ErichStyger/mcuoneclipse/Examples/MCUXpresso/FRDM-KL25Z/FRDM-KL25Z_Blinky/part-support/docs/images/FRDM-KL25Z.gif

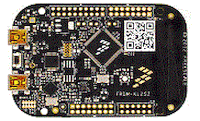
Examples/MCUXpresso/FRDM-KL25Z/FRDM-KL25Z_Blinky/part-support/docs/images/FRDM-KL25Z.gif
