ErichStyger/mcuoneclipse/Examples/MCUXpresso/FRDM-K64F/FRDM-K64F_McuOnEclipseLib/part-support/docs/images/FRDM-K64F-AGM01.gif

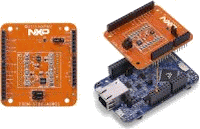
Examples/MCUXpresso/FRDM-K64F/FRDM-K64F_McuOnEclipseLib/part-support/docs/images/FRDM-K64F-AGM01.gif
