ErichStyger/mcuoneclipse/Examples/Readme.txt

This folder contains examples for different IDE's and boards.
The projects are organized by IDE's and boards.

- Eclipse: Stock Eclipse Kepler/Luna/Mars with GNU ARM Eclipse plugins
- CMSIS: CMSIS library project
- IAR: Projects with IAR Embedded Workbench
- KDS: Projects with Kinetis Design Studio V3.0.0
- CodeWarrior: contains CW for MCU 10.x projects
- Keil: Projects with Keil MDK
- RNet: Early version of a RNet (SMAC and nRF24L01+ stack), this has been moved to a Processor Expert component later
- FreeRTOS_Ports: various ports of FreeRTOS
