ErichStyger/mcuoneclipse/tinyK22/readme.txt

This folder contains information about the tinyK22 board.
This board has been developed by the Lucerne University of Applied Sciences and Arts and is use in labs and student projects.
The V1.3 version is now available from PCBWay.com

Links:
https://mcuoneclipse.com/2018/02/10/tinyk22-boards-arrived/
https://github.com/ErichStyger/mcuoneclipse/tree/master/Examples/KDS/tinyK22
https://github.com/ErichStyger/mcuoneclipse/tree/master/Examples/MCUXpresso/tinyK22
https://mcuoneclipse.com/tag/tinyk22/
https://www.pcbway.com/project/shareproject/TinyK22_V1_3.html
