ErichStyger/mcuoneclipse/tinyK20/readme.txt

readme.txt
----------
This folder contains files for the tinyK20 project.

See:
- http://mcuoneclipse.com/2015/05/17/tinyk20-open-source-arm-debuguniversal-board-first-prototypes/
- http://mcuoneclipse.com/2015/04/21/proof-of-concept-open-source-arm-swd-debug-and-general-purpose-board/
- http://mcuoneclipse.com/2015/06/17/tinyk20-new-board-with-micro-sd-card

A Kinetis Design Studio (v3.0.0) project for the tinyK20 is located on this GitHub Repository here:
\Examples\KDS\tinyK20
