ErichStyger/mcuoneclipse/Eagle/readme.txt

readme.txt
----------
This folder contains support/library files for the Eagle layout program.
Place these files inside the lbr subfolder of your Eagle installation.

Libraries:
- Freedom: FRDM-KL25Z footprint
- Bluetooth: HC-05 Bluetooth module (see http://mcuoneclipse.com/2013/02/14/bluetooth-with-the-freedom-board/)
