ErichStyger/mcuoneclipse/MCU-Link/PowerExt_lpc55s69/README.md

# LPC55S69 Power Extension Project

Project for the LPC55S69 (MCU-Link Pro) using CMake and Ninja.
The project is used in combination with a power/energy measurement board.
