ErichStyger/mcuoneclipse/conda/packages/README.md

# Package recipies using conda

This directory contains recipies to build an environement, including one with the tools provided by the NXP VS Code extension.

## Links
- https://github.com/memfault/conda-recipes/tree/master/gcc-arm-none-eabi
