ErichStyger/mcuoneclipse/MCU-Link/Pro/readme.txt

readme.txt
----------
This folder contains the design files for an enclosure for the the MCU-Link Pro.

- NXP_Logo: files for inlay, both .dxf and .svg format
- *.c2d: Carbide Create files for the CNC milling
- PMMA cover lasercut file
