ErichStyger/mcuoneclipse/Examples/VisualStudioCode/Readme.txt

This folder contains examples using Microsoft Visual Studio Code.

See following links for articles about it:
https://mcuoneclipse.com/2021/05/01/visual-studio-code-for-c-c-with-arm-cortex-m-part-1/
