ErichStyger/mcuoneclipse/tinyK22/V1.3/readme.txt

readme.txt
----------
See https://mcuoneclipse.com/2020/11/01/tinyk22-board-rev-1-3-released/

The tinyK22 board is now available from PCBWay:
https://www.pcbway.com/project/shareproject/TinyK22_V1_3.html
