ErichStyger/mcuoneclipse/LaserCutter/Inkscape/readme.txt

This folder contains drawings I use with a laser cutter.
See
- https://mcuoneclipse.com/2017/08/13/getting-control-over-a-50-watt-co2-laser-cutter-from-china/
