ErichStyger/mcuoneclipse/LaserCutter/Cohesion3D/readme.txt

This folder contains files for my laser cutter upgrade with the Cohesion3D board, see
https://mcuoneclipse.com/2018/04/15/upgrading-a-laser-cutter-with-cohesion3d-mini-and-lcd/
