ErichStyger/mcuoneclipse/Eagle/INTRO-Robot K22/readme.txt

This folder contains files for the INTRO K22 Robot, see:
- http://mcuoneclipse.com/2014/10/30/new-sumo-robot-assembled-and-looking-good/
- http://mcuoneclipse.com/2014/06/30/first-new-zumo-board-out-of-the-reflow-oven/
- http://mcuoneclipse.com/2014/07/26/zumo-robot-with-wifi-and-gps/

V2: Robot
- https://mcuoneclipse.com/2016/03/25/zumo-robot-with-magnetic-encoders/
