ErichStyger/mcuoneclipse/tinyK20/Board/readme.txt

tinyK20 project files for Eagle CAD.
Links:
- https://mcuoneclipse.com/category/boards/tinyk20/
- https://mcuoneclipse.com/2015/11/17/production-tinyk20-boards-arrived/
- https://mcuoneclipse.com/2015/06/17/tinyk20-new-board-with-micro-sd-card/
