ErichStyger/mcuoneclipse/Examples/IAR/readme.txt

This folder contains projects for IAR made with Processor Expert Driver Suite for Microcontrollers.
