ErichStyger/mcuoneclipse/Eagle/INTRO Robot QuadEncoder/readme.txt

See the following post:
http://mcuoneclipse.com/2014/03/14/new-encoder-pcbs-arrived/
http://mcuoneclipse.com/2014/03/08/processing-the-pololu-motor-shaft-encoders/
