ErichStyger/mcuoneclipse/Examples/Keil/readme.txt

This folder contains projects with Processor Expert Driver Suite and the Keil MDK tools.
