ErichStyger/mcuoneclipse/Eagle/INTRO-Robot/readme.txt

This folder contains files for the INTRO (Infotronic) Robot.
For more details, see

http://mcuoneclipse.com/2013/09/08/mini-sumo-robot-with-proximity-sensors/
http://mcuoneclipse.com/2013/01/31/the-freedom-zumo-robot/
http://mcuoneclipse.com/2013/02/08/zumo-line-following-with-frdm-kl25z/
http://mcuoneclipse.com/2013/03/28/maze-solving-frdm-kl25z-robot-goes-backward/
http://mcuoneclipse.com/2013/03/20/freedom-robot-solves-the-maze/
http://mcuoneclipse.com/2013/03/03/pololu-freedom-line-following-robot/
http://mcuoneclipse.com/2013/06/15/adding-quadrature-encoder-to-the-zumo-chassis/
