ErichStyger/mcuoneclipse/MCU-Link/Pro/rugged enclosure/readme.txt

Rugged enclosure for the NXP MCU-Link debug probe.

The FreeCAD model is a remix of https://www.printables.com/model/708803-parametric-rugged-box-freecad
