ErichStyger/mcuoneclipse/MCU-Link/McuLink Enclosure/LaserCut/readme.txt

Laser-cut enclosure for the NXP MCU-Link.
See https://mcuoneclipse.com/2023/04/11/different-laser-cut-enclosures-for-the-mcu-link/
