ErichStyger/mcuoneclipse/Examples/RaspberryPiPico/pico_Feather/README.md

# Adafruit RP2040 Feather
Project for the Raspberry Pi RP204, using the Adafruit Feather board:
- https://www.adafruit.com/product/4884
- https://learn.adafruit.com/adafruit-feather-rp2040

The project includes support for the Nordic nRF24L01+ transceiver.

## Build
Project has `Debug`, `Release` and `Test` targets, using CMake Presets. 

Configure:
```
cmake --list-presets
cmake --preset Debug
cmake --preset Release
cmake --preset Test
```

Build:
```
cmake --build --list-presets
cmake --build --preset app-debug
cmake --build --preset app-release
cmake --build --preset app-test
```

Test:
```
ctest --list-presets
ctest --test-dir build/Test -R Led_1
```

Worflow:
```
cmake --workflow --list-presets
```
