ErichStyger/mcuoneclipse/Examples/RaspberryPiPico/pico_HID/README.md

# PICO USB HID
Project for the Raspberry Pi Pico (W) with a composite USB HID device.
