ErichStyger/mcuoneclipse/Examples/MCUXpresso/LPC55S69-McuLink-Pro/readme.txt

Projects for the NXP LPC55S69 on the NXP MCU-Link Pro debug probe.
