ErichStyger/mcuoneclipse/Examples/RaspberryPiPico/pico_STHS34PF80TR/readme.txt

Project for the Raspberry Pi Pico using the STHS34PF80TR presence sensor.
