ErichStyger/mcuoneclipse/Examples/RaspberryPiPico/pico_LedCube/readme.txt

Project for the Raspberry Pi Pico (W or non-W) controlling 8x8x8(2) RGB LED Cube with PIO and DMA.

Article about this project:
https://mcuoneclipse.com/2023/04/02/rp2040-with-pio-and-dma-to-address-ws2812b-leds/

KiCAD files:
https://github.com/ErichStyger/mcuoneclipse/tree/master/KiCAD/Projects/PicoWS2812B
