ErichStyger/mcuoneclipse/Examples/MCUXpresso/FRDM-MCXN236/readme.txt

Projects with the MCUXPresso IDE for the NXP FRDM-MCXN236 board.
