ErichStyger/mcuoneclipse/Examples/MCUXpresso/FRDM-MCXA153/readme.txt

Projects with the MCUXPresso IDE for the NXP FRDM-MCXA153 board.
