ErichStyger/mcuoneclipse/Examples/MCUXpresso/FRDM-MCXN947/readme.txt

Projects with the MCUXPresso IDE for the NXP FRDM-MCXN947 board.
