ErichStyger/mcuoneclipse/Examples/MCUXpresso/i.MX RT685-EVK/readme.txt

projects for the NXP i.MX RT685-EVK board.
https://www.nxp.com/design/design-center/development-boards-and-designs/i-mx-evaluation-and-development-boards/i-mx-rt600-evaluation-kit:MIMXRT685-EVK
