ErichStyger/mcuoneclipse/Examples/RaspberryPiPico/pico_ST7735/readme.txt

Project for the Raspberry Pi Pico (W or non-W) using a display with the Sitronics ST7735 controller (SPI)

Files needed: (besides this readme.txt)

./pico_sdk_import.cmake
./CMakeLists.txt
./src folder
./McuLib folder
./.gitignore

To configure (cd to project root directory where this readme is located):
run 'cmake init.bat'
Import the project as 'existing make file project' into Eclipse: File > Import > C/C++ > Existing Code as Makefile Project (give it a name, use this folder as code location, specify GNU Autotools toolchain, then build it

or: simply run 'make' to build it
