ErichStyger/mcuoneclipse/Examples/RaspberryPiPico/pico_Raspy/readme.txt

Project for the Raspberry Pi Pico as interface to a Raspberry Pi (buttons, LEDs and UART).
It does pull-up the nav switch buttons, as the Pi is not able to enable internal pull-ups.
It offers as well a console interface to the Linux using the UART.

Files needed: (besides this readme.txt)

./pico_sdk_import.cmake
./CMakeLists.txt
./src folder
./McuLib folder
./.gitignore

To configure (cd to project root directory where this readme is located):
run 'cmake init.bat'
Import the project as 'existing make file project' into Eclipse: File > Import > C/C++ > Existing Code as Makefile Project (give it a name, use this folder as code location, specify GNU Autotools toolchain, then build it

or: simply run 'make' to build it
