ErichStyger/mcuoneclipse/KiCAD/Projects/PicoLink/readme.txt

KiCAD and enclosure design files for a RP2040 based debug probe (PicoLink).
See https://github.com/ErichStyger/mcuoneclipse/tree/master/KiCAD/Projects/PicoLink
