ErichStyger/mcuoneclipse/KiCAD/Projects/PicoWS2812B/readme.txt

Board to use the Pico (RP2040) MCU with up to 8 WS2812B LED stripes.

Links:
https://mcuoneclipse.com/2023/04/02/rp2040-with-pio-and-dma-to-address-ws2812b-leds/
https://github.com/ErichStyger/mcuoneclipse/tree/master/Examples/RaspberryPiPico/pico_LedCube
