ErichStyger/mcuoneclipse/Examples/RaspberryPiPico/pico-w-webserver/readme.txt

readme.txt
----------

Web server example for the Raspberry Pi Pico.

See:
- https://github.com/krzmaz/pico-w-webserver-example/tree/main/src
- https://krzmaz.com/2022-08-15-creating-a-web-server-on-raspberry-pi-pico-w-using-pico-sdk-and-lwip/#HTML
