ErichStyger/mcuoneclipse/Examples/MCUXpresso/FRDM-KE02Z/readme.txt

Projects with the MCUXPresso IDE for the NXP FRDM-KE02Z board.
