ErichStyger/mcuoneclipse/Examples/MCUXpresso/LPC55S16-EVK/readme.txt

Projects for the NXP LPC55S16 EVK board.
