ErichStyger/mcuoneclipse/OpenSDA/OpenSDA V2.2/mbed DAPLink v244/readme.txt

See https://mcuoneclipse.com/2017/10/29/adding-a-delay-to-the-arm-daplink-bootloader/
