ErichStyger/mcuoneclipse/Examples/MCUXpresso/Dark Theme/readme.txt

readme.txt
----------
See https://mcuoneclipse.com/2020/10/20/tweaking-mcuxpresso-ide-black-theme/
This directory contains the Eclipse preferences with tweaked black theme.

Import the file with File > Import > General > Preferences
and then restart the IDE.

Do not forget to switch the preferences to the MCUXpresso Dark Theme using
Window > Preferences > General > Appearance >
