ErichStyger/mcuoneclipse/LaserCutter/Inkscape/RaspySteampunkBox/readme.txt

Design files for a Raspberry Pi Steampunk enclosure.
Details:
https://mcuoneclipse.com/2019/06/01/steampunk-lasercut-enclosure-for-raspberry-pi/

Gears by https://www.facebook.com/profile.php?id=526508601, file 'SteampunkBox.lbrn in https://www.facebook.com/groups/635194396883619/files/
