ErichStyger/mcuoneclipse/Examples/MCUXpresso/LPC55S69-EVK/readme.txt

This folder contains projects for the NXP LPC55S69-EVK, see
https://mcuoneclipse.com/2019/04/22/first-steps-with-the-lpc55s69-evk-dual-core-arm-cortex-m33-with-trustzone/
