ErichStyger/mcuoneclipse/Examples/S32DS/S32K144_SSD1306/readme.txt

readme.txt
----------
This project demonstrates using the SSD1306 LCD with I2C.

NOTE:
The subfolder 'SDK' in the project has been removed as the NXP SDK for S32 does not grant redistribution rights.
So you have to add that folder from your SDK locally.
