ErichStyger/mcuoneclipse/Examples/MCUXpresso/tinyK22/readme.txt

Projects with the MCUXPresso IDE for the tinyK22 board which uses the same MCU as on the NXP FRDM-K22F board.
