ErichStyger/mcuoneclipse/Examples/MCUXpresso/i.MX RT1052 Embedded Artists/readme.txt

This folder contains projects with MCUXpresso IDE and for the Embedded Artists i.MX RT1052 OEM board:

http://embeddedartists.com/products/oem/imxrt1052_oem.php
