ErichStyger/mcuoneclipse/Examples/KDS/TWR-K60F120M/readme.txt

This folder contains projects for the TWR-K60F120M board
