ErichStyger/mcuoneclipse/Examples/KDS/tinyK22/readme.txt

This folder contains projects for the tinyK22 board using the NXP Kinetis Design Studio.
See
- https://mcuoneclipse.com/2018/02/10/tinyk22-boards-arrived/
- https://mcuoneclipse.com/tag/tinyk22/
