ErichStyger/mcuoneclipse/Examples/KDS/Teensy_3.5/readme.txt

This folder contains projects for the Teensy 3.5 with KDS,
see 
https://mcuoneclipse.com/2017/04/29/modifying-the-teensy-3-5-and-3-6-for-arm-swd-debugging/
