ErichStyger/mcuoneclipse/Examples/MCUXpresso/FRDM-K22F/readme.txt

Projects with the MCUXPresso IDE for the NXP FRDM-K22F board.
