ErichStyger/mcuoneclipse/Examples/MCUXpresso/FRDM-KW41Z/readme.txt

Projects with the MCUXPresso IDE for the NXP FRDM-KW41Z board.
