ErichStyger/mcuoneclipse/Examples/MCUXpresso/FRDM-KL25Z/readme.txt

Projects with the MCUXPresso IDE for the NXP FRDM-KL25Z board.
