ErichStyger/mcuoneclipse/Examples/KDS/FRDM-KL03Z/readme.txt

readme.txt
----------
This folder contains projects for the FRDM-KL03Z board and the Kinetis Design Studio (KDS).
