ErichStyger/mcuoneclipse/Examples/KDS/FRDM-KE02Z/readme.txt

readme.txt
----------
This folder contains projects for the FRDM-KE02Z board and the Kinetis Design Studio (KDS).
