ErichStyger/mcuoneclipse/Examples/MCUXpresso/FRDM-K64F/readme.txt

Projects with the MCUXPresso IDE for the NXP FRDM-K64F board.
