ErichStyger/mcuoneclipse/Examples/MCUXpresso/LPC800-DIP/readme.txt

Projects with the MCUXPresso IDE for the NXP LPC800-DIP board.
