ErichStyger/mcuoneclipse/Examples/KDS/FRDM-KL28Z/readme.txt

readme.txt
----------
This folder contains projects for the FRDM-KL28Z board and the Kinetis Design Studio (KDS).
