ErichStyger/mcuoneclipse/Examples/KDS/Kwikstik_K40/readme.txt

This folder contains projects using Kinetis Design Studio V3.2.0 for the NXP/Freescale Kwikstik board.
