ErichStyger/mcuoneclipse/Examples/CodeWarrior/MCF51JM128_BadgeBoard/readme.txt

readme.txt
----------
Projects for the MCF51JM128 Flexis Badgeboard
http://www.nxp.com/products/microcontrollers-and-processors/more-processors/coldfire-plus-coldfire-32-bit-mcus/coldfire-microcontrollers-mcus/coldfire-v1-microcontro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
