ErichStyger/mcuoneclipse/Examples/KDS/FRDM-KW40Z/readme.txt

readme.txt
----------
This folder contains projects for the FRDM-KW40Z board and the Kinetis Design Studio (KDS).
