ErichStyger/mcuoneclipse/Examples/KDS/TWR-KL43Z48M/readme.txt

readme.txt
----------
This folder contains projects for the TWR-KL43Z48M board and the Kinetis Design Studio.
