ErichStyger/mcuoneclipse/Examples/KDS/TWR-K40D100M/readme.txt

readme.txt
----------
This folder contains projects for the TWR-K40D100M board and the Kinetis Design Studio (KDS):
http://www.nxp.com/products/software-and-tools/hardware-development-tools/tower-development-boards/mcu-and-processor-modules/kinetis-modules/kinetis-k40-100-mhz-low-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
