ErichStyger/mcuoneclipse/Examples/KDS/TWR-KV58F220M/readme.txt

readme.txt
----------
This folder contains projects for the TWR-KV58F220M board and the Kinetis Design Studio.
