ErichStyger/mcuoneclipse/Examples/KDS/FRDM-KL27Z/readme.txt

readme.txt
----------
This folder contains projects for the FRDM-KL27Z board and the Kinetis Design Studio (KDS).
