ErichStyger/mcuoneclipse/Examples/KDS/FRDM-KL43Z/readme.txt

readme.txt
----------
This folder contains projects for the FRDM-KL43Z board and the Kinetis Design Studio (KDS).
