ErichStyger/mcuoneclipse/Examples/KDS/Teensy_3.1/readme.txt

readme.txt
----------
This folder contains projects for the Teensy 3.1 board and the Kinetis Design Studio (KDS).
