ErichStyger/mcuoneclipse/Examples/KDS/FRDM-KL02Z/readme.txt

readme.txt
----------
This folder contains projects for the FRDM-KL02Z board and the Kinetis Design Studio (KDS).
