ErichStyger/mcuoneclipse/Examples/KDS/TWR-K20D72M/readme.txt

readme.txt
----------
This folder contains projects for the TWR-K20D72M board and the Kinetis Design Studio (KDS).
