ErichStyger/mcuoneclipse/Examples/KDS/FRDM-K22F/readme.txt

readme.txt
----------
This folder contains projects for the FRDM-K22F board and the Kinetis Design Studio.
