ErichStyger/mcuoneclipse/Examples/Eclipse/FRDM-K64F/readme.txt

This folder contains Eclipse (Kepler) projects for the Freescale FRDM-K64F board.
