ErichStyger/mcuoneclipse/Examples/KDS/FRDM-KL46Z/readme.txt

readme.txt
----------
This folder contains projects for the FRDM-KL46Z board and the Kinetis Design Studio (KDS).
