ErichStyger/mcuoneclipse/Examples/KDS/FRDM-K20D50M/readme.txt

readme.txt
----------
This folder contains projects for the FRDM-K20D50M board and the Kinetis Design Studio.
