ErichStyger/mcuoneclipse/Examples/KDS/FRDM-KL26Z/readme.txt

readme.txt
----------
This folder contains projects for the FRDM-KL26Z board and the Kinetis Design Studio (KDS).
