ErichStyger/mcuoneclipse/Examples/CodeWarrior/FRDM-K20D50M/readme.txt

This folder contains projects for the Freescale FRDM-K20D50M board.
