ErichStyger/mcuoneclipse/Examples/CodeWarrior/FRDM-K64F/readme.txt

This folder contains CodeWarrior projects for the Freescale FRDM-K64F board.
