ErichStyger/mcuoneclipse/Examples/KDS/FRDM-KL05Z/readme.txt

readme.txt
----------
This folder contains projects for the FRDM-KL05Z board and the Kinetis Design Studio (KDS).
