ErichStyger/mcuoneclipse/Examples/KDS/FRDM-KL25Z/readme.txt

readme.txt
----------
This folder contains projects for the FRDM-KL25Z board and the Kinetis Design Studio (KDS).
