ErichStyger/mcuoneclipse/Examples/Eclipse/TWR-K64F120M/readme.txt

This folder contains projects for the TWR-K64F120M board:
http://www.freescale.com/webapp/sps/site/prod_summary.jsp?code=TWR-K64F120M&tid=m32TWR
