ErichStyger/mcuoneclipse/Examples/CodeWarrior/TWR-K21F120M/readme.txt

This folder contains projects for the TWR-K21F120M board:
http://www.freescale.com/webapp/sps/site/prod_summary.jsp?code=TWR-K21F120M&tid=m32TWR
