ErichStyger/mcuoneclipse/Examples/FRDM-KL46Z/FRDM-KL46Z_Demo/readme.txt

readme.txt
==========
Project using the devices on the FRDM-KL46Z board.

See:
http://mcuoneclipse.com/2013/08/06/a-new-freedom-board-frdm-kl46z/

Licensing:
----------
The 'LCD' subfolder has a separate license. These files are from the
http://www.freescale.com/webapp/sps/site/prod_summary.jsp?code=FRDM-KL46Z&fpsp=1&tab=Design_Tools_Tab#
KL46_SC (FRDM-KL46Z and TWR-KL46Z48M Sample Code Package) from www.freescale.com/freedom

The folder is taken from
kinetis_kl46_sc\kinetis_kl46_sc_rev2\klxx-sc-baremetal\src\projects\FRDMKL46_Demo\lcd
and slightly modified, and contains the KL46_SC license file.
