ErichStyger/mcuoneclipse/Examples/CodeWarrior/FRDM-KL26Z/Readme.txt

This folder contains projects for the FRDM-KL26Z (Freedom) board.
