ErichStyger/mcuoneclipse/Examples/CodeWarrior/FRDM-KE02Z/readme.txt

This folder contains projects for the FRDM-KE02Z board.
See
http://mcuoneclipse.com/2013/08/19/a-5v-freedom-board-frdm-ke02z/
