ErichStyger/mcuoneclipse/Examples/CodeWarrior/TWR-56F8400/readme.txt

This folder contains projects for the TWR-56F8400 board:
http://www.freescale.com/webapp/sps/site/prod_summary.jsp?code=TWR-56F8400&tid=m32TWR
