ErichStyger/mcuoneclipse/Examples/CodeWarrior/TWR-K60F120M/readme.txt

This folder contains projects for the TWR-K60F120M board:
http://www.freescale.com/webapp/sps/site/prod_summary.jsp?code=TWR-K60F120M&tid=m32TWR
