ErichStyger/mcuoneclipse/Examples/CodeWarrior/DEMO9S08LL16/readme.txt

This directory contains projects for the S08DEMOLL16 board:

https://www.freescale.com/webapp/sps/site/prod_summary.jsp?code=DEMO9S08LL16
