ErichStyger/mcuoneclipse/Examples/CodeWarrior/DEMOJM/Readme.txt

This folder contains example projects for the Freescale DEMOJM board.
The DEMOJM board can use different CPU modules, as the S08JM16, S08JM60 or MCF51JM128.
