ErichStyger/mcuoneclipse/Examples/CodeWarrior/FRDM-KL02Z/Readme.txt

This folder contains projects for the FRDM-KL02Z (Freedom) board.
