ErichStyger/mcuoneclipse/Examples/CodeWarrior/TWR-KL46Z48M/Readme.txt

This folder contains projects for the TWR-KL46Z48M board.
