ErichStyger/mcuoneclipse/Examples/CodeWarrior/TWR-CN128/Readme.txt

This folder contains projects for the TWR-CN128 (MCF51CN128) board.
