ErichStyger/mcuoneclipse/Examples/CodeWarrior/TWR-52259/Readme.txt

This folder contains projects for the TWR-MCF52259 board.
