ErichStyger/mcuoneclipse/Examples/CodeWarrior/TWR-LCD/Readme.txt

This folder contains projects for the TWR-LCD board.
