ErichStyger/mcuoneclipse/Examples/CodeWarrior/TWR-LL64/Readme.txt

This folder contains projects for the TWR-S08LL64 board.
As the TWR-S08LH64 is very similar, the projects can be used for the LH64 board as well.
