ErichStyger/mcuoneclipse/Examples/CodeWarrior/TWR-MCF51MM256/Readme.txt

This folder contains projects for the TWR-MCF51MM256 board.
