ErichStyger/mcuoneclipse/Examples/KDS/TWR-K70F120M/Readme.txt

This folder contains projects for the TWR-K70F120M board.
