ErichStyger/mcuoneclipse/Examples/CodeWarrior/FRDM-KL05Z/Readme.txt

This folder contains projects for the FRDM-KL05Z (Freedom) board.
