ErichStyger/mcuoneclipse/Examples/CodeWarrior/TRW-K60N512/Readme.txt

This folder contains projects for the TWR-K60N512 board:
http://www.freescale.com/webapp/sps/site/prod_summary.jsp?code=TWR-K60N512&tid=m32TWR
