ErichStyger/mcuoneclipse/Examples/CodeWarrior/FRDM-KL25Z/Readme.txt

This folder contains projects for the FRDM-KL25Z (Freedom) board.
