ErichStyger/mcuoneclipse/Examples/Rust/LPC55S69-EVK_Rust_Blinky/NOTES.md

# Notes about Rust for LPC55S69

## Standalone Embassy Project
Starting a new project: https://embassy.dev/book/index.html#_starting_a_new_project

## VS Code
Install extension: https://marketplace.visualstudio.com/items?itemName=rust-lang.rust-analyzer (rust-lang.rust-analyzer)
https://code.visualstudio.com/docs/languages/rust

The official VS Code extension for probe-rs:
https://github.com/probe-rs/vscode

Extension: probe-rs.probe-rs-debugger
