ErichStyger/mcuoneclipse/Examples/MCUXpresso/FRDM-K22F/FRDM-K22F_FreeRTOS/McuLib/unity/link.md

See 
https://github.com/ThrowTheSwitch/Unity/tree/master
about the Unity framework.
