ErichStyger/mcuoneclipse/tinyK22/RevA/tinyK22_Pinout.pdf

# TinyK22

## Rev A

U4: 3.3V Regulator
Mouser: 579-TC1262-3.3VDBTR

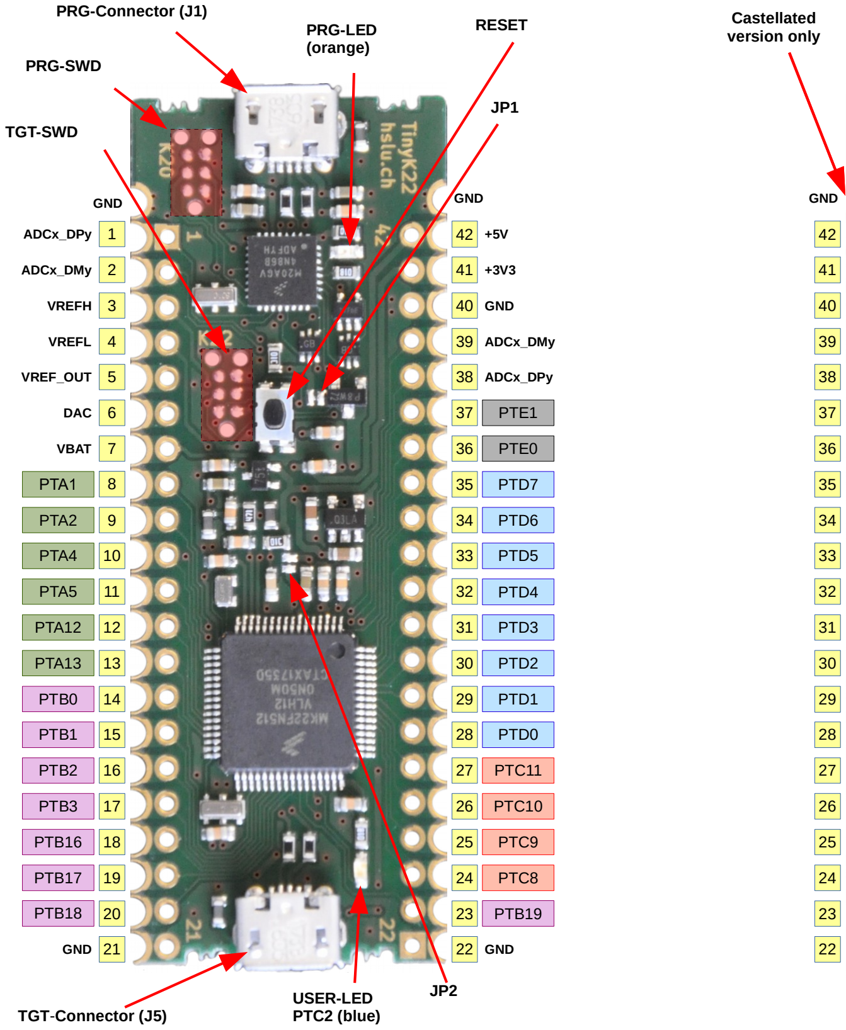
[picture p3: figure]
TGT-Connector (J5); PRG-Connector (J1); USER-LED PTC2 (blue); PRG-LED (orange); RESET; PRG-SWD; PTB16; PTB18; PTA2; PTA4; PTA12; PTA5; PTA13; PTA1; PTB0; PTB2; PTB1; PTB3; PTB17; PTB19; PTC11; PTC10; PTC8; PTC9; PTD7; PTD6; PTD5; PTD3; PTD4; PTD2; PTD1; PTD0; PTE1; PTE0; GND; VBAT; DAC; VREF_OUT; VREFL; VREFH; ADCx_DMy; ADCx_DPy; TGT-SWD; Castellated version only
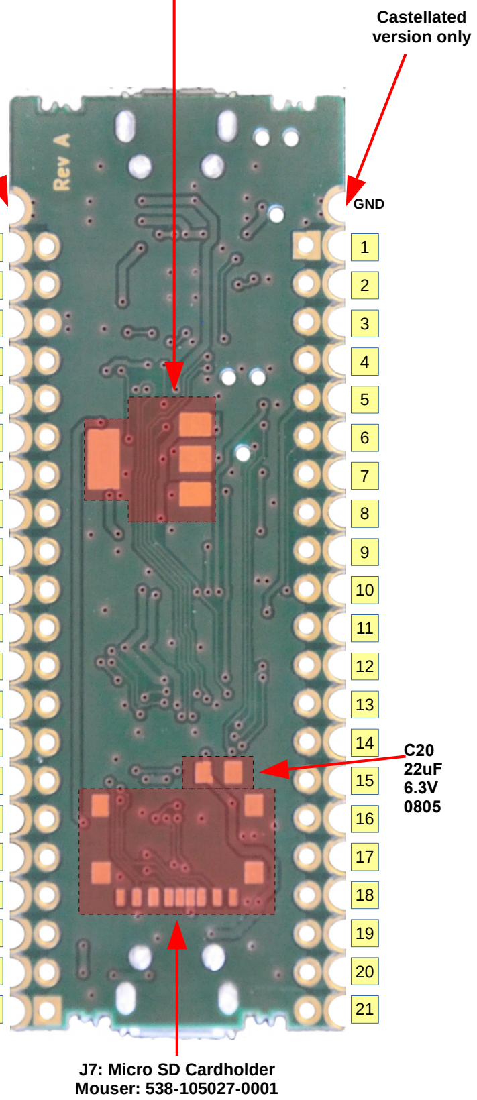
[picture p4: figure]
J7: Micro SD Cardholder Mouser: 538-105027-0001; GND; Castellated version only

UART
FTM
I2C
SPI
ADC
CMP

R:RxD, T:TxD
0..7: Channel
C:SCL, D:SDA
C:Clock, O:SOUT, I:SIN
4..13:Channel
2..3: Input | UART to Programmer:
| UART1 or LPUART0
| (PTC3 & PTC4)
PTA1 | R | 6
PTA2 | T | 7
PTA4 | | 1
PTA5 | | 2
PTA12 | | | 0
PTA13 | | | 1
PTB0 | | | 0 | C | 8 | 8

PTE0

PTE1

PTD4 | | 4
PTD5 | | 5 | C | 6b
PTD6 | R | 6 | O | 7b
PTD7 | T | 7 | I
PTC9 | 5 | | 5b | 3
PTC10 | 6 | C | 6b
PTC11 | 7 | D | 7b
PTD0 | 0

PTB19

PTB2 | | 3 | C | | 12 | 12
PTB3 | | 0 | D | | 13 | 13
PTB16 | R | | | O
PTB17 | T | | | I

PTB1

PTB18

PTD3

PTD1

PTC8

PTD2

LPUART0
UART0

UART1

UART2
FTM0

FTM1

FTM2

FTM3
I2C0

FTM0
I2C1

SPI0

SPI1

ADC0

ADC1

CMP0

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
20190107

FTM0

C

C

D

I/O
