ErichStyger/mcuoneclipse/tinyK22/V1.3/Flyer_V1_3.pdf

# TinyK22

V 1.3

Optional:

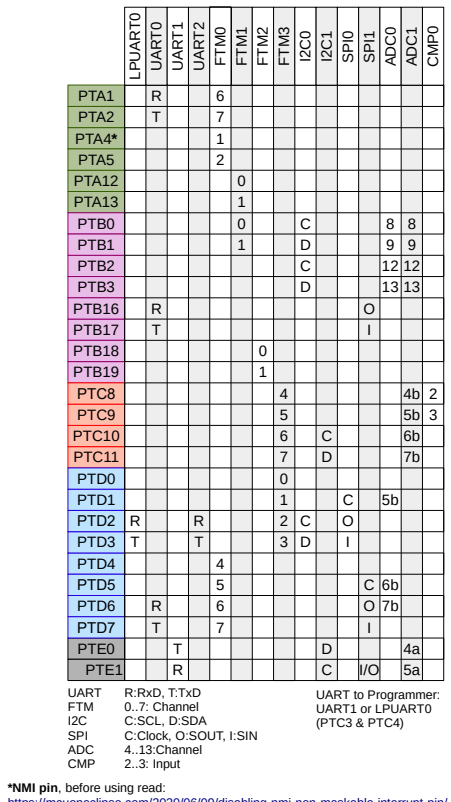
[picture p5: figure]
UART FTM I2C SPI ADC CMP; R:RxD, T:TxD 0..7: Channel C:SCL, D:SDA C:Clock, O:SOUT, I:SIN 4..13:Channel 2..3: Input; UART to Programmer: UART1 or LPUART0 (PTC3 & PTC4); PTA1; PTA2; PTA4*; PTA12; PTA5; PTA13; PTE0 PTE1; PTD4; PTC11; PTC10; PTC9; PTB19; PTB0; PTB2; PTB1; PTB3; PTB17; PTB16; PTB18; PTD6; PTD3; PTD1; PTD0; PTC8; PTD7; PTD5; PTD2; LPUART0; UART0; UART1; UART2; FTM0; FTM1; FTM2; FTM3; SPI0; SPI1; ADC0; ADC1; CMP0; *NMI pin, before using read:
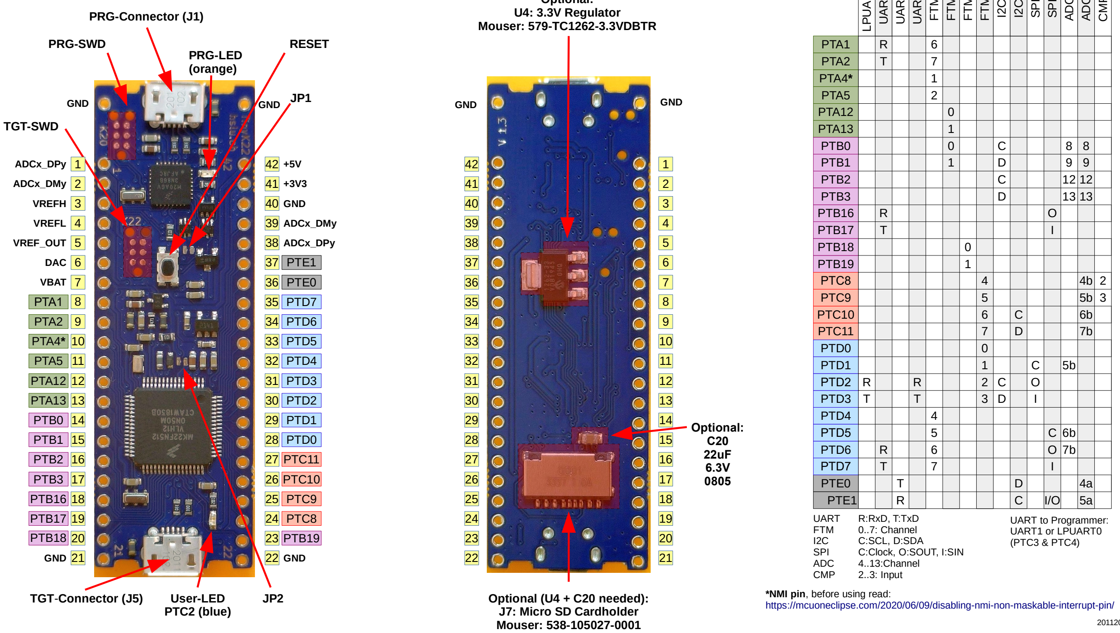
[picture p6: figure]
TGT-Connector (J5); PRG-Connector (J1); User-LED PTC2 (blue); PRG-LED (orange); RESET; PRG-SWD; PTB16; PTB18; PTA2; PTA4*; PTA12; PTA5; PTA13; PTA1; PTB0; PTB2; PTB1; PTB3; PTB17; PTB19; PTC11; PTC10; PTC8; PTC9; PTD7; PTD6; PTD5; PTD3; PTD4; PTD2; PTD1; PTD0; PTE1; PTE0; GND; VBAT; DAC; VREF_OUT; VREFL; VREFH; ADCx_DMy; ADCx_DPy; TGT-SWD; Optional: C20 22uF 6.3V 0805; Optional (U4 + C20 needed): J7: Micro SD Cardholder Mouser: 538-105027-0001; U4: 3.3V Regulator Mouser: 579-TC1262-3.3VDBTR; https://mcuoneclipse.com/2020/06/09/disabling-nmi-non-maskable-interrupt-pin/

20112020

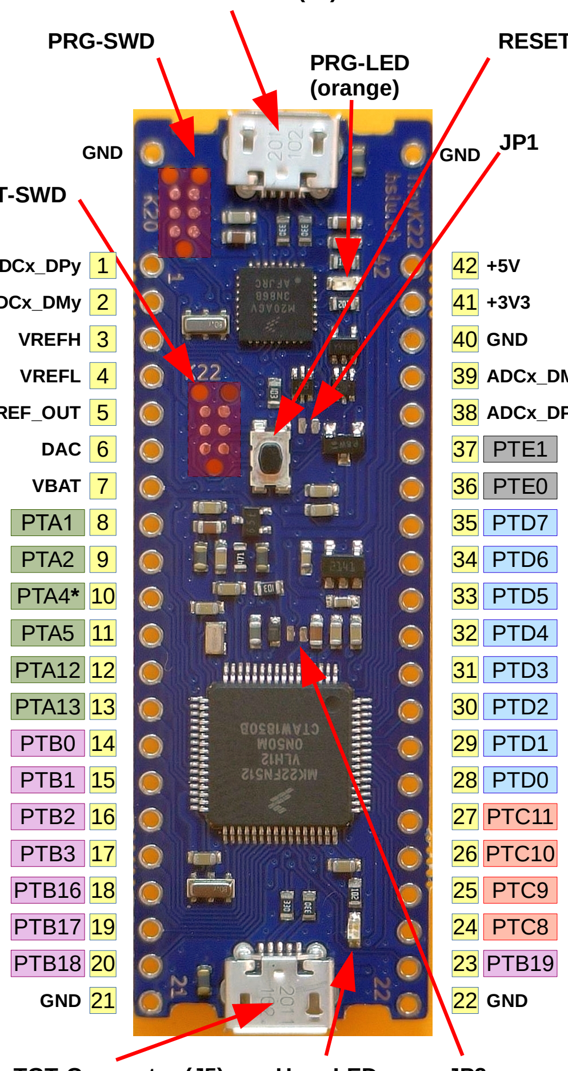
[picture p7: figure]

# TinyK22

V 1.3

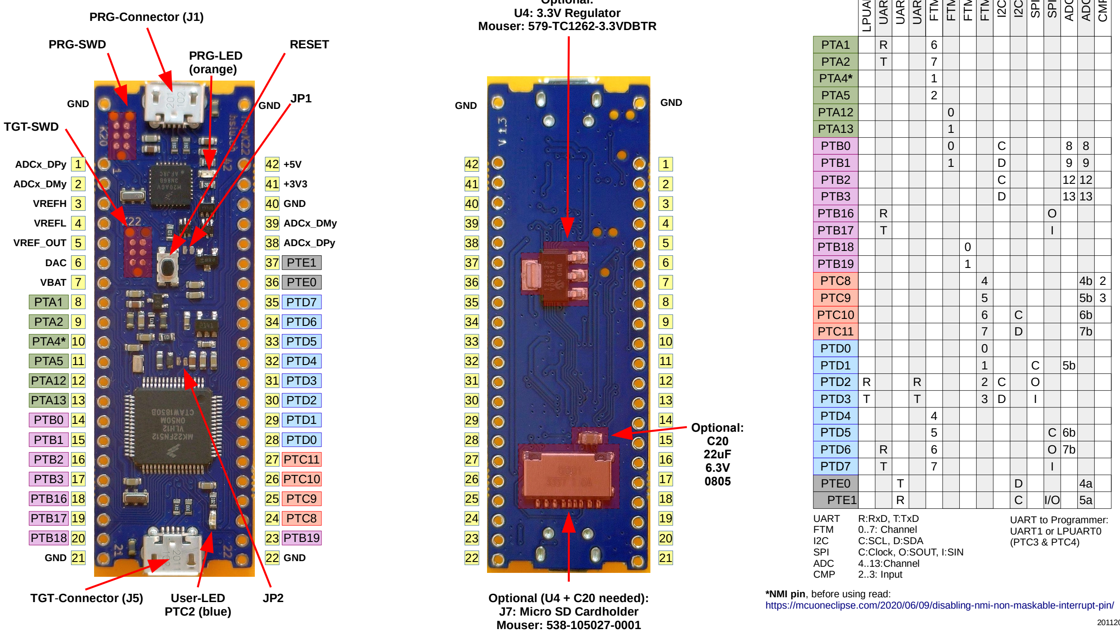
[picture p8: figure]
TGT-Connector (J5); PRG-Connector (J1); User-LED PTC2 (blue); PRG-LED (orange); RESET; PRG-SWD; PTB16; PTB18; PTA2; PTA4*; PTA12; PTA5; PTA13; PTA1; PTB0; PTB2; PTB1; PTB3; PTB17; PTB19; PTC11; PTC10; PTC8; PTC9; PTD7; PTD6; PTD5; PTD3; PTD4; PTD2; PTD1; PTD0; PTE1; PTE0; GND; VBAT; DAC; VREF_OUT; VREFL; VREFH; ADCx_DMy; ADCx_DPy; TGT-SWD; Optional: C20 22uF 6.3V 0805; Optional (U4 + C20 needed): J7: Micro SD Cardholder Mouser: 538-105027-0001; U4: 3.3V Regulator Mouser: 579-TC1262-3.3VDBTR; *NMI pin, before using read: https://mcuoneclipse.com/2020/06/09/disabling-nmi-non-maskable-interrupt-pin/
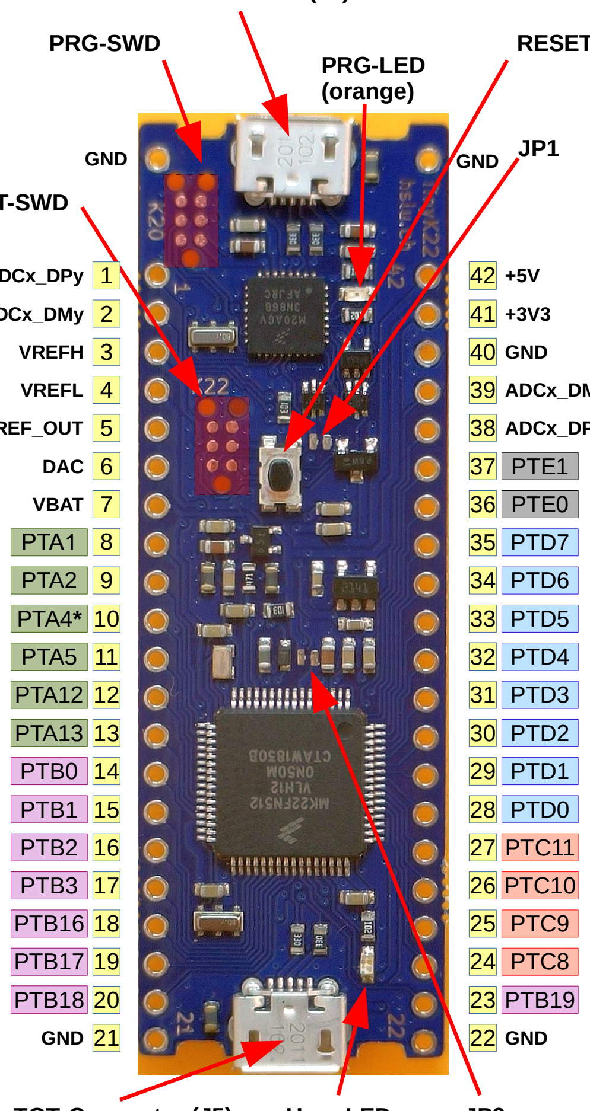
[picture p9: figure]

Optional:

UART
FTM
I2C
SPI
ADC
CMP

R:RxD, T:TxD
0..7: Channel
C:SCL, D:SDA
C:Clock, O:SOUT, I:SIN
4..13:Channel
2..3: Input

UART to Programmer:
UART1 or LPUART0
(PTC3 & PTC4)
PTA1 | R | 6
PTA2 | T | 7
PTA4* | | 1
PTA5 | | 2
PTA12 | | | 0
PTA13 | | | 1
PTB0 | | | 0 | C | 8 | 8

PTE0
PTE1

PTD4

PTC9 | 5 | | 5b | 3
PTC10 | 6 | C | 6b
PTC11 | 7 | D | 7b
PTD0 | 0

PTB19

PTB2

PTB1

PTB3 | | D | | 13 | 13
PTB16 | R | | O
PTB17 | T | | I
PTB18

PTD3

PTD1

PTC8

PTD5 | | 5 | C | 6b
PTD6 | R | 6 | O | 7b
PTD7 | T | 7 | I

PTD2

LPUART0
UART0

UART1

UART2
FTM0
FTM1

FTM2

FTM3
I2C0

FTM0
I2C1

SPI0

SPI1

ADC0

ADC1

CMP0

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
20112020

FTM0

C
D

I/O

12

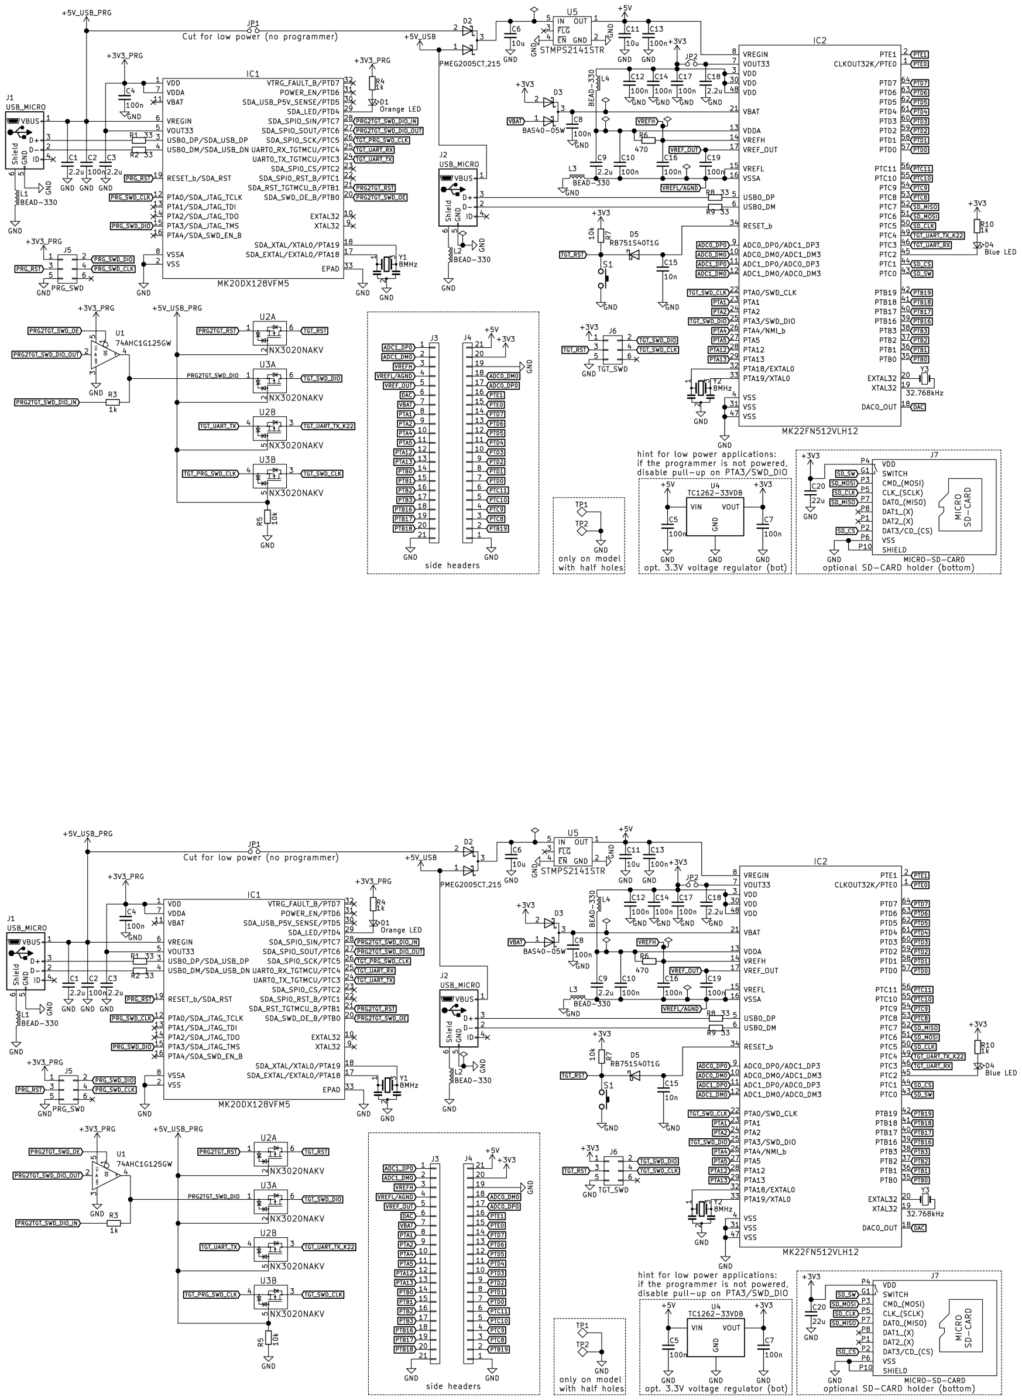
[picture p10: page 2]
