ErichStyger/mcuoneclipse/tinyK20/Board/tinyK20Flyer.pdf

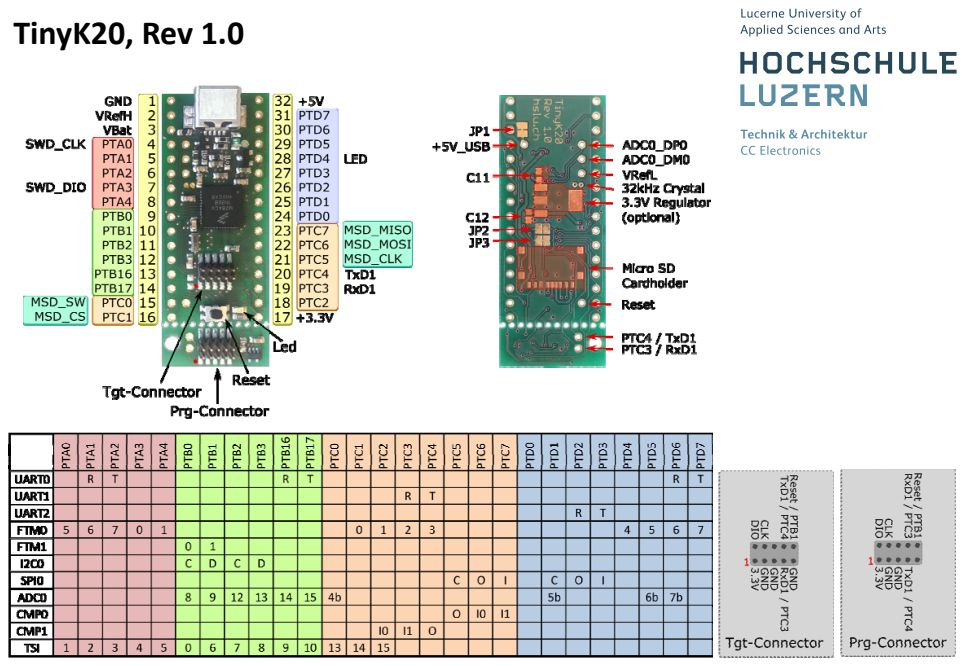
[picture p11: page 1]
TinyK20, Rev 1.0

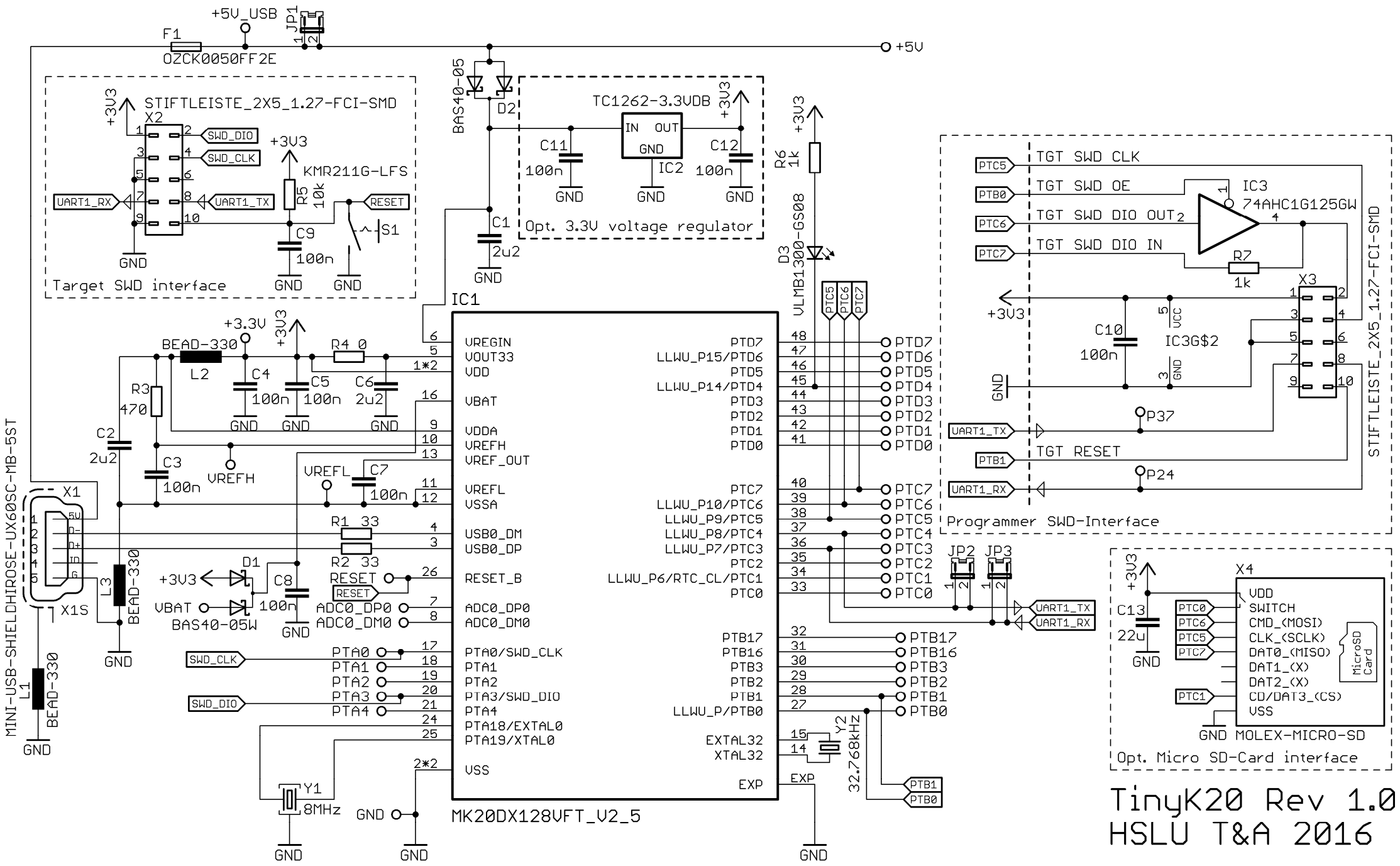
[picture p12: page 2]
