ErichStyger/mcuoneclipse/tinyK22/V1.3/Fab/TinyK22_FAB_BOT.pdf

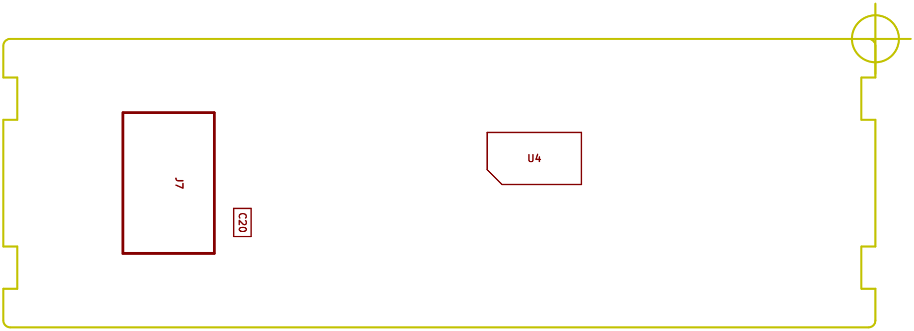
[picture p13: figure]
