ErichStyger/mcuoneclipse/Examples/MCUXpresso/i.MX RT1064_EVK/MIMXRT1064_SSD1963/SSD1963.pdf

## Teilnehmendenliste mit Foto und Adresse

Leitung | Erich Styger
Datum | 18.02.2019 - 01.06.2019

## Intern/Vertraulich - Keine Abgabe an Drittpersonen erlaubt

Dauer | Donnerstag, 08:30 - 12:00 + Freitag, 08:30 - 12:00
Anzahl Anmeldungen 10
Anlass | Advanced Programming FS 1901 (TA.BA_APROG.F1901)
Name / ID | Foto | Adresse / Ort | E-Mail / Telefon | Weitere Informationen

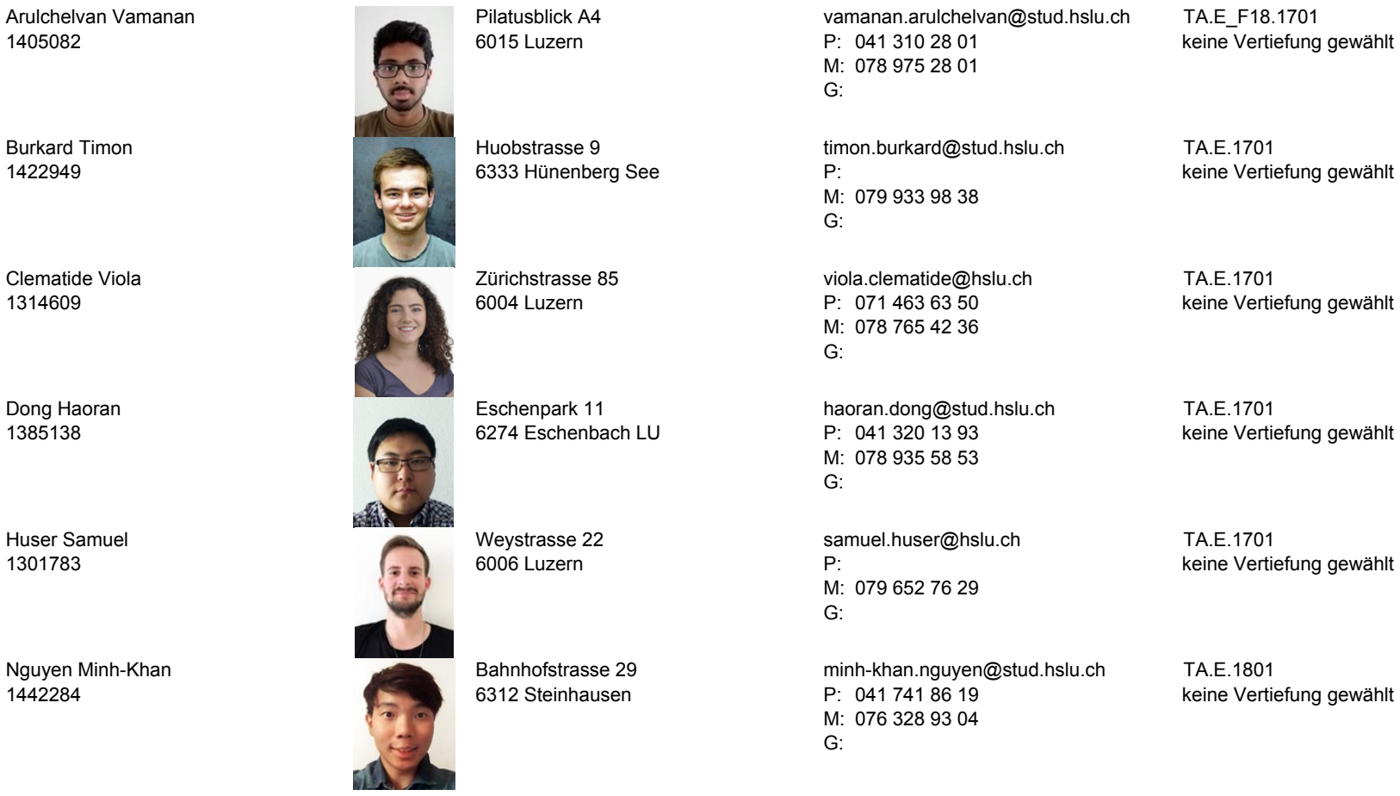
[picture p14: figure]
Pilatusblick A4 6015 Luzern; Arulchelvan Vamanan; vamanan.arulchelvan@stud.hslu.ch; keine Vertiefung gewählt; Huobstrasse 9 6333 Hünenberg See; Burkard Timon; timon.burkard@stud.hslu.ch; Zürichstrasse 85 6004 Luzern; Clematide Viola; viola.clematide@hslu.ch; Eschenpark 11 6274 Eschenbach LU; Dong Haoran; haoran.dong@stud.hslu.ch; Weystrasse 22 6006 Luzern; Huser Samuel; samuel.huser@hslu.ch; Bahnhofstrasse 29 6312 Steinhausen; Nguyen Minh-Khan; minh-khan.nguyen@stud.hslu.ch

28.01.2019 13:35:51 | 1/2

Stiegenackerstrasse 9
5634 Merenschwand
Schär Matthias | matthias.schaer@stud.hslu.ch | TA.E.1701
| P: M: G: 056 664 73 63 079 890 94 37
1412842 | keine Vertiefung gewählt

Hertiring 14
6440 Brunnen
Tschümperlin Mike | mike.tschuemperlin@stud.hslu.ch | TA.E_F18.1701
| P: M: G: 041 822 04 85 076 816 75 65
1410594 | keine Vertiefung gewählt

Apfelbaumstrasse 39
8050 Zürich
Urhan Özcan | oezcan.urhan@stud.hslu.ch | TA.E_F18.1701
| P: M: G: 076 322 10 71
1419855 | keine Vertiefung gewählt

Krauerhusstrasse 10 b
6206 Neuenkirch
Wey Ramon | ramon.wey@stud.hslu.ch | TA.E.1701
| P: M: G: 041 467 31 14 079 452 86 27
1371753 | keine Vertiefung gewählt

## Teilnehmendenliste mit Foto und Adresse

Leitung | Erich Styger
Datum | 18.02.2019 - 01.06.2019

## Intern/Vertraulich - Keine Abgabe an Drittpersonen erlaubt

Dauer | Donnerstag, 08:30 - 12:00 + Freitag, 08:30 - 12:00
Anzahl Anmeldungen 10
Anlass | Advanced Programming FS 1901 (TA.BA_APROG.F1901)
Name / ID | Foto | Adresse / Ort | E-Mail / Telefon | Weitere Informationen
28.01.2019 13:35:51 | 2/2
