ErichStyger/mcuoneclipse/Altium/FRDM-KL25_Footprint.png

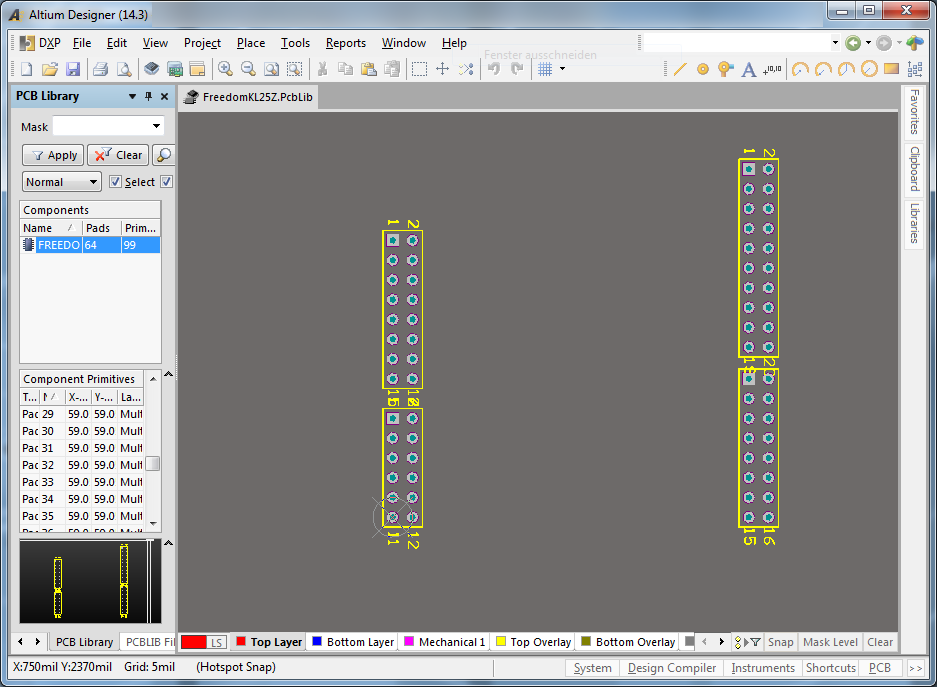
Altium/FRDM-KL25_Footprint.png
