ErichStyger/mcuoneclipse/Altium/FRDM-KL25_Schema.png

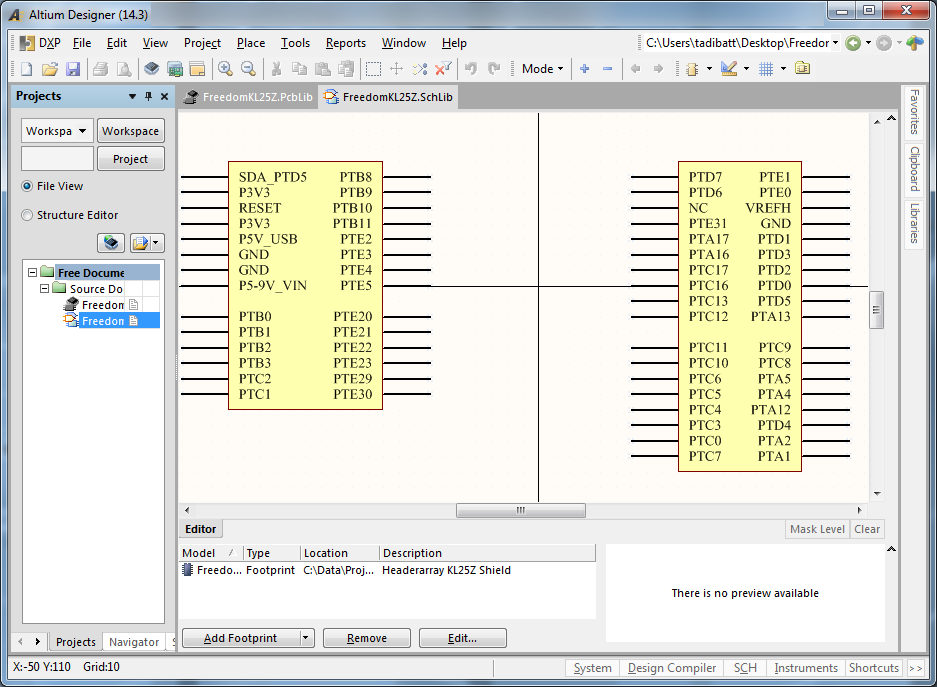
Altium/FRDM-KL25_Schema.png
