ErichStyger/mcuoneclipse/Examples/MCUXpresso/FRDM-K22F/FRDM-K22F_FatFS_SD_Card/part-support/docs/images/FRDM-K22F-AGMP03.gif

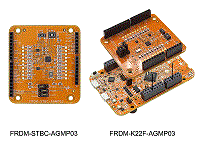
Examples/MCUXpresso/FRDM-K22F/FRDM-K22F_FatFS_SD_Card/part-support/docs/images/FRDM-K22F-AGMP03.gif
