ErichStyger/mcuoneclipse/Examples/MCUXpresso/i.MX RT1052 Seeed Arch Mix/MIMXRT1052_Seeed_ArchMix_BlinkyFLASH/part-support/docs/images/EVKB-IMXRT1050-OM13790HOST.gif

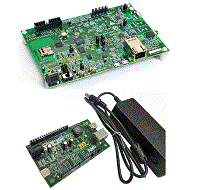
Examples/MCUXpresso/i.MX RT1052 Seeed Arch Mix/MIMXRT1052_Seeed_ArchMix_BlinkyFLASH/part-support/docs/images/EVKB-IMXRT1050-OM13790HOST.gif
