ErichStyger/mcuoneclipse/Examples/MCUXpresso/i.MX RT1064_EVK/MIMXRT1064_Blinky_FLASH/part-support/docs/images/EVK-MIMXRT1064-OM13588.gif

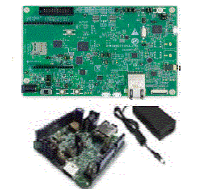
Examples/MCUXpresso/i.MX RT1064_EVK/MIMXRT1064_Blinky_FLASH/part-support/docs/images/EVK-MIMXRT1064-OM13588.gif
