ErichStyger/mcuoneclipse/Examples/MCUXpresso/i.MX RT1064_EVK/MIMXRT1064_ThreadX_Demo/part-support/MIR/marketing_data/1.0/boards/images/5-EVK-MIMXRT1064.gif

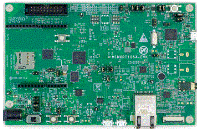
Examples/MCUXpresso/i.MX RT1064_EVK/MIMXRT1064_ThreadX_Demo/part-support/MIR/marketing_data/1.0/boards/images/5-EVK-MIMXRT1064.gif
