ErichStyger/mcuoneclipse/Examples/MCUXpresso/i.MX RT1064_EVK/MIMXRT1064_ThreadX_Demo/part-support/MIR/marketing_data/1.0/kits/images/169-EVK-MIMXRT1064-AGM01.gif

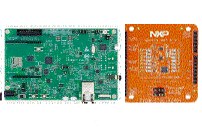
Examples/MCUXpresso/i.MX RT1064_EVK/MIMXRT1064_ThreadX_Demo/part-support/MIR/marketing_data/1.0/kits/images/169-EVK-MIMXRT1064-AGM01.gif
