ErichStyger/mcuoneclipse/Examples/MCUXpresso/K22FX512/K22FX512xxx12_McuLib/part-support/docs/images/TWR-K21F120M.gif

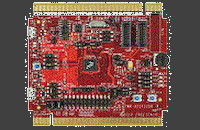
Examples/MCUXpresso/K22FX512/K22FX512xxx12_McuLib/part-support/docs/images/TWR-K21F120M.gif
