ErichStyger/mcuoneclipse/Examples/MCUXpresso/LPC55S16-EVK/LPC55S16_Semihosting/part-support/boards/lpcxpresso55s16_agm01/lpcxpresso55s16_agm01.png

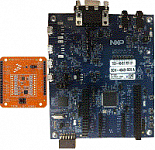
Examples/MCUXpresso/LPC55S16-EVK/LPC55S16_Semihosting/part-support/boards/lpcxpresso55s16_agm01/lpcxpresso55s16_agm01.png
