ErichStyger/mcuoneclipse/Examples/MCUXpresso/LPC55S69-EVK/LPC55S69_AdafruitLCD/Datasheets/adafruit_products_tftshieldv2.png

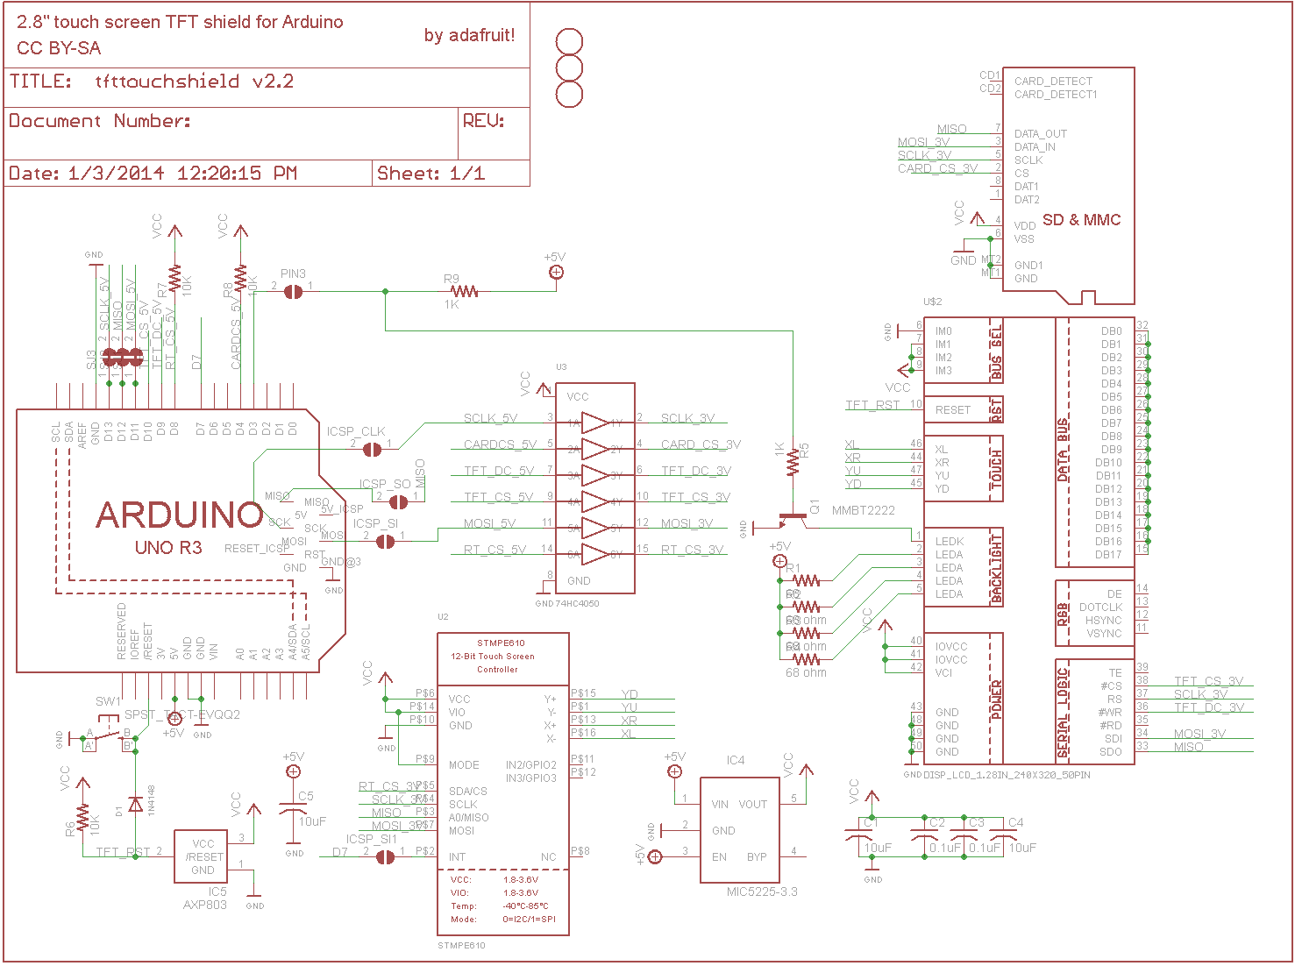
Examples/MCUXpresso/LPC55S69-EVK/LPC55S69_AdafruitLCD/Datasheets/adafruit_products_tftshieldv2.png
