ErichStyger/mcuoneclipse/Examples/MCUXpresso/LPC55S69-EVK/LPC55S69_AdafruitLCD/part-support/docs/images/LPCXpresso55S69.gif

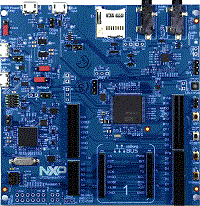
Examples/MCUXpresso/LPC55S69-EVK/LPC55S69_AdafruitLCD/part-support/docs/images/LPCXpresso55S69.gif
