ErichStyger/mcuoneclipse/Examples/MCUXpresso/LPC55S69-EVK/LPC55S69_McuLib_Blinky/part-support/boards/lpcxpresso55s69/lpcxpresso55s69.png

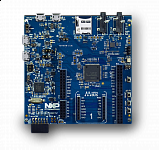
Examples/MCUXpresso/LPC55S69-EVK/LPC55S69_McuLib_Blinky/part-support/boards/lpcxpresso55s69/lpcxpresso55s69.png
