ErichStyger/mcuoneclipse/Examples/MCUXpresso/LPC55S69-EVK/LPC55S69_McuLib_Blinky/part-support/boards/lpcxpresso55s69_agm01/lpcxpresso55s69_agm01.png

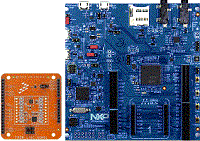
Examples/MCUXpresso/LPC55S69-EVK/LPC55S69_McuLib_Blinky/part-support/boards/lpcxpresso55s69_agm01/lpcxpresso55s69_agm01.png
