ErichStyger/mcuoneclipse/Examples/MCUXpresso/LPC845-BRK/LPC845-WorldClock/KiCad/WorldClock_V1.0/StepperClock_Bottom.png

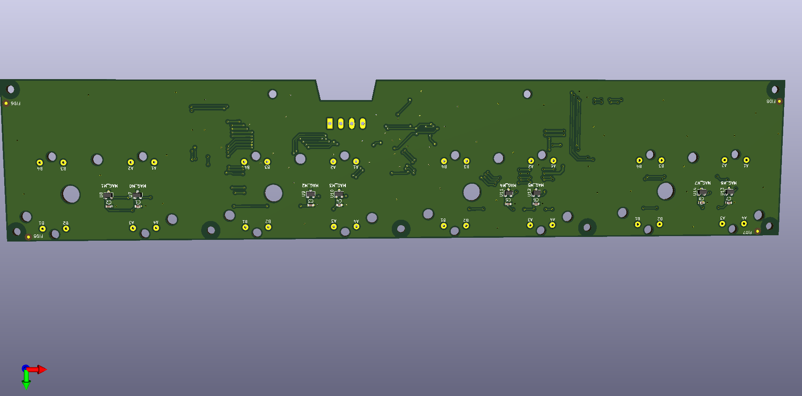
Examples/MCUXpresso/LPC845-BRK/LPC845-WorldClock/KiCad/WorldClock_V1.0/StepperClock_Bottom.png
