ErichStyger/mcuoneclipse/Examples/MCUXpresso/tinyK22/tinyK22_HanoverFlipDot/part-support/docs/images/TWR-K22F120M.gif

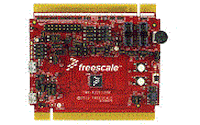
Examples/MCUXpresso/tinyK22/tinyK22_HanoverFlipDot/part-support/docs/images/TWR-K22F120M.gif
