ErichStyger/mcuoneclipse/tinyK22/V1.3/PCBWay Board.PNG

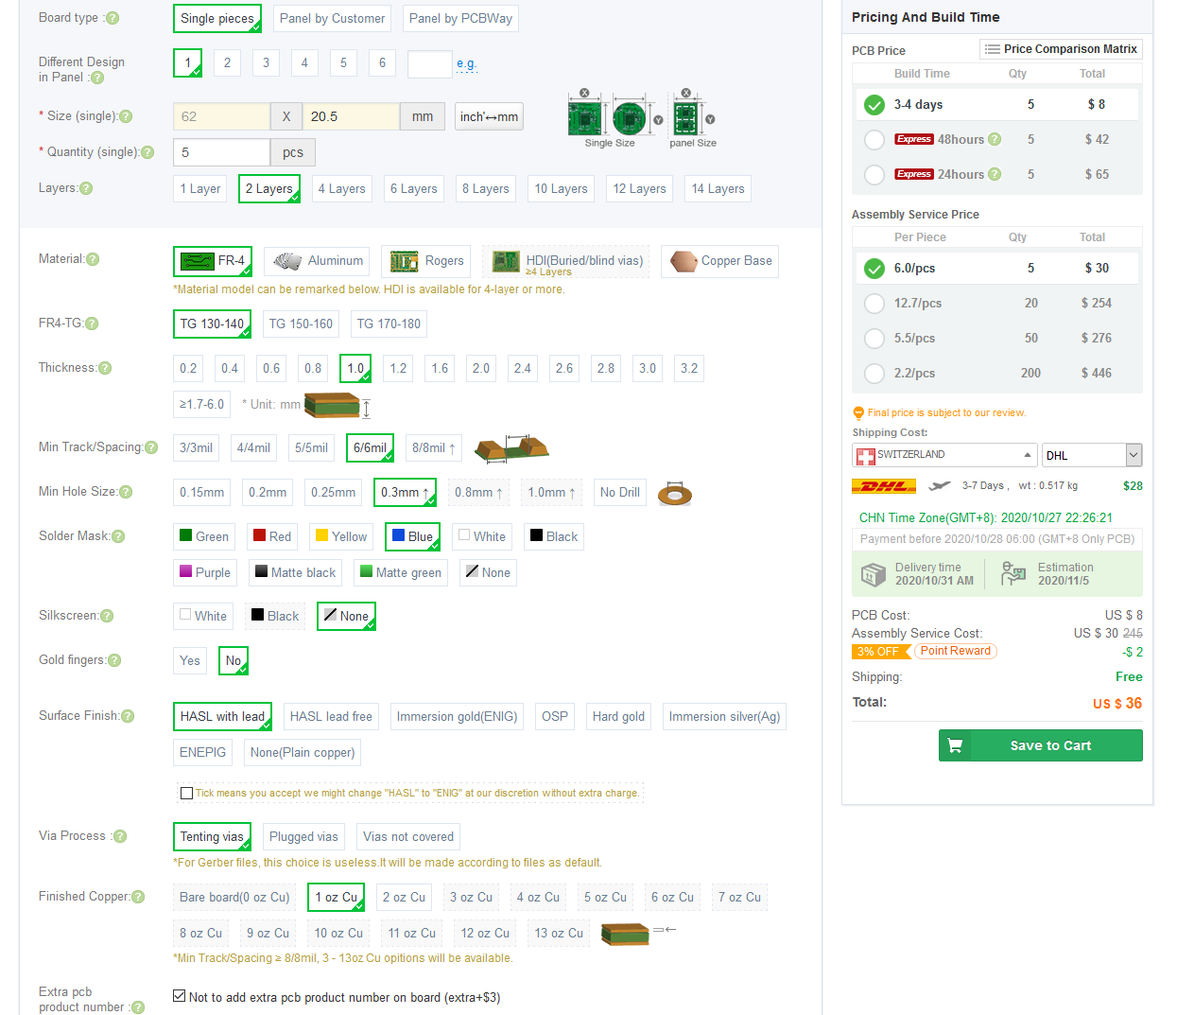
tinyK22/V1.3/PCBWay Board.PNG
