ErichStyger/mcuoneclipse/Examples/CodeWarrior/FRDM-KL25Z/FRDM-KL25Z_RNet_Component/readme.txt

readme.txt
----------
This is a demo program on the FRDM-KL25Z with the RNet stack using the nRF24L01+ transceiver.
It implements a shell with stdio redirection over the air.

See:
http://mcuoneclipse.com/2014/03/23/rnet-stack-as-component-nrf24l01-with-software-spi/
