ErichStyger/mcuoneclipse/tinyK20/Board/Material.txt

For BOM (Bill-Of-Material), see tinyK20_BOM.txt.
The SD card socket is the same as on the FRDM-K22F board (see http://mcuoneclipse.com/2015/10/07/added-micro-sd-card-socket-to-frdm-k22f/).
