ErichStyger/mcuoneclipse/KiCAD/Projects/PicoLink/V0.1/bom/BOM.xlsx

Item | Qty | Reference(s) | Value | LibPart | Footprint | Datasheet | MFR | MFR# | digikey# | mouser# | Price 1 (CHF) | Price Total
1 | 2 | C2, C9 | 2u2 | Device:C_Small | Capacitor_SMD:C_0603_1608Metric | ~ | Yageo | CC0402MRX5R6BB225 |  | 603-CC402MRX5R6BB225 | 0.02 | 0.04
2 | 10 | C3, C4, C5, C6, C7, C8, C10, C11, C12, C13 | 0.1u | Device:C_Small | Capacitor_SMD:C_0603_1608Metric | ~ | Yageo | CC0603KRX7R8BB104 |  | 603-CC603KRX7R8BB104 | 0.013 | 0.13
3 | 2 | C14, C15 | 22u | Device:C_Small | McuOnEclipse:C_0805 | ~ | Samsung | CC0603KRX7R8BB104 |  | 603-CC603KRX7R8BB104 | 0.013 | 0.026
4 | 1 | D1 | red | Device:LED_Small | McuOnEclipse:LED_0603 | ~ | Vishay Semiconductors | VLMS1300-GS08 |  | 78-VLMS1300-GS08 | 0.096 | 0.096
5 | 1 | D5 | green | Device:LED_Small | McuOnEclipse:LED_0603 | ~ | Vishay Semiconductors | VLMTG1300-GS08 |  | 78-VLMTG1300-GS08 | 0.191 | 0.191
6 | 3 | H4, H5, H6 | MountingHole | Mechanical:MountingHole | MountingHole:MountingHole_2.7mm_M2.5 | ~ |  |  |  |  |  | 0
7 | 1 | J1 | USB_C_Receptacle_GCT_USB4110-GF-A | McuOnEclipse:USB_C_Receptacle_GCT_USB4110-GF-A | McuOnEclipse:USB_C_Receptacle_GCT_USB4110-GF-A | ${KICAD_USER_DATASHEET_DIR}\connector\USB-C-Buchse - GCT USB4110.pdf | GCT | USB4110-GF-A |  | 640-USB4110-GF-A | 0.86 | 0.86
8 | 2 | J5, J6 | Conn_01x03 | Connector_Generic:Conn_01x03 | Connector_PinHeader_2.54mm:PinHeader_1x03_P2.54mm_Vertical | ~ |  |  |  | 571-3-826629-6 | 0.235 | 0.47
9 | 2 | R2, R5 | 5k1 | Device:R_Small | Resistor_SMD:R_0603_1608Metric | ~ | Yageo | RC0603JR-075K1L |  | 603-RC0603JR-075K1L | 0.008 | 0.016
10 | 2 | R3, R4 | 27 | Device:R_Small | Resistor_SMD:R_0603_1608Metric | ~ | Yageo | RC0603JR-0727RL |  | 603-RC0603JR-0727RL | 0.006 | 0.012
11 | 3 | R7, R8, R18 | 2k2 | Device:R_Small | Resistor_SMD:R_0603_1608Metric | ~ | Yageo | RC0603JR-072K2L |  | 603-RC0603JR-072K2L | 0.006 | 0.018
12 | 5 | R9, R10, R11, R15, R16 | 100 | Device:R_Small | Resistor_SMD:R_0603_1608Metric | ~ | Yageo | RC0075JR-07100RL |  | 603-RC0075JR-07100RL | 0.006 | 0.03
13 | 1 | RP2040 | RP2040 | McuOnEclipse:RP2040 | McuOnEclipse:QFN-56-1EP_7x7mm_P0.4mm_EP3.2x3.2mm | ${KICAD_USER_DATASHEET_DIR}\ic\RP2040.pdf | Raspberry Pi | RPI Chip RP2040-7-500 |  | 358-RP2040CHIP-7-500 | 0.931 | 0.931
14 | 1 | SW1 | 434123025826_BTN | Switch:SW_MEC_5E | McuOnEclipse:434123025826_BTN | http://www.apem.com/int/index.php?controller=attachment&id_attachment=1371 | Würth Elektronik | 434123025826 | 732-13662-1-ND |  | 0.45 | 0.45
15 | 1 | U1 | W25Q16JV | McuOnEclipse:W25Q16JV | McuOnEclipse:USON_2x3x0.6mm | ${KICAD_USER_DATASHEET_DIR}/ic/Flash SPI - W25Q16JV.pdf | Winbond | 434123025826 |  | 454-W25Q16JVUXIQTR | 0.439 | 0.439
16 | 1 | U3 | SWD_JTAG_10pin | McuOnEclipse:SWD_JTAG_10pin | McuOnEclipse:SWD_Pin_Header_Straight_2x05_Pitch1.27mm_SMD |  | Amphenol FCI | 20021121-00010C4LF |  | 649-202112100010C4LF | 0.694 | 0.694
17 | 1 | U5 | AP2112K-3.3 | Regulator_Linear:AP2112K-3.3 | McuOnEclipse:IC-SOT25 | https://www.diodes.com/assets/Datasheets/AP2112.pdf | Diodes Incorporated | AP2112K-3.3TRG1 |  | 621-AP2112K-3.3TRG1 | 0.173 | 0.173
18 | 1 | Y1 | CSTNE12M0GH5L000R0 | McuOnEclipse:CSTNE12M0GH5L000R0 | McuOnEclipse:Resonator_SMD_Murata_CSTxExxV-3Pin_3.0x1.1mm | ${KICAD_USER_DATASHEET_DIR}\discrete\Resonator - CSTNE12M0GH5L000R0.pdf | muRata | CSTNE12M0GH5L000R0 |  | 81-CSTNE12M0GH5L000R | 0.201 | 0.201
