ErichStyger/mcuoneclipse/Examples/MCUXpresso/LPC845-BRK/LPC845-BRK_StepperClock/3D/StepperClock BOM.xlsx

BOM (Bill of Material) for Stepper Clock with LPC845
Item | Amount | Costs ($) | Notes | Link
LPC845-BRK | 1 | 5.00 |  | https://www.mouser.ch/ProductDetail/NXP-Semiconductors/LPC845-BRK
RTC DS3231 breakout | 1 | 1.10 |  | https://www.aliexpress.com/item/2037934408.html
ULN2003 + 28BYJ-48 5V | 2 | 3.75 | 5 for $9.40 | https://www.aliexpress.com/item/32869969097.html
Bearings 10x15x4 | 2 | 0.60 | 10 for $2.85 | https://www.aliexpress.com/item/32852057465.html
Neodynium Magnets 5x2 mm | 2 | 0.05 | 100 for $4.27 | https://www.aliexpress.com/item/32867770710.html
Diodes Incorporated AH3572 | 2 | 0.70 | 10 for $3.50 | https://www.mouser.ch/ProductDetail/Diodes-Incorporated/AH3572-P-B
Duont Wires (female-female), 20 cm | 1 | 0.90 | 120pc 20 cm or any bulk offer | https://www.aliexpress.com/item/32990585262.html
Lasercutter with Plywood 4mm or PMMA | 1 | 0.50 | Plywood sheet A3
3D Printer with PLA (white or any other color) | 1 | 0.20 | 1 kg PLA: around $20
Wood screws 2x10mm | 8 | 0.05 | Used for distance holders
M3 Nuts and Bolts (3 mmx10mm) | 12 | 1.00 | different style or size possible
Duont Wires (female-female), 20 cm | 16 | 1.00 | 20pin x 20 cm | https://www.aliexpress.com/item/32987024879.html
Total amount |  | 14.85
