ErichStyger/mcuoneclipse/Examples/MCUXpresso/LPC845-BRK/LPC845-WorldClock/KiCad/WorldClock_V1.0/BOM_PCBWay.xlsx

Sheet: Sheet1
 |  |  | StepperClock V1.0 BOM (Bill of Materials) for https://www.pcbway.com/project/shareproject/_Meta_Clock__Board_V1_0.html
Item # | *Ref Des | *Qty | Manufacturer | *Mfg Part # | Description / Value | *Package | Type | Your Instructions / Notes | Source
1 | C12, C15 | 2 | Panasonic | EEE-1CA220SR | 22uF/16V Electrolyt | 5x5.5x5.4mm | SMD |  | Mouser: 667-EEE-1CA220SR
2 | C1, C2, C3, C4, C5, C6, C7, C8, C10, C11, C13, C14, C16, C20 | 14 | ATC | 0603X7R104JT1AT | 100nF Ceramic, 25V | 0603 | SMD | Can be any ceramic 25V | Mouser: 581-0603X7R104JT1AT
3 | C17, C19 | 2 | Kemet | C0603C105K4PAC7411 | 1uF Ceramic, 16V | 0603 | SMD | Can be any ceramic 25V | Mouser: 80-C0603C105K4PLR
4 | C21 | 1 | Kemet | C0603X103J4HACTU | 10nF Ceramic, 16V | 0603 | SMD | Can be any ceramic 25V | Mouser: 80-C0603X103J4HACTU
5 | C18 | 1 | AVX | F9H1C106KAA | 10uF/16V Tantalum | 1206 | SMD | Can be any Tantalum >12V | Mouser: 581-F9H1C106KAA
6 | R1, R3, R4, R5 | 4 | Yageo | RT0603WRE0710KL | 10k Ohm 0.5% | 0603 | SMD | Can be any generic resistor 0.5% | Mouser: 603-RT0603WRE0710KL
7 | R2 | 1 | Yageo | RT0603DRE07120RL | 120 Ohm 0.5% | 0603 | SMD | Can be any generic resistor 0.5% | Mouser: 603-RT0603DRE07120RL
8 | R6 | 1 | Yageo | RT0603FRE072K2L | 2.2k Ohm 0.5% | 0603 | SMD | Can be any generic resistor 0.5% | Mouser: 603-RT0603FRE072K2L
9 | D1 | 1 | Vishay Semiconductors | VLMB1300-GS08 | Blue LED | 0603 | SMD |  | Mouser: 78-VLMB1300-GS08
10 | U18 | 1 | NXP Semiconductors | LPC845M301JBD48E | LPC845M301JBD48E | LPQF-48 | SMD |  | Mouser: 771-LPC845M301JBD48E
11 | U15 | 1 | PhoenixContact | 1803293 | 4pole Pin Header 3.81 mm 90 degree | THT | thru-hole | Do not populate (DNP) | Distrelec: 148-41-252
12 | U19 | 1 | Amphenol FCI | 20021121-00010C4LF | 2x5 1.27mm pin header (SWD Debug) | 1.27mmx1.27mm | SMD |  | Mouser: 649-202112100010C4LF
13 | U16 | 1 | Texas Instruments | SN65HVD72DR | SN65HVD72 |  | SMD |  | Mouser: 595-SN65HVD72DR
14 | U5, U6 | 2 | Switec | X12.017 | M-S Quad Driver X12.017 | DIP-28 | SMD |  | Chip-IC Store: https://www.aliexpress.com/item/32596665175.html?spm=a2g0s.9042311.0.0.22e44c4d84lpPX
15 | U17 | 1 | Torex Semiconductor | XC6206P332MR-G | XC6206-3.3V |  | SMD |  | Mouser: 865-XC6206P332MR-G
16 | U7, U8, U9, U10, U11, U12, U13, U14 | 8 | Diodes Incorporated | AH3572-SA-7 | AH3572 | SOT-23-3 | SMD |  | Mouser: 621-AH3572-SA-7
17 | U1, U2, U3, U4 | 4 | Peng Chun Electronics | BKA30D-R5 360 degrees | VID28 Dual-Shaft Stepper Motor 360 degree | THT | thru-hole | Do not populate (DNP) | Pen Chung Electronics: https://www.aliexpress.com/item/32832881189.html?spm=a2g0s.9042311.0.0.22e44c4d84lpPX
18 | SW1 | 1 | C&K | KMR221GLFS | KMKR221G-LFS SPST Switch | 4.6x2.8x1.9mm | SMD |  | Mouser: 611-KMR221G-LFS
Need a quick and accurante quote? Need an efficient production? Please read SMT Ordering Necessary Files & Info in 1 minute. Thank you very much! (https://www.pcbway.com/smt_ordering_guide.html)
Click for Instructions on How to Create a BOM (https://www.pcbway.com/blog/PCB_Assembly/How_to_Build_a_BOM__Bill_Of_Materials_.html)

Sheet: Sheet2
 | Sourced | Placed | References | Value | Footprint | Quantity
1 |  |  | C12, C15 | 22uF/16V | CP_Elec_5x5.3 | 2
2 |  |  | C1, C2, C3, C4, C5, C6, C7, C8, C10, C11, C13, C14, C16, C20 | 100nF | C_0603 | 14
3 |  |  | C17, C19 | 1uF | C_0603 | 2
4 |  |  | C21 | 10nF | C_0603 | 1
5 |  |  | C18 | 10uF/16V | C_1206 | 1
6 |  |  | R1, R3, R4, R5 | 10k | R_0603 | 4
7 |  |  | R2 | 120 | R_0603 | 1
8 |  |  | R6 | 2.2k | R_0603 | 1
10 |  |  | D1 | Blue | LED_0603 | 1
11 |  |  | U18 | LPC845M301JBD48E | LQFP-48_7x7mm_Pitch0.5mm | 1
12 |  |  | U15 | RS485_PWR_4pin | PhoenixContact_MC-G_04x3.81mm_Angled | 1
13 |  |  | U19 | SWD_JTAG_10pin | Pin_Header_Straight_2x05_Pitch1.27mm_SMD | 1
14 |  |  | U16 | SN65HVD72 | SOIC-8_3.9x4.9mm_Pitch1.27mm | 1
15 |  |  | U5, U6 | MS_X12.017 | SOP-28_X12.017 | 2
16 |  |  | U17 | XC6206-3.3V | SOT-23 | 1
17 |  |  | U7, U8, U9, U10, U11, U12, U13, U14 | AH3572 | SOT-23_2T | 8
18 |  |  | U1, U2, U3, U4 | VID28-XX | VID28 Dual-Shaft Stepper Motor | 4
19 |  |  | SW1 | KMKR221G-LFS | SW_SPST_KMR2_Small | 1
