ErichStyger/mcuoneclipse/tinyK22/V1.3/Quote-TinyK22_BOM.xlsx

 |  | TOP LAYER
Note | Provided Part NO. | Item | Qty | Reference(s) | Value | Package | Distributor | Distributor Part Number | Type | Place_YES/NO | Weblink | Alternative | Alternative 2
 | CL10B225KP8NNNC | 1 | 4 | C1, C3, C9, C18 | 2.2u | C_0603 | Digikey | 1276-1134-1-ND‎ | SMD | YES | https://www.digikey.ch/product-detail/de/samsung-electro-mechanics/CL10B225KP8NNNC/1276-1134-1-ND/3889220
 | CL10B104KO8NNWC | 2 | 12 | C2, C4, C5, C7, C8, C10, C12, C13, C14, C16, C17, C19 | 100n | C_0603 | Digikey | 1276-1939-1-ND | SMD | YES | https://www.digikey.ch/product-detail/de/samsung-electro-mechanics/CL10B104KO8NNWC/1276-1939-1-ND/3890025
 | JMK107BJ106MA-T | 3 | 2 | C6, C11 | 10u | C_0603 | Digikey | 587-1256-1-ND | SMD | YES | https://www.digikey.ch/product-detail/de/taiyo-yuden/JMK107BJ106MA-T/587-1256-1-ND/931033
 | CL10B103KA8NNNC | 4 | 1 | C15 | 10n | C_0603 | Digikey | 1276-1132-1-ND | SMD | YES | https://www.digikey.ch/product-detail/de/samsung-electro-mechanics/CL10B103KA8NNNC/1276-1132-1-ND/3889218
 | VLMO1300-GS08 | 5 | 1 | D1 | LED Orange | LED_0603 | Digikey | VLMO1300-GS08CT-ND | SMD | YES | https://www.digikey.ch/product-detail/de/vishay-semiconductor-opto-division/VLMO1300-GS08/VLMO1300-GS08CT-ND/2813369 | https://www.mouser.ch/ProductDetail/Vishay/VLMO1300-GS08/
 | PMEG2005CT215 | 6 | 1 | D2 | PMEG2005CT,215 | SOT-23 | Digikey | 1727-5188-1-ND | SMD | YES | https://www.digikey.ch/product-detail/de/nexperia-usa-inc/PMEG2005CT215/1727-5188-1-ND/2531787 | https://www.mouser.ch/ProductDetail/Nexperia/PMEG2005CT215/
 | BAS40-05W115 | 7 | 1 | D3 | BAS40-05W | SOT-323_SC-70 | Digikey | 1727-6175-1-ND | SMD | YES | https://www.digikey.ch/product-detail/de/nexperia-usa-inc/BAS40-05W115/1727-6175-1-ND/2762672 | https://www.mouser.ch/ProductDetail/Nexperia/BAS40-05W115
 | VLMB1310-GS08 | 8 | 1 | D4 | LED BLUE | LED_0603 | Digikey | VLMB1310-GS08CT-ND | SMD | YES | https://www.digikey.ch/product-detail/de/vishay-semiconductor-opto-division/VLMB1310-GS08/VLMB1310-GS08CT-ND/2813372 | https://www.mouser.ch/ProductDetail/Vishay/VLMB1300-GS08/
 | RB751S40T1G | 9 | 1 | D5 | RB751S40T1G | D_SOD-523 | Digikey | RB751S40T1GOSCT-ND | SMD | YES | https://www.digikey.ch/product-detail/de/on-semiconductor/RB751S40T1G/RB751S40T1GOSCT-ND/964628 | https://www.mouser.ch/ProductDetail/ON-Semiconductor/RB751S40T1G
 | MK20DX128VFM5 | 10 | 1 | IC1 | MK20DX128VFM5 | QFN-32-1EP_5x5mm_Pitch0.5mm | Digikey | MK20DX128VFM5-ND | SMD | YES | https://www.digikey.ch/product-detail/de/nxp-usa-inc/MK20DX128VFM5/MK20DX128VFM5-ND/3507507 | https://www.mouser.ch/ProductDetail/NXP/MK20DX128VFM5/
 | MK22FN512VLH12 | 11 | 1 | IC2 | MK22FN512VLH12 | LQFP-64_10x10mm_Pitch0.5mm | Digikey | MK22FN512VLH12-ND | SMD | YES | https://www.digikey.ch/product-detail/de/nxp-usa-inc/MK22FN512VLH12/MK22FN512VLH12-ND/4915407 | https://www.mouser.ch/ProductDetail/NXP-Freescale/MK22FN512VLH12/
 | 1050170001 | 12 | 2 | J1, J2 | USB_MICRO | USB_Micro-B_MOLEX-SD-105017-001 | Digikey | WM1399CT-ND | SMD | YES | https://www.digikey.ch/product-detail/de/molex/1050170001/WM1399CT-ND/2350885 | https://www.mouser.ch/ProductDetail/Molex/105017-0001/ | https://ch.farnell.com/molex/105017-0001/usb-2-0-buchse-micro-usb-typ-b/dp/2293836?ost=1050170001
 | MPZ1608S331ATD25 | 13 | 4 | L1, L2, L3, L4 | BEAD-330 | L_0603 | Digikey | 445-172895-1-ND | SMD | YES | https://www.digikey.ch/product-detail/de/tdk-corporation/MPZ1608S331ATD25/445-172895-1-ND/5040526 | https://www.mouser.ch/ProductDetail/TDK/MPZ1608S331ATD25/
 | RC0603JR-0733RL | 14 | 4 | R1, R2, R8, R9 | 33 | R_0603 | Digikey | 311-33GRCT-ND | SMD | YES | https://www.digikey.ch/product-detail/de/yageo/RC0603JR-0733RL/311-33GRCT-ND/729718
 | RC0603JR-071KL | 15 | 3 | R3, R4, R10 | 1k | R_0603 | Digikey | 311-1.0KGRCT-ND | SMD | YES | https://www.digikey.ch/product-detail/de/yageo/RC0603JR-071KL/311-1.0KGRCT-ND/729624
 | RC0603JR-0710KL | 16 | 2 | R5, R7 | 10k | R_0603 | Digikey | 311-10KGRCT-ND | SMD | YES | https://www.digikey.ch/product-detail/de/yageo/RC0603JR-0710KL/311-10KGRCT-ND/729647
 | RC0603JR-07470RL | 17 | 1 | R6 | 470 | R_0603 | Digikey | 311-470GRCT-ND | SMD | YES | https://www.digikey.ch/product-detail/de/yageo/RC0603JR-07470RL/311-470GRCT-ND/729738
 | KMR421G LFS | 18 | 1 | S1 | Button | switch-kmr-series | Digikey | CKN10249CT-ND | SMD | YES | https://www.digikey.ch/products/de?keywords=CKN10249CT-ND | https://www.mouser.ch/ProductDetail/CK/KMR421GLFS
 | 74AHC1G125SE-7 | 19 | 1 | U1 | 74AHC1G125GW | SOT-353_SC-70-5 | Digikey | 74AHC1G125SE-7DICT-ND | SMD | YES | https://www.digikey.ch/product-detail/de/diodes-incorporated/74AHC1G125SE-7/74AHC1G125SE-7DICT-ND/2639305 | https://www.mouser.ch/Search/ProductDetail.aspx
 | NX3020NAKV,115 | 20 | 2 | U2, U3 | NX3020NAKV | SOT-666 | Digikey | 1727-1287-1-ND | SMD | YES | https://www.digikey.ch/product-detail/de/nexperia-usa-inc/NX3020NAKV115/1727-1287-1-ND/4386092 | https://www.mouser.ch/ProductDetail/Nexperia/NX3020NAKV115/
 | STMPS2141STR | 21 | 1 | U5 | STMPS2141STR | SOT-23-5 | Digikey | 497-6933-1-ND | SMD | YES | https://www.digikey.ch/product-detail/de/stmicroelectronics/STMPS2141STR/497-6933-1-ND/1880311 |  | https://ch.farnell.com/stmicroelectronics/stmps2141str/leistungsschalt-high-side-0-5a/dp/2762725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
 | CSTNE8M00GH5C000R0 | 22 | 2 | Y1, Y2 | 8MHz | Resonator_SMD-3pin_3.2x1.3mm | Digikey | 490-17961-1-ND | SMD | YES | https://www.digikey.ch/product-detail/de/murata-electronics/CSTNE8M00GH5C000R0/490-17961-1-ND/8747769 | https://www.mouser.ch/ProductDetail/Murata-Electronics/CSTNE8M00GH5C000R0
 | ABS06-32.768KHZ-T | 23 | 1 | Y3 | 32.768kHz | ABS06-32.768kHz | Digikey | 535-10104-1-ND | SMD | YES | https://www.digikey.ch/product-detail/de/abracon-llc/ABS06-32.768KHZ-T/535-10104-1-ND/2089921 | https://www.mouser.ch/ProductDetail/ABRACON/ABS06-32768KHz-T/
 |  | BOTTOM LAYER
 |  | Item | Qty | Reference(s) | Value | Package | Distributor | Distributor Part Number | Type | Place_YES/NO | Weblink | Alternative
 | GRM21BR61A226ME51L | 24 | 1 | C20 | 22u | C_0805 | Digikey | 490-10511-1-ND | SMD | YES | https://www.digikey.ch/product-detail/de/murata-electronics/GRM21BR61A226ME51L/490-10511-1-ND/5026441
 | 1050270001 | 25 | 1 | J7 | MICRO-SD-CARD-HOLDER | SD-105027-001 | Digikey | WM6825CT-ND | SMD | YES | https://www.digikey.ch/product-detail/de/molex/1050270001/WM6825CT-ND/3045221 | https://www.mouser.ch/ProductDetail/Molex/105027-0001?qs=sGAEpiMZZMuJakaoiLiBpl1bdztRXdZtTTiLlv5lBjQ%3D
 | TC1262-3.3VDB | 26 | 1 | U4 | TC1262-33VDB | SOT-223 | Digikey | TC1262-3.3VDB-ND | SMD | YES | https://www.digikey.ch/product-detail/de/microchip-technology/TC1262-3-3VDB/TC1262-3-3VDB-ND/1980071 | https://www.mouser.ch/ProductDetail/Microchip-Technology/TC1262-33VDB
