ErichStyger/mcuoneclipse/Examples/MCUXpresso/FRDM-K64F/FRDM-K64F_FreeRTOS/Documentation/doxygen/RoutingReport_component.txt

/*!
\page page_pinalloc Pin Allocation

		<h2 style='font-family: Arial;'>Pin Allocation Report</h2>
		<table cellpadding='2' border='1' style='border: 2px solid #000000;' bgcolor='WHITE' align='center'>
			<tr bgcolor='#E8E8E8'><th>Peripheral</th><th>Custom peripheral name</th><th>Peripheral description</th></tr>
			<tr bgcolor='#F8FF9A'><td>ADC0</td><td>ADC0</td><td><small>Analog-to-Digital Converter</small></td></tr>
			<tr bgcolor='#F8FF9A'><td>ADC1</td><td>ADC1</td><td><small>Analog-to-Digital Converter</small></td></tr>
			<tr bgcolor='#AFFF8E'><td>CAN0</td><td>CAN0</td><td><small>Flex Controller Area Network module</small></td></tr>
			<tr bgcolor='#EFF174'><td>CMP0</td><td>CMP0</td><td><small>High-Speed Comparator (CMP), Voltage Reference (VREF) Digital-to-Analog Converter (DAC), and Analog Mux (ANMUX)</small></td></tr>
			<tr bgcolor='#EFF174'><td>CMP1</td><td>CMP1</td><td><small>High-Speed Comparator (CMP), Voltage Reference (VREF) Digital-to-Analog Converter (DAC), and Analog Mux (ANMUX)</small></td></tr>
			<tr bgcolor='#EFF174'><td>CMP2</td><td>CMP2</td><td><small>High-Speed Comparator (CMP), Voltage Reference (VREF) Digital-to-Analog Converter (DAC), and Analog Mux (ANMUX)</small></td></tr>
			<tr bgcolor='#CEFFFF'><td>CMT</td><td>CMT</td><td><small>Carrier Modulator Timer (CMT)</small></td></tr>
			<tr bgcolor='#E5E44D'><td>DAC0</td><td>DAC0</td><td><small>12-Bit Digital-to-Analog Converter</small></td></tr>
			<tr bgcolor='#90EE67'><td>ENET</td><td>ENET</td><td><small>Ethernet MAC-NET Core</small></td></tr>
			<tr bgcolor='#B3EAFF'><td>EWM</td><td>EWM</td><td><small>External Watchdog Monitor (EWM)</small></td></tr>
			<tr bgcolor='#EBD4BD'><td>FB</td><td>FB</td><td><small>External bus Interface (FlexBus)</small></td></tr>
			<tr bgcolor='#86DAFF'><td>FTM0</td><td>FTM0</td><td><small>FlexTimer Module</small></td></tr>
			<tr bgcolor='#86DAFF'><td>FTM1</td><td>FTM1</td><td><small>FlexTimer Module</small></td></tr>
			<tr bgcolor='#86DAFF'><td>FTM2</td><td>FTM2</td><td><small>FlexTimer Module</small></td></tr>
			<tr bgcolor='#86DAFF'><td>FTM3</td><td>FTM3</td><td><small>FlexTimer Module</small></td></tr>
			<tr bgcolor='#5FE356'><td>I2C0</td><td>I2C0</td><td><small>Inter-integrated circuit bus</small></td></tr>
			<tr bgcolor='#5FE356'><td>I2C1</td><td>I2C1</td><td><small>Inter-integrated circuit bus</small></td></tr>
			<tr bgcolor='#5FE356'><td>I2C2</td><td>I2C2</td><td><small>Inter-integrated circuit bus</small></td></tr>
			<tr bgcolor='#20E04E'><td>I2S0</td><td>I2S0</td><td><small>Integrated Interchip Sound - I2S / Synchronous Audio Interface - SAI</small></td></tr>
			<tr bgcolor='#DDC7B5'><td>JTAG</td><td>JTAG</td><td><small>JTAG interface</small></td></tr>
			<tr bgcolor='#CCB6A0'><td>LLWU</td><td>LLWU</td><td><small>Low Leakage Wake-up Unit</small></td></tr>
			<tr bgcolor='#58C7FF'><td>LPTMR0</td><td>LPTMR0</td><td><small>Low Power Timer Module</small></td></tr>
			<tr bgcolor='#C7A886'><td>OSC</td><td>OSC</td><td><small>Oscillator</small></td></tr>
			<tr bgcolor='#14AFFF'><td>PDB0</td><td>PDB0</td><td><small>Programmable Delay Block</small></td></tr>
			<tr bgcolor='#F7DCFF'><td>PTA</td><td>PTA</td><td><small>General Purpose Input/Output</small></td></tr>
			<tr bgcolor='#F7DCFF'><td>PTB</td><td>PTB</td><td><small>General Purpose Input/Output</small></td></tr>
			<tr bgcolor='#F7DCFF'><td>PTC</td><td>PTC</td><td><small>General Purpose Input/Output</small></td></tr>
			<tr bgcolor='#F7DCFF'><td>PTD</td><td>PTD</td><td><small>General Purpose Input/Output</small></td></tr>
			<tr bgcolor='#F7DCFF'><td>PTE</td><td>PTE</td><td><small>General Purpose Input/Output</small></td></tr>
			<tr bgcolor='#FFE1C7'><td>RCM</td><td>RCM</td><td><small>Reset Control Module</small></td></tr>
			<tr bgcolor='#CEFFFF'><td>RTC</td><td>RTC</td><td><small>Real Time Clock - RTC</small></td></tr>
			<tr bgcolor='#00CA3A'><td>SDHC</td><td>SDHC</td><td><small>Secured Digital Host Controller</small></td></tr>
			<tr bgcolor='#DDC7B5'><td>SIM</td><td>SIM</td><td><small>System Integration Module</small></td></tr>
			<tr bgcolor='#AFFF8E'><td>SPI0</td><td>SPI0</td><td><small>Deserial Serial Peripheral Interface 0</small></td></tr>
			<tr bgcolor='#AFFF8E'><td>SPI1</td><td>SPI1</td><td><small>Deserial Serial Peripheral Interface 1</small></td></tr>
			<tr bgcolor='#AFFF8E'><td>SPI2</td><td>SPI2</td><td><small>Deserial Serial Peripheral Interface 2</small></td></tr>
			<tr bgcolor='#F7DCFF'><td>SUPPLY</td><td>SUPPLY</td><td><small>Chip power supply</small></td></tr>
			<tr bgcolor='#EBD4BD'><td>SystemControl</td><td>SystemControl</td><td><small>System control</small></td></tr>
			<tr bgcolor='#CCB6A0'><td>TPIU</td><td>TPIU</td><td><small>Trace Port Interface Unit</small></td></tr>
			<tr bgcolor='#90EE67'><td>UART0</td><td>UART0</td><td><small>Serial Communications Interface Module UART0</small></td></tr>
			<tr bgcolor='#90EE67'><td>UART1</td><td>UART1</td><td><small>Serial Communications Interface Module UART1</small></td></tr>
			<tr bgcolor='#90EE67'><td>UART2</td><td>UART2</td><td><small>Serial Communications Interface Module UART2</small></td></tr>
			<tr bgcolor='#90EE67'><td>UART3</td><td>UART3</td><td><small>Serial Communications Interface Module UART3</small></td></tr>
			<tr bgcolor='#90EE67'><td>UART4</td><td>UART4</td><td><small>Serial Communications Interface Module UART4</small></td></tr>
			<tr bgcolor='#5FE356'><td>USB0</td><td>USB0</td><td><small>Universal Serial Bus On The Go - USB0</small></td></tr>
			<tr bgcolor='#20E04E'><td>USBDCD</td><td>USBDCD</td><td><small>USB Charging port detect</small></td></tr>
			<tr bgcolor='#DCD627'><td>VREF</td><td>VREF</td><td><small>Voltage Reference</small></td></tr>
		</table>
		<br/>
		<br/>

		<h2 style='font-family: Arial;'>Routed Pins</h2>
		<table cellpadding='2' border='1' style='border: 2px solid #000000;' bgcolor='WHITE' width='100%' align='center'>
			<tr><td colspan='3'></td><th colspan='4' align='center' bgcolor='#D0D0D0'>Assigned Pin Function(s)</th></tr>
			<tr>
				<th bgcolor='#E8E8E8'>Package Pin #</th><th bgcolor='#E8E8E8'>Pin Name</th><th bgcolor='#E8E8E8'>User Assigned Signal Name</th><th bgcolor='#E8E8E8'>Assigned Peripheral</th><th bgcolor='#E8E8E8'>Assigned Function</th><th bgcolor='#E8E8E8'>Package Function</th><th bgcolor='#E8E8E8'>Dir</th>
			</tr>
			<tr>
				<td>1</td><td>ADC1_SE4a/PTE0/SPI1_PCS1/UART1_TX/SDHC0_D1/TRACE_CLKOUT/I2C1_SDA/RTC_CLKOUT</td><td><small><i>same</i></small></td>
				<td bgcolor='#F8FF9A'>ADC1</td><td bgcolor='#F8FF9A'>adc_sea4</td><td bgcolor='#F8FF9A'>alt0</td><td bgcolor='#F8FF9A'>Input</td>
			</tr>
			<tr>
				<td>2</td><td>ADC1_SE5a/PTE1/LLWU_P0/SPI1_SOUT/UART1_RX/SDHC0_D0/TRACE_D3/I2C1_SCL/SPI1_SIN</td><td><small><i>same</i></small></td>
				<td bgcolor='#F8FF9A'>ADC1</td><td bgcolor='#F8FF9A'>adc_sea5</td><td bgcolor='#F8FF9A'>alt0</td><td bgcolor='#F8FF9A'>Input</td>
			</tr>
			<tr>
				<td rowspan='3'>3</td><td rowspan='3'>ADC0_DP2/ADC1_SE6a/PTE2/LLWU_P1/SPI1_SCK/UART1_CTS_b/SDHC0_DCLK/TRACE_D2</td><td rowspan='3'><small><i>same</i></small></td>
				<td bgcolor='#F8FF9A'>ADC0</td><td bgcolor='#F8FF9A'>adc_dp2</td><td bgcolor='#F8FF9A'>alt0</td><td bgcolor='#F8FF9A'>Input</td>
			</tr>
			<tr bgcolor='#F8FF9A'><td>ADC0</td><td>adc_se2</td><td>alt0</td><td>Input</td></tr>
			<tr bgcolor='#F8FF9A'><td>ADC1</td><td>adc_sea6</td><td>alt0</td><td>Input</td></tr>
			<tr>
				<td rowspan='2'>4</td><td rowspan='2'>ADC0_DM2/ADC1_SE7a/PTE3/SPI1_SIN/UART1_RTS_b/SDHC0_CMD/TRACE_D1/SPI1_SOUT</td><td rowspan='2'><small><i>same</i></small></td>
				<td bgcolor='#F8FF9A'>ADC0</td><td bgcolor='#F8FF9A'>adc_dm2</td><td bgcolor='#F8FF9A'>alt0</td><td bgcolor='#F8FF9A'>Input</td>
			</tr>
			<tr bgcolor='#F8FF9A'><td>ADC1</td><td>adc_sea7</td><td>alt0</td><td>Input</td></tr>
			<tr>
				<td>5</td><td>PTE4/LLWU_P2/SPI1_PCS0/UART3_TX/SDHC0_D3/TRACE_D0</td><td><small><i>same</i></small></td>
				<td></td><td></td><td></td><td></td>
			</tr>
			<tr>
				<td>6</td><td>PTE5/SPI1_PCS2/UART3_RX/SDHC0_D2/FTM3_CH0</td><td><small><i>same</i></small></td>
				<td></td><td></td><td></td><td></td>
			</tr>
			<tr>
				<td>7</td><td>PTE6/SPI1_PCS3/UART3_CTS_b/I2S0_MCLK/FTM3_CH1/USB_SOF_OUT</td><td><small><i>same</i></small></td>
				<td></td><td></td><td></td><td></td>
			</tr>
			<tr>
				<td>8</td><td>VDD16</td><td><small><i>same</i></small></td>
				<td></td><td></td><td></td><td></td>
			</tr>
			<tr>
				<td>9</td><td>VSS17</td><td><small><i>same</i></small></td>
				<td></td><td></td><td></td><td></td>
			</tr>
			<tr>
				<td>10</td><td>USB0_DP</td><td><small><i>same</i></small></td>
				<td bgcolor='#5FE356'>USB0</td><td bgcolor='#5FE356'>usb_dp</td><td bgcolor='#5FE356'>alt0</td><td bgcolor='#5FE356'>Input/Output</td>
			</tr>
			<tr>
				<td>11</td><td>USB0_DM</td><td><small><i>same</i></small></td>
				<td bgcolor='#5FE356'>USB0</td><td bgcolor='#5FE356'>usb_dm</td><td bgcolor='#5FE356'>alt0</td><td bgcolor='#5FE356'>Input/Output</td>
			</tr>
			<tr>
				<td>12</td><td>VOUT33</td><td><small><i>same</i></small></td>
				<td bgcolor='#5FE356'>USB0</td><td bgcolor='#5FE356'>usb_vout</td><td bgcolor='#5FE356'>alt0</td><td bgcolor='#5FE356'>Output</td>
			</tr>
			<tr>
				<td>13</td><td>VREGIN</td><td><small><i>same</i></small></td>
				<td bgcolor='#5FE356'>USB0</td><td bgcolor='#5FE356'>usb_vrin</td><td bgcolor='#5FE356'>alt0</td><td bgcolor='#5FE356'>Input</td>
			</tr>
			<tr>
				<td rowspan='2'>14</td><td rowspan='2'>ADC0_DP1</td><td rowspan='2'><small><i>same</i></small></td>
				<td bgcolor='#F8FF9A'>ADC0</td><td bgcolor='#F8FF9A'>adc_dp1</td><td bgcolor='#F8FF9A'>alt0</td><td bgcolor='#F8FF9A'>Input</td>
			</tr>
			<tr bgcolor='#F8FF9A'><td>ADC0</td><td>adc_se1</td><td>alt0</td><td>Input</td></tr>
			<tr>
				<td rowspan='2'>15</td><td rowspan='2'>ADC0_DM1</td><td rowspan='2'><small><i>same</i></small></td>
				<td bgcolor='#F8FF9A'>ADC0</td><td bgcolor='#F8FF9A'>adc_dm1</td><td bgcolor='#F8FF9A'>alt0</td><td bgcolor='#F8FF9A'>Input</td>
			</tr>
			<tr bgcolor='#F8FF9A'><td>ADC0</td><td>adc_se20</td><td>alt0</td><td>Input</td></tr>
			<tr>
				<td rowspan='2'>16</td><td rowspan='2'>ADC1_DP1</td><td rowspan='2'><small><i>same</i></small></td>
				<td bgcolor='#F8FF9A'>ADC1</td><td bgcolor='#F8FF9A'>adc_dp1</td><td bgcolor='#F8FF9A'>alt0</td><td bgcolor='#F8FF9A'>Input</td>
			</tr>
			<tr bgcolor='#F8FF9A'><td>ADC1</td><td>adc_se1</td><td>alt0</td><td>Input</td></tr>
			<tr>
				<td rowspan='2'>17</td><td rowspan='2'>ADC1_DM1</td><td rowspan='2'><small><i>same</i></small></td>
				<td bgcolor='#F8FF9A'>ADC1</td><td bgcolor='#F8FF9A'>adc_dm1</td><td bgcolor='#F8FF9A'>alt0</td><td bgcolor='#F8FF9A'>Input</td>
			</tr>
			<tr bgcolor='#F8FF9A'><td>ADC1</td><td>adc_se20</td><td>alt0</td><td>Input</td></tr>
			<tr>
				<td rowspan='4'>18</td><td rowspan='4'>ADC0_DP0/ADC1_DP3</td><td rowspan='4'><small><i>same</i></small></td>
				<td bgcolor='#F8FF9A'>ADC0</td><td bgcolor='#F8FF9A'>adc_dp0</td><td bgcolor='#F8FF9A'>alt0</td><td bgcolor='#F8FF9A'>Input</td>
			</tr>
			<tr bgcolor='#F8FF9A'><td>ADC0</td><td>adc_se0</td><td>alt0</td><td>Input</td></tr>
			<tr bgcolor='#F8FF9A'><td>ADC1</td><td>adc_dp3</td><td>alt0</td><td>Input</td></tr>
			<tr bgcolor='#F8FF9A'><td>ADC1</td><td>adc_se3</td><td>alt0</td><td>Input</td></tr>
			<tr>
				<td rowspan='3'>19</td><td rowspan='3'>ADC0_DM0/ADC1_DM3</td><td rowspan='3'><small><i>same</i></small></td>
				<td bgcolor='#F8FF9A'>ADC0</td><td bgcolor='#F8FF9A'>adc_dm0</td><td bgcolor='#F8FF9A'>alt0</td><td bgcolor='#F8FF9A'>Input</td>
			</tr>
			<tr bgcolor='#F8FF9A'><td>ADC0</td><td>adc_se19</td><td>alt0</td><td>Input</td></tr>
			<tr bgcolor='#F8FF9A'><td>ADC1</td><td>adc_dm3</td><td>alt0</td><td>Input</td></tr>
			<tr>
				<td rowspan='4'>20</td><td rowspan='4'>ADC1_DP0/ADC0_DP3</td><td rowspan='4'><small><i>same</i></small></td>
				<td bgcolor='#F8FF9A'>ADC1</td><td bgcolor='#F8FF9A'>adc_dp0</td><td bgcolor='#F8FF9A'>alt0</td><td bgcolor='#F8FF9A'>Input</td>
			</tr>
			<tr bgcolor='#F8FF9A'><td>ADC1</td><td>adc_se0</td><td>alt0</td><td>Input</td></tr>
			<tr bgcolor='#F8FF9A'><td>ADC0</td><td>adc_dp3</td><td>alt0</td><td>Input</td></tr>
			<tr bgcolor='#F8FF9A'><td>ADC0</td><td>adc_se3</td><td>alt0</td><td>Input</td></tr>
			<tr>
				<td rowspan='3'>21</td><td rowspan='3'>ADC1_DM0/ADC0_DM3</td><td rowspan='3'><small><i>same</i></small></td>
				<td bgcolor='#F8FF9A'>ADC1</td><td bgcolor='#F8FF9A'>adc_dm0</td><td bgcolor='#F8FF9A'>alt0</td><td bgcolor='#F8FF9A'>Input</td>
			</tr>
			<tr bgcolor='#F8FF9A'><td>ADC1</td><td>adc_se19</td><td>alt0</td><td>Input</td></tr>
			<tr bgcolor='#F8FF9A'><td>ADC0</td><td>adc_dm3</td><td>alt0</td><td>Input</td></tr>
			<tr>
				<td>22</td><td>VDDA</td><td><small><i>same</i></small></td>
				<td></td><td></td><td></td><td></td>
			</tr>
			<tr>
				<td rowspan='6'>23</td><td rowspan='6'>VREFH</td><td rowspan='6'><small><i>same</i></small></td>
				<td bgcolor='#F8FF9A'>ADC0</td><td bgcolor='#F8FF9A'>adc_vrefh</td><td bgcolor='#F8FF9A'>alt0</td><td bgcolor='#F8FF9A'>Input</td>
			</tr>
			<tr bgcolor='#F8FF9A'><td>ADC0</td><td>adc_se29</td><td>alt0</td><td>Input</td></tr>
			<tr bgcolor='#F8FF9A'><td>ADC0</td><td>adc_dp29</td><td>alt0</td><td>Input</td></tr>
			<tr bgcolor='#F8FF9A'><td>ADC1</td><td>adc_vrefh</td><td>alt0</td><td>Input</td></tr>
			<tr bgcolor='#F8FF9A'><td>ADC1</td><td>adc_se29</td><td>alt0</td><td>Input</td></tr>
			<tr bgcolor='#F8FF9A'><td>ADC1</td><td>adc_dp29</td><td>alt0</td><td>Input</td></tr>
			<tr>
				<td rowspan='6'>24</td><td rowspan='6'>VREFL</td><td rowspan='6'><small><i>same</i></small></td>
				<td bgcolor='#F8FF9A'>ADC0</td><td bgcolor='#F8FF9A'>adc_vrefl</td><td bgcolor='#F8FF9A'>alt0</td><td bgcolor='#F8FF9A'>Input</td>
			</tr>
			<tr bgcolor='#F8FF9A'><td>ADC0</td><td>adc_se30</td><td>alt0</td><td>Input</td></tr>
			<tr bgcolor='#F8FF9A'><td>ADC0</td><td>adc_dm29</td><td>alt0</td><td>Input</td></tr>
			<tr bgcolor='#F8FF9A'><td>ADC1</td><td>adc_vrefl</td><td>alt0</td><td>Input</td></tr>
			<tr bgcolor='#F8FF9A'><td>ADC1</td><td>adc_se30</td><td>alt0</td><td>Input</td></tr>
			<tr bgcolor='#F8FF9A'><td>ADC1</td><td>adc_dm29</td><td>alt0</td><td>Input</td></tr>
			<tr>
				<td>25</td><td>VSSA</td><td><small><i>same</i></small></td>
				<td></td><td></td><td></td><td></td>
			</tr>
			<tr>
				<td rowspan='6'>26</td><td rowspan='6'>VREF_OUT/CMP1_IN5/CMP0_IN5/ADC1_SE18</td><td rowspan='6'><small><i>same</i></small></td>
				<td bgcolor='#DCD627'>VREF</td><td bgcolor='#DCD627'>vref_out</td><td bgcolor='#DCD627'>alt0</td><td bgcolor='#DCD627'>Output</td>
			</tr>
			<tr bgcolor='#EFF174'><td>CMP1</td><td>cmp_pos5</td><td>alt0</td><td>Input</td></tr>
			<tr bgcolor='#EFF174'><td>CMP1</td><td>cmp_neg5</td><td>alt0</td><td>Input</td></tr>
			<tr bgcolor='#EFF174'><td>CMP0</td><td>cmp_pos5</td><td>alt0</td><td>Input</td></tr>
			<tr bgcolor='#EFF174'><td>CMP0</td><td>cmp_neg5</td><td>alt0</td><td>Input</td></tr>
			<tr bgcolor='#F8FF9A'><td>ADC1</td><td>adc_se18</td><td>alt0</td><td>Input</td></tr>
			<tr>
				<td rowspan='4'>27</td><td rowspan='4'>DAC0_OUT/CMP1_IN3/ADC0_SE23</td><td rowspan='4'><small><i>same</i></small></td>
				<td bgcolor='#E5E44D'>DAC0</td><td bgcolor='#E5E44D'>dac_out</td><td bgcolor='#E5E44D'>alt0</td><td bgcolor='#E5E44D'>Output</td>
			</tr>
			<tr bgcolor='#EFF174'><td>CMP1</td><td>cmp_pos3</td><td>alt0</td><td>Input</td></tr>
			<tr bgcolor='#EFF174'><td>CMP1</td><td>cmp_neg3</td><td>alt0</td><td>Input</td></tr>
			<tr bgcolor='#F8FF9A'><td>ADC0</td><td>adc_se23</td><td>alt0</td><td>Input</td></tr>
			<tr>
				<td>28</td><td>XTAL32</td><td><small><i>same</i></small></td>
				<td bgcolor='#CEFFFF'>RTC</td><td bgcolor='#CEFFFF'>rtc_xtal</td><td bgcolor='#CEFFFF'>alt0</td><td bgcolor='#CEFFFF'>Output</td>
			</tr>
			<tr>
				<td>29</td><td>EXTAL32</td><td><small><i>same</i></small></td>
				<td bgcolor='#CEFFFF'>RTC</td><td bgcolor='#CEFFFF'>rtc_extal</td><td bgcolor='#CEFFFF'>alt0</td><td bgcolor='#CEFFFF'>Input</td>
			</tr>
			<tr>
				<td>30</td><td>VBAT</td><td><small><i>same</i></small></td>
				<td bgcolor='#CEFFFF'>RTC</td><td bgcolor='#CEFFFF'>rtc_vbat</td><td bgcolor='#CEFFFF'>alt0</td><td bgcolor='#CEFFFF'>Input</td>
			</tr>
			<tr>
				<td>31</td><td>ADC0_SE17/PTE24/UART4_TX/I2C0_SCL/EWM_OUT_b</td><td><small><i>same</i></small></td>
				<td bgcolor='#F8FF9A'>ADC0</td><td bgcolor='#F8FF9A'>adc_se17</td><td bgcolor='#F8FF9A'>alt0</td><td bgcolor='#F8FF9A'>Input</td>
			</tr>
			<tr>
				<td>32</td><td>ADC0_SE18/PTE25/UART4_RX/I2C0_SDA/EWM_IN</td><td><small><i>same</i></small></td>
				<td bgcolor='#F8FF9A'>ADC0</td><td bgcolor='#F8FF9A'>adc_se18</td><td bgcolor='#F8FF9A'>alt0</td><td bgcolor='#F8FF9A'>Input</td>
			</tr>
			<tr>
				<td>33</td><td>PTE26/ENET_1588_CLKIN/UART4_CTS_b/RTC_CLKOUT/USB_CLKIN</td><td><small><i>same</i></small></td>
				<td bgcolor='#F7DCFF'>PTE</td><td bgcolor='#F7DCFF'>port26</td><td bgcolor='#F7DCFF'>alt1</td><td bgcolor='#F7DCFF'>Output</td>
			</tr>
			<tr>
				<td>34</td><td>PTA0/UART0_CTS_b/UART0_COL_b/FTM0_CH5/JTAG_TCLK/SWD_CLK/EZP_CLK</td><td><small><i>same</i></small></td>
				<td bgcolor='#DDC7B5'>JTAG</td><td bgcolor='#DDC7B5'>jtag_clk</td><td bgcolor='#DDC7B5'>alt7</td><td bgcolor='#DDC7B5'>Input</td>
			</tr>
			<tr>
				<td>35</td><td>PTA1/UART0_RX/FTM0_CH6/JTAG_TDI/EZP_DI</td><td><small><i>same</i></small></td>
				<td bgcolor='#DDC7B5'>JTAG</td><td bgcolor='#DDC7B5'>jtag_di</td><td bgcolor='#DDC7B5'>alt7</td><td bgcolor='#DDC7B5'>Input</td>
			</tr>
			<tr>
				<td rowspan='3'>36</td><td rowspan='3'>PTA2/UART0_TX/FTM0_CH7/JTAG_TDO/TRACE_SWO/EZP_DO</td><td rowspan='3'><small><i>same</i></small></td>
				<td bgcolor='#DDC7B5'>JTAG</td><td bgcolor='#DDC7B5'>jtag_do</td><td bgcolor='#DDC7B5'>alt7</td><td bgcolor='#DDC7B5'>Output</td>
			</tr>
			<tr bgcolor='#CCB6A0'><td>TPIU</td><td>tpiu_swo</td><td>alt7</td><td>Output</td></tr>
			<tr bgcolor='#969696'><td>non-peripheral</td><td>TRACE_SWO</td><td>alt7</td><td>Not Specified</td></tr>
			<tr>
				<td>37</td><td>PTA3/UART0_RTS_b/FTM0_CH0/JTAG_TMS/SWD_DIO</td><td><small><i>same</i></small></td>
				<td bgcolor='#DDC7B5'>JTAG</td><td bgcolor='#DDC7B5'>jtag_ms</td><td bgcolor='#DDC7B5'>alt7</td><td bgcolor='#DDC7B5'>Input/Output</td>
			</tr>
			<tr>
				<td rowspan='2'>38</td><td rowspan='2'>PTA4/LLWU_P3/FTM0_CH1/NMI_b/EZP_CS_b</td><td rowspan='2'><small><i>same</i></small></td>
				<td bgcolor='#EBD4BD'>SystemControl</td><td bgcolor='#EBD4BD'>scb_nmi</td><td bgcolor='#EBD4BD'>alt7</td><td bgcolor='#EBD4BD'>Input</td>
			</tr>
			<tr bgcolor='#969696'><td>non-peripheral</td><td>NMI</td><td>alt7</td><td>Not Specified</td></tr>
			<tr>
				<td>39</td><td>PTA5/USB_CLKIN/FTM0_CH2/RMII0_RXER/MII0_RXER/CMP2_OUT/I2S0_TX_BCLK/JTAG_TRST_b</td><td><small><i>same</i></small></td>
				<td></td><td></td><td></td><td></td>
			</tr>
			<tr>
				<td>40</td><td>VDD63</td><td><small><i>same</i></small></td>
				<td></td><td></td><td></td><td></td>
			</tr>
			<tr>
				<td>41</td><td>VSS64</td><td><small><i>same</i></small></td>
				<td></td><td></td><td></td><td></td>
			</tr>
			<tr>
				<td rowspan='3'>42</td><td rowspan='3'>CMP2_IN0/PTA12/CAN0_TX/FTM1_CH0/RMII0_RXD1/MII0_RXD1/I2C2_SCL/I2S0_TXD0/FTM1_QD_PHA</td><td rowspan='3'><small><i>same</i></small></td>
				<td bgcolor='#EFF174'>CMP2</td><td bgcolor='#EFF174'>cmp_pos0</td><td bgcolor='#EFF174'>alt0</td><td bgcolor='#EFF174'>Input</td>
			</tr>
			<tr bgcolor='#EFF174'><td>CMP2</td><td>cmp_neg0</td><td>alt0</td><td>Input</td></tr>
			<tr bgcolor='#EFF174'><td>CMP2</td><td>cmp_in0</td><td>alt0</td><td>Input</td></tr>
			<tr>
				<td rowspan='3'>43</td><td rowspan='3'>CMP2_IN1/PTA13/LLWU_P4/CAN0_RX/FTM1_CH1/RMII0_RXD0/MII0_RXD0/I2C2_SDA/I2S0_TX_FS/FTM1_QD_PHB</td><td rowspan='3'><small><i>same</i></small></td>
				<td bgcolor='#EFF174'>CMP2</td><td bgcolor='#EFF174'>cmp_pos1</td><td bgcolor='#EFF174'>alt0</td><td bgcolor='#EFF174'>Input</td>
			</tr>
			<tr bgcolor='#EFF174'><td>CMP2</td><td>cmp_neg1</td><td>alt0</td><td>Input</td></tr>
			<tr bgcolor='#EFF174'><td>CMP2</td><td>cmp_in1</td><td>alt0</td><td>Input</td></tr>
			<tr>
				<td>44</td><td>PTA14/SPI0_PCS0/UART0_TX/RMII0_CRS_DV/MII0_RXDV/I2C2_SCL/I2S0_RX_BCLK/I2S0_TXD1</td><td><small><i>same</i></small></td>
				<td></td><td></td><td></td><td></td>
			</tr>
			<tr>
				<td>45</td><td>PTA15/SPI0_SCK/UART0_RX/RMII0_TXEN/MII0_TXEN/I2S0_RXD0</td><td><small><i>same</i></small></td>
				<td></td><td></td><td></td><td></td>
			</tr>
			<tr>
				<td>46</td><td>PTA16/SPI0_SOUT/UART0_CTS_b/UART0_COL_b/RMII0_TXD0/MII0_TXD0/I2S0_RX_FS/I2S0_RXD1</td><td><small><i>same</i></small></td>
				<td></td><td></td><td></td><td></td>
			</tr>
			<tr>
				<td>47</td><td>ADC1_SE17/PTA17/SPI0_SIN/UART0_RTS_b/RMII0_TXD1/MII0_TXD1/I2S0_MCLK</td><td><small><i>same</i></small></td>
				<td bgcolor='#F8FF9A'>ADC1</td><td bgcolor='#F8FF9A'>adc_se17</td><td bgcolor='#F8FF9A'>alt0</td><td bgcolor='#F8FF9A'>Input</td>
			</tr>
			<tr>
				<td>48</td><td>VDD78</td><td><small><i>same</i></small></td>
				<td></td><td></td><td></td><td></td>
			</tr>
			<tr>
				<td>49</td><td>VSS79</td><td><small><i>same</i></small></td>
				<td></td><td></td><td></td><td></td>
			</tr>
			<tr>
				<td rowspan='2'>50</td><td rowspan='2'>EXTAL0/PTA18/FTM0_FLT2/FTM_CLKIN0</td><td rowspan='2'><small><i>same</i></small></td>
				<td bgcolor='#90EE67'>ENET</td><td bgcolor='#90EE67'>rmii_clkin</td><td bgcolor='#90EE67'>alt0</td><td bgcolor='#90EE67'>Input</td>
			</tr>
			<tr bgcolor='#C7A886'><td>OSC</td><td>extal</td><td>alt0</td><td>Input</td></tr>
			<tr>
				<td>51</td><td>XTAL0/PTA19/FTM1_FLT0/FTM_CLKIN1/LPTMR0_ALT1</td><td><small><i>same</i></small></td>
				<td bgcolor='#C7A886'>OSC</td><td bgcolor='#C7A886'>xtal</td><td bgcolor='#C7A886'>alt0</td><td bgcolor='#C7A886'>Output</td>
			</tr>
			<tr>
				<td>52</td><td>RESET_b</td><td><small><i>same</i></small></td>
				<td bgcolor='#FFE1C7'>RCM</td><td bgcolor='#FFE1C7'>reset</td><td bgcolor='#FFE1C7'>alt0</td><td bgcolor='#FFE1C7'>Input</td>
			</tr>
			<tr>
				<td rowspan='2'>53</td><td rowspan='2'>ADC0_SE8/ADC1_SE8/PTB0/LLWU_P5/I2C0_SCL/FTM1_CH0/RMII0_MDIO/MII0_MDIO/FTM1_QD_PHA</td><td rowspan='2'><small><i>same</i></small></td>
				<td bgcolor='#F8FF9A'>ADC0</td><td bgcolor='#F8FF9A'>adc_se8</td><td bgcolor='#F8FF9A'>alt0</td><td bgcolor='#F8FF9A'>Input</td>
			</tr>
			<tr bgcolor='#F8FF9A'><td>ADC1</td><td>adc_se8</td><td>alt0</td><td>Input</td></tr>
			<tr>
				<td rowspan='2'>54</td><td rowspan='2'>ADC0_SE9/ADC1_SE9/PTB1/I2C0_SDA/FTM1_CH1/RMII0_MDC/MII0_MDC/FTM1_QD_PHB</td><td rowspan='2'><small><i>same</i></small></td>
				<td bgcolor='#F8FF9A'>ADC0</td><td bgcolor='#F8FF9A'>adc_se9</td><td bgcolor='#F8FF9A'>alt0</td><td bgcolor='#F8FF9A'>Input</td>
			</tr>
			<tr bgcolor='#F8FF9A'><td>ADC1</td><td>adc_se9</td><td>alt0</td><td>Input</td></tr>
			<tr>
				<td>55</td><td>ADC0_SE12/PTB2/I2C0_SCL/UART0_RTS_b/ENET0_1588_TMR0/FTM0_FLT3</td><td><small><i>same</i></small></td>
				<td bgcolor='#F8FF9A'>ADC0</td><td bgcolor='#F8FF9A'>adc_se12</td><td bgcolor='#F8FF9A'>alt0</td><td bgcolor='#F8FF9A'>Input</td>
			</tr>
			<tr>
				<td>56</td><td>ADC0_SE13/PTB3/I2C0_SDA/UART0_CTS_b/UART0_COL_b/ENET0_1588_TMR1/FTM0_FLT0</td><td><small><i>same</i></small></td>
				<td bgcolor='#F8FF9A'>ADC0</td><td bgcolor='#F8FF9A'>adc_se13</td><td bgcolor='#F8FF9A'>alt0</td><td bgcolor='#F8FF9A'>Input</td>
			</tr>
			<tr>
				<td>57</td><td>PTB9/SPI1_PCS1/UART3_CTS_b/FB_AD20</td><td><small><i>same</i></small></td>
				<td></td><td></td><td></td><td></td>
			</tr>
			<tr>
				<td>58</td><td>ADC1_SE14/PTB10/SPI1_PCS0/UART3_RX/FB_AD19/FTM0_FLT1</td><td><small><i>same</i></small></td>
				<td bgcolor='#F8FF9A'>ADC1</td><td bgcolor='#F8FF9A'>adc_se14</td><td bgcolor='#F8FF9A'>alt0</td><td bgcolor='#F8FF9A'>Input</td>
			</tr>
			<tr>
				<td>59</td><td>ADC1_SE15/PTB11/SPI1_SCK/UART3_TX/FB_AD18/FTM0_FLT2</td><td><small><i>same</i></small></td>
				<td bgcolor='#F8FF9A'>ADC1</td><td bgcolor='#F8FF9A'>adc_se15</td><td bgcolor='#F8FF9A'>alt0</td><td bgcolor='#F8FF9A'>Input</td>
			</tr>
			<tr>
				<td>60</td><td>VSS103</td><td><small><i>same</i></small></td>
				<td></td><td></td><td></td><td></td>
			</tr>
			<tr>
				<td>61</td><td>VDD104</td><td><small><i>same</i></small></td>
				<td></td><td></td><td></td><td></td>
			</tr>
			<tr>
				<td>62</td><td>PTB16/SPI1_SOUT/UART0_RX/FTM_CLKIN0/FB_AD17/EWM_IN</td><td><small><i>same</i></small></td>
				<td></td><td></td><td></td><td></td>
			</tr>
			<tr>
				<td>63</td><td>PTB17/SPI1_SIN/UART0_TX/FTM_CLKIN1/FB_AD16/EWM_OUT_b</td><td><small><i>same</i></small></td>
				<td></td><td></td><td></td><td></td>
			</tr>
			<tr>
				<td>64</td><td>PTB18/CAN0_TX/FTM2_CH0/I2S0_TX_BCLK/FB_AD15/FTM2_QD_PHA</td><td><small><i>same</i></small></td>
				<td></td><td></td><td></td><td></td>
			</tr>
			<tr>
				<td>65</td><td>PTB19/CAN0_RX/FTM2_CH1/I2S0_TX_FS/FB_OE_b/FTM2_QD_PHB</td><td><small><i>same</i></small></td>
				<td></td><td></td><td></td><td></td>
			</tr>
			<tr>
				<td>66</td><td>PTB20/SPI2_PCS0/FB_AD31/CMP0_OUT</td><td><small><i>same</i></small></td>
				<td></td><td></td><td></td><td></td>
			</tr>
			<tr>
				<td>67</td><td>PTB21/SPI2_SCK/FB_AD30/CMP1_OUT</td><td><small><i>same</i></small></td>
				<td bgcolor='#F7DCFF'>PTB</td><td bgcolor='#F7DCFF'>port21</td><td bgcolor='#F7DCFF'>alt1</td><td bgcolor='#F7DCFF'>Output</td>
			</tr>
			<tr>
				<td>68</td><td>PTB22/SPI2_SOUT/FB_AD29/CMP2_OUT</td><td><small><i>same</i></small></td>
				<td bgcolor='#F7DCFF'>PTB</td><td bgcolor='#F7DCFF'>port22</td><td bgcolor='#F7DCFF'>alt1</td><td bgcolor='#F7DCFF'>Output</td>
			</tr>
			<tr>
				<td>69</td><td>PTB23/SPI2_SIN/SPI0_PCS5/FB_AD28</td><td><small><i>same</i></small></td>
				<td></td><td></td><td></td><td></td>
			</tr>
			<tr>
				<td>70</td><td>ADC0_SE14/PTC0/SPI0_PCS4/PDB0_EXTRG/USB_SOF_OUT/FB_AD14/I2S0_TXD1</td><td><small><i>same</i></small></td>
				<td bgcolor='#F8FF9A'>ADC0</td><td bgcolor='#F8FF9A'>adc_se14</td><td bgcolor='#F8FF9A'>alt0</td><td bgcolor='#F8FF9A'>Input</td>
			</tr>
			<tr>
				<td>71</td><td>ADC0_SE15/PTC1/LLWU_P6/SPI0_PCS3/UART1_RTS_b/FTM0_CH0/FB_AD13/I2S0_TXD0</td><td><small><i>same</i></small></td>
				<td bgcolor='#F8FF9A'>ADC0</td><td bgcolor='#F8FF9A'>adc_se15</td><td bgcolor='#F8FF9A'>alt0</td><td bgcolor='#F8FF9A'>Input</td>
			</tr>
			<tr>
				<td rowspan='4'>72</td><td rowspan='4'>ADC0_SE4b/CMP1_IN0/PTC2/SPI0_PCS2/UART1_CTS_b/FTM0_CH1/FB_AD12/I2S0_TX_FS</td><td rowspan='4'><small><i>same</i></small></td>
				<td bgcolor='#F8FF9A'>ADC0</td><td bgcolor='#F8FF9A'>adc_seb4</td><td bgcolor='#F8FF9A'>alt0</td><td bgcolor='#F8FF9A'>Input</td>
			</tr>
			<tr bgcolor='#EFF174'><td>CMP1</td><td>cmp_pos0</td><td>alt0</td><td>Input</td></tr>
			<tr bgcolor='#EFF174'><td>CMP1</td><td>cmp_neg0</td><td>alt0</td><td>Input</td></tr>
			<tr bgcolor='#EFF174'><td>CMP1</td><td>cmp_in0</td><td>alt0</td><td>Input</td></tr>
			<tr>
				<td rowspan='3'>73</td><td rowspan='3'>CMP1_IN1/PTC3/LLWU_P7/SPI0_PCS1/UART1_RX/FTM0_CH2/CLKOUT/I2S0_TX_BCLK</td><td rowspan='3'><small><i>same</i></small></td>
				<td bgcolor='#EFF174'>CMP1</td><td bgcolor='#EFF174'>cmp_pos1</td><td bgcolor='#EFF174'>alt0</td><td bgcolor='#EFF174'>Input</td>
			</tr>
			<tr bgcolor='#EFF174'><td>CMP1</td><td>cmp_neg1</td><td>alt0</td><td>Input</td></tr>
			<tr bgcolor='#EFF174'><td>CMP1</td><td>cmp_in1</td><td>alt0</td><td>Input</td></tr>
			<tr>
				<td>74</td><td>VSS117</td><td><small><i>same</i></small></td>
				<td></td><td></td><td></td><td></td>
			</tr>
			<tr>
				<td>75</td><td>VDD118</td><td><small><i>same</i></small></td>
				<td></td><td></td><td></td><td></td>
			</tr>
			<tr>
				<td>76</td><td>PTC4/LLWU_P8/SPI0_PCS0/UART1_TX/FTM0_CH3/FB_AD11/CMP1_OUT</td><td><small><i>same</i></small></td>
				<td></td><td></td><td></td><td></td>
			</tr>
			<tr>
				<td>77</td><td>PTC5/LLWU_P9/SPI0_SCK/LPTMR0_ALT2/I2S0_RXD0/FB_AD10/CMP0_OUT/FTM0_CH2</td><td><small><i>same</i></small></td>
				<td></td><td></td><td></td><td></td>
			</tr>
			<tr>
				<td rowspan='3'>78</td><td rowspan='3'>CMP0_IN0/PTC6/LLWU_P10/SPI0_SOUT/PDB0_EXTRG/I2S0_RX_BCLK/FB_AD9/I2S0_MCLK</td><td rowspan='3'><small><i>same</i></small></td>
				<td bgcolor='#EFF174'>CMP0</td><td bgcolor='#EFF174'>cmp_pos0</td><td bgcolor='#EFF174'>alt0</td><td bgcolor='#EFF174'>Input</td>
			</tr>
			<tr bgcolor='#EFF174'><td>CMP0</td><td>cmp_neg0</td><td>alt0</td><td>Input</td></tr>
			<tr bgcolor='#EFF174'><td>CMP0</td><td>cmp_in0</td><td>alt0</td><td>Input</td></tr>
			<tr>
				<td rowspan='3'>79</td><td rowspan='3'>CMP0_IN1/PTC7/SPI0_SIN/USB_SOF_OUT/I2S0_RX_FS/FB_AD8</td><td rowspan='3'><small><i>same</i></small></td>
				<td bgcolor='#EFF174'>CMP0</td><td bgcolor='#EFF174'>cmp_pos1</td><td bgcolor='#EFF174'>alt0</td><td bgcolor='#EFF174'>Input</td>
			</tr>
			<tr bgcolor='#EFF174'><td>CMP0</td><td>cmp_neg1</td><td>alt0</td><td>Input</td></tr>
			<tr bgcolor='#EFF174'><td>CMP0</td><td>cmp_in1</td><td>alt0</td><td>Input</td></tr>
			<tr>
				<td rowspan='4'>80</td><td rowspan='4'>ADC1_SE4b/CMP0_IN2/PTC8/FTM3_CH4/I2S0_MCLK/FB_AD7</td><td rowspan='4'><small><i>same</i></small></td>
				<td bgcolor='#F8FF9A'>ADC1</td><td bgcolor='#F8FF9A'>adc_seb4</td><td bgcolor='#F8FF9A'>alt0</td><td bgcolor='#F8FF9A'>Input</td>
			</tr>
			<tr bgcolor='#EFF174'><td>CMP0</td><td>cmp_pos2</td><td>alt0</td><td>Input</td></tr>
			<tr bgcolor='#EFF174'><td>CMP0</td><td>cmp_neg2</td><td>alt0</td><td>Input</td></tr>
			<tr bgcolor='#EFF174'><td>CMP0</td><td>cmp_in2</td><td>alt0</td><td>Input</td></tr>
			<tr>
				<td rowspan='4'>81</td><td rowspan='4'>ADC1_SE5b/CMP0_IN3/PTC9/FTM3_CH5/I2S0_RX_BCLK/FB_AD6/FTM2_FLT0</td><td rowspan='4'><small><i>same</i></small></td>
				<td bgcolor='#F8FF9A'>ADC1</td><td bgcolor='#F8FF9A'>adc_seb5</td><td bgcolor='#F8FF9A'>alt0</td><td bgcolor='#F8FF9A'>Input</td>
			</tr>
			<tr bgcolor='#EFF174'><td>CMP0</td><td>cmp_pos3</td><td>alt0</td><td>Input</td></tr>
			<tr bgcolor='#EFF174'><td>CMP0</td><td>cmp_neg3</td><td>alt0</td><td>Input</td></tr>
			<tr bgcolor='#EFF174'><td>CMP0</td><td>cmp_in3</td><td>alt0</td><td>Input</td></tr>
			<tr>
				<td>82</td><td>ADC1_SE6b/PTC10/I2C1_SCL/FTM3_CH6/I2S0_RX_FS/FB_AD5</td><td><small><i>same</i></small></td>
				<td bgcolor='#F8FF9A'>ADC1</td><td bgcolor='#F8FF9A'>adc_seb6</td><td bgcolor='#F8FF9A'>alt0</td><td bgcolor='#F8FF9A'>Input</td>
			</tr>
			<tr>
				<td>83</td><td>ADC1_SE7b/PTC11/LLWU_P11/I2C1_SDA/FTM3_CH7/I2S0_RXD1/FB_RW_b</td><td><small><i>same</i></small></td>
				<td bgcolor='#F8FF9A'>ADC1</td><td bgcolor='#F8FF9A'>adc_seb7</td><td bgcolor='#F8FF9A'>alt0</td><td bgcolor='#F8FF9A'>Input</td>
			</tr>
			<tr>
				<td>84</td><td>PTC12/UART4_RTS_b/FB_AD27/FTM3_FLT0</td><td><small><i>same</i></small></td>
				<td></td><td></td><td></td><td></td>
			</tr>
			<tr>
				<td>85</td><td>PTC13/UART4_CTS_b/FB_AD26</td><td><small><i>same</i></small></td>
				<td></td><td></td><td></td><td></td>
			</tr>
			<tr>
				<td>86</td><td>PTC14/UART4_RX/FB_AD25</td><td><small><i>same</i></small></td>
				<td></td><td></td><td></td><td></td>
			</tr>
			<tr>
				<td>87</td><td>PTC15/UART4_TX/FB_AD24</td><td><small><i>same</i></small></td>
				<td></td><td></td><td></td><td></td>
			</tr>
			<tr>
				<td>88</td><td>VSS131</td><td><small><i>same</i></small></td>
				<td></td><td></td><td></td><td></td>
			</tr>
			<tr>
				<td>89</td><td>VDD132</td><td><small><i>same</i></small></td>
				<td></td><td></td><td></td><td></td>
			</tr>
			<tr>
				<td>90</td><td>PTC16/UART3_RX/ENET0_1588_TMR0/FB_CS5_b/FB_TSIZ1/FB_BE23_16_BLS15_8_b</td><td><small><i>same</i></small></td>
				<td></td><td></td><td></td><td></td>
			</tr>
			<tr>
				<td>91</td><td>PTC17/UART3_TX/ENET0_1588_TMR1/FB_CS4_b/FB_TSIZ0/FB_BE31_24_BLS7_0_b</td><td><small><i>same</i></small></td>
				<td></td><td></td><td></td><td></td>
			</tr>
			<tr>
				<td>92</td><td>PTC18/UART3_RTS_b/ENET0_1588_TMR2/FB_TBST_b/FB_CS2_b/FB_BE15_8_BLS23_16_b</td><td><small><i>same</i></small></td>
				<td></td><td></td><td></td><td></td>
			</tr>
			<tr>
				<td>93</td><td>PTD0/LLWU_P12/SPI0_PCS0/UART2_RTS_b/FTM3_CH0/FB_ALE/FB_CS1_b/FB_TS_b</td><td><small><i>same</i></small></td>
				<td></td><td></td><td></td><td></td>
			</tr>
			<tr>
				<td>94</td><td>ADC0_SE5b/PTD1/SPI0_SCK/UART2_CTS_b/FTM3_CH1/FB_CS0_b</td><td><small><i>same</i></small></td>
				<td bgcolor='#F8FF9A'>ADC0</td><td bgcolor='#F8FF9A'>adc_seb5</td><td bgcolor='#F8FF9A'>alt0</td><td bgcolor='#F8FF9A'>Input</td>
			</tr>
			<tr>
				<td>95</td><td>PTD2/LLWU_P13/SPI0_SOUT/UART2_RX/FTM3_CH2/FB_AD4/I2C0_SCL</td><td><small><i>same</i></small></td>
				<td></td><td></td><td></td><td></td>
			</tr>
			<tr>
				<td>96</td><td>PTD3/SPI0_SIN/UART2_TX/FTM3_CH3/FB_AD3/I2C0_SDA</td><td><small><i>same</i></small></td>
				<td></td><td></td><td></td><td></td>
			</tr>
			<tr>
				<td>97</td><td>PTD4/LLWU_P14/SPI0_PCS1/UART0_RTS_b/FTM0_CH4/FB_AD2/EWM_IN/SPI1_PCS0</td><td><small><i>same</i></small></td>
				<td></td><td></td><td></td><td></td>
			</tr>
			<tr>
				<td>98</td><td>ADC0_SE6b/PTD5/SPI0_PCS2/UART0_CTS_b/UART0_COL_b/FTM0_CH5/FB_AD1/EWM_OUT_b/SPI1_SCK</td><td><small><i>same</i></small></td>
				<td bgcolor='#F8FF9A'>ADC0</td><td bgcolor='#F8FF9A'>adc_seb6</td><td bgcolor='#F8FF9A'>alt0</td><td bgcolor='#F8FF9A'>Input</td>
			</tr>
			<tr>
				<td>99</td><td>ADC0_SE7b/PTD6/LLWU_P15/SPI0_PCS3/UART0_RX/FTM0_CH6/FB_AD0/FTM0_FLT0/SPI1_SOUT</td><td><small><i>same</i></small></td>
				<td bgcolor='#F8FF9A'>ADC0</td><td bgcolor='#F8FF9A'>adc_seb7</td><td bgcolor='#F8FF9A'>alt0</td><td bgcolor='#F8FF9A'>Input</td>
			</tr>
			<tr>
				<td>100</td><td>PTD7/CMT_IRO/UART0_TX/FTM0_CH7/FTM0_FLT1/SPI1_SIN</td><td><small><i>same</i></small></td>
				<td></td><td></td><td></td><td></td>
			</tr>
		</table>

		<h2 style='font-family: Arial;'>Routable Pins</h2>
		<table cellpadding='2' border='1' style='border: 2px solid #000000;' bgcolor='WHITE' width='100%' align='center'>
			<tr><td colspan='3'></td><th colspan='3' align='center' bgcolor='#D0D0D0'>alt0</th><th colspan='3' align='center' bgcolor='#D0D0D0'>alt1</th><th colspan='3' align='center' bgcolor='#D0D0D0'>alt2</th><th colspan='3' align='center' bgcolor='#D0D0D0'>alt3</th><th colspan='3' align='center' bgcolor='#D0D0D0'>alt4</th><th colspan='3' align='center' bgcolor='#D0D0D0'>alt5</th><th colspan='3' align='center' bgcolor='#D0D0D0'>alt6</th><th colspan='3' align='center' bgcolor='#D0D0D0'>alt7</th><th colspan='3' align='center' bgcolor='#D0D0D0'>ezport</th></tr>
			<tr>
				<th bgcolor='#E8E8E8'>Package Pin #</th><th bgcolor='#E8E8E8'>Pin Name</th><th bgcolor='#E8E8E8'>User Assigned Signal Name</th>
				<th bgcolor='#E8E8E8'>Peripheral</th><th bgcolor='#E8E8E8'>Function</th><th bgcolor='#E8E8E8'>Dir</th>
				<th bgcolor='#E8E8E8'>Peripheral</th><th bgcolor='#E8E8E8'>Function</th><th bgcolor='#E8E8E8'>Dir</th>
				<th bgcolor='#E8E8E8'>Peripheral</th><th bgcolor='#E8E8E8'>Function</th><th bgcolor='#E8E8E8'>Dir</th>
				<th bgcolor='#E8E8E8'>Peripheral</th><th bgcolor='#E8E8E8'>Function</th><th bgcolor='#E8E8E8'>Dir</th>
				<th bgcolor='#E8E8E8'>Peripheral</th><th bgcolor='#E8E8E8'>Function</th><th bgcolor='#E8E8E8'>Dir</th>
				<th bgcolor='#E8E8E8'>Peripheral</th><th bgcolor='#E8E8E8'>Function</th><th bgcolor='#E8E8E8'>Dir</th>
				<th bgcolor='#E8E8E8'>Peripheral</th><th bgcolor='#E8E8E8'>Function</th><th bgcolor='#E8E8E8'>Dir</th>
				<th bgcolor='#E8E8E8'>Peripheral</th><th bgcolor='#E8E8E8'>Function</th><th bgcolor='#E8E8E8'>Dir</th>
				<th bgcolor='#E8E8E8'>Peripheral</th><th bgcolor='#E8E8E8'>Function</th><th bgcolor='#E8E8E8'>Dir</th>
			</tr>
			<tr>
				<td>1</td><td>ADC1_SE4a/PTE0/SPI1_PCS1/UART1_TX/SDHC0_D1/TRACE_CLKOUT/I2C1_SDA/RTC_CLKOUT</td><td><small><i>same</i></small></td>
				<td bgcolor='#F8FF9A'>ADC1</td><td bgcolor='#F8FF9A'>adc_sea4</td><td bgcolor='#F8FF9A'>Input</td>
				<td bgcolor='#F7DCFF'>PTE</td><td bgcolor='#F7DCFF'>port0</td><td bgcolor='#F7DCFF'>Input, Output</td>
				<td bgcolor='#AFFF8E'>SPI1</td><td bgcolor='#AFFF8E'>spi_cs1</td><td bgcolor='#AFFF8E'>Output</td>
				<td bgcolor='#90EE67'>UART1</td><td bgcolor='#90EE67'>uart_tx</td><td bgcolor='#90EE67'>Output</td>
				<td bgcolor='#00CA3A'>SDHC</td><td bgcolor='#00CA3A'>sdhc_dat1</td><td bgcolor='#00CA3A'>Input/Output</td>
				<td bgcolor='#FFFFFF'>TPIU<br/>non-peripheral</td><td bgcolor='#FFFFFF'>tpiu_clk<br/>TRACE_CLKOUT</td><td bgcolor='#FFFFFF'>Output</td>
				<td bgcolor='#5FE356'>I2C1</td><td bgcolor='#5FE356'>i2c_sda</td><td bgcolor='#5FE356'>Input/Output</td>
				<td bgcolor='#CEFFFF'>RTC</td><td bgcolor='#CEFFFF'>rtc_clkout</td><td bgcolor='#CEFFFF'>Output</td>
				<td></td><td></td><td></td>
			</tr>
			<tr>
				<td>2</td><td>ADC1_SE5a/PTE1/LLWU_P0/SPI1_SOUT/UART1_RX/SDHC0_D0/TRACE_D3/I2C1_SCL/SPI1_SIN</td><td><small><i>same</i></small></td>
				<td bgcolor='#F8FF9A'>ADC1</td><td bgcolor='#F8FF9A'>adc_sea5</td><td bgcolor='#F8FF9A'>Input</td>
				<td bgcolor='#FFFFFF'>PTE<br/>LLWU</td><td bgcolor='#FFFFFF'>port1<br/>llwu_wakeup0</td><td bgcolor='#FFFFFF'>Input, Output</td>
				<td bgcolor='#AFFF8E'>SPI1</td><td bgcolor='#AFFF8E'>spi_txd</td><td bgcolor='#AFFF8E'>Output</td>
				<td bgcolor='#90EE67'>UART1</td><td bgcolor='#90EE67'>uart_rx</td><td bgcolor='#90EE67'>Input</td>
				<td bgcolor='#00CA3A'>SDHC</td><td bgcolor='#00CA3A'>sdhc_dat0</td><td bgcolor='#00CA3A'>Input/Output</td>
				<td bgcolor='#FFFFFF'>TPIU<br/>non-peripheral</td><td bgcolor='#FFFFFF'>tpiu_d3<br/>TRACE_D3</td><td bgcolor='#FFFFFF'>Output</td>
				<td bgcolor='#5FE356'>I2C1</td><td bgcolor='#5FE356'>i2c_sclk</td><td bgcolor='#5FE356'>Input/Output</td>
				<td bgcolor='#AFFF8E'>SPI1</td><td bgcolor='#AFFF8E'>spi_rxd</td><td bgcolor='#AFFF8E'>Input</td>
				<td></td><td></td><td></td>
			</tr>
			<tr>
				<td>3</td><td>ADC0_DP2/ADC1_SE6a/PTE2/LLWU_P1/SPI1_SCK/UART1_CTS_b/SDHC0_DCLK/TRACE_D2</td><td><small><i>same</i></small></td>
				<td bgcolor='#F8FF9A'>ADC0<br/>ADC0<br/>ADC1</td><td bgcolor='#F8FF9A'>adc_dp2<br/>adc_se2<br/>adc_sea6</td><td bgcolor='#F8FF9A'>Input</td>
				<td bgcolor='#FFFFFF'>PTE<br/>LLWU</td><td bgcolor='#FFFFFF'>port2<br/>llwu_wakeup1</td><td bgcolor='#FFFFFF'>Input, Output</td>
				<td bgcolor='#AFFF8E'>SPI1</td><td bgcolor='#AFFF8E'>spi_sck</td><td bgcolor='#AFFF8E'>Input, Output</td>
				<td bgcolor='#90EE67'>UART1</td><td bgcolor='#90EE67'>uart_cts</td><td bgcolor='#90EE67'>Input</td>
				<td bgcolor='#00CA3A'>SDHC</td><td bgcolor='#00CA3A'>sdhc_dclk</td><td bgcolor='#00CA3A'>Output</td>
				<td bgcolor='#FFFFFF'>TPIU<br/>non-peripheral</td><td bgcolor='#FFFFFF'>tpiu_d2<br/>TRACE_D2</td><td bgcolor='#FFFFFF'>Output</td>
				<td></td><td></td><td></td>
				<td></td><td></td><td></td>
				<td></td><td></td><td></td>
			</tr>
			<tr>
				<td>4</td><td>ADC0_DM2/ADC1_SE7a/PTE3/SPI1_SIN/UART1_RTS_b/SDHC0_CMD/TRACE_D1/SPI1_SOUT</td><td><small><i>same</i></small></td>
				<td bgcolor='#F8FF9A'>ADC0<br/>ADC1</td><td bgcolor='#F8FF9A'>adc_dm2<br/>adc_sea7</td><td bgcolor='#F8FF9A'>Input</td>
				<td bgcolor='#F7DCFF'>PTE</td><td bgcolor='#F7DCFF'>port3</td><td bgcolor='#F7DCFF'>Input, Output</td>
				<td bgcolor='#AFFF8E'>SPI1</td><td bgcolor='#AFFF8E'>spi_rxd</td><td bgcolor='#AFFF8E'>Input</td>
				<td bgcolor='#90EE67'>UART1</td><td bgcolor='#90EE67'>uart_rts</td><td bgcolor='#90EE67'>Output</td>
				<td bgcolor='#00CA3A'>SDHC</td><td bgcolor='#00CA3A'>sdhc_cmd</td><td bgcolor='#00CA3A'>Input/Output</td>
				<td bgcolor='#FFFFFF'>TPIU<br/>non-peripheral</td><td bgcolor='#FFFFFF'>tpiu_d1<br/>TRACE_D1</td><td bgcolor='#FFFFFF'>Output</td>
				<td></td><td></td><td></td>
				<td bgcolor='#AFFF8E'>SPI1</td><td bgcolor='#AFFF8E'>spi_txd</td><td bgcolor='#AFFF8E'>Output</td>
				<td></td><td></td><td></td>
			</tr>
			<tr>
				<td>5</td><td>PTE4/LLWU_P2/SPI1_PCS0/UART3_TX/SDHC0_D3/TRACE_D0</td><td><small><i>same</i></small></td>
				<td></td><td></td><td></td>
				<td bgcolor='#FFFFFF'>PTE<br/>LLWU</td><td bgcolor='#FFFFFF'>port4<br/>llwu_wakeup2</td><td bgcolor='#FFFFFF'>Input, Output</td>
				<td bgcolor='#AFFF8E'>SPI1</td><td bgcolor='#AFFF8E'>spi_cs0</td><td bgcolor='#AFFF8E'>Input, Output</td>
				<td bgcolor='#90EE67'>UART3</td><td bgcolor='#90EE67'>uart_tx</td><td bgcolor='#90EE67'>Output</td>
				<td bgcolor='#00CA3A'>SDHC</td><td bgcolor='#00CA3A'>sdhc_dat3</td><td bgcolor='#00CA3A'>Input/Output</td>
				<td bgcolor='#FFFFFF'>TPIU<br/>non-peripheral</td><td bgcolor='#FFFFFF'>tpiu_d0<br/>TRACE_D0</td><td bgcolor='#FFFFFF'>Output</td>
				<td></td><td></td><td></td>
				<td></td><td></td><td></td>
				<td></td><td></td><td></td>
			</tr>
			<tr>
				<td>6</td><td>PTE5/SPI1_PCS2/UART3_RX/SDHC0_D2/FTM3_CH0</td><td><small><i>same</i></small></td>
				<td></td><td></td><td></td>
				<td bgcolor='#F7DCFF'>PTE</td><td bgcolor='#F7DCFF'>port5</td><td bgcolor='#F7DCFF'>Input, Output</td>
				<td bgcolor='#AFFF8E'>SPI1</td><td bgcolor='#AFFF8E'>spi_cs2</td><td bgcolor='#AFFF8E'>Output</td>
				<td bgcolor='#90EE67'>UART3</td><td bgcolor='#90EE67'>uart_rx</td><td bgcolor='#90EE67'>Input</td>
				<td bgcolor='#00CA3A'>SDHC</td><td bgcolor='#00CA3A'>sdhc_dat2</td><td bgcolor='#00CA3A'>Input/Output</td>
				<td></td><td></td><td></td>
				<td bgcolor='#86DAFF'>FTM3</td><td bgcolor='#86DAFF'>tmr_ch0</td><td bgcolor='#86DAFF'>Input, Output</td>
				<td></td><td></td><td></td>
				<td></td><td></td><td></td>
			</tr>
			<tr>
				<td>7</td><td>PTE6/SPI1_PCS3/UART3_CTS_b/I2S0_MCLK/FTM3_CH1/USB_SOF_OUT</td><td><small><i>same</i></small></td>
				<td></td><td></td><td></td>
				<td bgcolor='#F7DCFF'>PTE</td><td bgcolor='#F7DCFF'>port6</td><td bgcolor='#F7DCFF'>Input, Output</td>
				<td bgcolor='#AFFF8E'>SPI1</td><td bgcolor='#AFFF8E'>spi_cs3</td><td bgcolor='#AFFF8E'>Output</td>
				<td bgcolor='#90EE67'>UART3</td><td bgcolor='#90EE67'>uart_cts</td><td bgcolor='#90EE67'>Input</td>
				<td bgcolor='#20E04E'>I2S0</td><td bgcolor='#20E04E'>i2s_mclk</td><td bgcolor='#20E04E'>Input, Output</td>
				<td></td><td></td><td></td>
				<td bgcolor='#86DAFF'>FTM3</td><td bgcolor='#86DAFF'>tmr_ch1</td><td bgcolor='#86DAFF'>Input, Output</td>
				<td bgcolor='#5FE356'>USB0</td><td bgcolor='#5FE356'>usb_sof</td><td bgcolor='#5FE356'>Output</td>
				<td></td><td></td><td></td>
			</tr>
			<tr>
				<td>8</td><td>VDD16</td><td><small><i>same</i></small></td>
				<td bgcolor='#F7DCFF'>SUPPLY</td><td bgcolor='#F7DCFF'>pwr_vdd1</td><td bgcolor='#F7DCFF'>Input</td>
				<td></td><td></td><td></td>
				<td></td><td></td><td></td>
				<td></td><td></td><td></td>
				<td></td><td></td><td></td>
				<td></td><td></td><td></td>
				<td></td><td></td><td></td>
				<td></td><td></td><td></td>
				<td></td><td></td><td></td>
			</tr>
			<tr>
				<td>9</td><td>VSS17</td><td><small><i>same</i></small></td>
				<td bgcolor='#F7DCFF'>SUPPLY</td><td bgcolor='#F7DCFF'>pwr_vss1</td><td bgcolor='#F7DCFF'>Input</td>
				<td></td><td></td><td></td>
				<td></td><td></td><td></td>
				<td></td><td></td><td></td>
				<td></td><td></td><td></td>
				<td></td><td></td><td></td>
				<td></td><td></td><td></td>
				<td></td><td></td><td></td>
				<td></td><td></td><td></td>
			</tr>
			<tr>
				<td>10</td><td>USB0_DP</td><td><small><i>same</i></small></td>
				<td bgcolor='#FFFFFF'>USB0<br/>USBDCD</td><td bgcolor='#FFFFFF'>usb_dp</td><td bgcolor='#FFFFFF'>Input/Output</td>
				<td></td><td></td><td></td>
				<td></td><td></td><td></td>
				<td></td><td></td><td></td>
				<td></td><td></td><td></td>
				<td></td><td></td><td></td>
				<td></td><td></td><td></td>
				<td></td><td></td><td></td>
				<td></td><td></td><td></td>
			</tr>
			<tr>
				<td>11</td><td>USB0_DM</td><td><small><i>same</i></small></td>
				<td bgcolor='#FFFFFF'>USB0<br/>USBDCD</td><td bgcolor='#FFFFFF'>usb_dm</td><td bgcolor='#FFFFFF'>Input/Output</td>
				<td></td><td></td><td></td>
				<td></td><td></td><td></td>
				<td></td><td></td><td></td>
				<td></td><td></td><td></td>
				<td></td><td></td><td></td>
				<td></td><td></td><td></td>
				<td></td><td></td><td></td>
				<td></td><td></td><td></td>
			</tr>
			<tr>
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
				<td bgcolor='#F7DCFF'>PTE</td><td bgcolor='#F7DCFF'>port24</td><td bgcolor='#F7DCFF'>Input, Output</td>
				<td></td><td></td><td></td>
				<td bgcolor='#90EE67'>UART4</td><td bgcolor='#90EE67'>uart_tx</td><td bgcolor='#90EE67'>Output</td>
				<td></td><td></td><td></td>
				<td bgcolor='#5FE356'>I2C0</td><td bgcolor='#5FE356'>i2c_sclk</td><td bgcolor='#5FE356'>Input/Output</td>
				<td bgcolor='#B3EAFF'>EWM</td><td bgcolor='#B3EAFF'>ewm_out</td><td bgcolor='#B3EAFF'>Output</td>
				<td></td><td></td><td></td>
				<td></td><td></td><td></td>
			</tr>
			<tr>
				<td>32</td><td>ADC0_SE18/PTE25/UART4_RX/I2C0_SDA/EWM_IN</td><td><small><i>same</i></small></td>
				<td bgcolor='#F8FF9A'>ADC0</td><td bgcolor='#F8FF9A'>adc_se18</td><td bgcolor='#F8FF9A'>Input</td>
				<td bgcolor='#F7DCFF'>PTE</td><td bgcolor='#F7DCFF'>port25</td><td bgcolor='#F7DCFF'>Input, Output</td>
				<td></td><td></td><td></td>
				<td bgcolor='#90EE67'>UART4</td><td bgcolor='#90EE67'>uart_rx</td><td bgcolor='#90EE67'>Input</td>
				<td></td><td></td><td></td>
				<td bgcolor='#5FE356'>I2C0</td><td bgcolor='#5FE356'>i2c_sda</td><td bgcolor='#5FE356'>Input/Output</td>
				<td bgcolor='#B3EAFF'>EWM</td><td bgcolor='#B3EAFF'>ewm_in</td><td bgcolor='#B3EAFF'>Input</td>
				<td></td><td></td><td></td>
				<td></td><td></td><td></td>
			</tr>
			<tr>
				<td>33</td><td>PTE26/ENET_1588_CLKIN/UART4_CTS_b/RTC_CLKOUT/USB_CLKIN</td><td><small><i>same</i></small></td>
				<td></td><td></td><td></td>
				<td bgcolor='#F7DCFF'>PTE</td><td bgcolor='#F7DCFF'>port26</td><td bgcolor='#F7DCFF'>Input, Output</td>
				<td></td><td></td><td></td>
				<td bgcolor='#90EE67'>UART4</td><td bgcolor='#90EE67'>uart_cts</td><td bgcolor='#90EE67'>Input</td>
				<td></td><td></td><td></td>
				<td></td><td></td><td></td>
				<td bgcolor='#CEFFFF'>RTC</td><td bgcolor='#CEFFFF'>rtc_clkout</td><td bgcolor='#CEFFFF'>Output</td>
				<td bgcolor='#5FE356'>USB0</td><td bgcolor='#5FE356'>usb_clkin</td><td bgcolor='#5FE356'>Input</td>
				<td></td><td></td><td></td>
			</tr>
			<tr>
				<td>34</td><td>PTA0/UART0_CTS_b/UART0_COL_b/FTM0_CH5/JTAG_TCLK/SWD_CLK/EZP_CLK</td><td><small><i>same</i></small></td>
				<td></td><td></td><td></td>
				<td bgcolor='#F7DCFF'>PTA</td><td bgcolor='#F7DCFF'>port0</td><td bgcolor='#F7DCFF'>Input, Output</td>
				<td bgcolor='#90EE67'>UART0</td><td bgcolor='#90EE67'>uart_cts<br/>uart_col</td><td bgcolor='#90EE67'>Input</td>
				<td bgcolor='#86DAFF'>FTM0</td><td bgcolor='#86DAFF'>tmr_ch5</td><td bgcolor='#86DAFF'>Input, Output</td>
				<td></td><td></td><td></td>
				<td></td><td></td><td></td>
				<td></td><td></td><td></td>
				<td bgcolor='#DDC7B5'>JTAG</td><td bgcolor='#DDC7B5'>jtag_clk</td><td bgcolor='#DDC7B5'>Input</td>
				<td></td><td></td><td></td>
			</tr>
			<tr>
				<td>35</td><td>PTA1/UART0_RX/FTM0_CH6/JTAG_TDI/EZP_DI</td><td><small><i>same</i></small></td>
				<td></td><td></td><td></td>
				<td bgcolor='#F7DCFF'>PTA</td><td bgcolor='#F7DCFF'>port1</td><td bgcolor='#F7DCFF'>Input, Output</td>
				<td bgcolor='#90EE67'>UART0</td><td bgcolor='#90EE67'>uart_rx</td><td bgcolor='#90EE67'>Input</td>
				<td bgcolor='#86DAFF'>FTM0</td><td bgcolor='#86DAFF'>tmr_ch6</td><td bgcolor='#86DAFF'>Input, Output</td>
				<td></td><td></td><td></td>
				<td></td><td></td><td></td>
				<td></td><td></td><td></td>
				<td bgcolor='#DDC7B5'>JTAG</td><td bgcolor='#DDC7B5'>jtag_di</td><td bgcolor='#DDC7B5'>Input</td>
				<td></td><td></td><td></td>
			</tr>
			<tr>
				<td>36</td><td>PTA2/UART0_TX/FTM0_CH7/JTAG_TDO/TRACE_SWO/EZP_DO</td><td><small><i>same</i></small></td>
				<td></td><td></td><td></td>
				<td bgcolor='#F7DCFF'>PTA</td><td bgcolor='#F7DCFF'>port2</td><td bgcolor='#F7DCFF'>Input, Output</td>
				<td bgcolor='#90EE67'>UART0</td><td bgcolor='#90EE67'>uart_tx</td><td bgcolor='#90EE67'>Output</td>
				<td bgcolor='#86DAFF'>FTM0</td><td bgcolor='#86DAFF'>tmr_ch7</td><td bgcolor='#86DAFF'>Input, Output</td>
				<td></td><td></td><td></td>
				<td></td><td></td><td></td>
				<td></td><td></td><td></td>
				<td bgcolor='#FFFFFF'>JTAG<br/>TPIU<br/>non-peripheral</td><td bgcolor='#FFFFFF'>jtag_do<br/>tpiu_swo<br/>TRACE_SWO</td><td bgcolor='#FFFFFF'>Output</td>
				<td></td><td></td><td></td>
			</tr>
			<tr>
				<td>37</td><td>PTA3/UART0_RTS_b/FTM0_CH0/JTAG_TMS/SWD_DIO</td><td><small><i>same</i></small></td>
				<td></td><td></td><td></td>
				<td bgcolor='#F7DCFF'>PTA</td><td bgcolor='#F7DCFF'>port3</td><td bgcolor='#F7DCFF'>Input, Output</td>
				<td bgcolor='#90EE67'>UART0</td><td bgcolor='#90EE67'>uart_rts</td><td bgcolor='#90EE67'>Output</td>
				<td bgcolor='#86DAFF'>FTM0</td><td bgcolor='#86DAFF'>tmr_ch0</td><td bgcolor='#86DAFF'>Input, Output</td>
				<td></td><td></td><td></td>
				<td></td><td></td><td></td>
				<td></td><td></td><td></td>
				<td bgcolor='#DDC7B5'>JTAG</td><td bgcolor='#DDC7B5'>jtag_ms</td><td bgcolor='#DDC7B5'>Input/Output</td>
				<td></td><td></td><td></td>
			</tr>
			<tr>
				<td>38</td><td>PTA4/LLWU_P3/FTM0_CH1/NMI_b/EZP_CS_b</td><td><small><i>same</i></small></td>
				<td></td><td></td><td></td>
				<td bgcolor='#FFFFFF'>PTA<br/>LLWU</td><td bgcolor='#FFFFFF'>port4<br/>llwu_wakeup3</td><td bgcolor='#FFFFFF'>Input, Output</td>
				<td></td><td></td><td></td>
				<td bgcolor='#86DAFF'>FTM0</td><td bgcolor='#86DAFF'>tmr_ch1</td><td bgcolor='#86DAFF'>Input, Output</td>
				<td></td><td></td><td></td>
				<td></td><td></td><td></td>
				<td></td><td></td><td></td>
				<td bgcolor='#FFFFFF'>SystemControl<br/>non-peripheral</td><td bgcolor='#FFFFFF'>scb_nmi<br/>NMI</td><td bgcolor='#FFFFFF'>Input</td>
				<td></td><td></td><td></td>
			</tr>
			<tr>
				<td>39</td><td>PTA5/USB_CLKIN/FTM0_CH2/RMII0_RXER/MII0_RXER/CMP2_OUT/I2S0_TX_BCLK/JTAG_TRST_b</td><td><small><i>same</i></small></td>
				<td></td><td></td><td></td>
				<td bgcolor='#F7DCFF'>PTA</td><td bgcolor='#F7DCFF'>port5</td><td bgcolor='#F7DCFF'>Input, Output</td>
				<td bgcolor='#5FE356'>USB0</td><td bgcolor='#5FE356'>usb_clkin</td><td bgcolor='#5FE356'>Input</td>
				<td bgcolor='#86DAFF'>FTM0</td><td bgcolor='#86DAFF'>tmr_ch2</td><td bgcolor='#86DAFF'>Input, Output</td>
				<td bgcolor='#90EE67'>ENET</td><td bgcolor='#90EE67'>rmii_rxer<br/>mii_rxer</td><td bgcolor='#90EE67'>Input</td>
				<td bgcolor='#EFF174'>CMP2</td><td bgcolor='#EFF174'>cmp_out</td><td bgcolor='#EFF174'>Output</td>
				<td bgcolor='#20E04E'>I2S0</td><td bgcolor='#20E04E'>i2s_tclk</td><td bgcolor='#20E04E'>Input, Output</td>
				<td bgcolor='#DDC7B5'>JTAG</td><td bgcolor='#DDC7B5'>jtag_rst</td><td bgcolor='#DDC7B5'>Input</td>
				<td></td><td></td><td></td>
			</tr>
			<tr>
				<td>40</td><td>VDD63</td><td><small><i>same</i></small></td>
				<td bgcolor='#F7DCFF'>SUPPLY</td><td bgcolor='#F7DCFF'>pwr_vdd3</td><td bgcolor='#F7DCFF'>Input</td>
				<td></td><td></td><td></td>
				<td></td><td></td><td></td>
				<td></td><td></td><td></td>
				<td></td><td></td><td></td>
				<td></td><td></td><td></td>
				<td></td><td></td><td></td>
				<td></td><td></td><td></td>
				<td></td><td></td><td></td>
			</tr>
			<tr>
				<td>41</td><td>VSS64</td><td><small><i>same</i></small></td>
				<td bgcolor='#F7DCFF'>SUPPLY</td><td bgcolor='#F7DCFF'>pwr_vss4</td><td bgcolor='#F7DCFF'>Input</td>
				<td></td><td></td><td></td>
				<td></td><td></td><td></td>
				<td></td><td></td><td></td>
				<td></td><td></td><td></td>
				<td></td><td></td><td></td>
				<td></td><td></td><td></td>
				<td></td><td></td><td></td>
				<td></td><td></td><td></td>
			</tr>
			<tr>
				<td>42</td><td>CMP2_IN0/PTA12/CAN0_TX/FTM1_CH0/RMII0_RXD1/MII0_RXD1/I2C2_SCL/I2S0_TXD0/FTM1_QD_PHA</td><td><small><i>same</i></small></td>
				<td bgcolor='#EFF174'>CMP2</td><td bgcolor='#EFF174'>cmp_pos0<br/>cmp_neg0<br/>cmp_in0</td><td bgcolor='#EFF174'>Input</td>
				<td bgcolor='#F7DCFF'>PTA</td><td bgcolor='#F7DCFF'>port12</td><td bgcolor='#F7DCFF'>Input, Output</td>
				<td bgcolor='#AFFF8E'>CAN0</td><td bgcolor='#AFFF8E'>can_txd</td><td bgcolor='#AFFF8E'>Output</td>
				<td bgcolor='#86DAFF'>FTM1</td><td bgcolor='#86DAFF'>tmr_ch0</td><td bgcolor='#86DAFF'>Input, Output</td>
				<td bgcolor='#90EE67'>ENET</td><td bgcolor='#90EE67'>rmii_rxd1<br/>mii_rxd1</td><td bgcolor='#90EE67'>Input</td>
				<td bgcolor='#5FE356'>I2C2</td><td bgcolor='#5FE356'>i2c_sclk</td><td bgcolor='#5FE356'>Input/Output</td>
				<td bgcolor='#20E04E'>I2S0</td><td bgcolor='#20E04E'>i2s_txd0</td><td bgcolor='#20E04E'>Output</td>
				<td bgcolor='#86DAFF'>FTM1</td><td bgcolor='#86DAFF'>tmr_qd_phA</td><td bgcolor='#86DAFF'>Input</td>
				<td></td><td></td><td></td>
			</tr>
			<tr>
				<td>43</td><td>CMP2_IN1/PTA13/LLWU_P4/CAN0_RX/FTM1_CH1/RMII0_RXD0/MII0_RXD0/I2C2_SDA/I2S0_TX_FS/FTM1_QD_PHB</td><td><small><i>same</i></small></td>
				<td bgcolor='#EFF174'>CMP2</td><td bgcolor='#EFF174'>cmp_pos1<br/>cmp_neg1<br/>cmp_in1</td><td bgcolor='#EFF174'>Input</td>
				<td bgcolor='#FFFFFF'>PTA<br/>LLWU</td><td bgcolor='#FFFFFF'>port13<br/>llwu_wakeup4</td><td bgcolor='#FFFFFF'>Input, Output</td>
				<td bgcolor='#AFFF8E'>CAN0</td><td bgcolor='#AFFF8E'>can_rxd</td><td bgcolor='#AFFF8E'>Input</td>
				<td bgcolor='#86DAFF'>FTM1</td><td bgcolor='#86DAFF'>tmr_ch1</td><td bgcolor='#86DAFF'>Input, Output</td>
				<td bgcolor='#90EE67'>ENET</td><td bgcolor='#90EE67'>rmii_rxd0<br/>mii_rxd0</td><td bgcolor='#90EE67'>Input</td>
				<td bgcolor='#5FE356'>I2C2</td><td bgcolor='#5FE356'>i2c_sda</td><td bgcolor='#5FE356'>Input/Output</td>
				<td bgcolor='#20E04E'>I2S0</td><td bgcolor='#20E04E'>i2s_tfs</td><td bgcolor='#20E04E'>Input, Output</td>
				<td bgcolor='#86DAFF'>FTM1</td><td bgcolor='#86DAFF'>tmr_qd_phB</td><td bgcolor='#86DAFF'>Input</td>
				<td></td><td></td><td></td>
			</tr>
			<tr>
				<td>44</td><td>PTA14/SPI0_PCS0/UART0_TX/RMII0_CRS_DV/MII0_RXDV/I2C2_SCL/I2S0_RX_BCLK/I2S0_TXD1</td><td><small><i>same</i></small></td>
				<td></td><td></td><td></td>
				<td bgcolor='#F7DCFF'>PTA</td><td bgcolor='#F7DCFF'>port14</td><td bgcolor='#F7DCFF'>Input, Output</td>
				<td bgcolor='#AFFF8E'>SPI0</td><td bgcolor='#AFFF8E'>spi_cs0</td><td bgcolor='#AFFF8E'>Input, Output</td>
				<td bgcolor='#90EE67'>UART0</td><td bgcolor='#90EE67'>uart_tx</td><td bgcolor='#90EE67'>Output</td>
				<td bgcolor='#90EE67'>ENET</td><td bgcolor='#90EE67'>rmii_crs_dv<br/>mii_rxdv</td><td bgcolor='#90EE67'>Input</td>
				<td bgcolor='#5FE356'>I2C2</td><td bgcolor='#5FE356'>i2c_sclk</td><td bgcolor='#5FE356'>Input/Output</td>
				<td bgcolor='#20E04E'>I2S0</td><td bgcolor='#20E04E'>i2s_rclk</td><td bgcolor='#20E04E'>Input, Output</td>
				<td bgcolor='#20E04E'>I2S0</td><td bgcolor='#20E04E'>i2s_txd1</td><td bgcolor='#20E04E'>Output</td>
				<td></td><td></td><td></td>
			</tr>
			<tr>
				<td>45</td><td>PTA15/SPI0_SCK/UART0_RX/RMII0_TXEN/MII0_TXEN/I2S0_RXD0</td><td><small><i>same</i></small></td>
				<td></td><td></td><td></td>
				<td bgcolor='#F7DCFF'>PTA</td><td bgcolor='#F7DCFF'>port15</td><td bgcolor='#F7DCFF'>Input, Output</td>
				<td bgcolor='#AFFF8E'>SPI0</td><td bgcolor='#AFFF8E'>spi_sck</td><td bgcolor='#AFFF8E'>Input, Output</td>
				<td bgcolor='#90EE67'>UART0</td><td bgcolor='#90EE67'>uart_rx</td><td bgcolor='#90EE67'>Input</td>
				<td bgcolor='#90EE67'>ENET</td><td bgcolor='#90EE67'>rmii_txen<br/>mii_txen</td><td bgcolor='#90EE67'>Output</td>
				<td></td><td></td><td></td>
				<td bgcolor='#20E04E'>I2S0</td><td bgcolor='#20E04E'>i2s_rxd0</td><td bgcolor='#20E04E'>Input</td>
				<td></td><td></td><td></td>
				<td></td><td></td><td></td>
			</tr>
			<tr>
				<td>46</td><td>PTA16/SPI0_SOUT/UART0_CTS_b/UART0_COL_b/RMII0_TXD0/MII0_TXD0/I2S0_RX_FS/I2S0_RXD1</td><td><small><i>same</i></small></td>
				<td></td><td></td><td></td>
				<td bgcolor='#F7DCFF'>PTA</td><td bgcolor='#F7DCFF'>port16</td><td bgcolor='#F7DCFF'>Input, Output</td>
				<td bgcolor='#AFFF8E'>SPI0</td><td bgcolor='#AFFF8E'>spi_txd</td><td bgcolor='#AFFF8E'>Output</td>
				<td bgcolor='#90EE67'>UART0</td><td bgcolor='#90EE67'>uart_cts<br/>uart_col</td><td bgcolor='#90EE67'>Input</td>
				<td bgcolor='#90EE67'>ENET</td><td bgcolor='#90EE67'>rmii_txd0<br/>mii_txd0</td><td bgcolor='#90EE67'>Output</td>
				<td></td><td></td><td></td>
				<td bgcolor='#20E04E'>I2S0</td><td bgcolor='#20E04E'>i2s_rfs</td><td bgcolor='#20E04E'>Input, Output</td>
				<td bgcolor='#20E04E'>I2S0</td><td bgcolor='#20E04E'>i2s_rxd1</td><td bgcolor='#20E04E'>Input</td>
				<td></td><td></td><td></td>
			</tr>
			<tr>
				<td>47</td><td>ADC1_SE17/PTA17/SPI0_SIN/UART0_RTS_b/RMII0_TXD1/MII0_TXD1/I2S0_MCLK</td><td><small><i>same</i></small></td>
				<td bgcolor='#F8FF9A'>ADC1</td><td bgcolor='#F8FF9A'>adc_se17</td><td bgcolor='#F8FF9A'>Input</td>
				<td bgcolor='#F7DCFF'>PTA</td><td bgcolor='#F7DCFF'>port17</td><td bgcolor='#F7DCFF'>Input, Output</td>
				<td bgcolor='#AFFF8E'>SPI0</td><td bgcolor='#AFFF8E'>spi_rxd</td><td bgcolor='#AFFF8E'>Input</td>
				<td bgcolor='#90EE67'>UART0</td><td bgcolor='#90EE67'>uart_rts</td><td bgcolor='#90EE67'>Output</td>
				<td bgcolor='#90EE67'>ENET</td><td bgcolor='#90EE67'>rmii_txd1<br/>mii_txd1</td><td bgcolor='#90EE67'>Output</td>
				<td></td><td></td><td></td>
				<td bgcolor='#20E04E'>I2S0</td><td bgcolor='#20E04E'>i2s_mclk</td><td bgcolor='#20E04E'>Input, Output</td>
				<td></td><td></td><td></td>
				<td></td><td></td><td></td>
			</tr>
			<tr>
				<td>48</td><td>VDD78</td><td><small><i>same</i></small></td>
				<td bgcolor='#F7DCFF'>SUPPLY</td><td bgcolor='#F7DCFF'>pwr_vdd4</td><td bgcolor='#F7DCFF'>Input</td>
				<td></td><td></td><td></td>
				<td></td><td></td><td></td>
				<td></td><td></td><td></td>
				<td></td><td></td><td></td>
				<td></td><td></td><td></td>
				<td></td><td></td><td></td>
				<td></td><td></td><td></td>
				<td></td><td></td><td></td>
			</tr>
			<tr>
				<td>49</td><td>VSS79</td><td><small><i>same</i></small></td>
				<td bgcolor='#F7DCFF'>SUPPLY</td><td bgcolor='#F7DCFF'>pwr_vss5</td><td bgcolor='#F7DCFF'>Input</td>
				<td></td><td></td><td></td>
				<td></td><td></td><td></td>
				<td></td><td></td><td></td>
				<td></td><td></td><td></td>
				<td></td><td></td><td></td>
				<td></td><td></td><td></td>
				<td></td><td></td><td></td>
				<td></td><td></td><td></td>
			</tr>
			<tr>
				<td>50</td><td>EXTAL0/PTA18/FTM0_FLT2/FTM_CLKIN0</td><td><small><i>same</i></small></td>
				<td bgcolor='#FFFFFF'>ENET<br/>OSC</td><td bgcolor='#FFFFFF'>rmii_clkin<br/>extal</td><td bgcolor='#FFFFFF'>Input</td>
				<td bgcolor='#F7DCFF'>PTA</td><td bgcolor='#F7DCFF'>port18</td><td bgcolor='#F7DCFF'>Input, Output</td>
				<td></td><td></td><td></td>
				<td bgcolor='#86DAFF'>FTM0</td><td bgcolor='#86DAFF'>tmr_fault2</td><td bgcolor='#86DAFF'>Input</td>
				<td bgcolor='#86DAFF'>FTM0<br/>FTM1<br/>FTM2<br/>FTM3</td><td bgcolor='#86DAFF'>tmr_clk</td><td bgcolor='#86DAFF'>Input</td>
				<td></td><td></td><td></td>
				<td></td><td></td><td></td>
				<td></td><td></td><td></td>
				<td></td><td></td><td></td>
			</tr>
			<tr>
				<td>51</td><td>XTAL0/PTA19/FTM1_FLT0/FTM_CLKIN1/LPTMR0_ALT1</td><td><small><i>same</i></small></td>
				<td bgcolor='#C7A886'>OSC</td><td bgcolor='#C7A886'>xtal</td><td bgcolor='#C7A886'>Output</td>
				<td bgcolor='#F7DCFF'>PTA</td><td bgcolor='#F7DCFF'>port19</td><td bgcolor='#F7DCFF'>Input, Output</td>
				<td></td><td></td><td></td>
				<td bgcolor='#86DAFF'>FTM1</td><td bgcolor='#86DAFF'>tmr_fault0<br/>tmr_trigger2</td><td bgcolor='#86DAFF'>Input</td>
				<td bgcolor='#86DAFF'>FTM0<br/>FTM1<br/>FTM2<br/>FTM3</td><td bgcolor='#86DAFF'>tmr_clk</td><td bgcolor='#86DAFF'>Input</td>
				<td></td><td></td><td></td>
				<td bgcolor='#58C7FF'>LPTMR0</td><td bgcolor='#58C7FF'>tmr_clk1</td><td bgcolor='#58C7FF'>Input</td>
				<td></td><td></td><td></td>
				<td></td><td></td><td></td>
			</tr>
			<tr>
				<td>52</td><td>RESET_b</td><td><small><i>same</i></small></td>
				<td bgcolor='#FFE1C7'>RCM</td><td bgcolor='#FFE1C7'>reset</td><td bgcolor='#FFE1C7'>Input</td>
				<td></td><td></td><td></td>
				<td></td><td></td><td></td>
				<td></td><td></td><td></td>
				<td></td><td></td><td></td>
				<td></td><td></td><td></td>
				<td></td><td></td><td></td>
				<td></td><td></td><td></td>
				<td></td><td></td><td></td>
			</tr>
			<tr>
				<td>53</td><td>ADC0_SE8/ADC1_SE8/PTB0/LLWU_P5/I2C0_SCL/FTM1_CH0/RMII0_MDIO/MII0_MDIO/FTM1_QD_PHA</td><td><small><i>same</i></small></td>
				<td bgcolor='#F8FF9A'>ADC0<br/>ADC1</td><td bgcolor='#F8FF9A'>adc_se8</td><td bgcolor='#F8FF9A'>Input</td>
				<td bgcolor='#FFFFFF'>PTB<br/>LLWU</td><td bgcolor='#FFFFFF'>port0<br/>llwu_wakeup5</td><td bgcolor='#FFFFFF'>Input, Output</td>
				<td bgcolor='#5FE356'>I2C0</td><td bgcolor='#5FE356'>i2c_sclk</td><td bgcolor='#5FE356'>Input/Output</td>
				<td bgcolor='#86DAFF'>FTM1</td><td bgcolor='#86DAFF'>tmr_ch0</td><td bgcolor='#86DAFF'>Input, Output</td>
				<td bgcolor='#90EE67'>ENET</td><td bgcolor='#90EE67'>rmii_mdio<br/>mii_mdio</td><td bgcolor='#90EE67'>Input/Output</td>
				<td></td><td></td><td></td>
				<td bgcolor='#86DAFF'>FTM1</td><td bgcolor='#86DAFF'>tmr_qd_phA</td><td bgcolor='#86DAFF'>Input</td>
				<td></td><td></td><td></td>
				<td></td><td></td><td></td>
			</tr>
			<tr>
				<td>54</td><td>ADC0_SE9/ADC1_SE9/PTB1/I2C0_SDA/FTM1_CH1/RMII0_MDC/MII0_MDC/FTM1_QD_PHB</td><td><small><i>same</i></small></td>
				<td bgcolor='#F8FF9A'>ADC0<br/>ADC1</td><td bgcolor='#F8FF9A'>adc_se9</td><td bgcolor='#F8FF9A'>Input</td>
				<td bgcolor='#F7DCFF'>PTB</td><td bgcolor='#F7DCFF'>port1</td><td bgcolor='#F7DCFF'>Input, Output</td>
				<td bgcolor='#5FE356'>I2C0</td><td bgcolor='#5FE356'>i2c_sda</td><td bgcolor='#5FE356'>Input/Output</td>
				<td bgcolor='#86DAFF'>FTM1</td><td bgcolor='#86DAFF'>tmr_ch1</td><td bgcolor='#86DAFF'>Input, Output</td>
				<td bgcolor='#90EE67'>ENET</td><td bgcolor='#90EE67'>rmii_mdc<br/>mii_mdc</td><td bgcolor='#90EE67'>Output</td>
				<td></td><td></td><td></td>
				<td bgcolor='#86DAFF'>FTM1</td><td bgcolor='#86DAFF'>tmr_qd_phB</td><td bgcolor='#86DAFF'>Input</td>
				<td></td><td></td><td></td>
				<td></td><td></td><td></td>
			</tr>
			<tr>
				<td>55</td><td>ADC0_SE12/PTB2/I2C0_SCL/UART0_RTS_b/ENET0_1588_TMR0/FTM0_FLT3</td><td><small><i>same</i></small></td>
				<td bgcolor='#F8FF9A'>ADC0</td><td bgcolor='#F8FF9A'>adc_se12</td><td bgcolor='#F8FF9A'>Input</td>
				<td bgcolor='#F7DCFF'>PTB</td><td bgcolor='#F7DCFF'>port2</td><td bgcolor='#F7DCFF'>Input, Output</td>
				<td bgcolor='#5FE356'>I2C0</td><td bgcolor='#5FE356'>i2c_sclk</td><td bgcolor='#5FE356'>Input/Output</td>
				<td bgcolor='#90EE67'>UART0</td><td bgcolor='#90EE67'>uart_rts</td><td bgcolor='#90EE67'>Output</td>
				<td bgcolor='#90EE67'>ENET</td><td bgcolor='#90EE67'>enet_1588_tmr0</td><td bgcolor='#90EE67'>Input, Output</td>
				<td></td><td></td><td></td>
				<td bgcolor='#86DAFF'>FTM0</td><td bgcolor='#86DAFF'>tmr_fault3</td><td bgcolor='#86DAFF'>Input</td>
				<td></td><td></td><td></td>
				<td></td><td></td><td></td>
			</tr>
			<tr>
				<td>56</td><td>ADC0_SE13/PTB3/I2C0_SDA/UART0_CTS_b/UART0_COL_b/ENET0_1588_TMR1/FTM0_FLT0</td><td><small><i>same</i></small></td>
				<td bgcolor='#F8FF9A'>ADC0</td><td bgcolor='#F8FF9A'>adc_se13</td><td bgcolor='#F8FF9A'>Input</td>
				<td bgcolor='#F7DCFF'>PTB</td><td bgcolor='#F7DCFF'>port3</td><td bgcolor='#F7DCFF'>Input, Output</td>
				<td bgcolor='#5FE356'>I2C0</td><td bgcolor='#5FE356'>i2c_sda</td><td bgcolor='#5FE356'>Input/Output</td>
				<td bgcolor='#90EE67'>UART0</td><td bgcolor='#90EE67'>uart_cts<br/>uart_col</td><td bgcolor='#90EE67'>Input</td>
				<td bgcolor='#90EE67'>ENET</td><td bgcolor='#90EE67'>enet_1588_tmr1</td><td bgcolor='#90EE67'>Input, Output</td>
				<td></td><td></td><td></td>
				<td bgcolor='#86DAFF'>FTM0</td><td bgcolor='#86DAFF'>tmr_fault0<br/>tmr_trigger2</td><td bgcolor='#86DAFF'>Input</td>
				<td></td><td></td><td></td>
				<td></td><td></td><td></td>
			</tr>
			<tr>
				<td>57</td><td>PTB9/SPI1_PCS1/UART3_CTS_b/FB_AD20</td><td><small><i>same</i></small></td>
				<td></td><td></td><td></td>
				<td bgcolor='#F7DCFF'>PTB</td><td bgcolor='#F7DCFF'>port9</td><td bgcolor='#F7DCFF'>Input, Output</td>
				<td bgcolor='#AFFF8E'>SPI1</td><td bgcolor='#AFFF8E'>spi_cs1</td><td bgcolor='#AFFF8E'>Output</td>
				<td bgcolor='#90EE67'>UART3</td><td bgcolor='#90EE67'>uart_cts</td><td bgcolor='#90EE67'>Input</td>
				<td></td><td></td><td></td>
				<td bgcolor='#EBD4BD'>FB</td><td bgcolor='#EBD4BD'>fb_ad20</td><td bgcolor='#EBD4BD'>Input/Output</td>
				<td></td><td></td><td></td>
				<td></td><td></td><td></td>
				<td></td><td></td><td></td>
			</tr>
			<tr>
				<td>58</td><td>ADC1_SE14/PTB10/SPI1_PCS0/UART3_RX/FB_AD19/FTM0_FLT1</td><td><small><i>same</i></small></td>
				<td bgcolor='#F8FF9A'>ADC1</td><td bgcolor='#F8FF9A'>adc_se14</td><td bgcolor='#F8FF9A'>Input</td>
				<td bgcolor='#F7DCFF'>PTB</td><td bgcolor='#F7DCFF'>port10</td><td bgcolor='#F7DCFF'>Input, Output</td>
				<td bgcolor='#AFFF8E'>SPI1</td><td bgcolor='#AFFF8E'>spi_cs0</td><td bgcolor='#AFFF8E'>Input, Output</td>
				<td bgcolor='#90EE67'>UART3</td><td bgcolor='#90EE67'>uart_rx</td><td bgcolor='#90EE67'>Input</td>
				<td></td><td></td><td></td>
				<td bgcolor='#EBD4BD'>FB</td><td bgcolor='#EBD4BD'>fb_ad19</td><td bgcolor='#EBD4BD'>Input/Output</td>
				<td bgcolor='#86DAFF'>FTM0</td><td bgcolor='#86DAFF'>tmr_fault1</td><td bgcolor='#86DAFF'>Input</td>
				<td></td><td></td><td></td>
				<td></td><td></td><td></td>
			</tr>
			<tr>
				<td>59</td><td>ADC1_SE15/PTB11/SPI1_SCK/UART3_TX/FB_AD18/FTM0_FLT2</td><td><small><i>same</i></small></td>
				<td bgcolor='#F8FF9A'>ADC1</td><td bgcolor='#F8FF9A'>adc_se15</td><td bgcolor='#F8FF9A'>Input</td>
				<td bgcolor='#F7DCFF'>PTB</td><td bgcolor='#F7DCFF'>port11</td><td bgcolor='#F7DCFF'>Input, Output</td>
				<td bgcolor='#AFFF8E'>SPI1</td><td bgcolor='#AFFF8E'>spi_sck</td><td bgcolor='#AFFF8E'>Input, Output</td>
				<td bgcolor='#90EE67'>UART3</td><td bgcolor='#90EE67'>uart_tx</td><td bgcolor='#90EE67'>Output</td>
				<td></td><td></td><td></td>
				<td bgcolor='#EBD4BD'>FB</td><td bgcolor='#EBD4BD'>fb_ad18</td><td bgcolor='#EBD4BD'>Input/Output</td>
				<td bgcolor='#86DAFF'>FTM0</td><td bgcolor='#86DAFF'>tmr_fault2</td><td bgcolor='#86DAFF'>Input</td>
				<td></td><td></td><td></td>
				<td></td><td></td><td></td>
			</tr>
			<tr>
				<td>60</td><td>VSS103</td><td><small><i>same</i></small></td>
				<td bgcolor='#F7DCFF'>SUPPLY</td><td bgcolor='#F7DCFF'>pwr_vss6</td><td bgcolor='#F7DCFF'>Input</td>
				<td></td><td></td><td></td>
				<td></td><td></td><td></td>
				<td></td><td></td><td></td>
				<td></td><td></td><td></td>
				<td></td><td></td><td></td>
				<td></td><td></td><td></td>
				<td></td><td></td><td></td>
				<td></td><td></td><td></td>
			</tr>
			<tr>
				<td>61</td><td>VDD104</td><td><small><i>same</i></small></td>
				<td bgcolor='#F7DCFF'>SUPPLY</td><td bgcolor='#F7DCFF'>pwr_vdd5</td><td bgcolor='#F7DCFF'>Input</td>
				<td></td><td></td><td></td>
				<td></td><td></td><td></td>
				<td></td><td></td><td></td>
				<td></td><td></td><td></td>
				<td></td><td></td><td></td>
				<td></td><td></td><td></td>
				<td></td><td></td><td></td>
				<td></td><td></td><td></td>
			</tr>
			<tr>
				<td>62</td><td>PTB16/SPI1_SOUT/UART0_RX/FTM_CLKIN0/FB_AD17/EWM_IN</td><td><small><i>same</i></small></td>
				<td></td><td></td><td></td>
				<td bgcolor='#F7DCFF'>PTB</td><td bgcolor='#F7DCFF'>port16</td><td bgcolor='#F7DCFF'>Input, Output</td>
				<td bgcolor='#AFFF8E'>SPI1</td><td bgcolor='#AFFF8E'>spi_txd</td><td bgcolor='#AFFF8E'>Output</td>
				<td bgcolor='#90EE67'>UART0</td><td bgcolor='#90EE67'>uart_rx</td><td bgcolor='#90EE67'>Input</td>
				<td bgcolor='#86DAFF'>FTM0<br/>FTM1<br/>FTM2<br/>FTM3</td><td bgcolor='#86DAFF'>tmr_clk</td><td bgcolor='#86DAFF'>Input</td>
				<td bgcolor='#EBD4BD'>FB</td><td bgcolor='#EBD4BD'>fb_ad17</td><td bgcolor='#EBD4BD'>Input/Output</td>
				<td bgcolor='#B3EAFF'>EWM</td><td bgcolor='#B3EAFF'>ewm_in</td><td bgcolor='#B3EAFF'>Input</td>
				<td></td><td></td><td></td>
				<td></td><td></td><td></td>
			</tr>
			<tr>
				<td>63</td><td>PTB17/SPI1_SIN/UART0_TX/FTM_CLKIN1/FB_AD16/EWM_OUT_b</td><td><small><i>same</i></small></td>
				<td></td><td></td><td></td>
				<td bgcolor='#F7DCFF'>PTB</td><td bgcolor='#F7DCFF'>port17</td><td bgcolor='#F7DCFF'>Input, Output</td>
				<td bgcolor='#AFFF8E'>SPI1</td><td bgcolor='#AFFF8E'>spi_rxd</td><td bgcolor='#AFFF8E'>Input</td>
				<td bgcolor='#90EE67'>UART0</td><td bgcolor='#90EE67'>uart_tx</td><td bgcolor='#90EE67'>Output</td>
				<td bgcolor='#86DAFF'>FTM0<br/>FTM1<br/>FTM2<br/>FTM3</td><td bgcolor='#86DAFF'>tmr_clk</td><td bgcolor='#86DAFF'>Input</td>
				<td bgcolor='#EBD4BD'>FB</td><td bgcolor='#EBD4BD'>fb_ad16</td><td bgcolor='#EBD4BD'>Input/Output</td>
				<td bgcolor='#B3EAFF'>EWM</td><td bgcolor='#B3EAFF'>ewm_out</td><td bgcolor='#B3EAFF'>Output</td>
				<td></td><td></td><td></td>
				<td></td><td></td><td></td>
			</tr>
			<tr>
				<td>64</td><td>PTB18/CAN0_TX/FTM2_CH0/I2S0_TX_BCLK/FB_AD15/FTM2_QD_PHA</td><td><small><i>same</i></small></td>
				<td></td><td></td><td></td>
				<td bgcolor='#F7DCFF'>PTB</td><td bgcolor='#F7DCFF'>port18</td><td bgcolor='#F7DCFF'>Input, Output</td>
				<td bgcolor='#AFFF8E'>CAN0</td><td bgcolor='#AFFF8E'>can_txd</td><td bgcolor='#AFFF8E'>Output</td>
				<td bgcolor='#86DAFF'>FTM2</td><td bgcolor='#86DAFF'>tmr_ch0</td><td bgcolor='#86DAFF'>Input, Output</td>
				<td bgcolor='#20E04E'>I2S0</td><td bgcolor='#20E04E'>i2s_tclk</td><td bgcolor='#20E04E'>Input, Output</td>
				<td bgcolor='#EBD4BD'>FB</td><td bgcolor='#EBD4BD'>fb_ad15</td><td bgcolor='#EBD4BD'>Input/Output</td>
				<td bgcolor='#86DAFF'>FTM2</td><td bgcolor='#86DAFF'>tmr_qd_phA</td><td bgcolor='#86DAFF'>Input</td>
				<td></td><td></td><td></td>
				<td></td><td></td><td></td>
			</tr>
			<tr>
				<td>65</td><td>PTB19/CAN0_RX/FTM2_CH1/I2S0_TX_FS/FB_OE_b/FTM2_QD_PHB</td><td><small><i>same</i></small></td>
				<td></td><td></td><td></td>
				<td bgcolor='#F7DCFF'>PTB</td><td bgcolor='#F7DCFF'>port19</td><td bgcolor='#F7DCFF'>Input, Output</td>
				<td bgcolor='#AFFF8E'>CAN0</td><td bgcolor='#AFFF8E'>can_rxd</td><td bgcolor='#AFFF8E'>Input</td>
				<td bgcolor='#86DAFF'>FTM2</td><td bgcolor='#86DAFF'>tmr_ch1</td><td bgcolor='#86DAFF'>Input, Output</td>
				<td bgcolor='#20E04E'>I2S0</td><td bgcolor='#20E04E'>i2s_tfs</td><td bgcolor='#20E04E'>Input, Output</td>
				<td bgcolor='#EBD4BD'>FB</td><td bgcolor='#EBD4BD'>fb_oe</td><td bgcolor='#EBD4BD'>Output</td>
				<td bgcolor='#86DAFF'>FTM2</td><td bgcolor='#86DAFF'>tmr_qd_phB</td><td bgcolor='#86DAFF'>Input</td>
				<td></td><td></td><td></td>
				<td></td><td></td><td></td>
			</tr>
			<tr>
				<td>66</td><td>PTB20/SPI2_PCS0/FB_AD31/CMP0_OUT</td><td><small><i>same</i></small></td>
				<td></td><td></td><td></td>
				<td bgcolor='#F7DCFF'>PTB</td><td bgcolor='#F7DCFF'>port20</td><td bgcolor='#F7DCFF'>Input, Output</td>
				<td bgcolor='#AFFF8E'>SPI2</td><td bgcolor='#AFFF8E'>spi_cs0</td><td bgcolor='#AFFF8E'>Input, Output</td>
				<td></td><td></td><td></td>
				<td></td><td></td><td></td>
				<td bgcolor='#EBD4BD'>FB</td><td bgcolor='#EBD4BD'>fb_ad31</td><td bgcolor='#EBD4BD'>Input/Output</td>
				<td bgcolor='#EFF174'>CMP0</td><td bgcolor='#EFF174'>cmp_out</td><td bgcolor='#EFF174'>Output</td>
				<td></td><td></td><td></td>
				<td></td><td></td><td></td>
			</tr>
			<tr>
				<td>67</td><td>PTB21/SPI2_SCK/FB_AD30/CMP1_OUT</td><td><small><i>same</i></small></td>
				<td></td><td></td><td></td>
				<td bgcolor='#F7DCFF'>PTB</td><td bgcolor='#F7DCFF'>port21</td><td bgcolor='#F7DCFF'>Input, Output</td>
				<td bgcolor='#AFFF8E'>SPI2</td><td bgcolor='#AFFF8E'>spi_sck</td><td bgcolor='#AFFF8E'>Input, Output</td>
				<td></td><td></td><td></td>
				<td></td><td></td><td></td>
				<td bgcolor='#EBD4BD'>FB</td><td bgcolor='#EBD4BD'>fb_ad30</td><td bgcolor='#EBD4BD'>Input/Output</td>
				<td bgcolor='#EFF174'>CMP1</td><td bgcolor='#EFF174'>cmp_out</td><td bgcolor='#EFF174'>Output</td>
				<td></td><td></td><td></td>
				<td></td><td></td><td></td>
			</tr>
			<tr>
				<td>68</td><td>PTB22/SPI2_SOUT/FB_AD29/CMP2_OUT</td><td><small><i>same</i></small></td>
				<td></td><td></td><td></td>
				<td bgcolor='#F7DCFF'>PTB</td><td bgcolor='#F7DCFF'>port22</td><td bgcolor='#F7DCFF'>Input, Output</td>
				<td bgcolor='#AFFF8E'>SPI2</td><td bgcolor='#AFFF8E'>spi_txd</td><td bgcolor='#AFFF8E'>Output</td>
				<td></td><td></td><td></td>
				<td></td><td></td><td></td>
				<td bgcolor='#EBD4BD'>FB</td><td bgcolor='#EBD4BD'>fb_ad29</td><td bgcolor='#EBD4BD'>Input/Output</td>
				<td bgcolor='#EFF174'>CMP2</td><td bgcolor='#EFF174'>cmp_out</td><td bgcolor='#EFF174'>Output</td>
				<td></td><td></td><td></td>
				<td></td><td></td><td></td>
			</tr>
			<tr>
				<td>69</td><td>PTB23/SPI2_SIN/SPI0_PCS5/FB_AD28</td><td><small><i>same</i></small></td>
				<td></td><td></td><td></td>
				<td bgcolor='#F7DCFF'>PTB</td><td bgcolor='#F7DCFF'>port23</td><td bgcolor='#F7DCFF'>Input, Output</td>
				<td bgcolor='#AFFF8E'>SPI2</td><td bgcolor='#AFFF8E'>spi_rxd</td><td bgcolor='#AFFF8E'>Input</td>
				<td bgcolor='#AFFF8E'>SPI0</td><td bgcolor='#AFFF8E'>spi_cs5<br/>spi_css</td><td bgcolor='#AFFF8E'>Output</td>
				<td></td><td></td><td></td>
				<td bgcolor='#EBD4BD'>FB</td><td bgcolor='#EBD4BD'>fb_ad28</td><td bgcolor='#EBD4BD'>Input/Output</td>
				<td></td><td></td><td></td>
				<td></td><td></td><td></td>
				<td></td><td></td><td></td>
			</tr>
			<tr>
				<td>70</td><td>ADC0_SE14/PTC0/SPI0_PCS4/PDB0_EXTRG/USB_SOF_OUT/FB_AD14/I2S0_TXD1</td><td><small><i>same</i></small></td>
				<td bgcolor='#F8FF9A'>ADC0</td><td bgcolor='#F8FF9A'>adc_se14</td><td bgcolor='#F8FF9A'>Input</td>
				<td bgcolor='#F7DCFF'>PTC</td><td bgcolor='#F7DCFF'>port0</td><td bgcolor='#F7DCFF'>Input, Output</td>
				<td bgcolor='#AFFF8E'>SPI0</td><td bgcolor='#AFFF8E'>spi_cs4</td><td bgcolor='#AFFF8E'>Output</td>
				<td bgcolor='#14AFFF'>PDB0</td><td bgcolor='#14AFFF'>pdb_trigger<br/>pdb_ext_trig</td><td bgcolor='#14AFFF'>Input</td>
				<td bgcolor='#5FE356'>USB0</td><td bgcolor='#5FE356'>usb_sof</td><td bgcolor='#5FE356'>Output</td>
				<td bgcolor='#EBD4BD'>FB</td><td bgcolor='#EBD4BD'>fb_ad14</td><td bgcolor='#EBD4BD'>Input/Output</td>
				<td bgcolor='#20E04E'>I2S0</td><td bgcolor='#20E04E'>i2s_txd1</td><td bgcolor='#20E04E'>Output</td>
				<td></td><td></td><td></td>
				<td></td><td></td><td></td>
			</tr>
			<tr>
				<td>71</td><td>ADC0_SE15/PTC1/LLWU_P6/SPI0_PCS3/UART1_RTS_b/FTM0_CH0/FB_AD13/I2S0_TXD0</td><td><small><i>same</i></small></td>
				<td bgcolor='#F8FF9A'>ADC0</td><td bgcolor='#F8FF9A'>adc_se15</td><td bgcolor='#F8FF9A'>Input</td>
				<td bgcolor='#FFFFFF'>PTC<br/>LLWU</td><td bgcolor='#FFFFFF'>port1<br/>llwu_wakeup6</td><td bgcolor='#FFFFFF'>Input, Output</td>
				<td bgcolor='#AFFF8E'>SPI0</td><td bgcolor='#AFFF8E'>spi_cs3</td><td bgcolor='#AFFF8E'>Output</td>
				<td bgcolor='#90EE67'>UART1</td><td bgcolor='#90EE67'>uart_rts</td><td bgcolor='#90EE67'>Output</td>
				<td bgcolor='#86DAFF'>FTM0</td><td bgcolor='#86DAFF'>tmr_ch0</td><td bgcolor='#86DAFF'>Input, Output</td>
				<td bgcolor='#EBD4BD'>FB</td><td bgcolor='#EBD4BD'>fb_ad13</td><td bgcolor='#EBD4BD'>Input/Output</td>
				<td bgcolor='#20E04E'>I2S0</td><td bgcolor='#20E04E'>i2s_txd0</td><td bgcolor='#20E04E'>Output</td>
				<td></td><td></td><td></td>
				<td></td><td></td><td></td>
			</tr>
			<tr>
				<td>72</td><td>ADC0_SE4b/CMP1_IN0/PTC2/SPI0_PCS2/UART1_CTS_b/FTM0_CH1/FB_AD12/I2S0_TX_FS</td><td><small><i>same</i></small></td>
				<td bgcolor='#FFFFFF'>ADC0<br/>CMP1<br/>CMP1<br/>CMP1</td><td bgcolor='#FFFFFF'>adc_seb4<br/>cmp_pos0<br/>cmp_neg0<br/>cmp_in0</td><td bgcolor='#FFFFFF'>Input</td>
				<td bgcolor='#F7DCFF'>PTC</td><td bgcolor='#F7DCFF'>port2</td><td bgcolor='#F7DCFF'>Input, Output</td>
				<td bgcolor='#AFFF8E'>SPI0</td><td bgcolor='#AFFF8E'>spi_cs2</td><td bgcolor='#AFFF8E'>Output</td>
				<td bgcolor='#90EE67'>UART1</td><td bgcolor='#90EE67'>uart_cts</td><td bgcolor='#90EE67'>Input</td>
				<td bgcolor='#86DAFF'>FTM0</td><td bgcolor='#86DAFF'>tmr_ch1</td><td bgcolor='#86DAFF'>Input, Output</td>
				<td bgcolor='#EBD4BD'>FB</td><td bgcolor='#EBD4BD'>fb_ad12</td><td bgcolor='#EBD4BD'>Input/Output</td>
				<td bgcolor='#20E04E'>I2S0</td><td bgcolor='#20E04E'>i2s_tfs</td><td bgcolor='#20E04E'>Input, Output</td>
				<td></td><td></td><td></td>
				<td></td><td></td><td></td>
			</tr>
			<tr>
				<td>73</td><td>CMP1_IN1/PTC3/LLWU_P7/SPI0_PCS1/UART1_RX/FTM0_CH2/CLKOUT/I2S0_TX_BCLK</td><td><small><i>same</i></small></td>
				<td bgcolor='#EFF174'>CMP1</td><td bgcolor='#EFF174'>cmp_pos1<br/>cmp_neg1<br/>cmp_in1</td><td bgcolor='#EFF174'>Input</td>
				<td bgcolor='#FFFFFF'>PTC<br/>LLWU</td><td bgcolor='#FFFFFF'>port3<br/>llwu_wakeup7</td><td bgcolor='#FFFFFF'>Input, Output</td>
				<td bgcolor='#AFFF8E'>SPI0</td><td bgcolor='#AFFF8E'>spi_cs1</td><td bgcolor='#AFFF8E'>Output</td>
				<td bgcolor='#90EE67'>UART1</td><td bgcolor='#90EE67'>uart_rx</td><td bgcolor='#90EE67'>Input</td>
				<td bgcolor='#86DAFF'>FTM0</td><td bgcolor='#86DAFF'>tmr_ch2</td><td bgcolor='#86DAFF'>Input, Output</td>
				<td bgcolor='#FFFFFF'>FB<br/>SIM</td><td bgcolor='#FFFFFF'>fb_clk<br/>ClockOutput0</td><td bgcolor='#FFFFFF'>Output</td>
				<td bgcolor='#20E04E'>I2S0</td><td bgcolor='#20E04E'>i2s_tclk</td><td bgcolor='#20E04E'>Input, Output</td>
				<td></td><td></td><td></td>
				<td></td><td></td><td></td>
			</tr>
			<tr>
				<td>74</td><td>VSS117</td><td><small><i>same</i></small></td>
				<td bgcolor='#F7DCFF'>SUPPLY</td><td bgcolor='#F7DCFF'>pwr_vss7</td><td bgcolor='#F7DCFF'>Input</td>
				<td></td><td></td><td></td>
				<td></td><td></td><td></td>
				<td></td><td></td><td></td>
				<td></td><td></td><td></td>
				<td></td><td></td><td></td>
				<td></td><td></td><td></td>
				<td></td><td></td><td></td>
				<td></td><td></td><td></td>
			</tr>
			<tr>
				<td>75</td><td>VDD118</td><td><small><i>same</i></small></td>
				<td bgcolor='#F7DCFF'>SUPPLY</td><td bgcolor='#F7DCFF'>pwr_vdd6</td><td bgcolor='#F7DCFF'>Input</td>
				<td></td><td></td><td></td>
				<td></td><td></td><td></td>
				<td></td><td></td><td></td>
				<td></td><td></td><td></td>
				<td></td><td></td><td></td>
				<td></td><td></td><td></td>
				<td></td><td></td><td></td>
				<td></td><td></td><td></td>
			</tr>
			<tr>
				<td>76</td><td>PTC4/LLWU_P8/SPI0_PCS0/UART1_TX/FTM0_CH3/FB_AD11/CMP1_OUT</td><td><small><i>same</i></small></td>
				<td></td><td></td><td></td>
				<td bgcolor='#FFFFFF'>PTC<br/>LLWU</td><td bgcolor='#FFFFFF'>port4<br/>llwu_wakeup8</td><td bgcolor='#FFFFFF'>Input, Output</td>
				<td bgcolor='#AFFF8E'>SPI0</td><td bgcolor='#AFFF8E'>spi_cs0</td><td bgcolor='#AFFF8E'>Input, Output</td>
				<td bgcolor='#90EE67'>UART1</td><td bgcolor='#90EE67'>uart_tx</td><td bgcolor='#90EE67'>Output</td>
				<td bgcolor='#86DAFF'>FTM0</td><td bgcolor='#86DAFF'>tmr_ch3</td><td bgcolor='#86DAFF'>Input, Output</td>
				<td bgcolor='#EBD4BD'>FB</td><td bgcolor='#EBD4BD'>fb_ad11</td><td bgcolor='#EBD4BD'>Input/Output</td>
				<td bgcolor='#EFF174'>CMP1</td><td bgcolor='#EFF174'>cmp_out</td><td bgcolor='#EFF174'>Output</td>
				<td></td><td></td><td></td>
				<td></td><td></td><td></td>
			</tr>
			<tr>
				<td>77</td><td>PTC5/LLWU_P9/SPI0_SCK/LPTMR0_ALT2/I2S0_RXD0/FB_AD10/CMP0_OUT/FTM0_CH2</td><td><small><i>same</i></small></td>
				<td></td><td></td><td></td>
				<td bgcolor='#FFFFFF'>PTC<br/>LLWU</td><td bgcolor='#FFFFFF'>port5<br/>llwu_wakeup9</td><td bgcolor='#FFFFFF'>Input, Output</td>
				<td bgcolor='#AFFF8E'>SPI0</td><td bgcolor='#AFFF8E'>spi_sck</td><td bgcolor='#AFFF8E'>Input, Output</td>
				<td bgcolor='#58C7FF'>LPTMR0</td><td bgcolor='#58C7FF'>tmr_clk2</td><td bgcolor='#58C7FF'>Input</td>
				<td bgcolor='#20E04E'>I2S0</td><td bgcolor='#20E04E'>i2s_rxd0</td><td bgcolor='#20E04E'>Input</td>
				<td bgcolor='#EBD4BD'>FB</td><td bgcolor='#EBD4BD'>fb_ad10</td><td bgcolor='#EBD4BD'>Input/Output</td>
				<td bgcolor='#EFF174'>CMP0</td><td bgcolor='#EFF174'>cmp_out</td><td bgcolor='#EFF174'>Output</td>
				<td bgcolor='#86DAFF'>FTM0</td><td bgcolor='#86DAFF'>tmr_ch2</td><td bgcolor='#86DAFF'>Input, Output</td>
				<td></td><td></td><td></td>
			</tr>
			<tr>
				<td>78</td><td>CMP0_IN0/PTC6/LLWU_P10/SPI0_SOUT/PDB0_EXTRG/I2S0_RX_BCLK/FB_AD9/I2S0_MCLK</td><td><small><i>same</i></small></td>
				<td bgcolor='#EFF174'>CMP0</td><td bgcolor='#EFF174'>cmp_pos0<br/>cmp_neg0<br/>cmp_in0</td><td bgcolor='#EFF174'>Input</td>
				<td bgcolor='#FFFFFF'>PTC<br/>LLWU</td><td bgcolor='#FFFFFF'>port6<br/>llwu_wakeup10</td><td bgcolor='#FFFFFF'>Input, Output</td>
				<td bgcolor='#AFFF8E'>SPI0</td><td bgcolor='#AFFF8E'>spi_txd</td><td bgcolor='#AFFF8E'>Output</td>
				<td bgcolor='#14AFFF'>PDB0</td><td bgcolor='#14AFFF'>pdb_trigger<br/>pdb_ext_trig</td><td bgcolor='#14AFFF'>Input</td>
				<td bgcolor='#20E04E'>I2S0</td><td bgcolor='#20E04E'>i2s_rclk</td><td bgcolor='#20E04E'>Input, Output</td>
				<td bgcolor='#EBD4BD'>FB</td><td bgcolor='#EBD4BD'>fb_ad9</td><td bgcolor='#EBD4BD'>Input/Output</td>
				<td bgcolor='#20E04E'>I2S0</td><td bgcolor='#20E04E'>i2s_mclk</td><td bgcolor='#20E04E'>Input, Output</td>
				<td></td><td></td><td></td>
				<td></td><td></td><td></td>
			</tr>
			<tr>
				<td>79</td><td>CMP0_IN1/PTC7/SPI0_SIN/USB_SOF_OUT/I2S0_RX_FS/FB_AD8</td><td><small><i>same</i></small></td>
				<td bgcolor='#EFF174'>CMP0</td><td bgcolor='#EFF174'>cmp_pos1<br/>cmp_neg1<br/>cmp_in1</td><td bgcolor='#EFF174'>Input</td>
				<td bgcolor='#F7DCFF'>PTC</td><td bgcolor='#F7DCFF'>port7</td><td bgcolor='#F7DCFF'>Input, Output</td>
				<td bgcolor='#AFFF8E'>SPI0</td><td bgcolor='#AFFF8E'>spi_rxd</td><td bgcolor='#AFFF8E'>Input</td>
				<td bgcolor='#5FE356'>USB0</td><td bgcolor='#5FE356'>usb_sof</td><td bgcolor='#5FE356'>Output</td>
				<td bgcolor='#20E04E'>I2S0</td><td bgcolor='#20E04E'>i2s_rfs</td><td bgcolor='#20E04E'>Input, Output</td>
				<td bgcolor='#EBD4BD'>FB</td><td bgcolor='#EBD4BD'>fb_ad8</td><td bgcolor='#EBD4BD'>Input/Output</td>
				<td></td><td></td><td></td>
				<td></td><td></td><td></td>
				<td></td><td></td><td></td>
			</tr>
			<tr>
				<td>80</td><td>ADC1_SE4b/CMP0_IN2/PTC8/FTM3_CH4/I2S0_MCLK/FB_AD7</td><td><small><i>same</i></small></td>
				<td bgcolor='#FFFFFF'>ADC1<br/>CMP0<br/>CMP0<br/>CMP0</td><td bgcolor='#FFFFFF'>adc_seb4<br/>cmp_pos2<br/>cmp_neg2<br/>cmp_in2</td><td bgcolor='#FFFFFF'>Input</td>
				<td bgcolor='#F7DCFF'>PTC</td><td bgcolor='#F7DCFF'>port8</td><td bgcolor='#F7DCFF'>Input, Output</td>
				<td></td><td></td><td></td>
				<td bgcolor='#86DAFF'>FTM3</td><td bgcolor='#86DAFF'>tmr_ch4</td><td bgcolor='#86DAFF'>Input, Output</td>
				<td bgcolor='#20E04E'>I2S0</td><td bgcolor='#20E04E'>i2s_mclk</td><td bgcolor='#20E04E'>Input, Output</td>
				<td bgcolor='#EBD4BD'>FB</td><td bgcolor='#EBD4BD'>fb_ad7</td><td bgcolor='#EBD4BD'>Input/Output</td>
				<td></td><td></td><td></td>
				<td></td><td></td><td></td>
				<td></td><td></td><td></td>
			</tr>
			<tr>
				<td>81</td><td>ADC1_SE5b/CMP0_IN3/PTC9/FTM3_CH5/I2S0_RX_BCLK/FB_AD6/FTM2_FLT0</td><td><small><i>same</i></small></td>
				<td bgcolor='#FFFFFF'>ADC1<br/>CMP0<br/>CMP0<br/>CMP0</td><td bgcolor='#FFFFFF'>adc_seb5<br/>cmp_pos3<br/>cmp_neg3<br/>cmp_in3</td><td bgcolor='#FFFFFF'>Input</td>
				<td bgcolor='#F7DCFF'>PTC</td><td bgcolor='#F7DCFF'>port9</td><td bgcolor='#F7DCFF'>Input, Output</td>
				<td></td><td></td><td></td>
				<td bgcolor='#86DAFF'>FTM3</td><td bgcolor='#86DAFF'>tmr_ch5</td><td bgcolor='#86DAFF'>Input, Output</td>
				<td bgcolor='#20E04E'>I2S0</td><td bgcolor='#20E04E'>i2s_rclk</td><td bgcolor='#20E04E'>Input, Output</td>
				<td bgcolor='#EBD4BD'>FB</td><td bgcolor='#EBD4BD'>fb_ad6</td><td bgcolor='#EBD4BD'>Input/Output</td>
				<td bgcolor='#86DAFF'>FTM2</td><td bgcolor='#86DAFF'>tmr_fault0</td><td bgcolor='#86DAFF'>Input</td>
				<td></td><td></td><td></td>
				<td></td><td></td><td></td>
			</tr>
			<tr>
				<td>82</td><td>ADC1_SE6b/PTC10/I2C1_SCL/FTM3_CH6/I2S0_RX_FS/FB_AD5</td><td><small><i>same</i></small></td>
				<td bgcolor='#F8FF9A'>ADC1</td><td bgcolor='#F8FF9A'>adc_seb6</td><td bgcolor='#F8FF9A'>Input</td>
				<td bgcolor='#F7DCFF'>PTC</td><td bgcolor='#F7DCFF'>port10</td><td bgcolor='#F7DCFF'>Input, Output</td>
				<td bgcolor='#5FE356'>I2C1</td><td bgcolor='#5FE356'>i2c_sclk</td><td bgcolor='#5FE356'>Input/Output</td>
				<td bgcolor='#86DAFF'>FTM3</td><td bgcolor='#86DAFF'>tmr_ch6</td><td bgcolor='#86DAFF'>Input, Output</td>
				<td bgcolor='#20E04E'>I2S0</td><td bgcolor='#20E04E'>i2s_rfs</td><td bgcolor='#20E04E'>Input, Output</td>
				<td bgcolor='#EBD4BD'>FB</td><td bgcolor='#EBD4BD'>fb_ad5</td><td bgcolor='#EBD4BD'>Input/Output</td>
				<td></td><td></td><td></td>
				<td></td><td></td><td></td>
				<td></td><td></td><td></td>
			</tr>
			<tr>
				<td>83</td><td>ADC1_SE7b/PTC11/LLWU_P11/I2C1_SDA/FTM3_CH7/I2S0_RXD1/FB_RW_b</td><td><small><i>same</i></small></td>
				<td bgcolor='#F8FF9A'>ADC1</td><td bgcolor='#F8FF9A'>adc_seb7</td><td bgcolor='#F8FF9A'>Input</td>
				<td bgcolor='#FFFFFF'>PTC<br/>LLWU</td><td bgcolor='#FFFFFF'>port11<br/>llwu_wakeup11</td><td bgcolor='#FFFFFF'>Input, Output</td>
				<td bgcolor='#5FE356'>I2C1</td><td bgcolor='#5FE356'>i2c_sda</td><td bgcolor='#5FE356'>Input/Output</td>
				<td bgcolor='#86DAFF'>FTM3</td><td bgcolor='#86DAFF'>tmr_ch7</td><td bgcolor='#86DAFF'>Input, Output</td>
				<td bgcolor='#20E04E'>I2S0</td><td bgcolor='#20E04E'>i2s_rxd1</td><td bgcolor='#20E04E'>Input</td>
				<td bgcolor='#EBD4BD'>FB</td><td bgcolor='#EBD4BD'>fb_rw</td><td bgcolor='#EBD4BD'>Output</td>
				<td></td><td></td><td></td>
				<td></td><td></td><td></td>
				<td></td><td></td><td></td>
			</tr>
			<tr>
				<td>84</td><td>PTC12/UART4_RTS_b/FB_AD27/FTM3_FLT0</td><td><small><i>same</i></small></td>
				<td></td><td></td><td></td>
				<td bgcolor='#F7DCFF'>PTC</td><td bgcolor='#F7DCFF'>port12</td><td bgcolor='#F7DCFF'>Input, Output</td>
				<td></td><td></td><td></td>
				<td bgcolor='#90EE67'>UART4</td><td bgcolor='#90EE67'>uart_rts</td><td bgcolor='#90EE67'>Output</td>
				<td></td><td></td><td></td>
				<td bgcolor='#EBD4BD'>FB</td><td bgcolor='#EBD4BD'>fb_ad27</td><td bgcolor='#EBD4BD'>Input/Output</td>
				<td bgcolor='#86DAFF'>FTM3</td><td bgcolor='#86DAFF'>tmr_fault0</td><td bgcolor='#86DAFF'>Input</td>
				<td></td><td></td><td></td>
				<td></td><td></td><td></td>
			</tr>
			<tr>
				<td>85</td><td>PTC13/UART4_CTS_b/FB_AD26</td><td><small><i>same</i></small></td>
				<td></td><td></td><td></td>
				<td bgcolor='#F7DCFF'>PTC</td><td bgcolor='#F7DCFF'>port13</td><td bgcolor='#F7DCFF'>Input, Output</td>
				<td></td><td></td><td></td>
				<td bgcolor='#90EE67'>UART4</td><td bgcolor='#90EE67'>uart_cts</td><td bgcolor='#90EE67'>Input</td>
				<td></td><td></td><td></td>
				<td bgcolor='#EBD4BD'>FB</td><td bgcolor='#EBD4BD'>fb_ad26</td><td bgcolor='#EBD4BD'>Input/Output</td>
				<td></td><td></td><td></td>
				<td></td><td></td><td></td>
				<td></td><td></td><td></td>
			</tr>
			<tr>
				<td>86</td><td>PTC14/UART4_RX/FB_AD25</td><td><small><i>same</i></small></td>
				<td></td><td></td><td></td>
				<td bgcolor='#F7DCFF'>PTC</td><td bgcolor='#F7DCFF'>port14</td><td bgcolor='#F7DCFF'>Input, Output</td>
				<td></td><td></td><td></td>
				<td bgcolor='#90EE67'>UART4</td><td bgcolor='#90EE67'>uart_rx</td><td bgcolor='#90EE67'>Input</td>
				<td></td><td></td><td></td>
				<td bgcolor='#EBD4BD'>FB</td><td bgcolor='#EBD4BD'>fb_ad25</td><td bgcolor='#EBD4BD'>Input/Output</td>
				<td></td><td></td><td></td>
				<td></td><td></td><td></td>
				<td></td><td></td><td></td>
			</tr>
			<tr>
				<td>87</td><td>PTC15/UART4_TX/FB_AD24</td><td><small><i>same</i></small></td>
				<td></td><td></td><td></td>
				<td bgcolor='#F7DCFF'>PTC</td><td bgcolor='#F7DCFF'>port15</td><td bgcolor='#F7DCFF'>Input, Output</td>
				<td></td><td></td><td></td>
				<td bgcolor='#90EE67'>UART4</td><td bgcolor='#90EE67'>uart_tx</td><td bgcolor='#90EE67'>Output</td>
				<td></td><td></td><td></td>
				<td bgcolor='#EBD4BD'>FB</td><td bgcolor='#EBD4BD'>fb_ad24</td><td bgcolor='#EBD4BD'>Input/Output</td>
				<td></td><td></td><td></td>
				<td></td><td></td><td></td>
				<td></td><td></td><td></td>
			</tr>
			<tr>
				<td>88</td><td>VSS131</td><td><small><i>same</i></small></td>
				<td bgcolor='#F7DCFF'>SUPPLY</td><td bgcolor='#F7DCFF'>pwr_vss8</td><td bgcolor='#F7DCFF'>Input</td>
				<td></td><td></td><td></td>
				<td></td><td></td><td></td>
				<td></td><td></td><td></td>
				<td></td><td></td><td></td>
				<td></td><td></td><td></td>
				<td></td><td></td><td></td>
				<td></td><td></td><td></td>
				<td></td><td></td><td></td>
			</tr>
			<tr>
				<td>89</td><td>VDD132</td><td><small><i>same</i></small></td>
				<td bgcolor='#F7DCFF'>SUPPLY</td><td bgcolor='#F7DCFF'>pwr_vdd7</td><td bgcolor='#F7DCFF'>Input</td>
				<td></td><td></td><td></td>
				<td></td><td></td><td></td>
				<td></td><td></td><td></td>
				<td></td><td></td><td></td>
				<td></td><td></td><td></td>
				<td></td><td></td><td></td>
				<td></td><td></td><td></td>
				<td></td><td></td><td></td>
			</tr>
			<tr>
				<td>90</td><td>PTC16/UART3_RX/ENET0_1588_TMR0/FB_CS5_b/FB_TSIZ1/FB_BE23_16_BLS15_8_b</td><td><small><i>same</i></small></td>
				<td></td><td></td><td></td>
				<td bgcolor='#F7DCFF'>PTC</td><td bgcolor='#F7DCFF'>port16</td><td bgcolor='#F7DCFF'>Input, Output</td>
				<td></td><td></td><td></td>
				<td bgcolor='#90EE67'>UART3</td><td bgcolor='#90EE67'>uart_rx</td><td bgcolor='#90EE67'>Input</td>
				<td bgcolor='#90EE67'>ENET</td><td bgcolor='#90EE67'>enet_1588_tmr0</td><td bgcolor='#90EE67'>Input, Output</td>
				<td bgcolor='#EBD4BD'>FB</td><td bgcolor='#EBD4BD'>fb_cs5<br/>fb_cs5_tsiz1_be23_16<br/>fb_tsizSIZ1<br/>fb_be23_16</td><td bgcolor='#EBD4BD'>Output</td>
				<td></td><td></td><td></td>
				<td></td><td></td><td></td>
				<td></td><td></td><td></td>
			</tr>
			<tr>
				<td>91</td><td>PTC17/UART3_TX/ENET0_1588_TMR1/FB_CS4_b/FB_TSIZ0/FB_BE31_24_BLS7_0_b</td><td><small><i>same</i></small></td>
				<td></td><td></td><td></td>
				<td bgcolor='#F7DCFF'>PTC</td><td bgcolor='#F7DCFF'>port17</td><td bgcolor='#F7DCFF'>Input, Output</td>
				<td></td><td></td><td></td>
				<td bgcolor='#90EE67'>UART3</td><td bgcolor='#90EE67'>uart_tx</td><td bgcolor='#90EE67'>Output</td>
				<td bgcolor='#90EE67'>ENET</td><td bgcolor='#90EE67'>enet_1588_tmr1</td><td bgcolor='#90EE67'>Input, Output</td>
				<td bgcolor='#EBD4BD'>FB</td><td bgcolor='#EBD4BD'>fb_cs4<br/>fb_cs4_tsiz0_be31_24<br/>fb_tsizSIZ0<br/>fb_be31_24</td><td bgcolor='#EBD4BD'>Output</td>
				<td></td><td></td><td></td>
				<td></td><td></td><td></td>
				<td></td><td></td><td></td>
			</tr>
			<tr>
				<td>92</td><td>PTC18/UART3_RTS_b/ENET0_1588_TMR2/FB_TBST_b/FB_CS2_b/FB_BE15_8_BLS23_16_b</td><td><small><i>same</i></small></td>
				<td></td><td></td><td></td>
				<td bgcolor='#F7DCFF'>PTC</td><td bgcolor='#F7DCFF'>port18</td><td bgcolor='#F7DCFF'>Input, Output</td>
				<td></td><td></td><td></td>
				<td bgcolor='#90EE67'>UART3</td><td bgcolor='#90EE67'>uart_rts</td><td bgcolor='#90EE67'>Output</td>
				<td bgcolor='#90EE67'>ENET</td><td bgcolor='#90EE67'>enet_1588_tmr2</td><td bgcolor='#90EE67'>Input, Output</td>
				<td bgcolor='#EBD4BD'>FB</td><td bgcolor='#EBD4BD'>fb_tbst<br/>fb_cs2<br/>fb_cs2_tbst_be15_8<br/>fb_be15_8</td><td bgcolor='#EBD4BD'>Output</td>
				<td></td><td></td><td></td>
				<td></td><td></td><td></td>
				<td></td><td></td><td></td>
			</tr>
			<tr>
				<td>93</td><td>PTD0/LLWU_P12/SPI0_PCS0/UART2_RTS_b/FTM3_CH0/FB_ALE/FB_CS1_b/FB_TS_b</td><td><small><i>same</i></small></td>
				<td></td><td></td><td></td>
				<td bgcolor='#FFFFFF'>PTD<br/>LLWU</td><td bgcolor='#FFFFFF'>port0<br/>llwu_wakeup12</td><td bgcolor='#FFFFFF'>Input, Output</td>
				<td bgcolor='#AFFF8E'>SPI0</td><td bgcolor='#AFFF8E'>spi_cs0</td><td bgcolor='#AFFF8E'>Input, Output</td>
				<td bgcolor='#90EE67'>UART2</td><td bgcolor='#90EE67'>uart_rts</td><td bgcolor='#90EE67'>Output</td>
				<td bgcolor='#86DAFF'>FTM3</td><td bgcolor='#86DAFF'>tmr_ch0</td><td bgcolor='#86DAFF'>Input, Output</td>
				<td bgcolor='#EBD4BD'>FB</td><td bgcolor='#EBD4BD'>fb_ale<br/>fb_cs1<br/>fb_cs1_ale_ts<br/>fb_ts</td><td bgcolor='#EBD4BD'>Output</td>
				<td></td><td></td><td></td>
				<td></td><td></td><td></td>
				<td></td><td></td><td></td>
			</tr>
			<tr>
				<td>94</td><td>ADC0_SE5b/PTD1/SPI0_SCK/UART2_CTS_b/FTM3_CH1/FB_CS0_b</td><td><small><i>same</i></small></td>
				<td bgcolor='#F8FF9A'>ADC0</td><td bgcolor='#F8FF9A'>adc_seb5</td><td bgcolor='#F8FF9A'>Input</td>
				<td bgcolor='#F7DCFF'>PTD</td><td bgcolor='#F7DCFF'>port1</td><td bgcolor='#F7DCFF'>Input, Output</td>
				<td bgcolor='#AFFF8E'>SPI0</td><td bgcolor='#AFFF8E'>spi_sck</td><td bgcolor='#AFFF8E'>Input, Output</td>
				<td bgcolor='#90EE67'>UART2</td><td bgcolor='#90EE67'>uart_cts</td><td bgcolor='#90EE67'>Input</td>
				<td bgcolor='#86DAFF'>FTM3</td><td bgcolor='#86DAFF'>tmr_ch1</td><td bgcolor='#86DAFF'>Input, Output</td>
				<td bgcolor='#EBD4BD'>FB</td><td bgcolor='#EBD4BD'>fb_cs0</td><td bgcolor='#EBD4BD'>Output</td>
				<td></td><td></td><td></td>
				<td></td><td></td><td></td>
				<td></td><td></td><td></td>
			</tr>
			<tr>
				<td>95</td><td>PTD2/LLWU_P13/SPI0_SOUT/UART2_RX/FTM3_CH2/FB_AD4/I2C0_SCL</td><td><small><i>same</i></small></td>
				<td></td><td></td><td></td>
				<td bgcolor='#FFFFFF'>PTD<br/>LLWU</td><td bgcolor='#FFFFFF'>port2<br/>llwu_wakeup13</td><td bgcolor='#FFFFFF'>Input, Output</td>
				<td bgcolor='#AFFF8E'>SPI0</td><td bgcolor='#AFFF8E'>spi_txd</td><td bgcolor='#AFFF8E'>Output</td>
				<td bgcolor='#90EE67'>UART2</td><td bgcolor='#90EE67'>uart_rx</td><td bgcolor='#90EE67'>Input</td>
				<td bgcolor='#86DAFF'>FTM3</td><td bgcolor='#86DAFF'>tmr_ch2</td><td bgcolor='#86DAFF'>Input, Output</td>
				<td bgcolor='#EBD4BD'>FB</td><td bgcolor='#EBD4BD'>fb_ad4</td><td bgcolor='#EBD4BD'>Input/Output</td>
				<td></td><td></td><td></td>
				<td bgcolor='#5FE356'>I2C0</td><td bgcolor='#5FE356'>i2c_sclk</td><td bgcolor='#5FE356'>Input/Output</td>
				<td></td><td></td><td></td>
			</tr>
			<tr>
				<td>96</td><td>PTD3/SPI0_SIN/UART2_TX/FTM3_CH3/FB_AD3/I2C0_SDA</td><td><small><i>same</i></small></td>
				<td></td><td></td><td></td>
				<td bgcolor='#F7DCFF'>PTD</td><td bgcolor='#F7DCFF'>port3</td><td bgcolor='#F7DCFF'>Input, Output</td>
				<td bgcolor='#AFFF8E'>SPI0</td><td bgcolor='#AFFF8E'>spi_rxd</td><td bgcolor='#AFFF8E'>Input</td>
				<td bgcolor='#90EE67'>UART2</td><td bgcolor='#90EE67'>uart_tx</td><td bgcolor='#90EE67'>Output</td>
				<td bgcolor='#86DAFF'>FTM3</td><td bgcolor='#86DAFF'>tmr_ch3</td><td bgcolor='#86DAFF'>Input, Output</td>
				<td bgcolor='#EBD4BD'>FB</td><td bgcolor='#EBD4BD'>fb_ad3</td><td bgcolor='#EBD4BD'>Input/Output</td>
				<td></td><td></td><td></td>
				<td bgcolor='#5FE356'>I2C0</td><td bgcolor='#5FE356'>i2c_sda</td><td bgcolor='#5FE356'>Input/Output</td>
				<td></td><td></td><td></td>
			</tr>
			<tr>
				<td>97</td><td>PTD4/LLWU_P14/SPI0_PCS1/UART0_RTS_b/FTM0_CH4/FB_AD2/EWM_IN/SPI1_PCS0</td><td><small><i>same</i></small></td>
				<td></td><td></td><td></td>
				<td bgcolor='#FFFFFF'>PTD<br/>LLWU</td><td bgcolor='#FFFFFF'>port4<br/>llwu_wakeup14</td><td bgcolor='#FFFFFF'>Input, Output</td>
				<td bgcolor='#AFFF8E'>SPI0</td><td bgcolor='#AFFF8E'>spi_cs1</td><td bgcolor='#AFFF8E'>Output</td>
				<td bgcolor='#90EE67'>UART0</td><td bgcolor='#90EE67'>uart_rts</td><td bgcolor='#90EE67'>Output</td>
				<td bgcolor='#86DAFF'>FTM0</td><td bgcolor='#86DAFF'>tmr_ch4</td><td bgcolor='#86DAFF'>Input, Output</td>
				<td bgcolor='#EBD4BD'>FB</td><td bgcolor='#EBD4BD'>fb_ad2</td><td bgcolor='#EBD4BD'>Input/Output</td>
				<td bgcolor='#B3EAFF'>EWM</td><td bgcolor='#B3EAFF'>ewm_in</td><td bgcolor='#B3EAFF'>Input</td>
				<td bgcolor='#AFFF8E'>SPI1</td><td bgcolor='#AFFF8E'>spi_cs0</td><td bgcolor='#AFFF8E'>Input, Output</td>
				<td></td><td></td><td></td>
			</tr>
			<tr>
				<td>98</td><td>ADC0_SE6b/PTD5/SPI0_PCS2/UART0_CTS_b/UART0_COL_b/FTM0_CH5/FB_AD1/EWM_OUT_b/SPI1_SCK</td><td><small><i>same</i></small></td>
				<td bgcolor='#F8FF9A'>ADC0</td><td bgcolor='#F8FF9A'>adc_seb6</td><td bgcolor='#F8FF9A'>Input</td>
				<td bgcolor='#F7DCFF'>PTD</td><td bgcolor='#F7DCFF'>port5</td><td bgcolor='#F7DCFF'>Input, Output</td>
				<td bgcolor='#AFFF8E'>SPI0</td><td bgcolor='#AFFF8E'>spi_cs2</td><td bgcolor='#AFFF8E'>Output</td>
				<td bgcolor='#90EE67'>UART0</td><td bgcolor='#90EE67'>uart_cts<br/>uart_col</td><td bgcolor='#90EE67'>Input</td>
				<td bgcolor='#86DAFF'>FTM0</td><td bgcolor='#86DAFF'>tmr_ch5</td><td bgcolor='#86DAFF'>Input, Output</td>
				<td bgcolor='#EBD4BD'>FB</td><td bgcolor='#EBD4BD'>fb_ad1</td><td bgcolor='#EBD4BD'>Input/Output</td>
				<td bgcolor='#B3EAFF'>EWM</td><td bgcolor='#B3EAFF'>ewm_out</td><td bgcolor='#B3EAFF'>Output</td>
				<td bgcolor='#AFFF8E'>SPI1</td><td bgcolor='#AFFF8E'>spi_sck</td><td bgcolor='#AFFF8E'>Input, Output</td>
				<td></td><td></td><td></td>
			</tr>
			<tr>
				<td>99</td><td>ADC0_SE7b/PTD6/LLWU_P15/SPI0_PCS3/UART0_RX/FTM0_CH6/FB_AD0/FTM0_FLT0/SPI1_SOUT</td><td><small><i>same</i></small></td>
				<td bgcolor='#F8FF9A'>ADC0</td><td bgcolor='#F8FF9A'>adc_seb7</td><td bgcolor='#F8FF9A'>Input</td>
				<td bgcolor='#FFFFFF'>PTD<br/>LLWU</td><td bgcolor='#FFFFFF'>port6<br/>llwu_wakeup15</td><td bgcolor='#FFFFFF'>Input, Output</td>
				<td bgcolor='#AFFF8E'>SPI0</td><td bgcolor='#AFFF8E'>spi_cs3</td><td bgcolor='#AFFF8E'>Output</td>
				<td bgcolor='#90EE67'>UART0</td><td bgcolor='#90EE67'>uart_rx</td><td bgcolor='#90EE67'>Input</td>
				<td bgcolor='#86DAFF'>FTM0</td><td bgcolor='#86DAFF'>tmr_ch6</td><td bgcolor='#86DAFF'>Input, Output</td>
				<td bgcolor='#EBD4BD'>FB</td><td bgcolor='#EBD4BD'>fb_ad0</td><td bgcolor='#EBD4BD'>Input/Output</td>
				<td bgcolor='#86DAFF'>FTM0</td><td bgcolor='#86DAFF'>tmr_fault0<br/>tmr_trigger2</td><td bgcolor='#86DAFF'>Input</td>
				<td bgcolor='#AFFF8E'>SPI1</td><td bgcolor='#AFFF8E'>spi_txd</td><td bgcolor='#AFFF8E'>Output</td>
				<td></td><td></td><td></td>
			</tr>
			<tr>
				<td>100</td><td>PTD7/CMT_IRO/UART0_TX/FTM0_CH7/FTM0_FLT1/SPI1_SIN</td><td><small><i>same</i></small></td>
				<td></td><td></td><td></td>
				<td bgcolor='#F7DCFF'>PTD</td><td bgcolor='#F7DCFF'>port7</td><td bgcolor='#F7DCFF'>Input, Output</td>
				<td bgcolor='#CEFFFF'>CMT</td><td bgcolor='#CEFFFF'>cmt_iro</td><td bgcolor='#CEFFFF'>Output</td>
				<td bgcolor='#90EE67'>UART0</td><td bgcolor='#90EE67'>uart_tx</td><td bgcolor='#90EE67'>Output</td>
				<td bgcolor='#86DAFF'>FTM0</td><td bgcolor='#86DAFF'>tmr_ch7</td><td bgcolor='#86DAFF'>Input, Output</td>
				<td></td><td></td><td></td>
				<td bgcolor='#86DAFF'>FTM0</td><td bgcolor='#86DAFF'>tmr_fault1</td><td bgcolor='#86DAFF'>Input</td>
				<td bgcolor='#AFFF8E'>SPI1</td><td bgcolor='#AFFF8E'>spi_rxd</td><td bgcolor='#AFFF8E'>Input</td>
				<td></td><td></td><td></td>
			</tr>
		</table>

*/
/*!
\page page_pinalloc Pin Allocation

		<h2 style='font-family: Arial;'>Pin Allocation Report</h2>
		<table cellpadding='2' border='1' style='border: 2px solid #000000;' bgcolor='WHITE' align='center'>
			<tr bgcolor='#E8E8E8'><th>Peripheral</th><th>Custom peripheral name</th><th>Peripheral description</th></tr>
			<tr bgcolor='#F8FF9A'><td>ADC0</td><td>ADC0</td><td><small>Analog-to-Digital Converter</small></td></tr>
			<tr bgcolor='#F8FF9A'><td>ADC1</td><td>ADC1</td><td><small>Analog-to-Digital Converter</small></td></tr>
			<tr bgcolor='#AFFF8E'><td>CAN0</td><td>CAN0</td><td><small>Flex Controller Area Network module</small></td></tr>
			<tr bgcolor='#EFF174'><td>CMP0</td><td>CMP0</td><td><small>High-Speed Comparator (CMP), Voltage Reference (VREF) Digital-to-Analog Converter (DAC), and Analog Mux (ANMUX)</small></td></tr>
			<tr bgcolor='#EFF174'><td>CMP1</td><td>CMP1</td><td><small>High-Speed Comparator (CMP), Voltage Reference (VREF) Digital-to-Analog Converter (DAC), and Analog Mux (ANMUX)</small></td></tr>
			<tr bgcolor='#EFF174'><td>CMP2</td><td>CMP2</td><td><small>High-Speed Comparator (CMP), Voltage Reference (VREF) Digital-to-Analog Converter (DAC), and Analog Mux (ANMUX)</small></td></tr>
			<tr bgcolor='#CEFFFF'><td>CMT</td><td>CMT</td><td><small>Carrier Modulator Timer (CMT)</small></td></tr>
			<tr bgcolor='#E5E44D'><td>DAC0</td><td>DAC0</td><td><small>12-Bit Digital-to-Analog Converter</small></td></tr>
			<tr bgcolor='#90EE67'><td>ENET</td><td>ENET</td><td><small>Ethernet MAC-NET Core</small></td></tr>
			<tr bgcolor='#B3EAFF'><td>EWM</td><td>EWM</td><td><small>External Watchdog Monitor (EWM)</small></td></tr>
			<tr bgcolor='#EBD4BD'><td>FB</td><td>FB</td><td><small>External bus Interface (FlexBus)</small></td></tr>
			<tr bgcolor='#86DAFF'><td>FTM0</td><td>FTM0</td><td><small>FlexTimer Module</small></td></tr>
			<tr bgcolor='#86DAFF'><td>FTM1</td><td>FTM1</td><td><small>FlexTimer Module</small></td></tr>
			<tr bgcolor='#86DAFF'><td>FTM2</td><td>FTM2</td><td><small>FlexTimer Module</small></td></tr>
			<tr bgcolor='#86DAFF'><td>FTM3</td><td>FTM3</td><td><small>FlexTimer Module</small></td></tr>
			<tr bgcolor='#5FE356'><td>I2C0</td><td>I2C0</td><td><small>Inter-integrated circuit bus</small></td></tr>
			<tr bgcolor='#5FE356'><td>I2C1</td><td>I2C1</td><td><small>Inter-integrated circuit bus</small></td></tr>
			<tr bgcolor='#5FE356'><td>I2C2</td><td>I2C2</td><td><small>Inter-integrated circuit bus</small></td></tr>
			<tr bgcolor='#20E04E'><td>I2S0</td><td>I2S0</td><td><small>Integrated Interchip Sound - I2S / Synchronous Audio Interface - SAI</small></td></tr>
			<tr bgcolor='#DDC7B5'><td>JTAG</td><td>JTAG</td><td><small>JTAG interface</small></td></tr>
			<tr bgcolor='#CCB6A0'><td>LLWU</td><td>LLWU</td><td><small>Low Leakage Wake-up Unit</small></td></tr>
			<tr bgcolor='#58C7FF'><td>LPTMR0</td><td>LPTMR0</td><td><small>Low Power Timer Module</small></td></tr>
			<tr bgcolor='#C7A886'><td>OSC</td><td>OSC</td><td><small>Oscillator</small></td></tr>
			<tr bgcolor='#14AFFF'><td>PDB0</td><td>PDB0</td><td><small>Programmable Delay Block</small></td></tr>
			<tr bgcolor='#F7DCFF'><td>PTA</td><td>PTA</td><td><small>General Purpose Input/Output</small></td></tr>
			<tr bgcolor='#F7DCFF'><td>PTB</td><td>PTB</td><td><small>General Purpose Input/Output</small></td></tr>
			<tr bgcolor='#F7DCFF'><td>PTC</td><td>PTC</td><td><small>General Purpose Input/Output</small></td></tr>
			<tr bgcolor='#F7DCFF'><td>PTD</td><td>PTD</td><td><small>General Purpose Input/Output</small></td></tr>
			<tr bgcolor='#F7DCFF'><td>PTE</td><td>PTE</td><td><small>General Purpose Input/Output</small></td></tr>
			<tr bgcolor='#FFE1C7'><td>RCM</td><td>RCM</td><td><small>Reset Control Module</small></td></tr>
			<tr bgcolor='#CEFFFF'><td>RTC</td><td>RTC</td><td><small>Real Time Clock - RTC</small></td></tr>
			<tr bgcolor='#00CA3A'><td>SDHC</td><td>SDHC</td><td><small>Secured Digital Host Controller</small></td></tr>
			<tr bgcolor='#DDC7B5'><td>SIM</td><td>SIM</td><td><small>System Integration Module</small></td></tr>
			<tr bgcolor='#AFFF8E'><td>SPI0</td><td>SPI0</td><td><small>Deserial Serial Peripheral Interface 0</small></td></tr>
			<tr bgcolor='#AFFF8E'><td>SPI1</td><td>SPI1</td><td><small>Deserial Serial Peripheral Interface 1</small></td></tr>
			<tr bgcolor='#AFFF8E'><td>SPI2</td><td>SPI2</td><td><small>Deserial Serial Peripheral Interface 2</small></td></tr>
			<tr bgcolor='#F7DCFF'><td>SUPPLY</td><td>SUPPLY</td><td><small>Chip power supply</small></td></tr>
			<tr bgcolor='#EBD4BD'><td>SystemControl</td><td>SystemControl</td><td><small>System control</small></td></tr>
			<tr bgcolor='#CCB6A0'><td>TPIU</td><td>TPIU</td><td><small>Trace Port Interface Unit</small></td></tr>
			<tr bgcolor='#90EE67'><td>UART0</td><td>UART0</td><td><small>Serial Communications Interface Module UART0</small></td></tr>
			<tr bgcolor='#90EE67'><td>UART1</td><td>UART1</td><td><small>Serial Communications Interface Module UART1</small></td></tr>
			<tr bgcolor='#90EE67'><td>UART2</td><td>UART2</td><td><small>Serial Communications Interface Module UART2</small></td></tr>
			<tr bgcolor='#90EE67'><td>UART3</td><td>UART3</td><td><small>Serial Communications Interface Module UART3</small></td></tr>
			<tr bgcolor='#90EE67'><td>UART4</td><td>UART4</td><td><small>Serial Communications Interface Module UART4</small></td></tr>
			<tr bgcolor='#5FE356'><td>USB0</td><td>USB0</td><td><small>Universal Serial Bus On The Go - USB0</small></td></tr>
			<tr bgcolor='#20E04E'><td>USBDCD</td><td>USBDCD</td><td><small>USB Charging port detect</small></td></tr>
			<tr bgcolor='#DCD627'><td>VREF</td><td>VREF</td><td><small>Voltage Reference</small></td></tr>
		</table>
		<br/>
		<br/>
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
