ErichStyger/mcuoneclipse/Examples/KDS/tinyK20/tinyK20_HSLU_ConferenceStation/3D and Laser/Mobile Teacher Tool Rev 2/Mobile Teacher Multitool - V3 - MDF 6mm .dxf

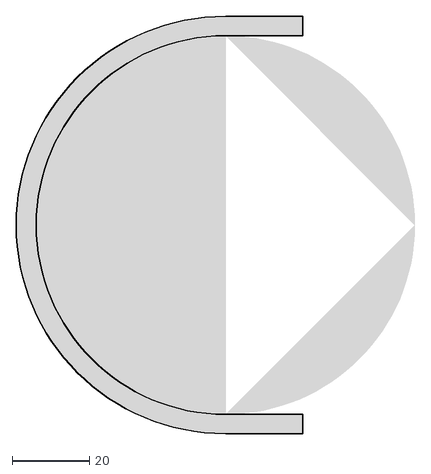
[picture p38: CAD file, 2020-10-18]
Examples/KDS/tinyK20/tinyK20_HSLU_ConferenceStation/3D and Laser/Mobile Teacher Tool Rev 2/Mobile Teacher Multitool - V3 - MDF 6mm .dxf
103.2 x 108.0
