ErichStyger/mcuoneclipse/Examples/KDS/tinyK20/tinyK20_HSLU_ConferenceStation/3D and Laser/Original Rev 1/EnclosureStand.stl

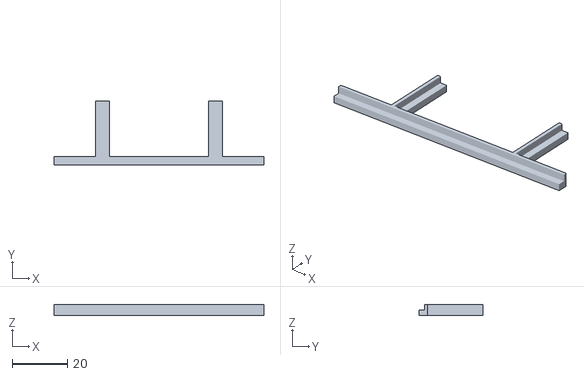
[picture p39: CAD file, 2020-09-15]
Examples/KDS/tinyK20/tinyK20_HSLU_ConferenceStation/3D and Laser/Original Rev 1/EnclosureStand.stl
76.0 x 23.0 x 4.00
