ErichStyger/mcuoneclipse/Examples/KDS/tinyK20/tinyK20_SandClock/3D/sandclock.stl

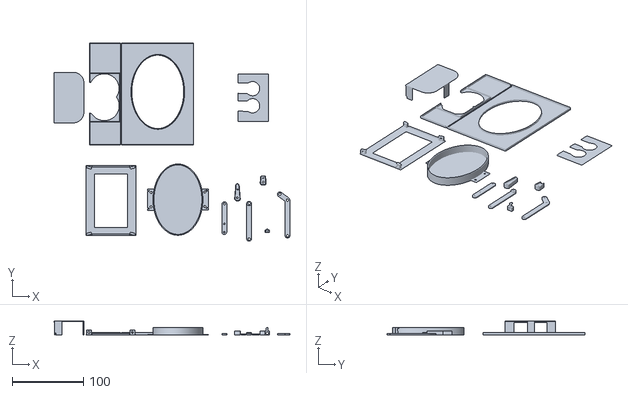
[picture p40: CAD file, 2016-11-24]
Examples/KDS/tinyK20/tinyK20_SandClock/3D/sandclock.stl
331.1 x 278.3 x 20.0
