ErichStyger/mcuoneclipse/Examples/MCUXpresso/LPC845-BRK/LPC845-BRK_StepperClock/3D/OuterShaft.stl

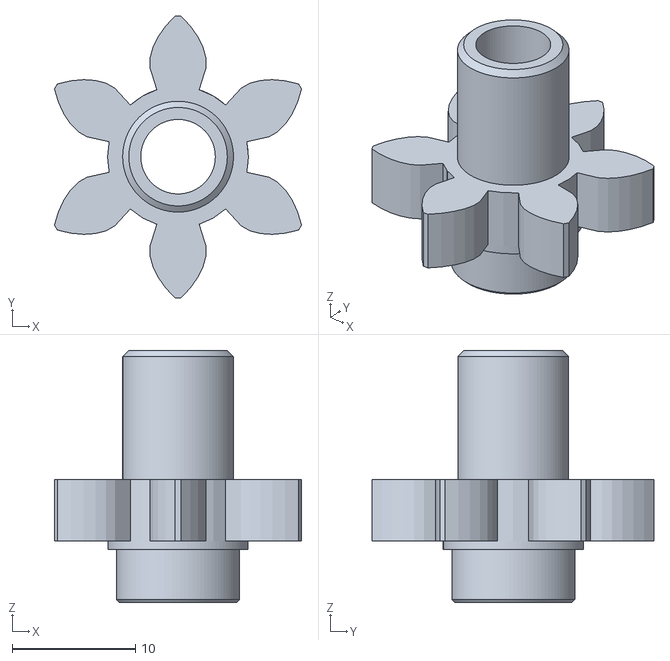
[picture p41: CAD file, 2019-08-25]
Examples/MCUXpresso/LPC845-BRK/LPC845-BRK_StepperClock/3D/OuterShaft.stl
20.1 x 22.9 x 20.5
