ErichStyger/mcuoneclipse/Examples/MCUXpresso/LPC845-BRK/LPC845-WorldClock/3D/BoardHolder.stl

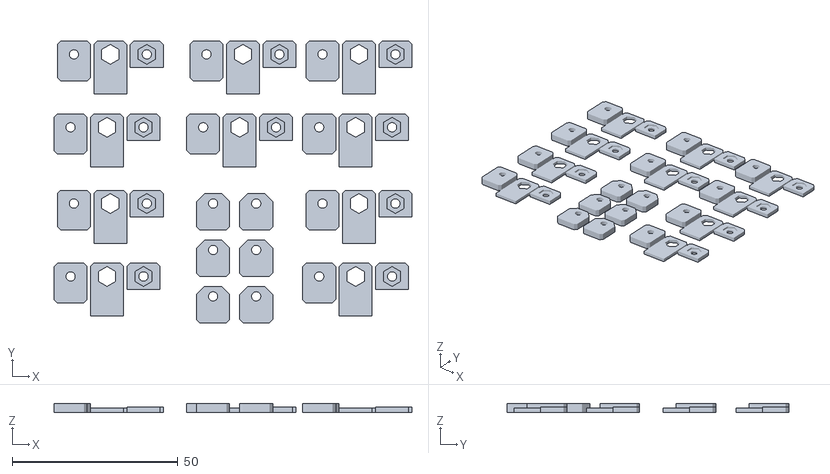
[picture p42: CAD file, 2019-12-29]
Examples/MCUXpresso/LPC845-BRK/LPC845-WorldClock/3D/BoardHolder.stl
108.0 x 85.0 x 2.60
