ErichStyger/mcuoneclipse/LaserCutter/Inkscape/RaspySteampunkBox/RaspyJoystick.stl

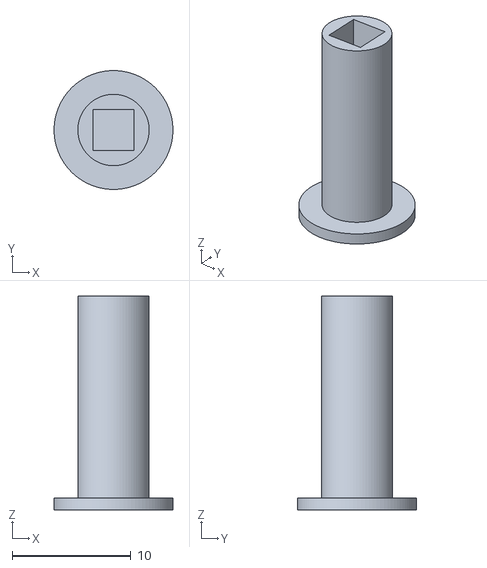
[picture p43: CAD file, 2019-06-02]
LaserCutter/Inkscape/RaspySteampunkBox/RaspyJoystick.stl
10.0 x 9.99 x 18.0
