ErichStyger/mcuoneclipse/MCU-Link/McuLink Enclosure/3D-Print-in-Place/McuLinkCover.stl

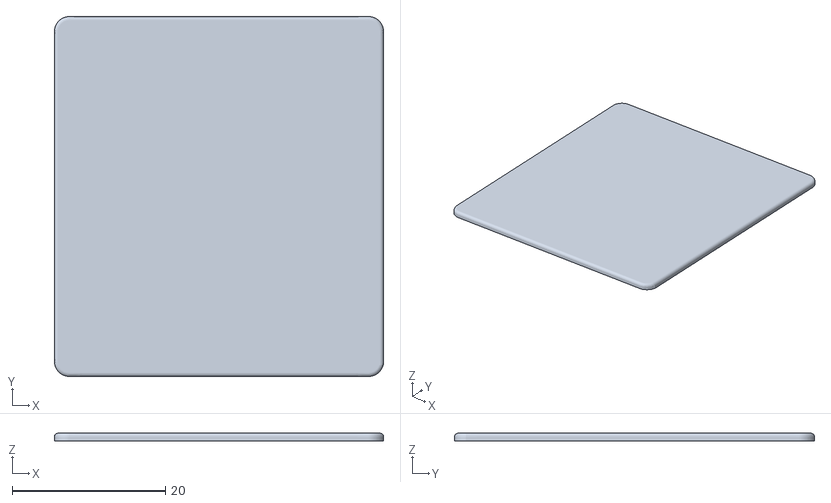
[picture p44: CAD file, 2020-11-30]
MCU-Link/McuLink Enclosure/3D-Print-in-Place/McuLinkCover.stl
43.0 x 47.0 x 1.00
