ErichStyger/mcuoneclipse/MCU-Link/McuLink Enclosure/Rugged-Box/MCU-Link-RuggedBox.3mf

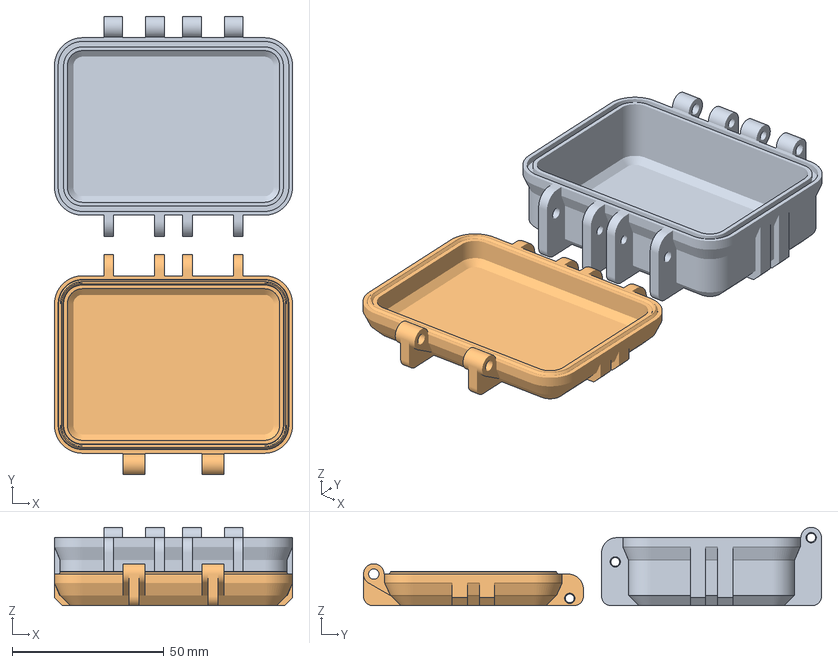
[picture p45: CAD file, 2026-05-05]
MCU-Link/McuLink Enclosure/Rugged-Box/MCU-Link-RuggedBox.3mf
78.5 x 151.0 x 25.8 mm
MCU-Link-RuggedBox.stl
MCU-Link-RuggedLid.stl
