ErichStyger/mcuoneclipse/MCU-Link/Pro/rugged enclosure/MCU-Link-Pro-RuggedLid.stl

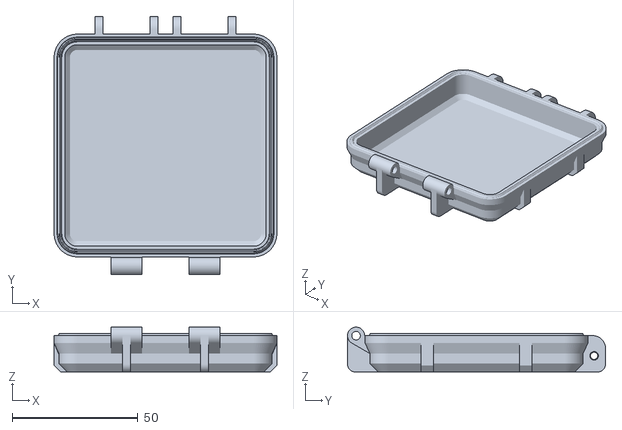
[picture p46: CAD file, 2026-02-08]
MCU-Link/Pro/rugged enclosure/MCU-Link-Pro-RuggedLid.stl
88.5 x 102.5 x 17.8
