ErichStyger/mcuoneclipse/MCU-Link/Pro/spacer_more.stl

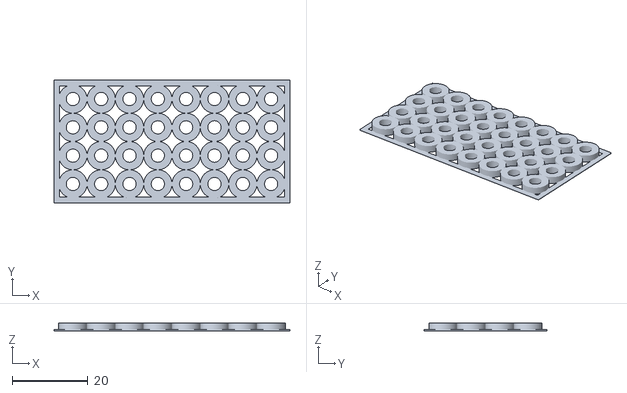
[picture p47: CAD file, 2024-03-07]
MCU-Link/Pro/spacer_more.stl
62.5 x 32.5 x 2.00
