ErichStyger/mcuoneclipse/Examples/KDS/tinyK20/tinyK20_HSLU_ConferenceStation/3D and Laser/Mobile Teacher Tool Rev 2/Mobile Teacher Tool 3D Print Parts.stp

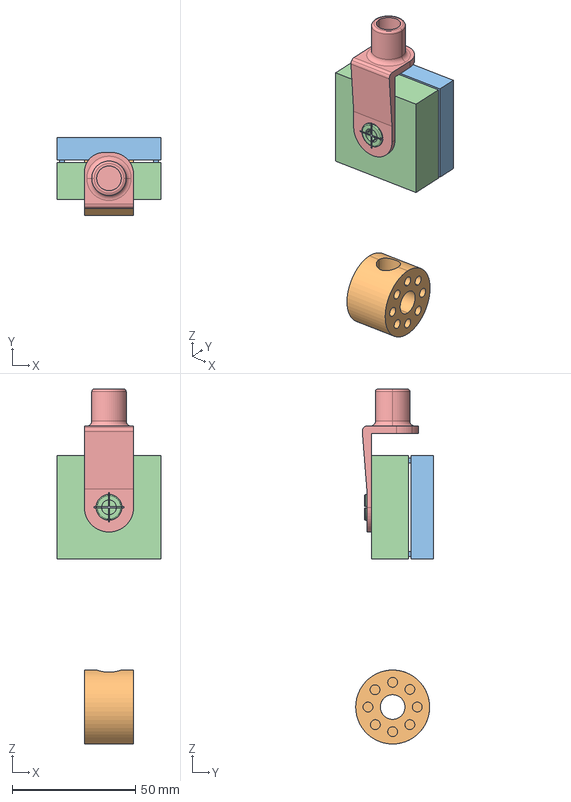
[picture p48: CAD file, 2020-10-18]
Examples/KDS/tinyK20/tinyK20_HSLU_ConferenceStation/3D and Laser/Mobile Teacher Tool Rev 2/Mobile Teacher Tool 3D Print Parts.stp
42.0 x 31.5 x 144.0 mm
SYS
Kamerahaus vorne
Kamerahaus hinten
Kameraanschluss
