ErichStyger/mcuoneclipse/Examples/KDS/tinyK20/tinyK20_HSLU_ConferenceStation/3D and Laser/Original Rev 1/AluRodEnclosureCover.stl

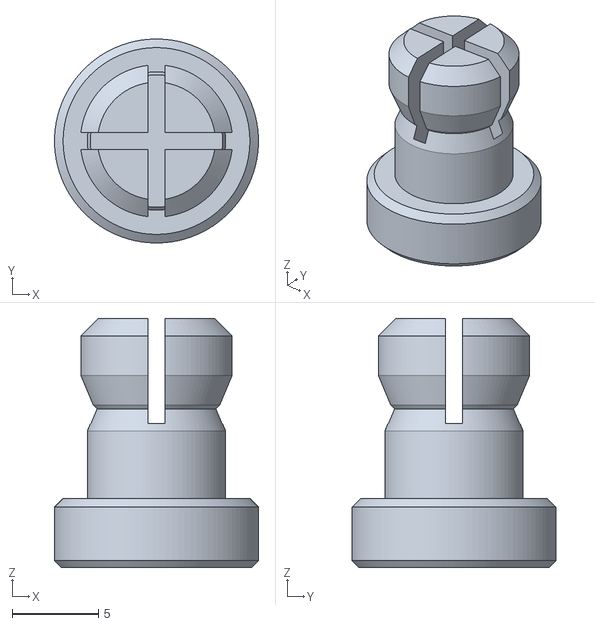
[picture p49: CAD file, 2020-09-15]
Examples/KDS/tinyK20/tinyK20_HSLU_ConferenceStation/3D and Laser/Original Rev 1/AluRodEnclosureCover.stl
11.8 x 11.8 x 14.4
