ErichStyger/mcuoneclipse/Examples/MCUXpresso/LPC845-BRK/LPC845-BRK_StepperClock/3D/InnerShaft.stl

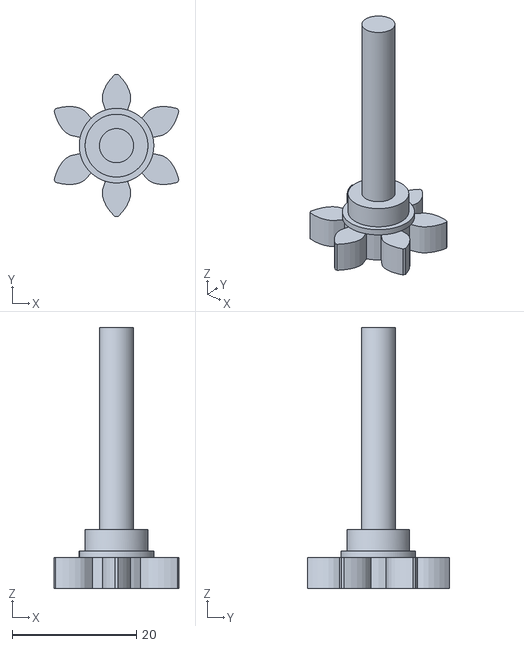
[picture p50: CAD file, 2019-08-25]
Examples/MCUXpresso/LPC845-BRK/LPC845-BRK_StepperClock/3D/InnerShaft.stl
20.1 x 22.9 x 42.0
