ErichStyger/mcuoneclipse/Examples/MCUXpresso/LPC845-BRK/LPC845-WorldClock/3D/Hands.stl

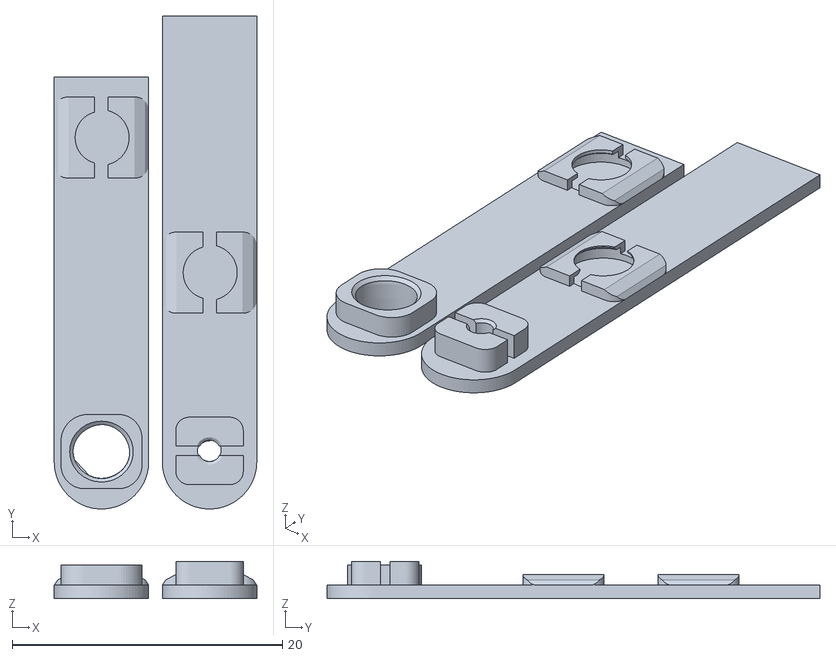
[picture p51: CAD file, 2019-12-29]
Examples/MCUXpresso/LPC845-BRK/LPC845-WorldClock/3D/Hands.stl
15.0 x 36.5 x 2.75
