ErichStyger/mcuoneclipse/MCU-Link/McuLink Enclosure/3D-Print-in-Place/McuLink.stl

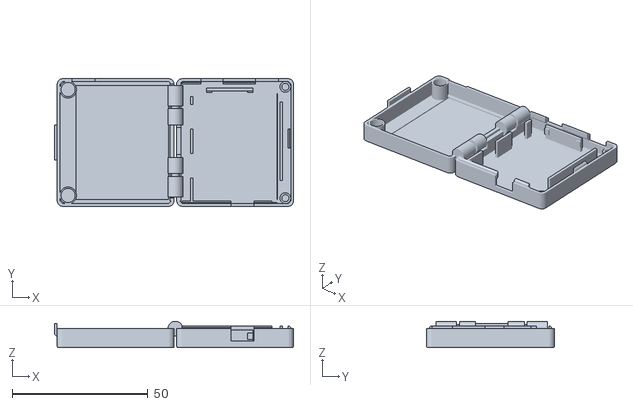
[picture p52: CAD file, 2020-11-29]
MCU-Link/McuLink Enclosure/3D-Print-in-Place/McuLink.stl
88.0 x 47.0 x 9.75
