ErichStyger/mcuoneclipse/MCU-Link/McuLink Enclosure/Rugged-Box/MCU-Link_Bottom.stl

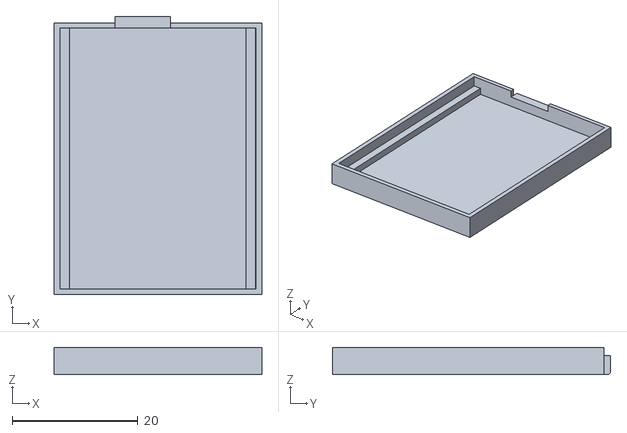
[picture p53: CAD file, 2025-12-31]
MCU-Link/McuLink Enclosure/Rugged-Box/MCU-Link_Bottom.stl
33.0 x 44.2 x 4.30
