ErichStyger/mcuoneclipse/MCU-Link/Pro/rugged enclosure/cableInsert.stl

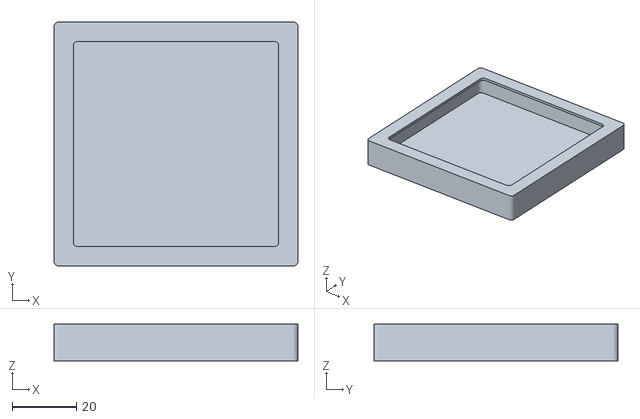
[picture p54: CAD file, 2026-02-08]
MCU-Link/Pro/rugged enclosure/cableInsert.stl
76.0 x 76.0 x 11.5
