ErichStyger/mcuoneclipse/MCU-Link/Pro/spacer.stl

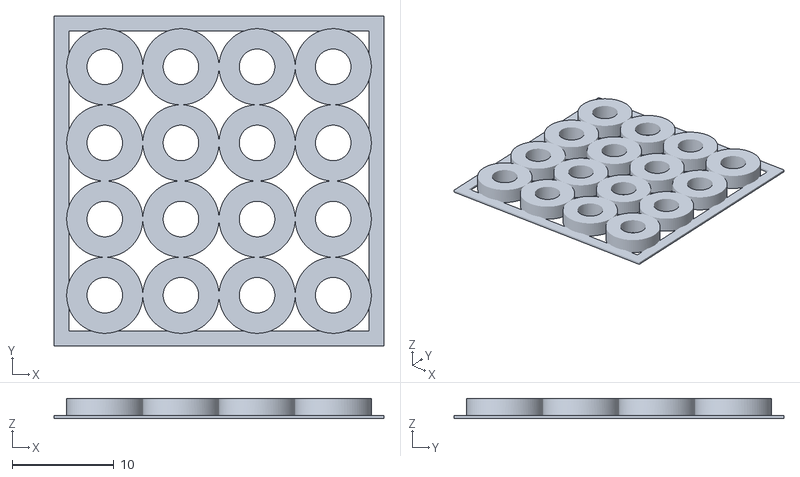
[picture p55: CAD file, 2023-08-11]
MCU-Link/Pro/spacer.stl
32.5 x 32.5 x 2.00
