ErichStyger/mcuoneclipse/Examples/KDS/tinyK20/tinyK20_HSLU_ConferenceStation/3D and Laser/Original Rev 1/clip.stl

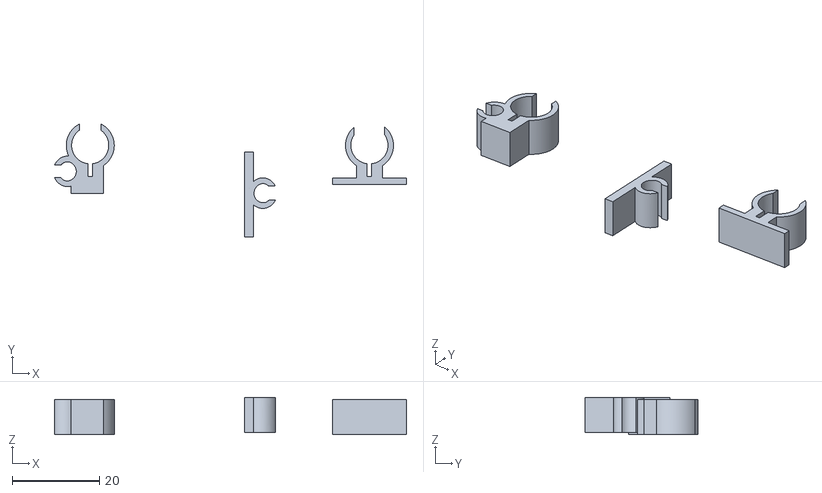
[picture p57: CAD file, 2020-08-07]
Examples/KDS/tinyK20/tinyK20_HSLU_ConferenceStation/3D and Laser/Original Rev 1/clip.stl
80.7 x 25.9 x 8.54
