ErichStyger/mcuoneclipse/Examples/MCUXpresso/LPC845-BRK/LPC845-BRK_StepperClock/3D/Spacer.stl

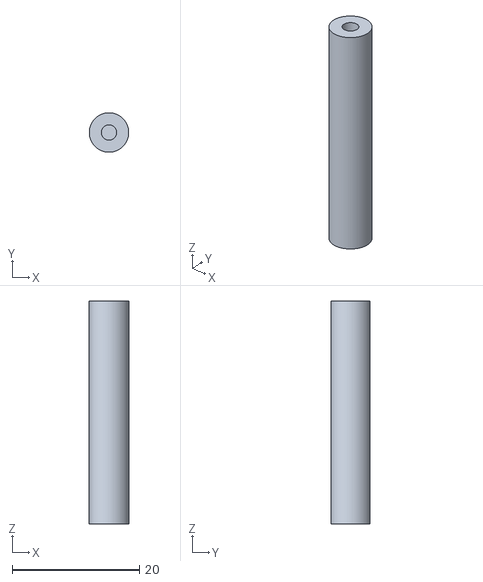
[picture p58: CAD file, 2019-08-25]
Examples/MCUXpresso/LPC845-BRK/LPC845-BRK_StepperClock/3D/Spacer.stl
6.20 x 6.19 x 35.0
