ErichStyger/mcuoneclipse/MCU-Link/McuLink Enclosure/Rugged-Box/MCU-Link-RuggedPlate.stl

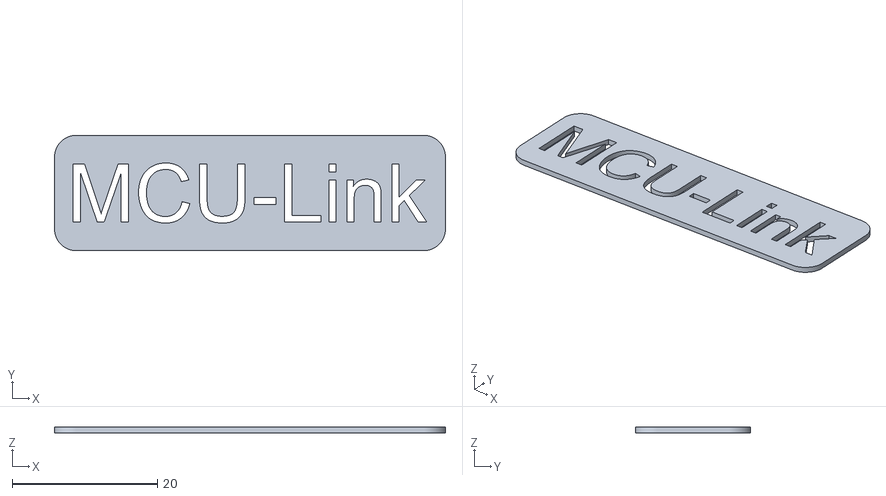
[picture p59: CAD file, 2025-12-31]
MCU-Link/McuLink Enclosure/Rugged-Box/MCU-Link-RuggedPlate.stl
53.9 x 15.9 x 0.8
