ErichStyger/mcuoneclipse/MCU-Link/Pro/NXP_Logo.dxf

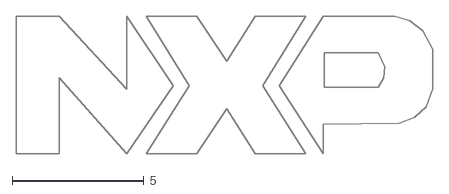
[picture p60: CAD file, 2021-11-03]
MCU-Link/Pro/NXP_Logo.dxf
15.8 x 5.22
