ErichStyger/mcuoneclipse/MCU-Link/Pro/rugged enclosure/MCU-Link-Pro-RuggedBox.fcstd

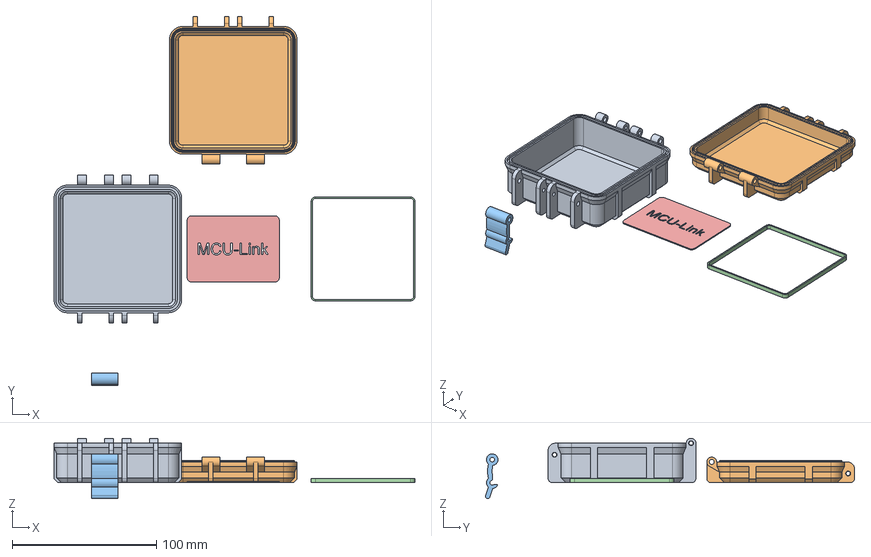
[picture p61: CAD file, 2026-02-08]
MCU-Link/Pro/rugged enclosure/MCU-Link-Pro-RuggedBox.fcstd
250.3 x 256.0 x 41.9 mm
BoxBody
LidBody
Latch2
StackingInsert
NamePlate
