ErichStyger/mcuoneclipse/Examples/KDS/tinyK20/tinyK20_HSLU_ConferenceStation/3D and Laser/Original Rev 1/Raendelschrauben.stl

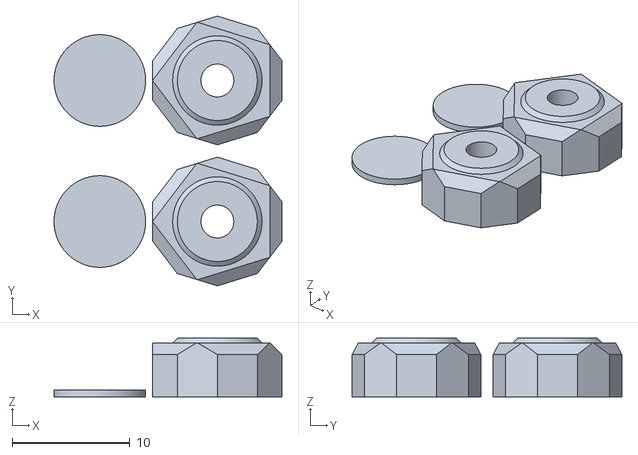
[picture p62: CAD file, 2020-08-05]
Examples/KDS/tinyK20/tinyK20_HSLU_ConferenceStation/3D and Laser/Original Rev 1/Raendelschrauben.stl
19.4 x 23.0 x 5.00
