ErichStyger/mcuoneclipse/Examples/MCUXpresso/LPC845-BRK/LPC845-BRK_StepperClock/3D/hands.stl

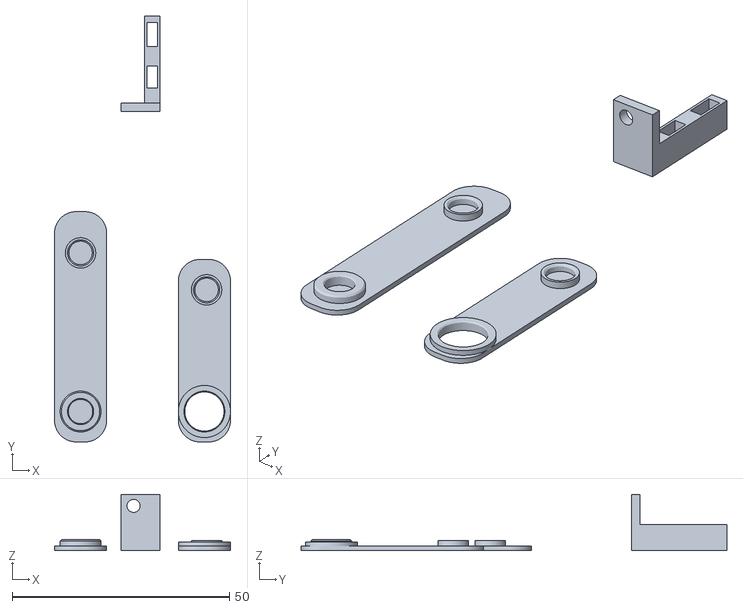
[picture p63: CAD file, 2019-08-25]
Examples/MCUXpresso/LPC845-BRK/LPC845-BRK_StepperClock/3D/hands.stl
40.5 x 98.0 x 13.0
