ErichStyger/mcuoneclipse/MCU-Link/McuLink Enclosure/Rugged-Box/MCU-Link_Top.stl

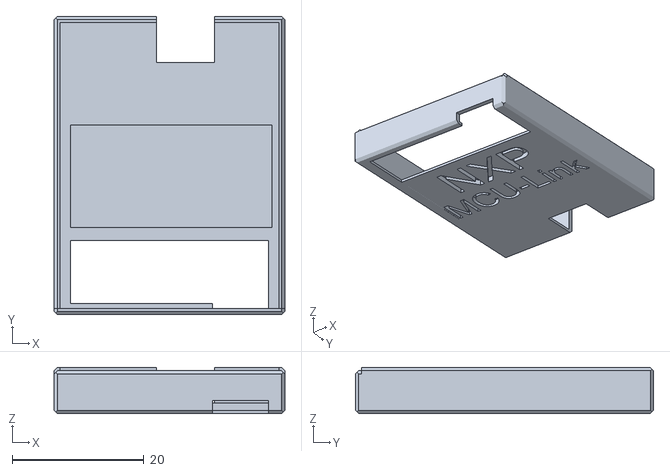
[picture p64: CAD file, 2025-12-31]
MCU-Link/McuLink Enclosure/Rugged-Box/MCU-Link_Top.stl
35.0 x 45.2 x 7.00
