ErichStyger/mcuoneclipse/MCU-Link/Pro/rugged enclosure/MCU-Link-Pro-RuggedNamePlate.stl

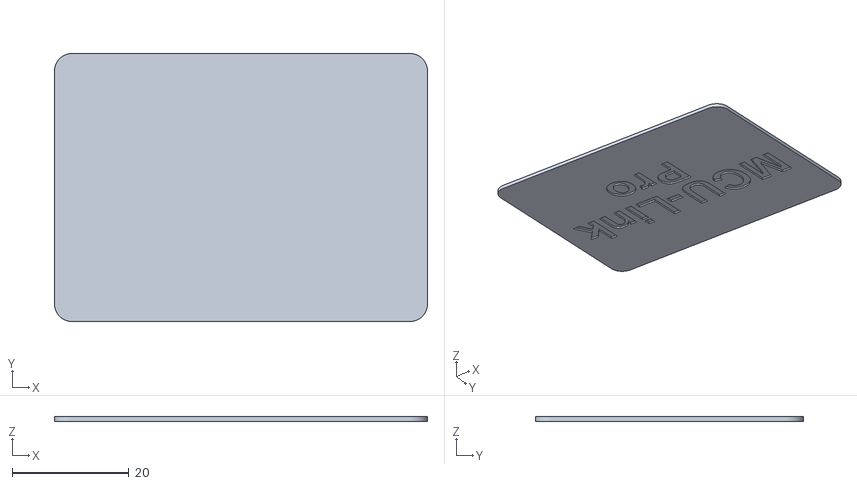
[picture p65: CAD file, 2026-02-08]
MCU-Link/Pro/rugged enclosure/MCU-Link-Pro-RuggedNamePlate.stl
64.0 x 46.0 x 0.8
