ErichStyger/mcuoneclipse/Examples/KDS/tinyK20/tinyK20_HSLU_ConferenceStation/3D and Laser/Original Rev 1/CameraDome.stl

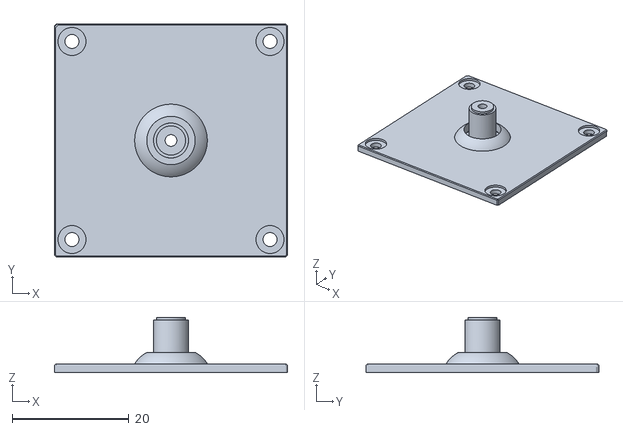
[picture p66: CAD file, 2020-08-05]
Examples/KDS/tinyK20/tinyK20_HSLU_ConferenceStation/3D and Laser/Original Rev 1/CameraDome.stl
40.0 x 40.0 x 9.50
