ErichStyger/mcuoneclipse/Examples/MCUXpresso/LPC845-BRK/LPC845-BRK_StepperClock/3D/BottomGearCounter.stl

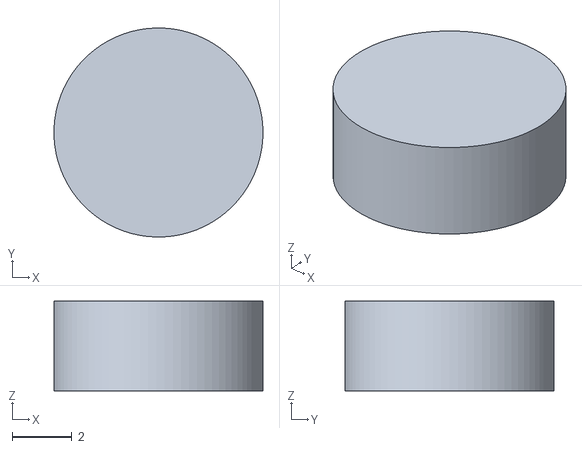
[picture p67: CAD file, 2019-08-23]
Examples/MCUXpresso/LPC845-BRK/LPC845-BRK_StepperClock/3D/BottomGearCounter.stl
7.00 x 7.00 x 3.00
