ErichStyger/mcuoneclipse/MCU-Link/McuLink Enclosure/Rugged-Box/MCU-Link-RuggedLid.stl

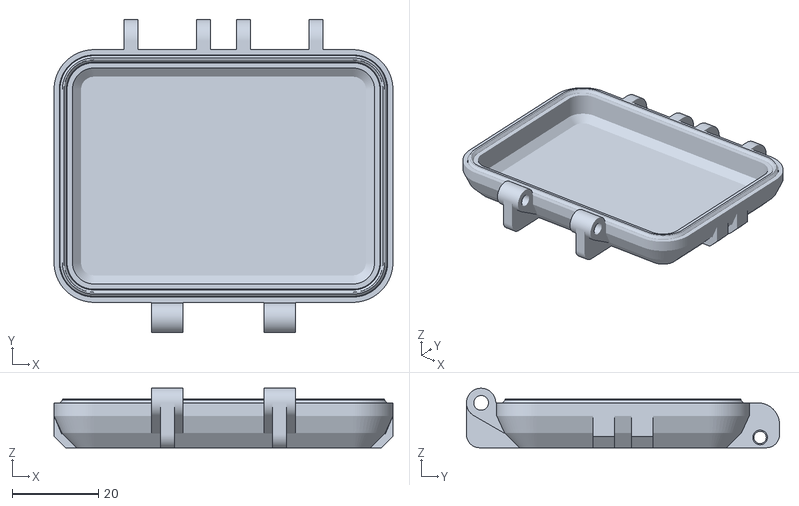
[picture p68: CAD file, 2025-12-25]
MCU-Link/McuLink Enclosure/Rugged-Box/MCU-Link-RuggedLid.stl
78.5 x 72.5 x 13.8
