ErichStyger/mcuoneclipse/MCU-Link/Pro/rugged enclosure/MCU-Link-Pro-RuggedStackingInsert.stl

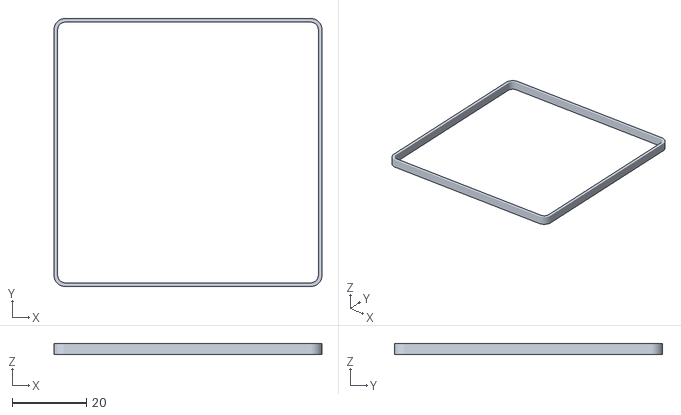
[picture p69: CAD file, 2026-01-20]
MCU-Link/Pro/rugged enclosure/MCU-Link-Pro-RuggedStackingInsert.stl
72.0 x 72.0 x 3.00
