ErichStyger/mcuoneclipse/Examples/KDS/tinyK20/tinyK20_HSLU_ConferenceStation/3D and Laser/Original Rev 1/AluRodConnector.stl

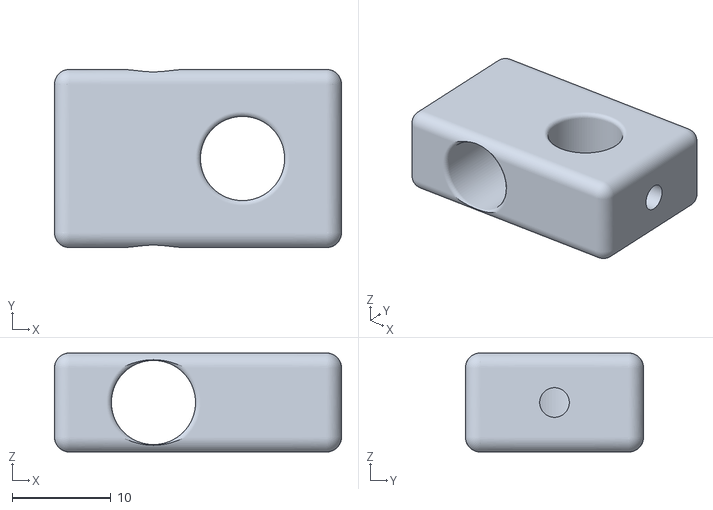
[picture p70: CAD file, 2020-08-05]
Examples/KDS/tinyK20/tinyK20_HSLU_ConferenceStation/3D and Laser/Original Rev 1/AluRodConnector.stl
29.0 x 18.0 x 10.0
