ErichStyger/mcuoneclipse/Examples/MCUXpresso/LPC845-BRK/LPC845-BRK_StepperClock/3D/MotorGear8Teeth.stl

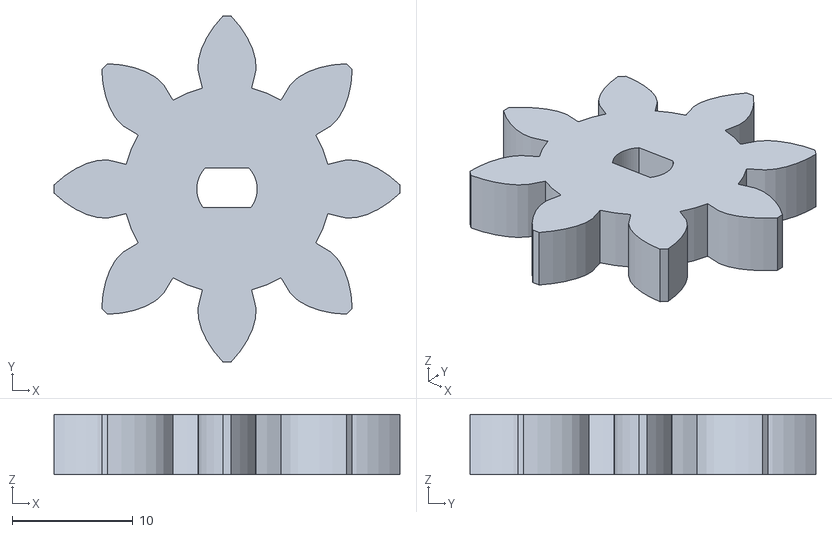
[picture p71: CAD file, 2019-08-23]
Examples/MCUXpresso/LPC845-BRK/LPC845-BRK_StepperClock/3D/MotorGear8Teeth.stl
28.6 x 28.6 x 5.00
