ErichStyger/mcuoneclipse/MCU-Link/McuLink Enclosure/Rugged-Box/MCU-Link-RuggedLatch.stl

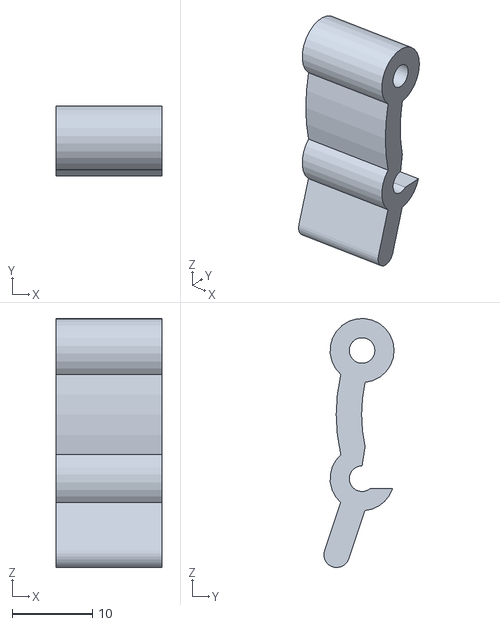
[picture p72: CAD file, 2025-12-25]
MCU-Link/McuLink Enclosure/Rugged-Box/MCU-Link-RuggedLatch.stl
13.2 x 8.77 x 31.1
