ErichStyger/mcuoneclipse/MCU-Link/Pro/rugged enclosure/MCU-Link-Pro-RuggedLatch.stl

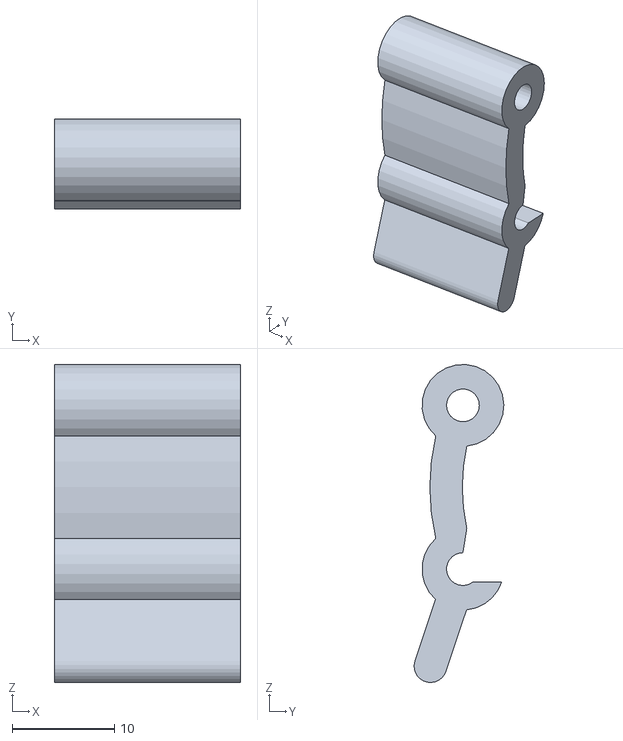
[picture p73: CAD file, 2026-01-20]
MCU-Link/Pro/rugged enclosure/MCU-Link-Pro-RuggedLatch.stl
18.2 x 8.77 x 31.1
