ErichStyger/mcuoneclipse/Examples/KDS/tinyK20/tinyK20_HSLU_ConferenceStation/3D and Laser/Original Rev 1/AluRodEndPiece.stl

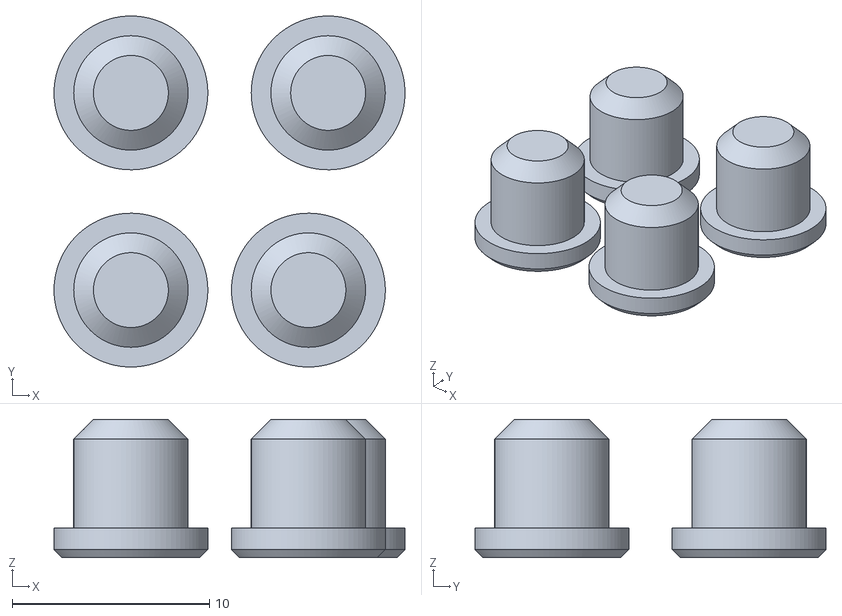
[picture p74: CAD file, 2020-08-05]
Examples/KDS/tinyK20/tinyK20_HSLU_ConferenceStation/3D and Laser/Original Rev 1/AluRodEndPiece.stl
17.8 x 17.8 x 7.00
