ErichStyger/mcuoneclipse/Examples/MCUXpresso/LPC845-BRK/LPC845-BRK_StepperClock/3D/LPC845-Enclosure.stl

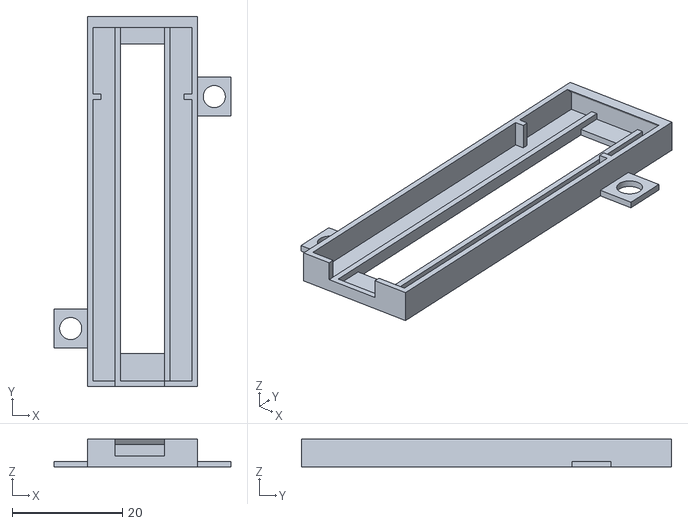
[picture p75: CAD file, 2019-08-23]
Examples/MCUXpresso/LPC845-BRK/LPC845-BRK_StepperClock/3D/LPC845-Enclosure.stl
32.0 x 67.0 x 5.00
