ErichStyger/mcuoneclipse/MCU-Link/McuLink Enclosure/Rugged-Box/MCU-Link-RuggedStackingInsert.stl

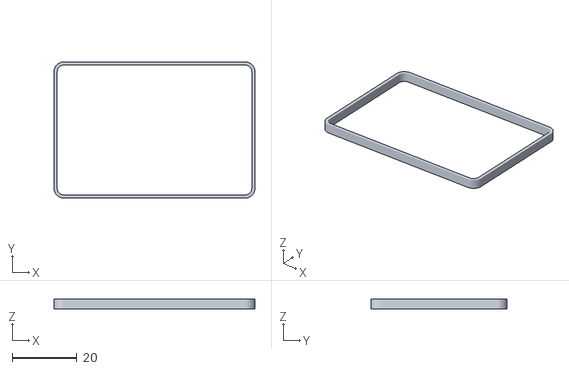
[picture p76: CAD file, 2025-12-25]
MCU-Link/McuLink Enclosure/Rugged-Box/MCU-Link-RuggedStackingInsert.stl
62.0 x 42.0 x 3.00
