ErichStyger/mcuoneclipse/Examples/KDS/tinyK20/tinyK20_HSLU_ConferenceStation/3D and Laser/Original Rev 1/CameraFrontEnclosure.stl

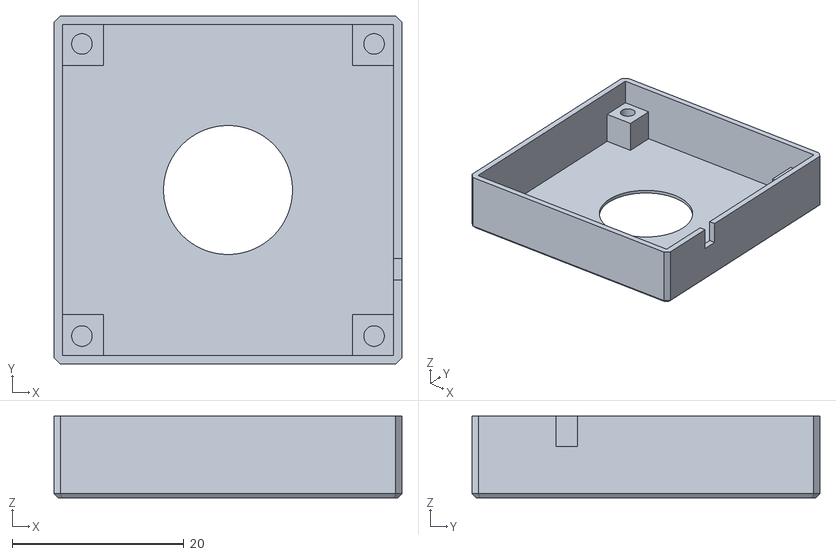
[picture p77: CAD file, 2020-08-05]
Examples/KDS/tinyK20/tinyK20_HSLU_ConferenceStation/3D and Laser/Original Rev 1/CameraFrontEnclosure.stl
40.5 x 40.5 x 9.50
