ErichStyger/mcuoneclipse/Examples/MCUXpresso/LPC845-BRK/LPC845-BRK_StepperClock/3D/RTCHolder.stl

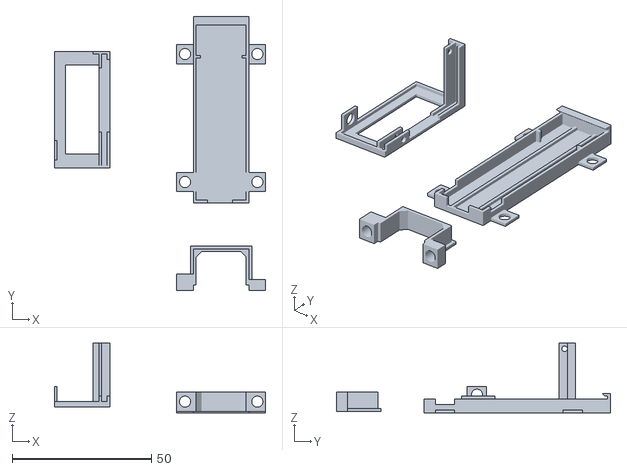
[picture p78: CAD file, 2019-08-20]
Examples/MCUXpresso/LPC845-BRK/LPC845-BRK_StepperClock/3D/RTCHolder.stl
76.0 x 98.5 x 25.0
