ErichStyger/mcuoneclipse/Examples/MCUXpresso/LPC845-BRK/LPC845-BRK_StepperClock/3D/Model_Bearing.stl

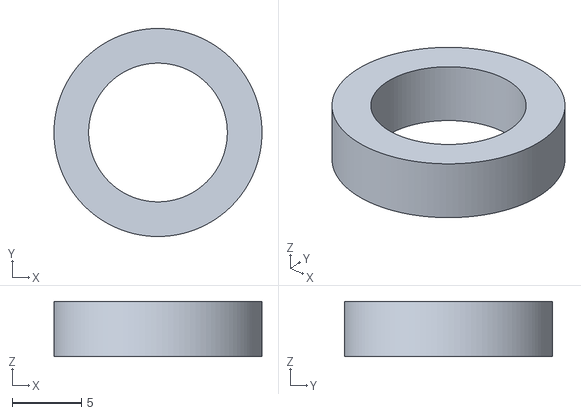
[picture p80: CAD file, 2019-08-11]
Examples/MCUXpresso/LPC845-BRK/LPC845-BRK_StepperClock/3D/Model_Bearing.stl
15.0 x 15.0 x 4.00
