ErichStyger/mcuoneclipse/Examples/MCUXpresso/LPC845-BRK/LPC845-BRK_StepperClock/3D/pd-gears-6teeth.stl

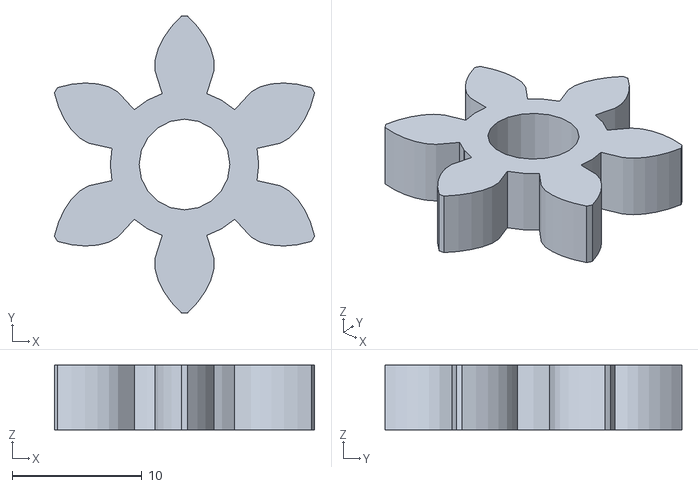
[picture p81: CAD file, 2019-08-11]
Examples/MCUXpresso/LPC845-BRK/LPC845-BRK_StepperClock/3D/pd-gears-6teeth.stl
20.1 x 22.9 x 5.00
