ErichStyger/mcuoneclipse/Examples/MCUXpresso/LPC845-BRK/LPC845-BRK_StepperClock/3D/Model_ULN2003_Driver.stl

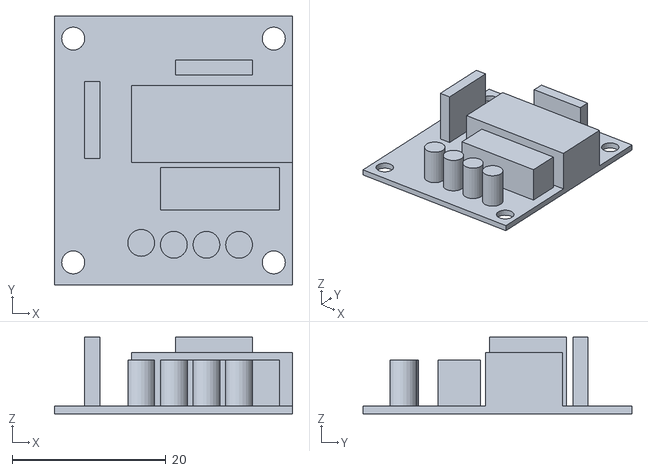
[picture p82: CAD file, 2019-08-11]
Examples/MCUXpresso/LPC845-BRK/LPC845-BRK_StepperClock/3D/Model_ULN2003_Driver.stl
31.0 x 35.0 x 10.00
