ErichStyger/mcuoneclipse/Examples/MCUXpresso/LPC845-BRK/LPC845-BRK_StepperClock/3D/Model_28BYJ-48.stl

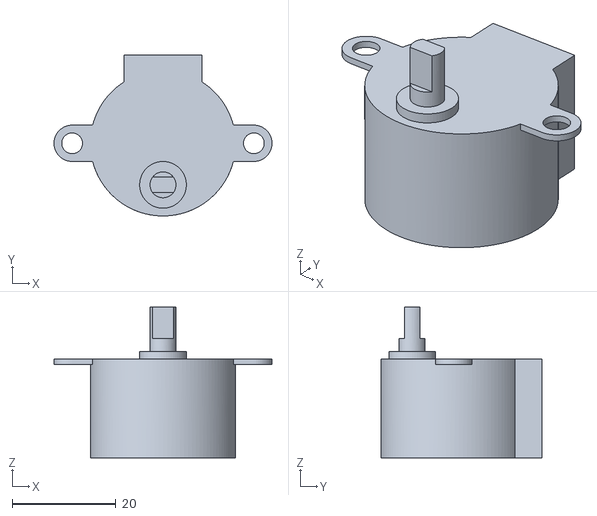
[picture p83: CAD file, 2019-08-11]
Examples/MCUXpresso/LPC845-BRK/LPC845-BRK_StepperClock/3D/Model_28BYJ-48.stl
42.0 x 31.0 x 29.0
