ErichStyger/mcuoneclipse/Examples/MCUXpresso/LPC845-BRK/LPC845-BRK_StepperClock/3D/pd-gears-8teeth.stl

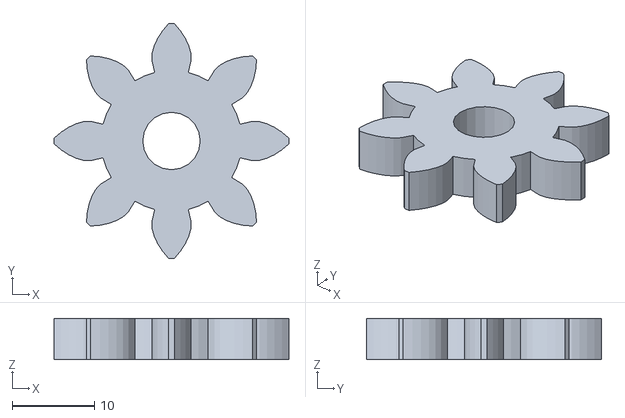
[picture p84: CAD file, 2019-08-11]
Examples/MCUXpresso/LPC845-BRK/LPC845-BRK_StepperClock/3D/pd-gears-8teeth.stl
28.6 x 28.6 x 5.00
