ErichStyger/mcuoneclipse/(list of files, cad)

Other CAD files:
MCU-Link/McuLink Enclosure/Rugged-Box/MCU-Link-RuggedBox.stl
MCU-Link/Pro/rugged enclosure/MCU-Link-Pro-RuggedBox.stl
