ErichStyger/mcuoneclipse/MCU-Link/McuLink Enclosure/3D-Print-in-Place/readme.txt

3D printed 'in-place' enclosure for the NXP MCU-Link.
See https://mcuoneclipse.com/2020/11/29/new-mcu-link-debug-probe-from-nxp/
