ErichStyger/mcuoneclipse/Examples/MCUXpresso/LPC845-BRK/LPC845_Assembly/readme.txt

readme.txt
----------
starting point for assembly-only projects for the LPC845-BRK or other boards.

See
https://mcuoneclipse.com/2023/05/21/creating-a-gnu-assembly-only-project/
