ErichStyger/mcuoneclipse/Examples/KDS/FRDM-KL25Z/FRDM-KL25Z_MusicMaker/readme.txt

readme.txt
----------

Project playing mp3 with the Adafruit MusicMaker Shield, using Kinetis Design Studio.

Links:
- http://mcuoneclipse.com/2014/11/22/tutorial-playing-mp3-files-with-vs1053b-and-frdm-board/
- https://github.com/maniacbug/VS1053
- https://learn.sparkfun.com/tutorials/mp3-player-shield-hookup
- http://garagelab.com/profiles/blogs/tutorial-mp3-player-shield-with-arduino
