ErichStyger/mcuoneclipse/Examples/KDS/FRDM-KL25Z/FRDM-KL25Z_printf/readme.txt

readme.txt
----------
This project demonstrates using printf() and scanf() with Kinetis Design Studio
and the FRDM-KL25Z board.
