ErichStyger/mcuoneclipse/Examples/KDS/FRDM-K64F120M/K64_PEx_Printf/readme.txt

readme.txt
----------
This project demonstrates usage of printf() to the UART on the FRDM-K64F board, using KDS (Kinetis Design Studio).
See
http://mcuoneclipse.com/2014/07/12/printf-for-the-frdm-k64f-board-and-kinetis-design-studio/
http://mcuoneclipse.com/2014/07/11/printf-and-scanf-with-gnu-arm-libraries/
