ErichStyger/mcuoneclipse/Examples/Eclipse/FRDM-KL25Z/FRDM-KL25Z_Printf/readme.txt

readme.txt
----------
This project shows how to use printf() on a physical serial port on the FRDM-KL25Z.
The physical UART is routed to the OpenSDA Virtual USB CDC COM port.
