ErichStyger/mcuoneclipse/Examples/CodeWarrior/FRDM-KL25Z/FRDM-KL25Z_Printer/readme.txt

readme.txt
----------
This project uses CodeWarrior for MCU10.x with the Adafruit Mini Thermal Receipt Printer.
See:
http://mcuoneclipse.com/2014/03/09/tutorial-thermal-printer-part-1-hardware-setup-with-frdm-board/
