ErichStyger/mcuoneclipse/Examples/CodeWarrior/FRDM-KL25Z/FRDM-KL25Z_printf/readme.txt

readme.txt
----------
This project is demonstrating using printf() on the FRDM-KL25Z board, without Processor Expert.

COM port settings:
- UART0, PTA1 and PTA2: this is connected to OpenSDA USB CDC
- 38400 baud

For more information, see:
http://mcuoneclipse.com/2013/04/17/printf-with-the-frdm-kl25z-board-and-without-processor-expert/

If you do not use floating point variables for printf()/scanf(), then the 'INT' version of the libraries can be used.
Otherwise you need the 'FP' version of the libraries.
