ErichStyger/mcuoneclipse/Examples/MCUXpresso/LPC845-BRK/LPC845-BRK_StepperClock/3D/StepperClockWiring.pptx

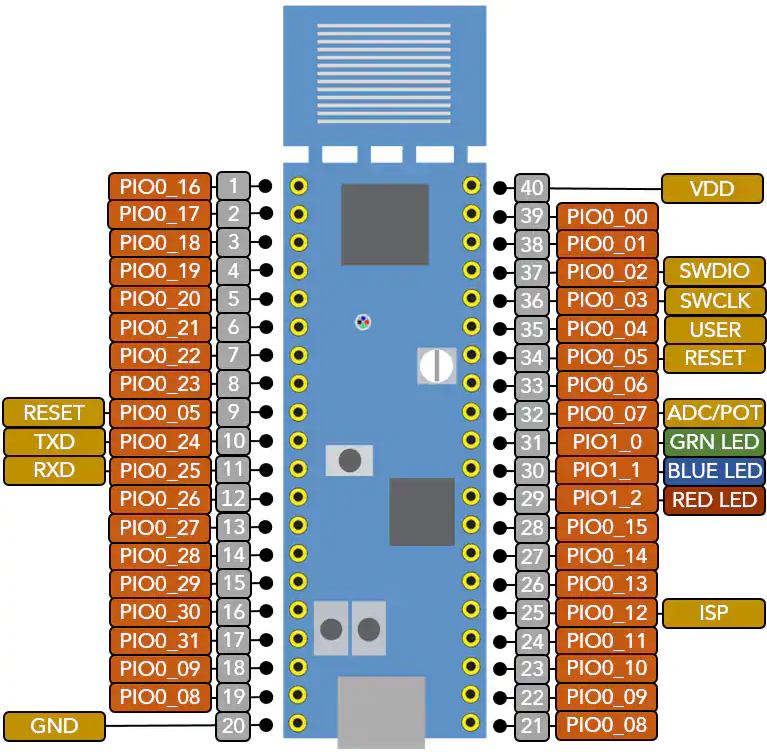
[picture p112: figure]

Mag HH

Mag MM

M1 IN1
M1 IN2
M1 IN3
M1 IN4

I2C SCL

I2C SDA

M2 IN1
M2 IN2
M2 IN3
M2 IN4
