ErichStyger/mcuoneclipse/MCU-Link/McuLink Enclosure/3D-Print-in-Place/McuLink.pdf

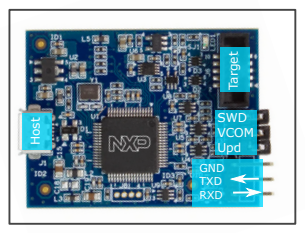
[picture p113: figure]
SWD VCOM Upd; GND TXD RXD; Host; Target
