ErichStyger/mcuoneclipse/tinyK22/V1.3/PCBWay Assembly Service.PNG

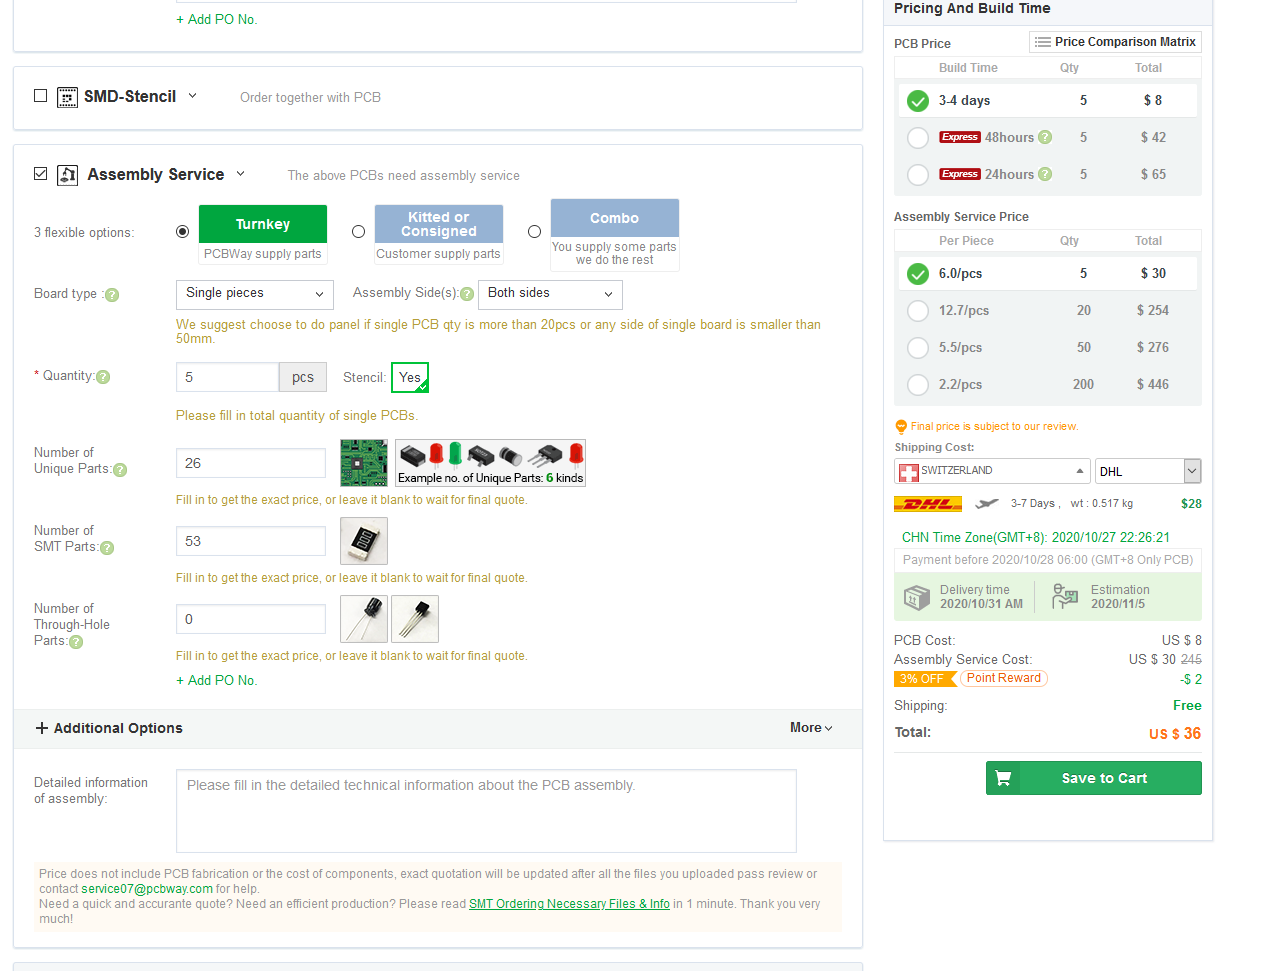
tinyK22/V1.3/PCBWay Assembly Service.PNG
