ErichStyger/mcuoneclipse/Examples/BlackMagicDebugProbe/readme.txt

readme.txt
----------
This folder contains test projects and scripts for the Black Magic Debug (BMP) debug probe.

See:
https://mcuoneclipse.com/2019/06/23/black-magic-open-source-debug-probe-for-arm-with-eclipse-and-gdb/
