ErichStyger/mcuoneclipse/KiCAD/Projects/FT2232_ESP32_Debug/readme.txt

Project to use a FT2232 board to debug the ESP32.

Links:
https://mcuoneclipse.com/2019/10/20/jtag-debugging-the-esp32-with-ft2232-and-openocd/
https://mcuoneclipse.com/2019/11/09/open-source-ftdi-ft2232-jtag-and-uart-adapter-board/
