ErichStyger/mcuoneclipse/(threads)

Thread 14 (2014-06-18):

FATFsMemSDHC throughput issue

dfukumori, 2014-06-18:
Hi Erich,

http://mcuoneclipse.com/2012/07/30/fatfs-with-kinetis/#comment-16199

In the above comment, you mentioned that you weren't seeing any performance benefits using more data pins during SDHC communication. I believe this is due to the way that FATFsMemSDHC implements the disk_read and disk_write functions. Both of these functions use the following block of code to handle transferring multiple blocks to/from the SD card:

do {
      if (SD_TransferBlock(&SD, FALSE, sector*FATM1_BLOCK_SIZE, (uint8_t*)buff, 1)) {
        break;
      }
      sector++;
      buff += FATM1_BLOCK_SIZE;
    } while(--count);

Rather than performing one multi-block I/O operation, the component performs a number of single-block I/O operations. This incurs the SD card's read (or write) access time for each block transferred. A multi-block transfer would only incur this cost once.

I tested using 4-pin communication at 24MHz. A single 512-byte block read takes about 660us -- about 40us for the data transfer and 620us for the card-specific read access time. With the original disk read_function, reading n blocks takes n*(620us + 40us). I made some minor changes to disk_read and SD_TransferBlock so that they attempt to make a single multi-block read. Using the modified function, I saw times much closer to the ideal value of 620us + n*40us for n blocks.

hanwannian, 2015-08-21:
if you use bigger block sizes and larger transfers you’ll get speed increases…. 10MB or 100MB files will run faster.

hanwannian, 2015-08-21:
if you use bigger block sizes and larger transfers you’ll get speed increases…. 10MB or 100MB files will run faster.

hanwannian, 2015-08-21:
I use the component more in SPI mode, and not much with SDHC. However, sometimes I have seen strange issues with SDHC, which appeard and then disappeared. I was never able to track it down :-(. looks like what you report could be the issue?

ErichStyger, 2015-08-21:
As for SDHC, I even believe this could be some kind of silicon bug. I had sometimes issues too, not working it properly, but never found out why.

Closed 2015-08-21.

Thread 23 (2015-07-07):

PE LED error on copy from KDS200 to KDS300 project

neilh10, 2015-07-07:
Image of LedRedCopied:LED from KDS200 project.
It has error on Properties.Hw Interface. Pin "Error in the inherited component setting"
On attempting to change the Pin it can't find a suitable component
(Using KDS300 with latest mcuOnEclipse 05-July-2015 Release)
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

If the LED is started from new it works OK
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

ErichStyger, 2015-07-08:
Ok, I see that problem on my end too. It seems to be related with the new Processor Expert component repositories. I have filed a bug report about this at Freescale.

ErichStyger, 2015-11-20:
I have not heard from Freescale about a resolution of this issue.

Closed 2015-11-20.

Thread 25 (2015-12-18):

FreeRTOS needs Shell named as CLS1

r-ben, 2015-12-18:
With the recent PEComponents from 2015-11-22, FreeRTOS needs the enabled shell named as CLS1.

The compiler throws 2 errors, if I name my shell e.g. SH1:

    arm-none-eabi-g++ -mcpu=cortex-m0plus -mthumb -Os -fmessage-length=0 -fsigned-char   -ffunction-sections -fdata-sections -ffreestanding -Wall -Wextra  -g -T ...
    ./Generated_Code/FRTOS1.o: In function `PrintTaskList':
    ./Generated_Code/FRTOS1.c:186: undefined reference to `CLS1_SendStr'
    ./Generated_Code/FRTOS1.c:219: undefined reference to `CLS1_SendStr'
    collect2: error: ld returned 1 exit status

If I rename the shell to CLS1, everything is fine and the code is working.

ErichStyger, 2015-12-22:
Thank you very much for reporting this!
I have fixed it now and the commited it:
https://github.com/ErichStyger/McuOnEclipse_PEx/commit/a37a02504fc7e5a6e6760d56eb8eb9fd6ae83ffb

Closed 2015-12-22.

Thread 27 (2016-02-18):

FreeRTOS component fails to reload

nlem, 2016-02-18:
Hi Erich,
I have the latest set of pex components from sourceforge (5th feb). I am developing on kinetis K10 using KDS.
It all seems to work great until I shut down KDS.
When I restart KDS it is unable to load the list of components.

I am using the FreeRTOS component which also imports the Utility Component.
The only way I can get processor expert components back is to manually delete the Freertos bean from the pe file in the project.

There is an error generated when the components fail to load.
It look like this:
java.lang.NoSuchMethodError: com.processorexpert.core.repositories.PartialComponentReference.matches(Lcom/processorexpert/core/repositories/IComponentReference;Z)Z

Can you help me?

Thanks,
Nick

ErichStyger, 2016-02-18:
Hi Nick,
that's strange, never seen this. Do you have Kinetis SDK components enabled/present? Can you check (maybe disabel) component repositories? Go to Help > Preferences > Processor Expert >
Repositories and Paths and disable the ones you don't need?
Let me know if this helps.
If not, can you provide me your .pe file so I can try it on my side?
Erich

ErichStyger, 2016-02-18:
The other idea:
shut down KDS, delete C:\ProgramData\Processor Expert\PECache and see if this helps?

nlem, 2016-02-18:
Components look like this:
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
The KSDK components are installed but I don't think I'm using any of them?
The KSDK part of Freertos is disabled.
I think it breaks whether it's enabled or not.
Tried deleting the PECache and disabling repositories and it didn't seem to fix it.

Should also have mentioned that I updated KDS a few days ago to the latest version.

PE file is linked below:
[ProcessorExpert.txt](https://github.com/ErichStyger/mcuoneclipse/files/136389/ProcessorExpert.txt)

ErichStyger, 2016-02-18:
Your screenshot is too small to read it :-(.
The Kinetis SDK components/repositories do come with a FreeRTOS component with the same name. I was thinking that there could be a naming conflict, that's why I think disabling the Kinetis SDK component repositories could make a difference.
Updating KDS should not be the problem (I have an updated version too).

nlem, 2016-02-18:
Tried with the SDK repo's removed.
All the SDK components went away, but doesn't seem to fix it.

If it's any help, when it's loading the components it initially shows the correct list (as above) and then the list goes away and it prints the error I mentioned.

ErichStyger, 2016-02-18:
If you move the mouse over the FreeRTOS component, it shows you the repository. Is it the same as for the others (like the utility)?
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

nlem, 2016-02-18:
Looks just like yous except the repository is "My Components".
Also tried renaming the Freertos component in the SDK repositories just in case and that didn't help.

ErichStyger, 2016-02-18:
Can you disable all your other repositories? Like this:
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
Even if you don't use SDK repositories, components from it might still be reloaded (I think)

nlem, 2016-02-18:
Already tried it.
Whole bunch of components went away but still doesn't load.
Does that PE file look right to you?

I think my next step might be to start a new project from scratch with just FreeRTOS in it.
See if I can track down where it goes wrong.

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

ErichStyger, 2016-02-18:
FYI, your .pe file works for me. So I still think there must be something with your other repositories?

nlem, 2016-02-18:
OK.
if it works for you it must be something in the setup here.
I'll muck around with it some more.

Thanks for you help.

nlem, 2016-02-26:
Not sure it's any help but I get the same error from the SD card component when reloading the project.

nlem, 2016-02-26:
Ended up re installing KDS and PEX.
Problem went away.
Thanks for your help anyway.

ErichStyger, 2016-02-26:
ok, good to hear that the problem is solved.

Closed 2016-02-26.

Thread 28 (2016-02-28):

SD_Card Component Doesn't allow selection of CS pin in SPIMaster_LDD

nlem, 2016-02-28:
Hi Again Erich,

I'm using the SD_Card component driving an SPIMaster_LDD component.
The settings for SD_Card allow you to select the attribute sets to use for fast and slow mode.
That all seems to work.

The problem is that the attribute set number is used for selecting the CS line.
For example, if you use 0 for slow and 1 for fast, PEX emits the following:

#define SD1_SPI_SetSlowMode()              (void)SM2_SelectConfiguration(SM2_DeviceData, 0, 0)
#define SD1_SPI_SetFastMode()              (void)SM2_SelectConfiguration(SM2_DeviceData, 1, 1)

Unfortunately, most of the time, the user will want to use the same CS pin for both fast and slow mode.
PEX will not let you have 2 different CS configurations with the same pin so it's impossible to make this work.

The fix is to emit the same CS pin for each like below:

#define SD1_SPI_SetSlowMode()              (void)SM2_SelectConfiguration(SM2_DeviceData, 0, 0)
#define SD1_SPI_SetFastMode()              (void)SM2_SelectConfiguration(SM2_DeviceData, 0, 1)

It would also be possible to let the user select the CS pin for fast and slow mode, but I can't think of a situation where different CS pins would be needed.

Thanks,
Nick

ErichStyger, 2016-02-28:
Hi Nick,
In my projects I'm using the same chip select pin both for fast and slow mode. The trick is that you should not set the CS pin the the SPIMaster_LDD: the CS pin is a normal pin and under control of the SD card component, and not of the SPI component. Or in other words: do not let the CS pin toggling by the SPI, this needs to be done by the SD card component.
I hope this helps.

Closed 2016-06-17.

Thread 31 (2016-05-06):

CriticalSection bug

fbstj, 2016-05-06:
I've found a bug that I've [reported on the forum](https://mcuoneclipse.com/2016/04/03/mcuoneclipse-components-3-apr-2016-release/#comment-82602) I thought I'd report it here too, since it'll look nicer

Updating CriticalSection (CS1) to 1.008 seems to cause the SDHC sub-component of my FAT_FileSystem/FatFsMemSDHC break. it somehow decides that sdhc1_SetWriteProtecton is ill-defined??

```
‘Building file: ../Generated_Code/SDHC1.c’
‘Invoking: Cross ARM C Compiler’
arm-none-eabi-gcc -mcpu=cortex-m4 -mthumb -O0 -fmessage-length=0 -fsigned-char -ffunction-sections -fdata-sections -g3 -I”C:/Code/kinetis/SF4V/Static_Code/PDD” -I”C:/Code/kinetis/SF4V/Static_Code/IO_Map” -I”C:/Code/kinetis/SF4V/Sources” -I”C:/Code/kinetis/SF4V/Generated_Code” -std=c99 -MMD -MP -MF”Generated_Code/SDHC1.d” -MT”Generated_Code/SDHC1.o” -c -o “Generated_Code/SDHC1.o” “../Generated_Code/SDHC1.c”
../Generated_Code/SDHC1.c:1474:12: error: conflicting types for ‘SDHC1_SetWriteProtection’
LDD_TError SDHC1_SetWriteProtection(LDD_TDeviceData *DeviceDataPtr, LDD_SDHC_TWriteProtectType Type, uint32_t Address, bool Protected)
^
In file included from ../Generated_Code/FATM1.h:64:0,
from ../Generated_Code/SDHC1.c:129:
../Generated_Code/SDHC1.h:597:12: note: previous declaration of ‘SDHC1_SetWriteProtection’ was here
LDD_TError SDHC1_SetWriteProtection(LDD_TDeviceData *DeviceDataPtr, LDD_SDHC_TWriteProtectType Type, uint32_t Address, bool Protected);
^
make: *** [Generated_Code/SDHC1.o] Error 1
```

the problem is here:

```diff
-/* Include shared modules, which are used for whole project */
-#include “PE_Types.h”
-#include “PE_Error.h”
-#include “PE_Const.h”
-#include “IO_Map.h”
/* Include inherited beans */
+#include “KSDK1.h”

-#include “Cpu.h”
–
+#if KSDK1_SDK_VERSION_USED == KSDK1_KSDK1_SDK_VERSION_NONE
+/* Include shared modules, which are used for whole project */
+ #include “PE_Types.h”
+ #include “PE_Error.h”
+ #include “PE_Const.h”
+ #include “IO_Map.h”
+ #include “Cpu.h”
+#endif
```

`KSDK1_KSDK1_SDK_VERSION_NONE` has an extra `KSDK1_`

ErichStyger, 2016-05-06:
Hello,
thanks for reporting. Indeed, that was a copy-paste error :-(.
I have found this one too (the same copy-paste mistake is as well in other components :-(). I have it already fixed on GitHub (https://github.com/ErichStyger/McuOnEclipse_PEx/blob/master/Drivers/sw/CriticalSection.drv), but I had no time yet to release the new components. If time permits, I'll release them this weekend.
Erich

ErichStyger, 2016-05-08:
I have released a new version of the components which has this fixed.
Thanks again for reporting it!
Erich

fbstj, 2016-05-09:
Thank you for the quick fix! this set of components is so useful you're doing such a great service to us users of these chips!

fbstj, 2016-05-09:
OK after upgrading all the components to the latest releases (CriticalSection still reports as 1.008 even tho it's changed since the last but *shrugs*) but I'm still getting the error on SDHC1

fbstj, 2016-05-09:
Reverting various changes until it works, I find that updating the Timeout component from 1.030 to 1.035 also breaks things

ErichStyger, 2016-05-09:
I have not seen so far issues with that new Timeout component :-(
Any details you could provide?

fbstj, 2016-05-09:
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

is there any other numbers that would be useful? any hints as to where I should look for more useful info than version numbers? I'm using an MK60DN512VMD10 here's the components view

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

they're all updated to the 2016-05-08 release, except the timeout and cs1 which are at 2015-10-17 (using your multi-repository method) if I try to change either to 2016-05-08 (or change the CS to 2016-04-03) it fails to compile with the above error around SDHC1_SetWriteProtection (changing the timeout to 2016-04-03 doesn't cause any problems.

the only differences I can see between the generated code are related to those `+#if KSDK1_SDK_VERSION_USED == KSDK1_SDK_VERSION_NONE` blocks around the header includes, the CS1's were added and then fixed, the utils ones were fixed for the latest release.

ErichStyger, 2016-05-09:
Ok, I'm able to reproduce the problem :-(. The issue is because with the SDK changes different declaration of type 'bool' could happen :-(.
I have fixed it that way:
https://github.com/ErichStyger/McuOnEclipse_PEx/commit/5ddff476d34b6058febbeaab6e434891b461a29d
I think you should be able to make that change in the file you have installed on your end? Can you try if this solves your problem too?

Thanks,
Erich

fbstj, 2016-05-10:
That does seem to have fixed error. thanks for all your help !! now all my components are on the latest releases.

ErichStyger, 2016-05-10:
Thanks for the confirmation!

Closed 2016-05-10.

Thread 32 (2016-06-27):

FreeRTOS compile issue

Erdyke, 2016-06-27:
Running FreeRTOS bean on Codewarrior (MCU) for DEMO09S08DZ60 board.  Bean settings are default.

1) Looks like function "UBaseType_t FRTOS_AppGetRuntimeCounterValueFromISR(void)" is being re-declared because of a different return value type.

2) Also enabling Custom portBASE_TYPE seems to totally mess up the compiler in that I get error "C1067 missing decl specifiers" and error "C2450 Expected ;" at Line 181: "BaseType_t xPortStartScheduler( void ) PRIVILEGED_FUNCTION;" in "portable.h"

ErichStyger, 2016-06-27:
I have not used it for S08 for a while. So it could be that something is broken. I'll have a look and report back.

ErichStyger, 2016-06-27:
Hi Erdyke,
Indeed, things are broken for S08 if using a dedicated timer :-(.
I have commited a fix here: https://github.com/ErichStyger/McuOnEclipse_PEx/commit/b55ffa579e596494b1dd2396cb4e9f532e6618b1
Can you check if this solves the problem on your side as well?

I appologize for the issue,
Erich

Erdyke, 2016-06-27:
Will do,

Regards,
Eric Dyke

ErichStyger, 2016-06-27:
Hi Eric,
I have fixed as well the secone issue with custom base types:
https://github.com/ErichStyger/McuOnEclipse_PEx/commit/7362338383bf2912081df7fdfa026b12c48b8a7c

Sorry as well for this issue, I have never used custom base types :-(.

Let me know if this is fixed on your side too so I can close this issue.

Thanks,
Erich

Erdyke, 2016-06-27:
Thanks. I will need to get to it tonight.

Erdyke, 2016-06-28:
The first fix allows things to compile fine.  I have not tested the other fix.
I'm pretty new to FreeRTOS so I will need to play around with it on my demo board to see how it runs with the default settings.  Thanks for all the work you do!

ErichStyger, 2016-06-29:
Thanks, and you are welcome. I'm closing the issue now. Be free to report if there are any problems or if there is anything to reopen the issue.

Erdyke, 2016-06-30:
Perhaps I'm missing something, but I cannot get a regular LED demo to run using default settings with a task delay of 500 ms.  Do I need to do anything with the events created from the bean?

ErichStyger, 2016-06-30:
No, nothing special to set up, and no special event handling needed. Below some code:

static void AppTask(void* param) {
  for(;;) {
      LED1_Neg();
     vTaskDelay(pdMS_TO_TICKS(500));
  }
}

  if (xTaskCreate(AppTask, "App1", configMINIMAL_STACK_SIZE, NULL, tskIDLE_PRIORITY, NULL) != pdPASS) {
    for(;;){} /* error case only, stay here! */
  }
  vTaskStartScheduler(); /* start the RTOS, create the IDLE task and run my tasks (if any) */

Erdyke, 2016-06-30:
As before, it looks like the tasks are getting created okay and are executed.  I can set a breakpoint at the LED1_NegVal(); and see we get there each time.  But there doesn't seem to be any real delay.  I'm instantly returned to the BP after continuing.

Erdyke, 2016-06-30:
In case it's useful, I uploaded my project: https://github.com/Erdyke/FreeRTOS-DEMO

ErichStyger, 2016-06-30:
Yes, that's useful. I don't have that S08 device, but I think I have found your issue: you have the Software Interrupt not properly configured. It is an older article, but the settings for FreeRTOS still apply, have a look at https://mcuoneclipse.com/2012/06/28/tutorial-freertos-on-demojm/. The swi needs to be configured properly (https://mcuoneclipse.files.wordpress.com/2012/06/assigning-software-interrupt-vector.png?w=584).
The other thing is: your heap is set to 2KByte. That's fine for a few tasks. You might increase that one later.
I hope this helps,
Erich

Erdyke, 2016-06-30:
That's the fix. Thanks for the help. Much Appreciated!

Closed 2016-06-29.

Thread 33 (2016-09-11):

nRF24 project with KDS

AdyiPool, 2016-09-11:
Hello Eirch,

First of all, thank you so much for the amazing blog posts and this GitHub repo. I've been referring to you blog a lot to get up and running with my K64F board.

I want to try your nRF24 [project](https://github.com/ErichStyger/mcuoneclipse/tree/master/Examples/KDS/FRDM-K64F120M/FRDM-K64F_nRF24) with KDS 3.2.0, can you please give me some hint as to how to import the project into KDS? I don't see a .wsd file in the example folder, nor does KDS accent the .pe files. I'm very new to KDS in general so forgive me if I'm overlooking something obvious.

Thanks,
Ady

AdyiPool, 2016-09-11:
If I import an existing project, I can actually build and run the NeoPixel project, but something is wrong with the nRF14 project. Here's the error I get

```
11:03:15 **** Incremental Build of configuration Debug for project FRDM-K64F_nRF24 ****
make -j3 all
Static_Code/System/subdir.mk:23: *** target pattern contains no `%'.  Stop.

11:03:15 Build Finished (took 69ms)

```

and here's line 23 in `subdir.mk`

```
# Each subdirectory must supply rules for building sources it contributes
Static_Code/System/CPU_Init.o: /Applications/KDS_v3.app/Contents/eclipse/C:/nxp/KDS_3.2.0/eclipse/ProcessorExpert/Repositories/Kinetis_Repository/lib/Kinetis/pdd2/MK64FN1M0LL12/system/CPU_Init.c
	@echo 'Building file: $<'
	@echo 'Invoking: Cross ARM C Compiler'
	arm-none-eabi-gcc -mcpu=cortex-m4 -mthumb -mfloat-abi=hard -mfpu=fpv4-sp-d16 -O0 -fmessage-length=0 -fsigned-char -ffunction-sections -fdata-sections  -g3 -I"/Applications/KDS_v3.app/Contents/eclipse/ProcessorExpert/lib/Kinetis/pdd/inc" -I"/Applications/KDS_v3.app/Contents/eclipse/ProcessorExpert/lib/Kinetis/iofiles" -I"/Users/adityatannu/workspace3.kds/FRDM-K64F_nRF24/Sources" -I"/Users/adityatannu/workspace3.kds/FRDM-K64F_nRF24/Generated_Code" -I"/Applications/KDS_v3.app/Contents/eclipse/ProcessorExpert/Repositories/Kinetis_Repository/lib/Kinetis/pdd2/MK64FN1M0LL12/system" -std=c99 -MMD -MP -MF"$(@:%.o=%.d)" -MT"$@" -c -o "$@" "$<"
	@echo 'Finished building: $<'
	@echo ' '
```

ErichStyger, 2016-09-12:
Hi Ady,

Have you installed already the McuOnEclipse Processor Expert components from SourceForge (https://sourceforge.net/projects/mcuoneclipse/files/PEx%20Components/)?

And do not forget to generate code with Processor Expert (context menu on the .pe file in Eclipse).

Let me know if you need any further assistance.

Erich

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

ErichStyger, 2016-09-12:
Hi Ady,

There are no .wsd files, as they are non-standard and require a special plugin.

You can import the projects with the normal Eclipse method (File > import > existing projects into workspace.

Erich

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

Closed 2016-09-26.

Thread 34 (2017-01-06):

Bad cast in gprof for arm

ptrebuc, 2017-01-06:
I try to reuse in a somewhat different context your great work on gprof, and I found a bug in the git hub implementation.

gmon.c:267 frompcindex should not be used but a fresh _uint16t *_ should

p->froms is a u_short *

best regards

ErichStyger, 2017-01-09:
I'm not really sure what you mean? Are you referring to:
https://github.com/ErichStyger/mcuoneclipse/blob/59e5aeffe5d42874f33a9ea5a86669ac7e0958ce/Examples/KDS/FRDM-K64F120M/FRDM-K64F_Profiling/Profiling/gmon.c
?

ptrebuc, 2017-01-09:
yes
line 269
                  *frompcindex = toindex;
at this moment frompcindex contains the address of an element of p->froms.

p->froms is a ushort *
this means that if two function calls are too near the data are corrupted

Am I wrong ?

Best

On Mon, Jan 9, 2017 at 1:27 PM, Erich Styger <notifications@github.com>
wrote:

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

--
Philippe
Le jeu est la forme la plus élevée de la recherche.
        -+- Albert Einstein -+-

ErichStyger, 2017-01-09:
No, you are absolutely correct, this is indeed a bad bug :-(
I have made a fix in https://github.com/ErichStyger/mcuoneclipse/commit/9b7eedddd8b24968128582aedc63be95b61f782c
Thanks for finding it!

Closed 2017-01-09.

Thread 36 (2017-02-25):

Weird Problem when snapshotting components

mstroven, 2017-02-25:
Hello Erich,
I have a strange issue which arose after I made a snapshot of my projects components.  I'm using FreeRTOS 9.0.0 with Segger System Viewer and Command Line shell capabilities.  I can create the components and everything is fine.  I generate code and debug with no issues.  I can run the code and attach with system viewer and it's all good UNTIL.....

I want to get my components into version control without versioning the entire KDS3 repo.  So I have used the snapshot feature to create a repo of only the components needed by my project.  The snapshot seems to work fine, and I can check into my VCS.  However, once the project attempts to reconcile the new repository, there are a couple of problems that I can't seem to resolve.  These are with the UTIL1 component and  the CLS1 component.  Switching the FRTOS1 component back to the original repository seems to correct the issue.

Any ideas?
Best,
-Mike

ErichStyger, 2017-02-26:
Hi Mike,
I have not used the Snapshot feature, so not sure what the issue could be. What kind of problems are you seeing? If using the Snapshot feature with a local repository, have you made sure that you only using that local repository? The setting is under Windows > Preferences > Processor Expert > Repositories and Path.

ErichStyger, 2017-03-19:
Closing as not reproducible on my side (or not enough information).

Closed 2017-03-19.

Thread 39 (2018-02-21):

No re-enable interrupts

Pakequis, 2018-02-21:
When a error is returned the interrupts are not re-enabled in the DHTxx.c.

ErichStyger, 2018-02-21:
thanks for the report, I'll have a look.

ErichStyger, 2018-02-24:
Thanks for catching (and reporting) this problem! Fixed now in https://github.com/ErichStyger/mcuoneclipse/commit/f58cadaa886c4aeee55754e86ef67a8f0e668273
Thanks again,
Erich

Closed 2018-02-24.

Thread 42 (2019-02-15):

PPAGE handling in FreeRTOS port for HCS12X banked memory model

grzsob, 2019-02-15:
Hi Erich,
     I tried to run your FreeRTOS port on MC9 S12XEQ512 with CodeWarrior v5.1 and PE 3.06.
I'm using banked memory model for flash and I've encountered possible issue during context switching. In interrupt from TickCntr1_Interrupt there is call to TickCntr1_OnInterrupt() function. After this call PPAGE register value is changed to the flash page where TickCntr1_OnInterrupt() is located and then portSAVE_CONTEXT macro is called. In effect wrong PPAGE value might be saved and then restored.
In my case issue was fixed by moving portSAVE_CONTEXT macro earlier - to ISR, before call to the TickCntr1_OnInterrupt().
I've checked project settings with example provided by you and they are similar (ie compiler flags that may influence this behaviour).
I'm fairly new to FreeRTOS and S12 family so it's possible that this issue is caused by something else and port unrelated. BTW thanks for all the projects and instructions you share, they all have been incredibly helpful in porting my application and using this IDE.

BR
Grzegorz Sobczyk

ErichStyger, 2019-02-15:
Hi Grzegorz,
thank you for your feedback. I have do admit that I'm not really using S12X any more, but I should still have a board somewhere. And I have used FreeRTOS with S12X only in a small project which was not banked (I believe), so it very well could be something I have missed. From your description it sounds that the Processor Expert code dealing with the tick interrupt should be different, and not sure what I have to change.
Could you provide the pice of source code you have changed so I can follow up on this? Maybe best with clear indication what you have changed where?

Thanks,
Erich

grzsob, 2019-02-18:
Hi Erich,
I attach 2 modified and 2 original files, both generated by PE. Here's what happens in my understanding:
- TickCntr1_Interrupt occurs and program goes to ISR handler, PPAGE register stays intact
- ISR handler calls TickCntr1_OnInterrupt() with CALL instruction and PPAGE register may change if there are multiple flash pages used and this function is on different one than function when interrupt happened.
- portSAVE_CONTEXT macro is called and possibly incorrect PPAGE register is pushed on stack
- at the end of function portRESTORE_CONTEXT macro is called and possibly incorrect PPAGE value is pulled from stack and copied to register which results in jumping to random place in code

Solution would be to move portSAVE_CONTEXT macro to primary ISR handler - before function call(attached files), or move everything to ISR handler (and then remove code that fixes stack with LEAS instructions).

[S12X_issue42.zip](https://github.com/ErichStyger/mcuoneclipse/files/2874503/S12X_issue42.zip)

BR
Grzegorz Sobczyk

ErichStyger, 2019-02-25:
Hi Grzegorz,
thanks for the extra details. I wanted to investigate this last weekend, but did not find the time. I hope because you have found a solution it is not that urgent?

Thanks,
Erich

grzsob, 2019-02-25:
Hi Erich,
 Of course it's not urgent, everything works fine with present
workaround. The only downside is that it has to be applied each time
after every freertos code generation (obviously).

Best Regards

Grzegorz Sobczyk

W dniu 2019-02-25 07:46, Erich Styger napisał(a):

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

Links:
------
[1]
https://github.com/ErichStyger/mcuoneclipse/issues/42#issuecomment-466891146
[2]
https://github.com/notifications/unsubscribe-auth/AtdAdem2tx9AnzOXGaCoNnAvXPhFAerzks5vQ4a6gaJpZM4a9bhm

ErichStyger, 2019-02-25:
You can disable the overwrite if you disable code generation for a component, see https://mcuoneclipse.com/2012/03/23/disable-my-code-generation/

ErichStyger, 2022-01-25:
closing issue: for now disabling code generation should do it.

Closed 2022-01-25.

Thread 51 (2024-08-30):

pico_LedCube - RP2350 support - 12 simultaneous output?

FeuerSturm, 2024-08-30:
Hi,
would it be possible to enhance the pico_LedCube example to support the 12 PIO state machines of the new Pico 2 (RP2350) for 12 parallel outputs?

I'd be seriously interested to try to convert it into an Arduino library and use it as base for my USB HID LED Controller project then.

Thanks in advance!

ErichStyger, 2024-08-30:
Yes, that should be possible. I already have ordered Pico 2 boards, but not received them yet.

FeuerSturm, 2024-08-30:
Sounds great! Looking forward to it, thanks a lot!

Closed 2024-09-09.
