ErichStyger/mcuoneclipse/tinyK22/RevA/tinyK22_Schematics_RevA.pdf

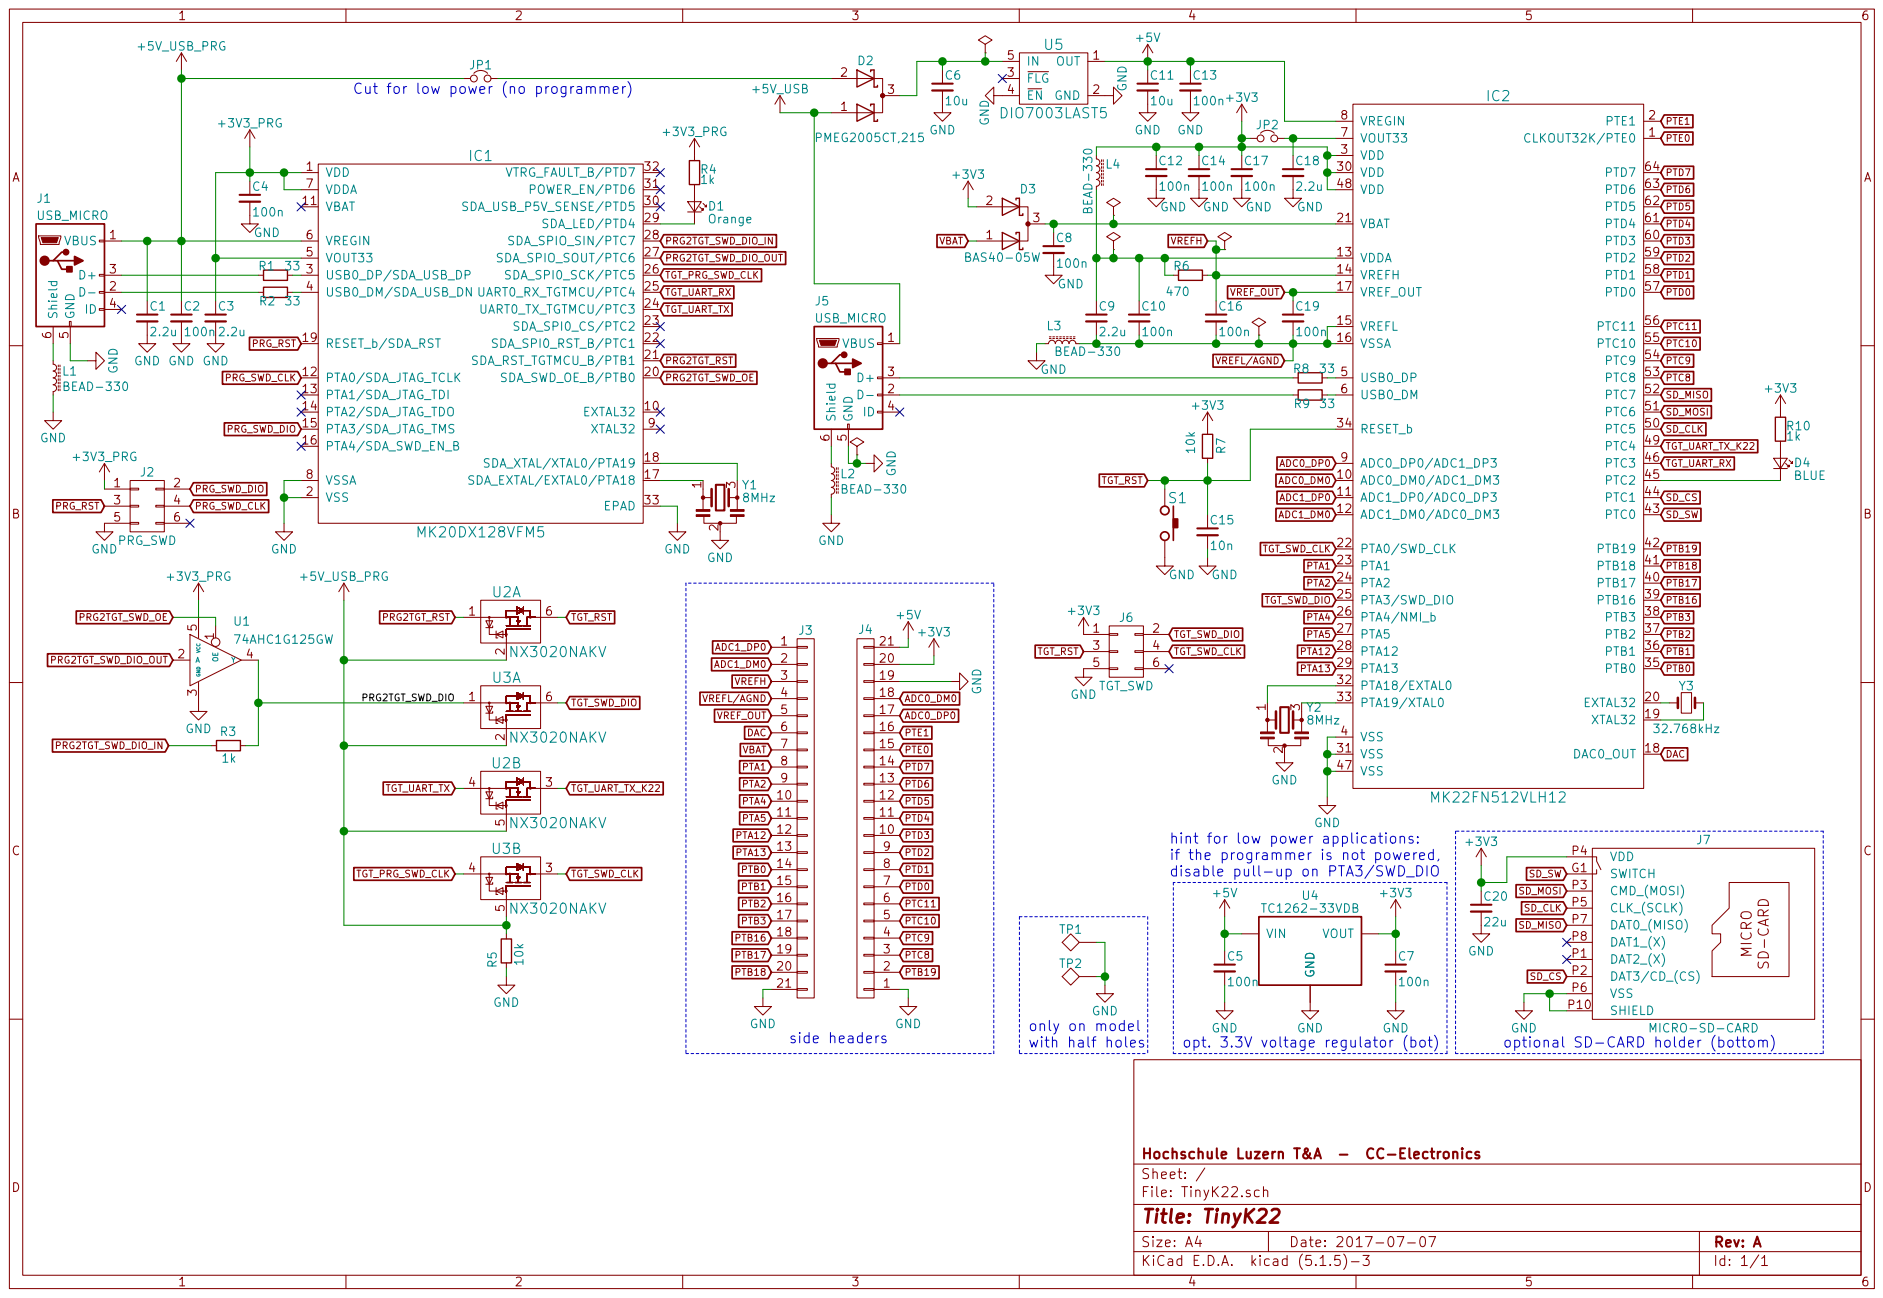
[picture p115: page 1]

PTD1 PRG2TGT_SWD_DIO Cut for low power (no programmer)

hint for low power applications:
if the programmer is not powered,
disable pull-up on PTA3/SWD_DIO

J7 MICRO-SD-CARD GND
22u GND

File: TinyK22.sch Sheet: / Hochschule Luzern T&A - CC-Electronics
