ErichStyger/mcuoneclipse/tinyK20/Board/tinyK20_Schematics V1.0.pdf

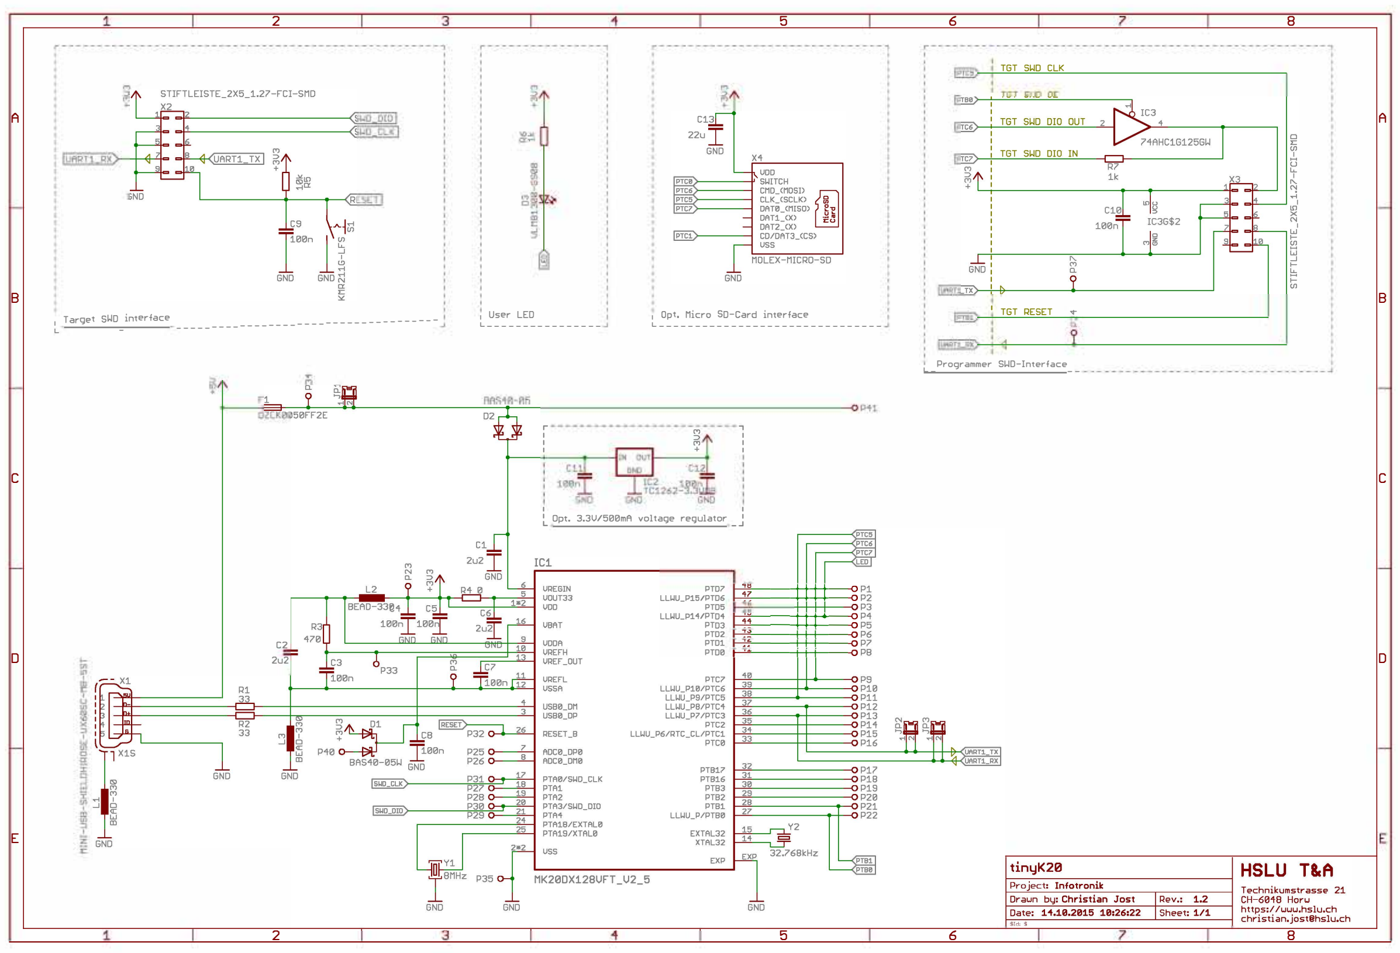
[picture p116: page 1]

A

B

C

D

E

2

TarQet Sl.JD
_

intert

ace

C2

M

2

5

1 User LED | 1 Opt, Micro SD-Card ir>lerface
L---------------- | L-------------------------------
r | ij 1
' | '
Opt. 3.JV/500mfl voltar;ie rer;iulator _J

# LLU_P1/ til==::i::t::i::t=:g LU.JU_P1Vij bl==::t:t:t:':=:g

PTD2 ----!-+-1---0
PTD1 ----!-+-1---0
PTO" ,----++-1---0

5

6

TGT $1-JO CL.K

' TGT RESET ""

L_Progr,...,,.er 51.lD-Intedace __

6

8

A

B

C

D

8

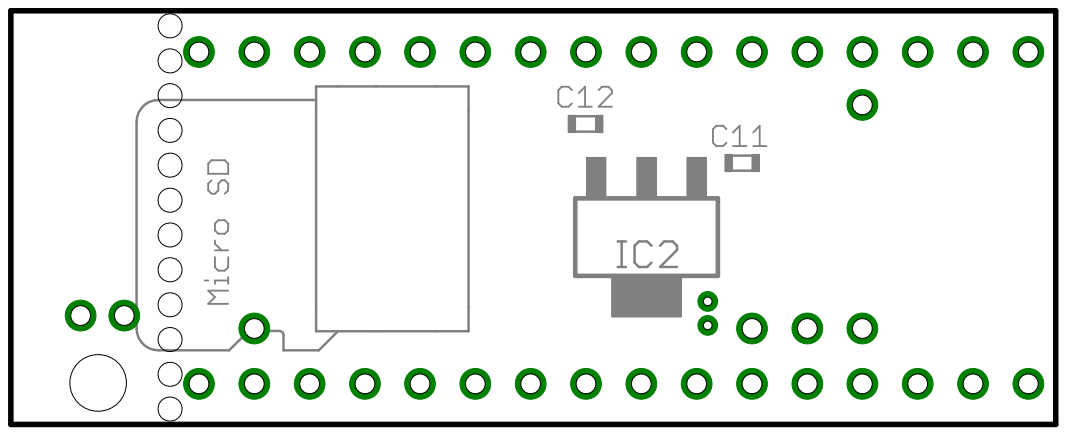
[picture p117: page 2]

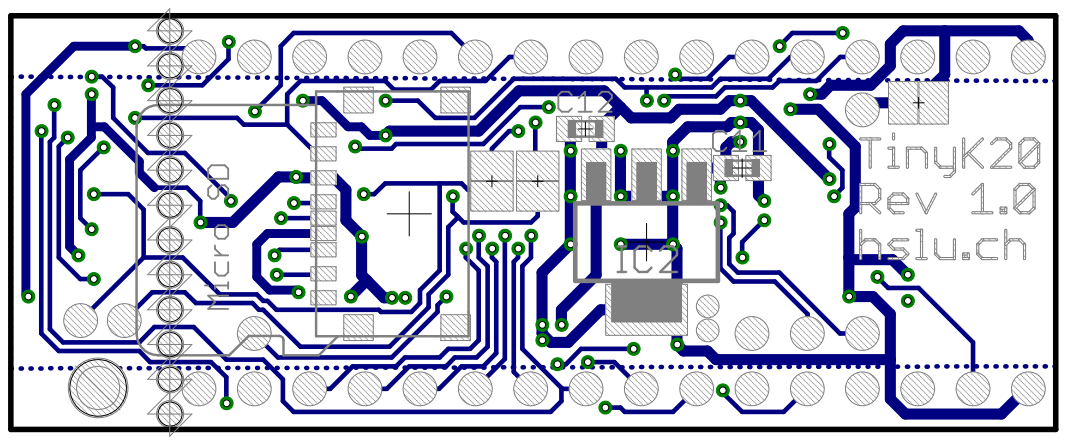
[picture p118: page 3]

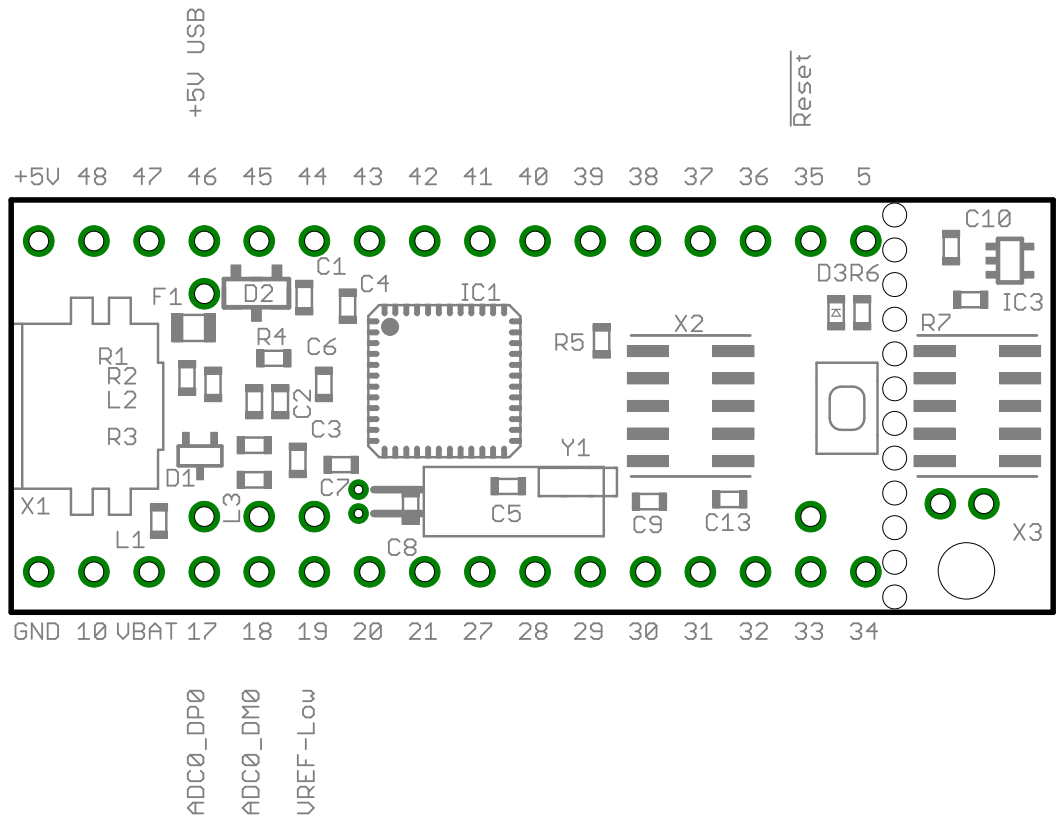
[picture p119: page 4]

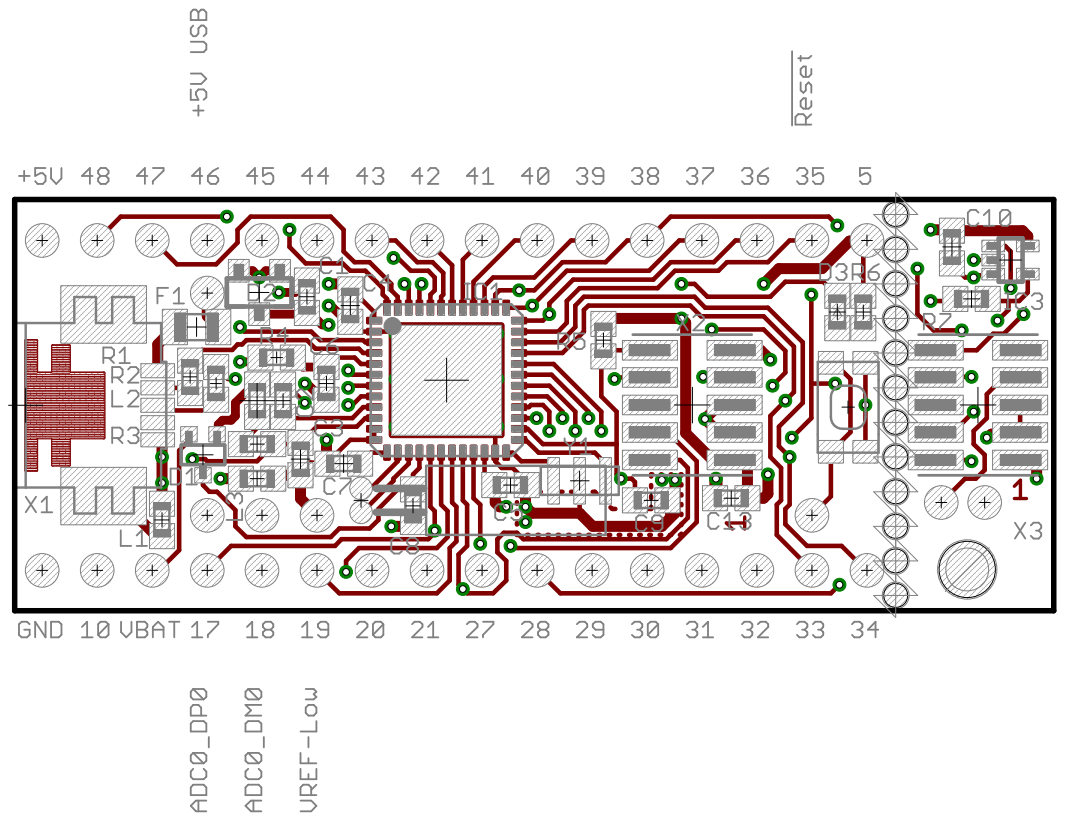
[picture p120: page 5]

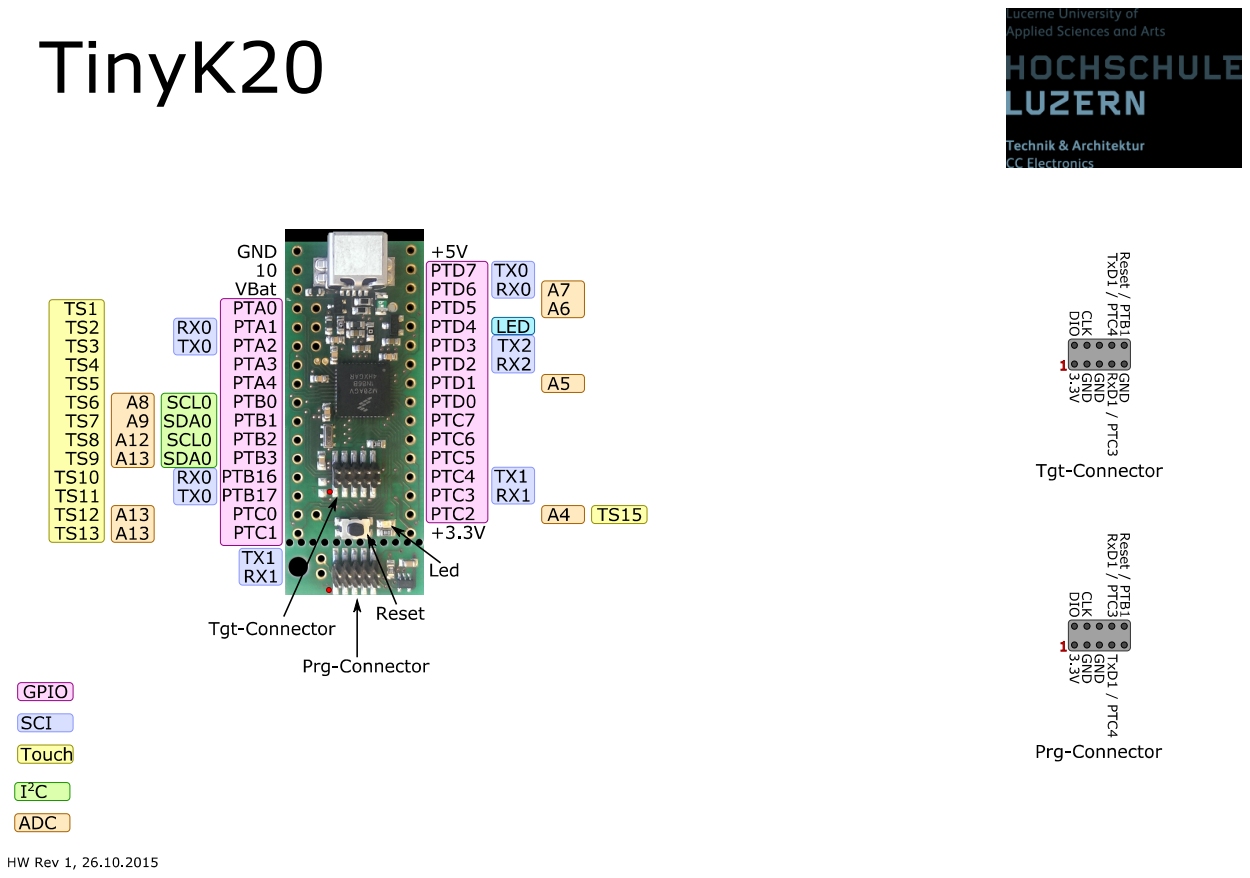
[picture p121: page 6]
