ErichStyger/mcuoneclipse/Eagle/INTRO-Robot K22/INTRO Robot Base Board Schematic.pdf

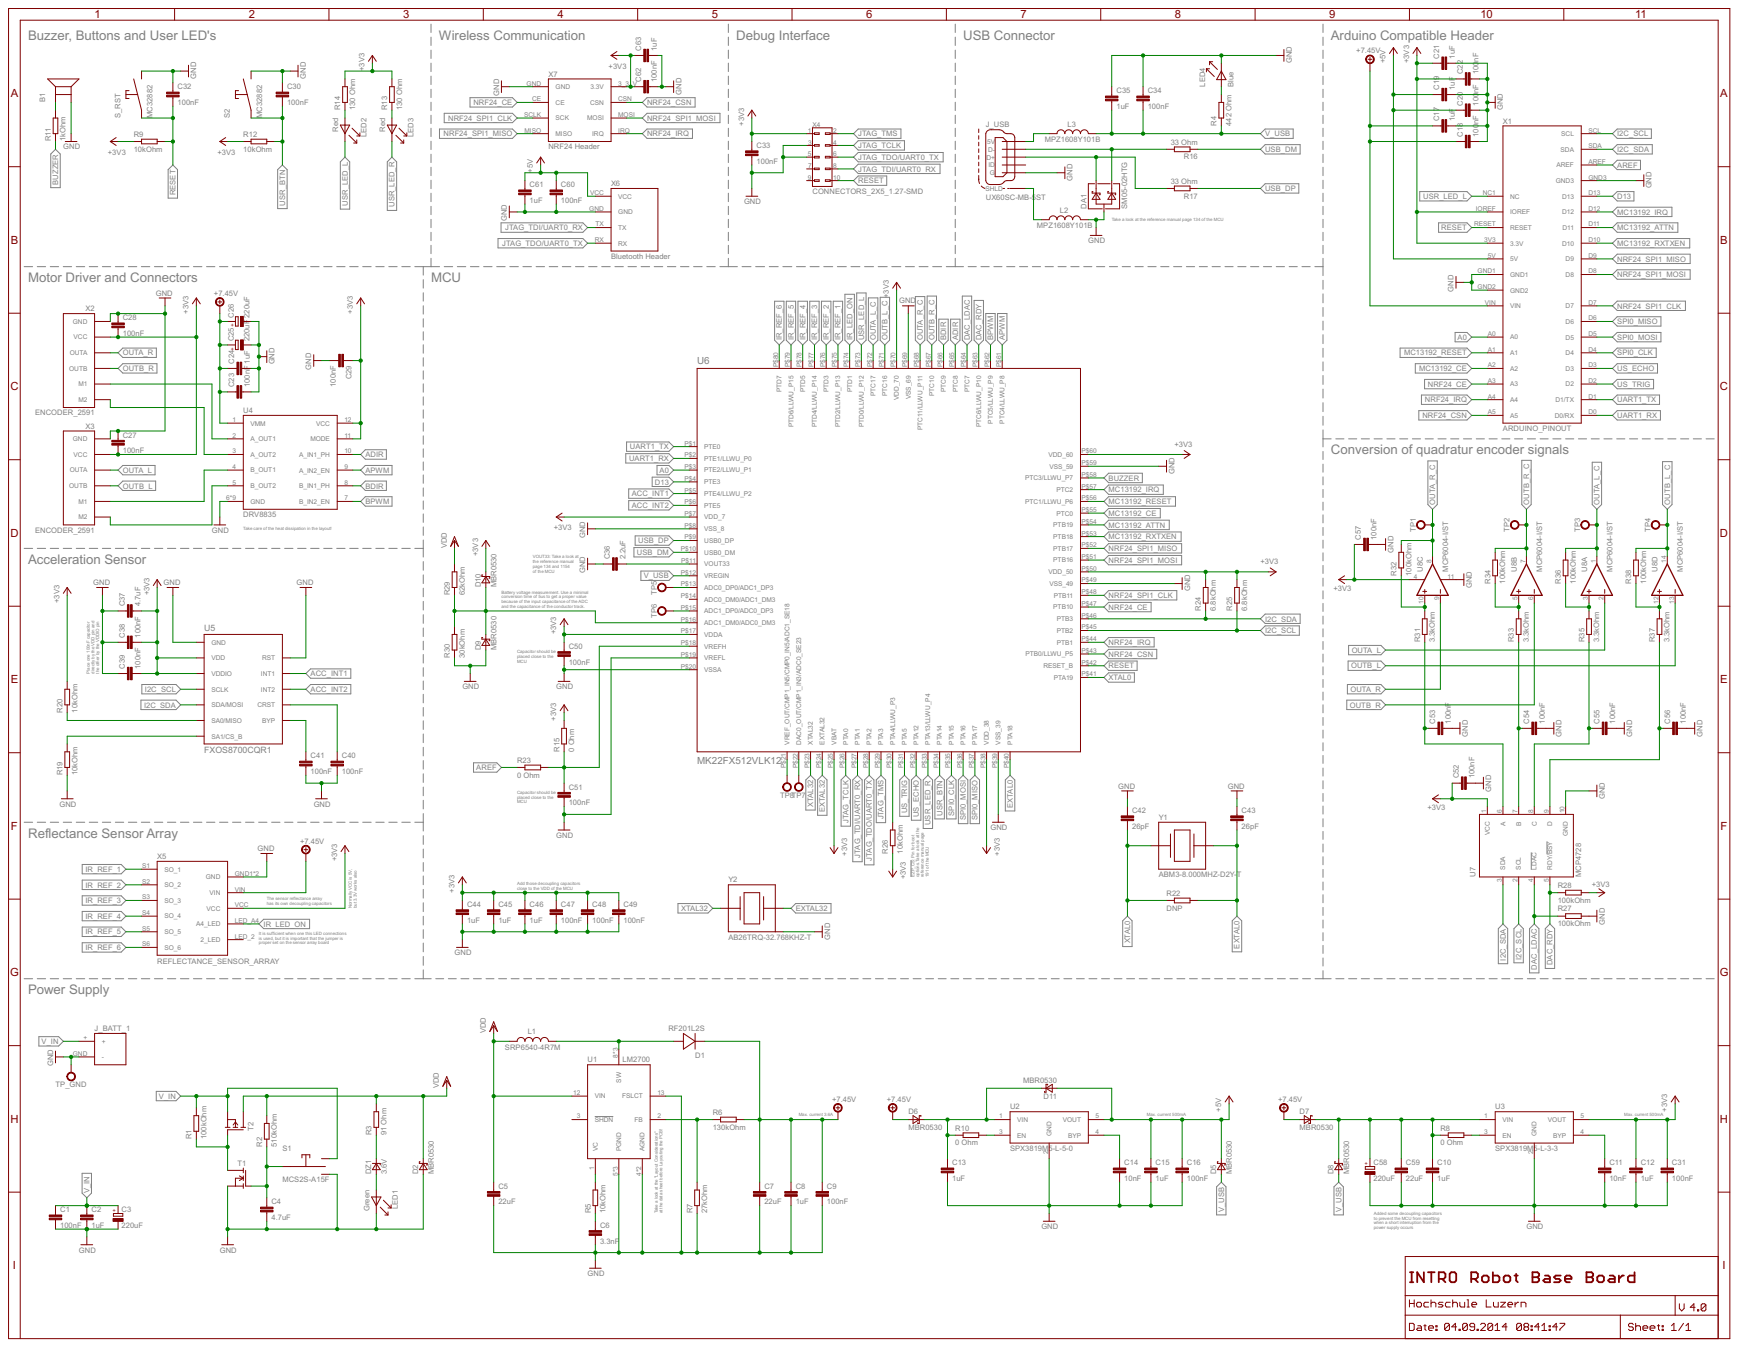
[picture p122: page 1]

Take a look at the reference manual page 134 of the MCU

Motor Driver and Connectors

Conversion of quadratur encoder signals

Take care of the heat dissipation in the layout!

VOUT33: Take a look at
the reference manual page 134 and 1154

Battery voltage measurement. Use a minimal conversion time of 5us to get a proper value

because of the input capacitance of the ADC
and the capacitance of the conductor track.

Place one 100nF capacitor directly by the VDD pin and

the other by the VDDIO pin

Capacitor should be
placed close to the MCU

EZP_CS: Pin for boot options.Take a look at the

Normally VCC is 5V, but 3.3V works also

Add those decoupling capacitors
close to the VDD of the MCU

The sensor reflectance array has its own decoupling capacitors Power Supply

It is sufficient when one this LED connections
is used, but it is important that the jumper is proper set on the sensor array board

Take a look at the "Layout Considerations" at the data sheet before Layouting the PCB!

Added some decoupling capacitors
to prevent the MCU from resetting when a short interruption from the
