ErichStyger/mcuoneclipse/Altium/NeoPixel Shield/Altium_NeoPixel_Schematics.pdf

Comment | Description | Designator | Footprint | LibRef | Quantity
100nF | Chip Capacitor SMD 0805, Normaler Kondensator | C1, C2, C6, C7, C8 | 0805 | C?, CapNP | 5
1uF | Normaler Kondensator | C5 | 0805 | C? | 1
BAS40-04 | | D1 | SOT23 | BAS40-04 | 1
Header 10X2 | Header, 10-Pin, Dual row | P1 | HDR2X10 | Header 10X2 | 1
Header 8X2 | Header, 8-Pin, Dual row | P2, P3 | HDR2X8 | Header 8X2 | 2
Header 6X2 | Header, 6-Pin, Dual row | P4 | HDR2X6 | Header 6X2 | 1
Header 8 | Header, 8-Pin | P5 | HDR1X8 | Header 8 | 1
Header 4 | Header, 4-Pin | P6 | HDR1X4 | Header 4 | 1
100 | Chip Resistor SMD 0805 | R1, R2, R3, R4, R5, R6, R7, R8 | 0805 | Res | 8
8k | Chip Resistor SMD 0805 | R9, R10 | 0805 | Res | 2
1k | Chip Resistor SMD 0805 | R11 | 0805 | Res | 1
SN74HCT245PWR* | | U1 | SN74HCT245PWR_20P | SN74HCT245PWR_20P | 1
815-ABS09-32.7K-1-T | 815-ABS09-32.7K-1-T | U2 | 815-ABS09-32.7K-1-T | 815-ABS09-32.7K-1-T | 1
DS1342U+T&R | | U3 | uSOP-8 | DS1342U+T&R | 1
6.8mm SM Button Cell Retainer* | | U4 | 6.8mm SM Button Cell Retainer | 6.8mm SM Button Cell Retainer | 1
NRF24 | | U5 | HEADER2X4 | NRF24 | 1

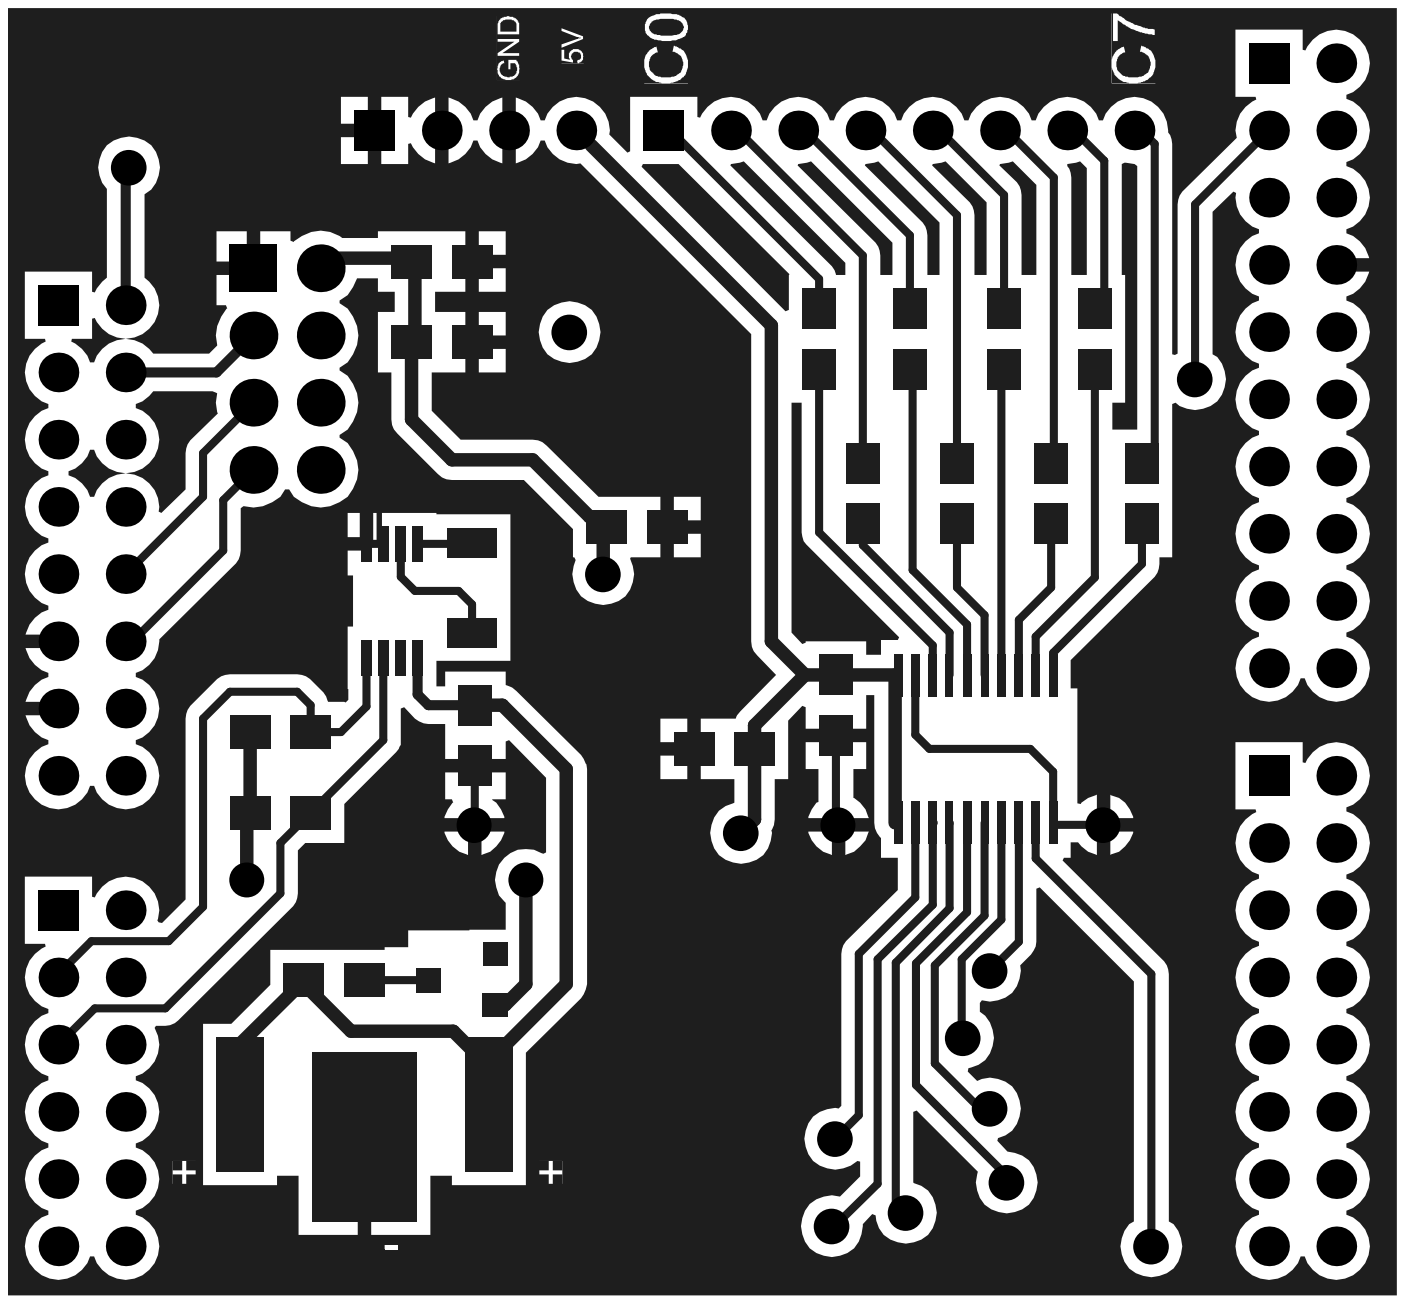
[picture p123: page 2]

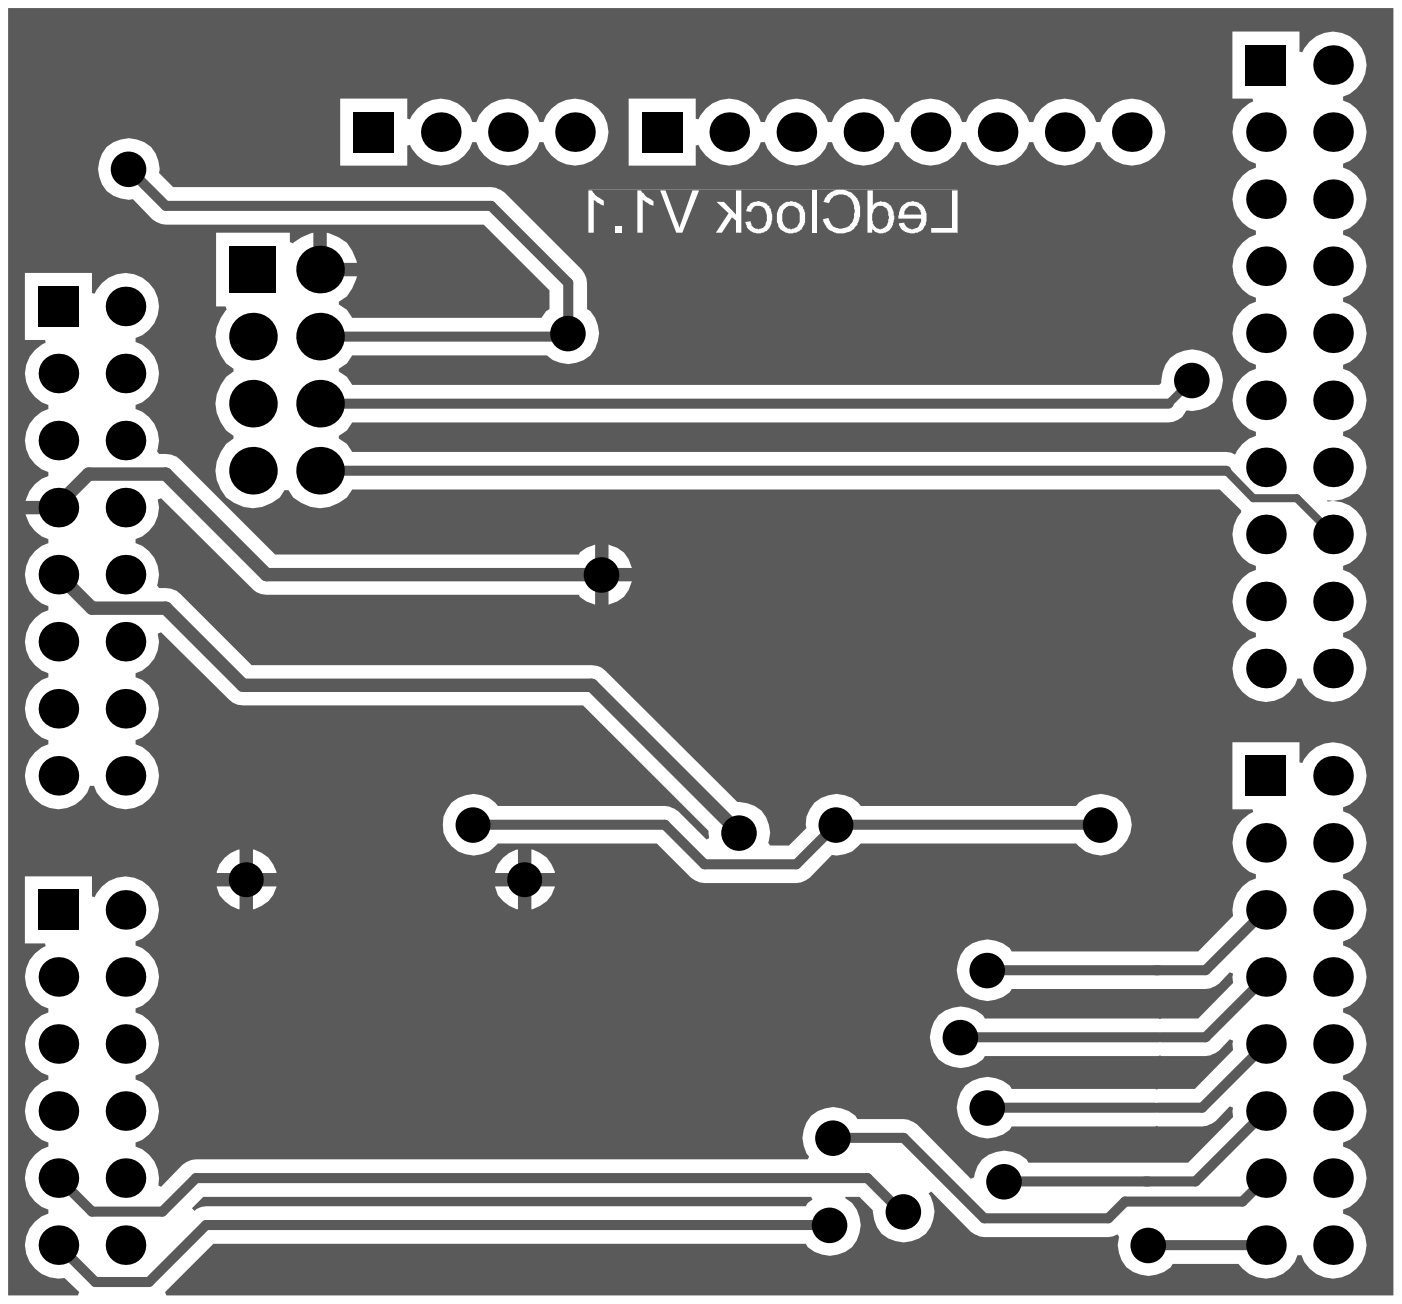
[picture p124: page 3]

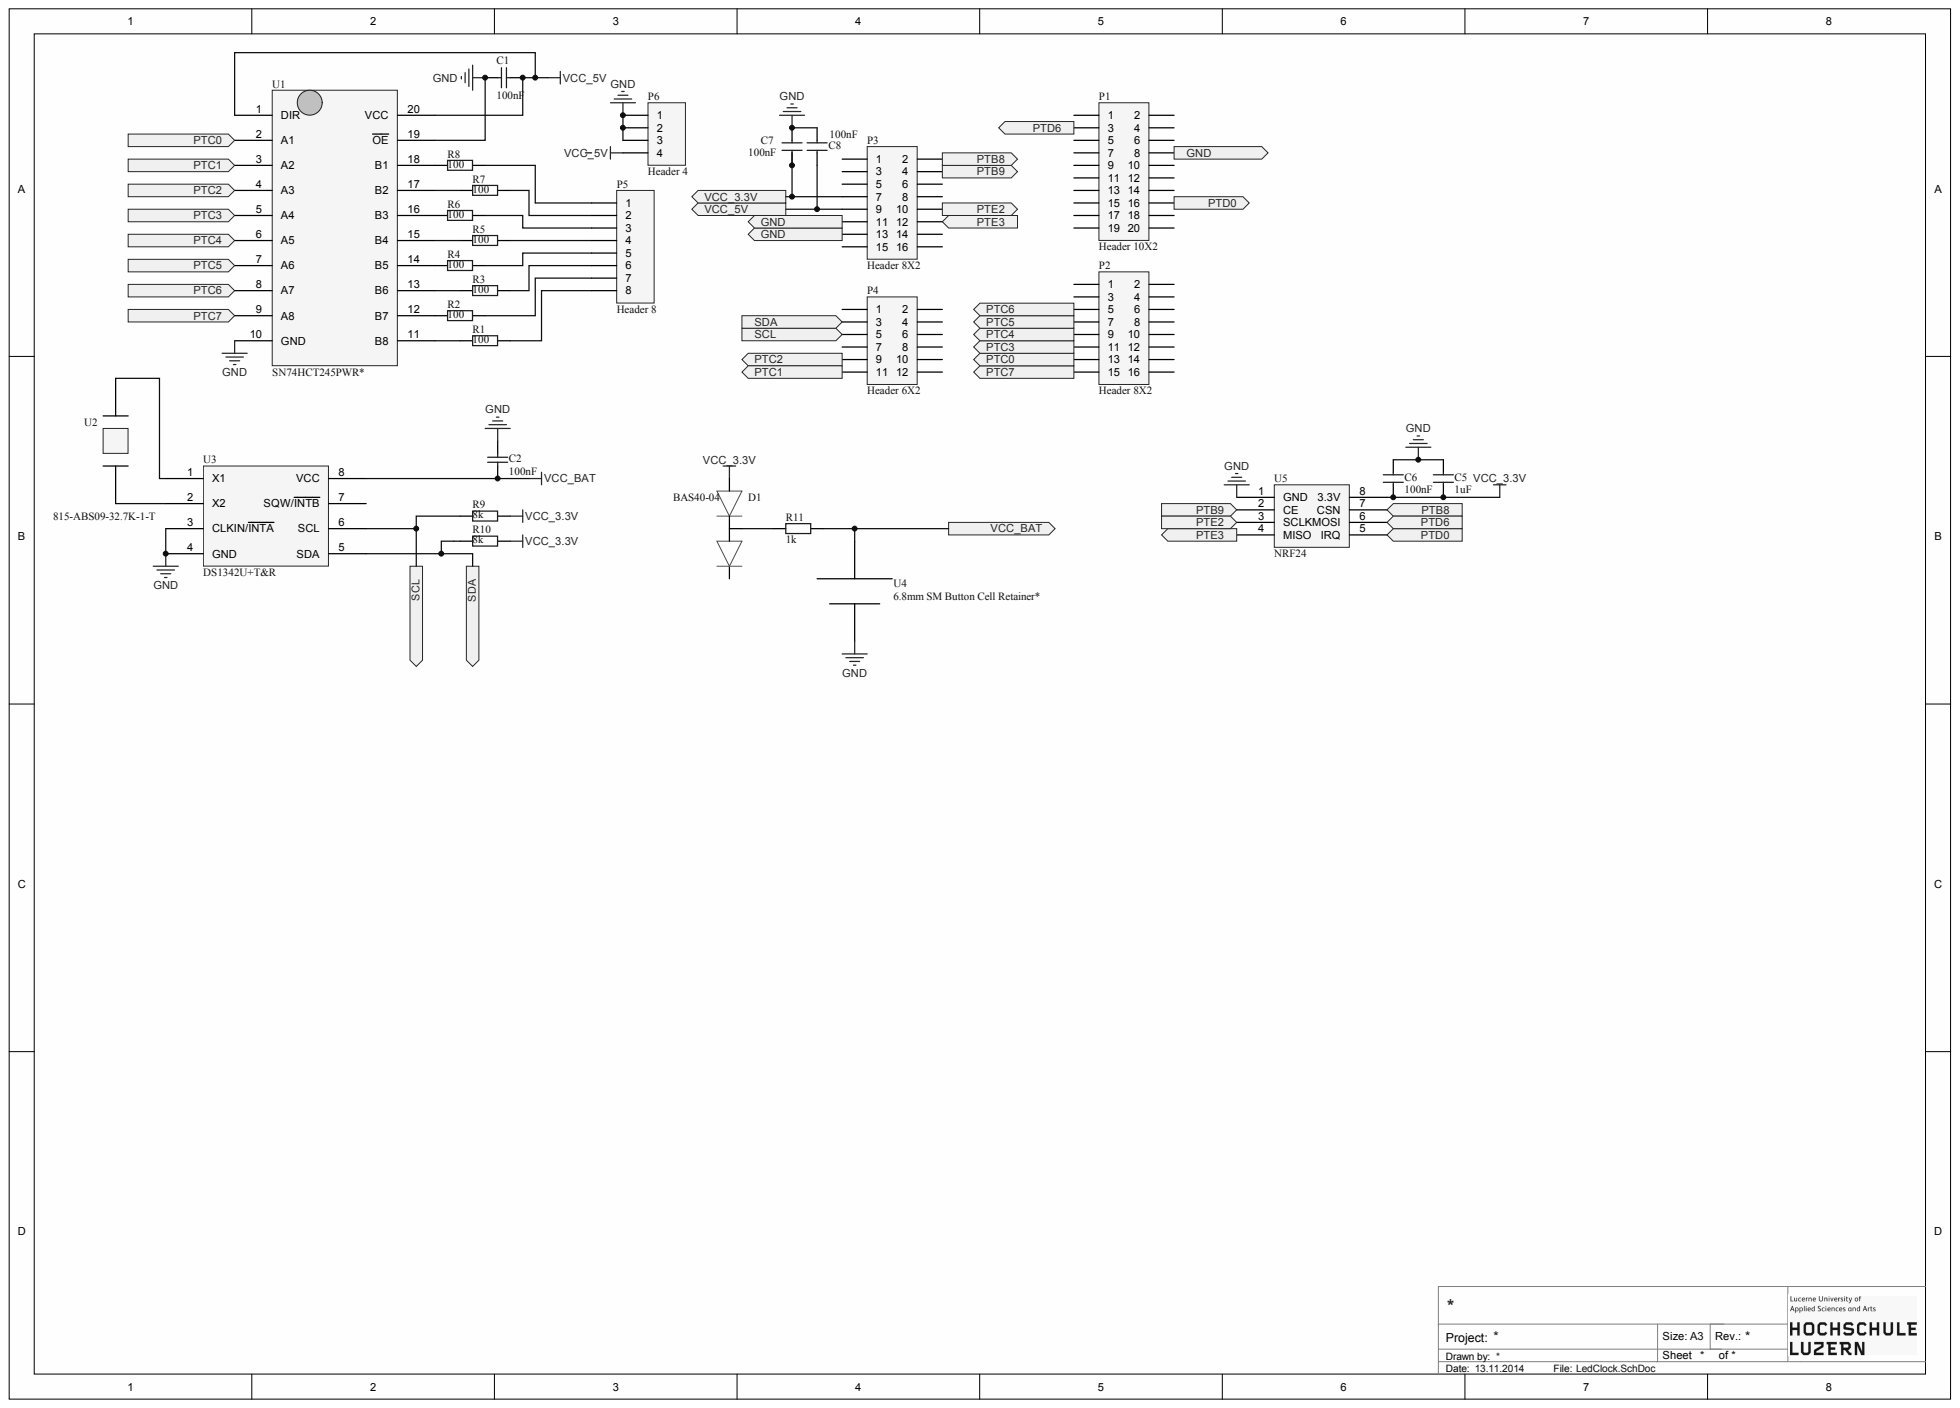
[picture p125: page 4]

DIR A1 A2 A3 A4 A5 A6 A7 A8

Project: * | Size: A3 | Rev.: | *
Dr a w n b y : * | Sheet * of *

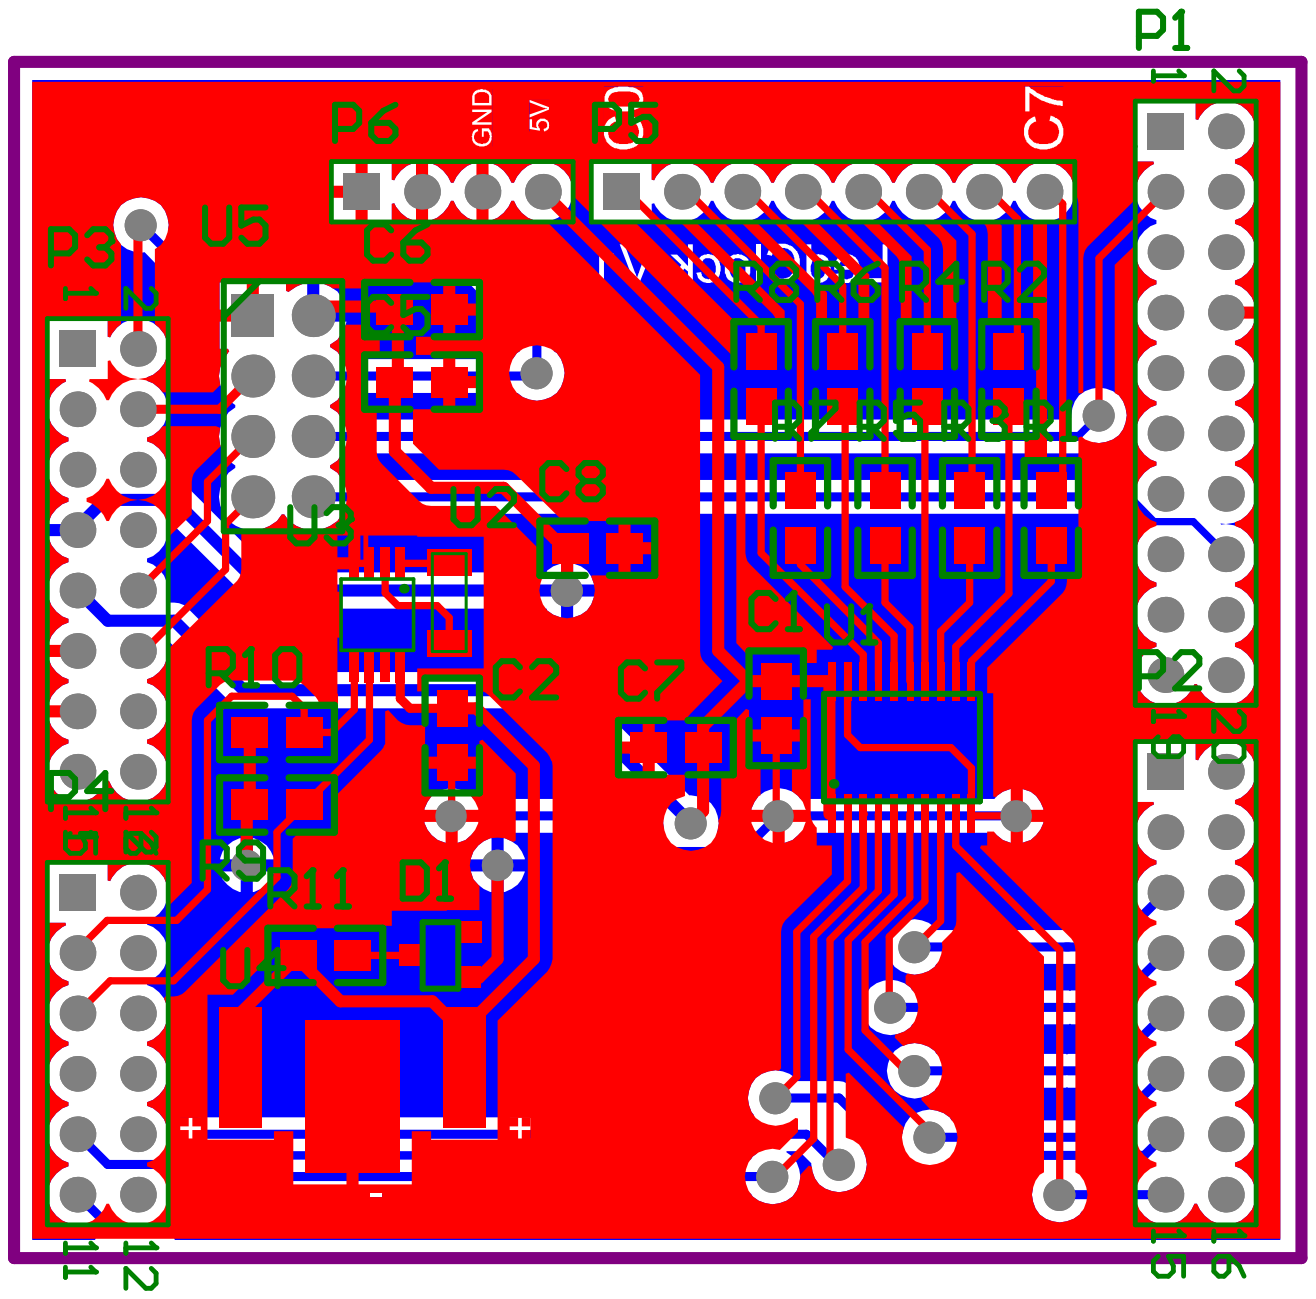
[picture p126: page 5]
