ErichStyger/mcuoneclipse/Eagle/INTRO-Robot/INTRO Zumo Schematic.pdf

A

A

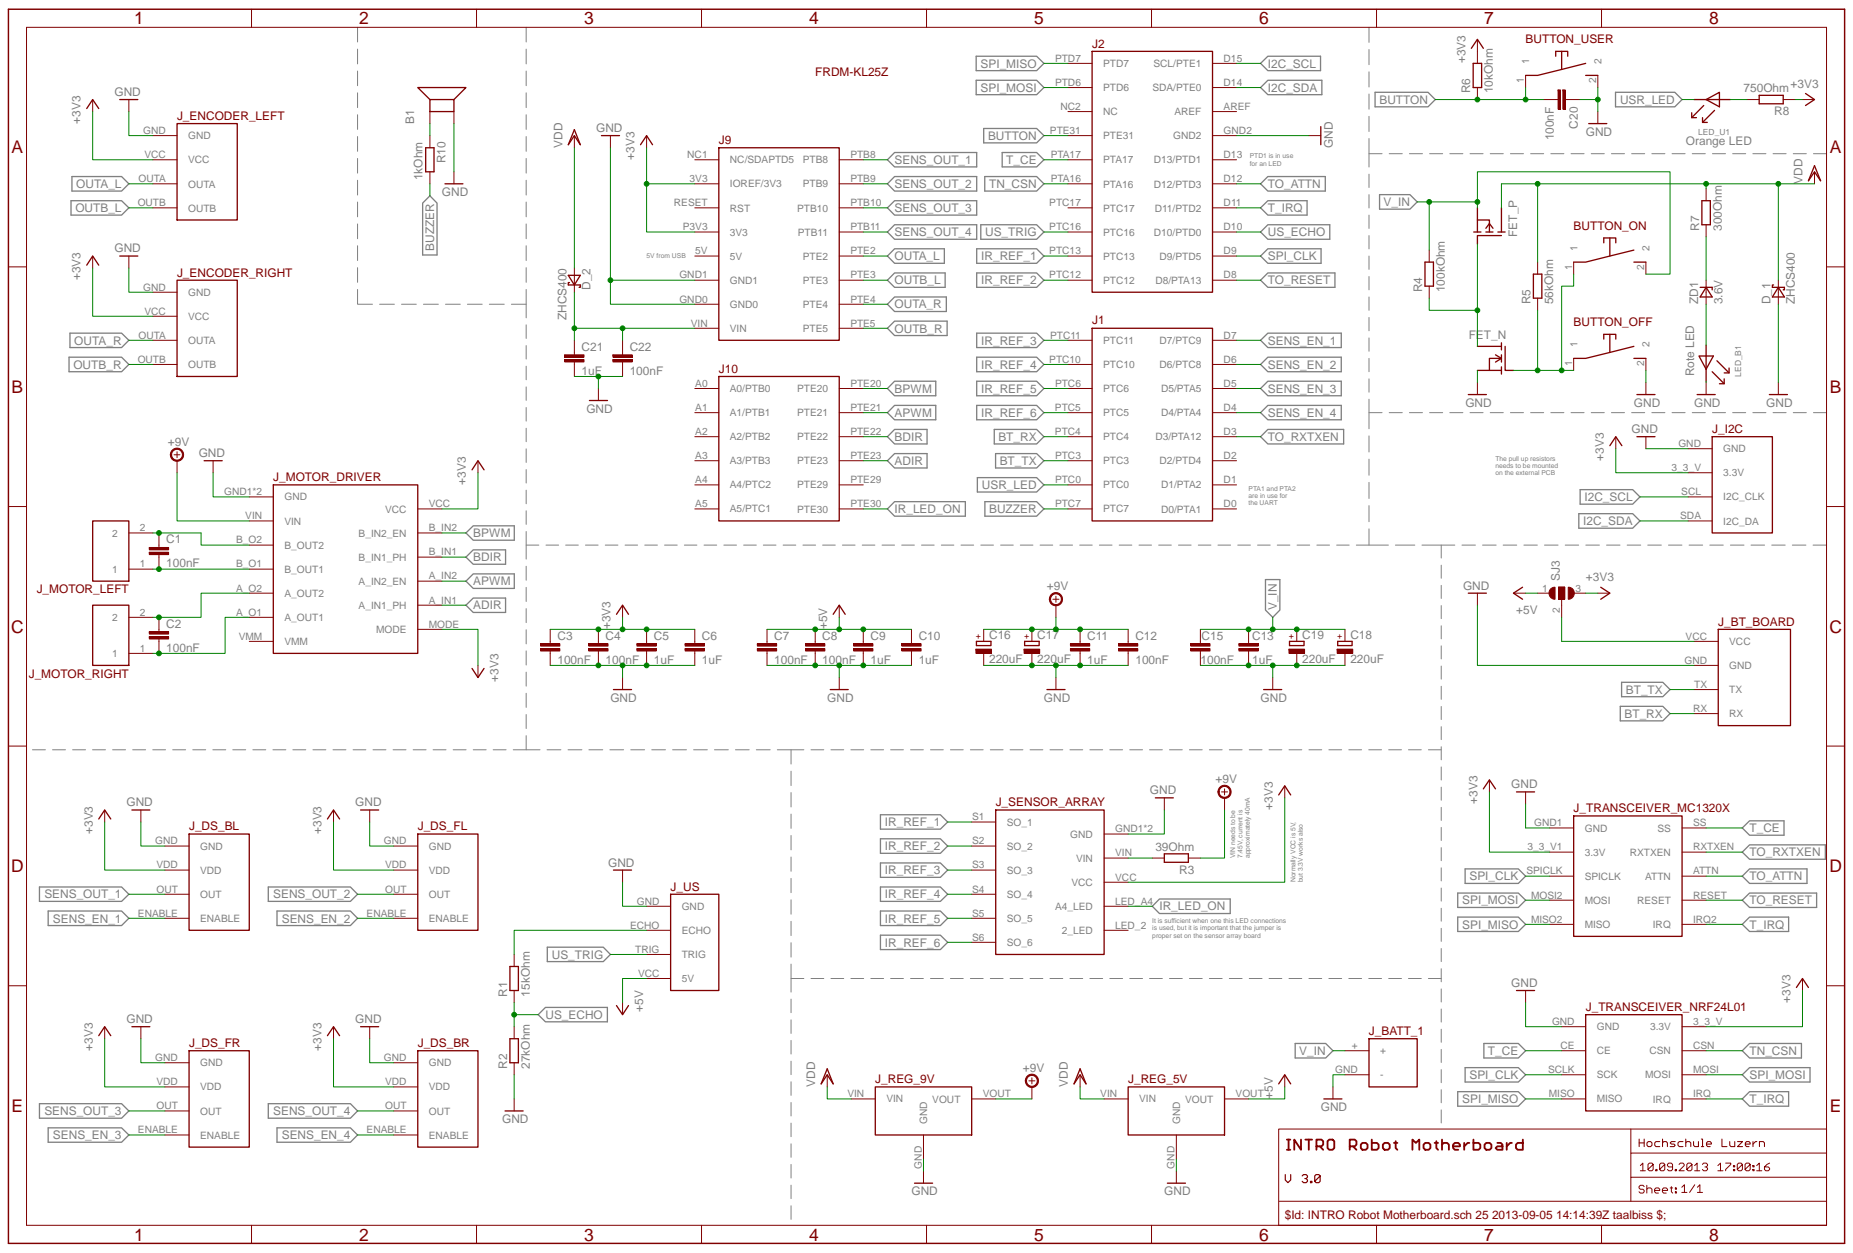
[picture p127: page 1]

The pull up resistors
needs to be mounted
on the external PCB

PTA1 and PTA2
are in use for
the UART

VIN needs to be

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

GND GND VIN VIN VOUT VOUT

$Id: INTRO Robot Motherboard.sch 25 2013-09-05 14:14:39Z taalbiss $;
