ErichStyger/mcuoneclipse/KiCAD/Projects/PicoLink/V0.1/PicoLink_V0.1.pdf

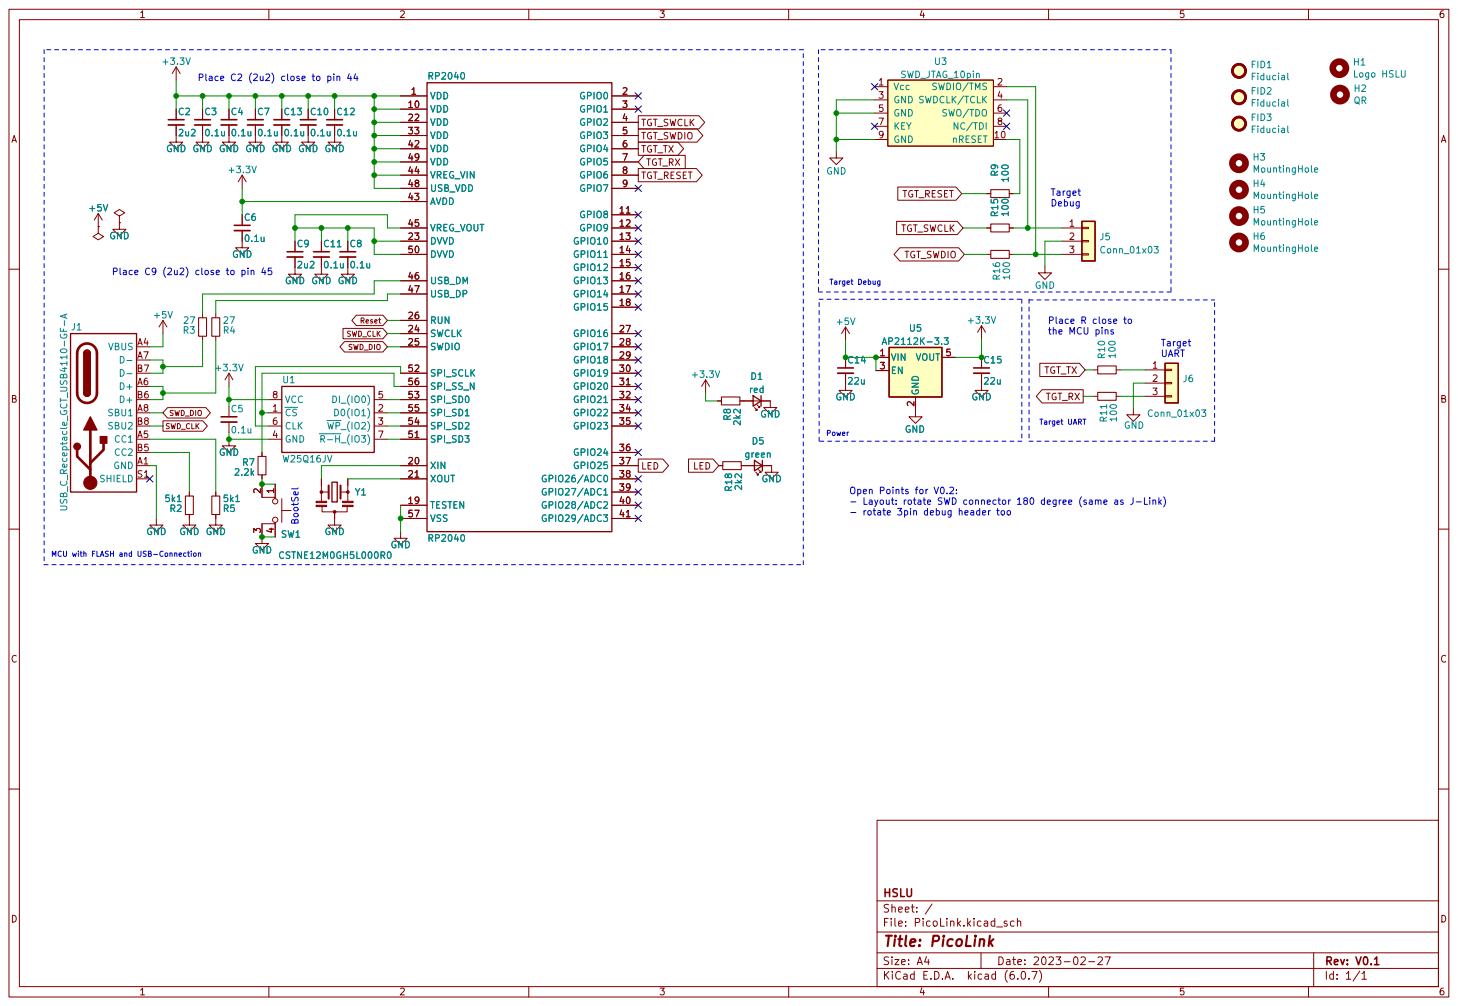
[picture p128: page 1]

Place C2 (2u2) close to pin 44 MCU with FLASH and USB-Connection Place C9 (2u2) close to pin 45

Open Points for V0.2:
- Layout: rotate SWD connector 180 degree (same as J-Link)
- rotate 3pin debug header too

File: PicoLink.kicad_sch Sheet: / HSLU
