ErichStyger/mcuoneclipse/tinyK22/V1.3/Schematic_TinyK22_V1_3.pdf

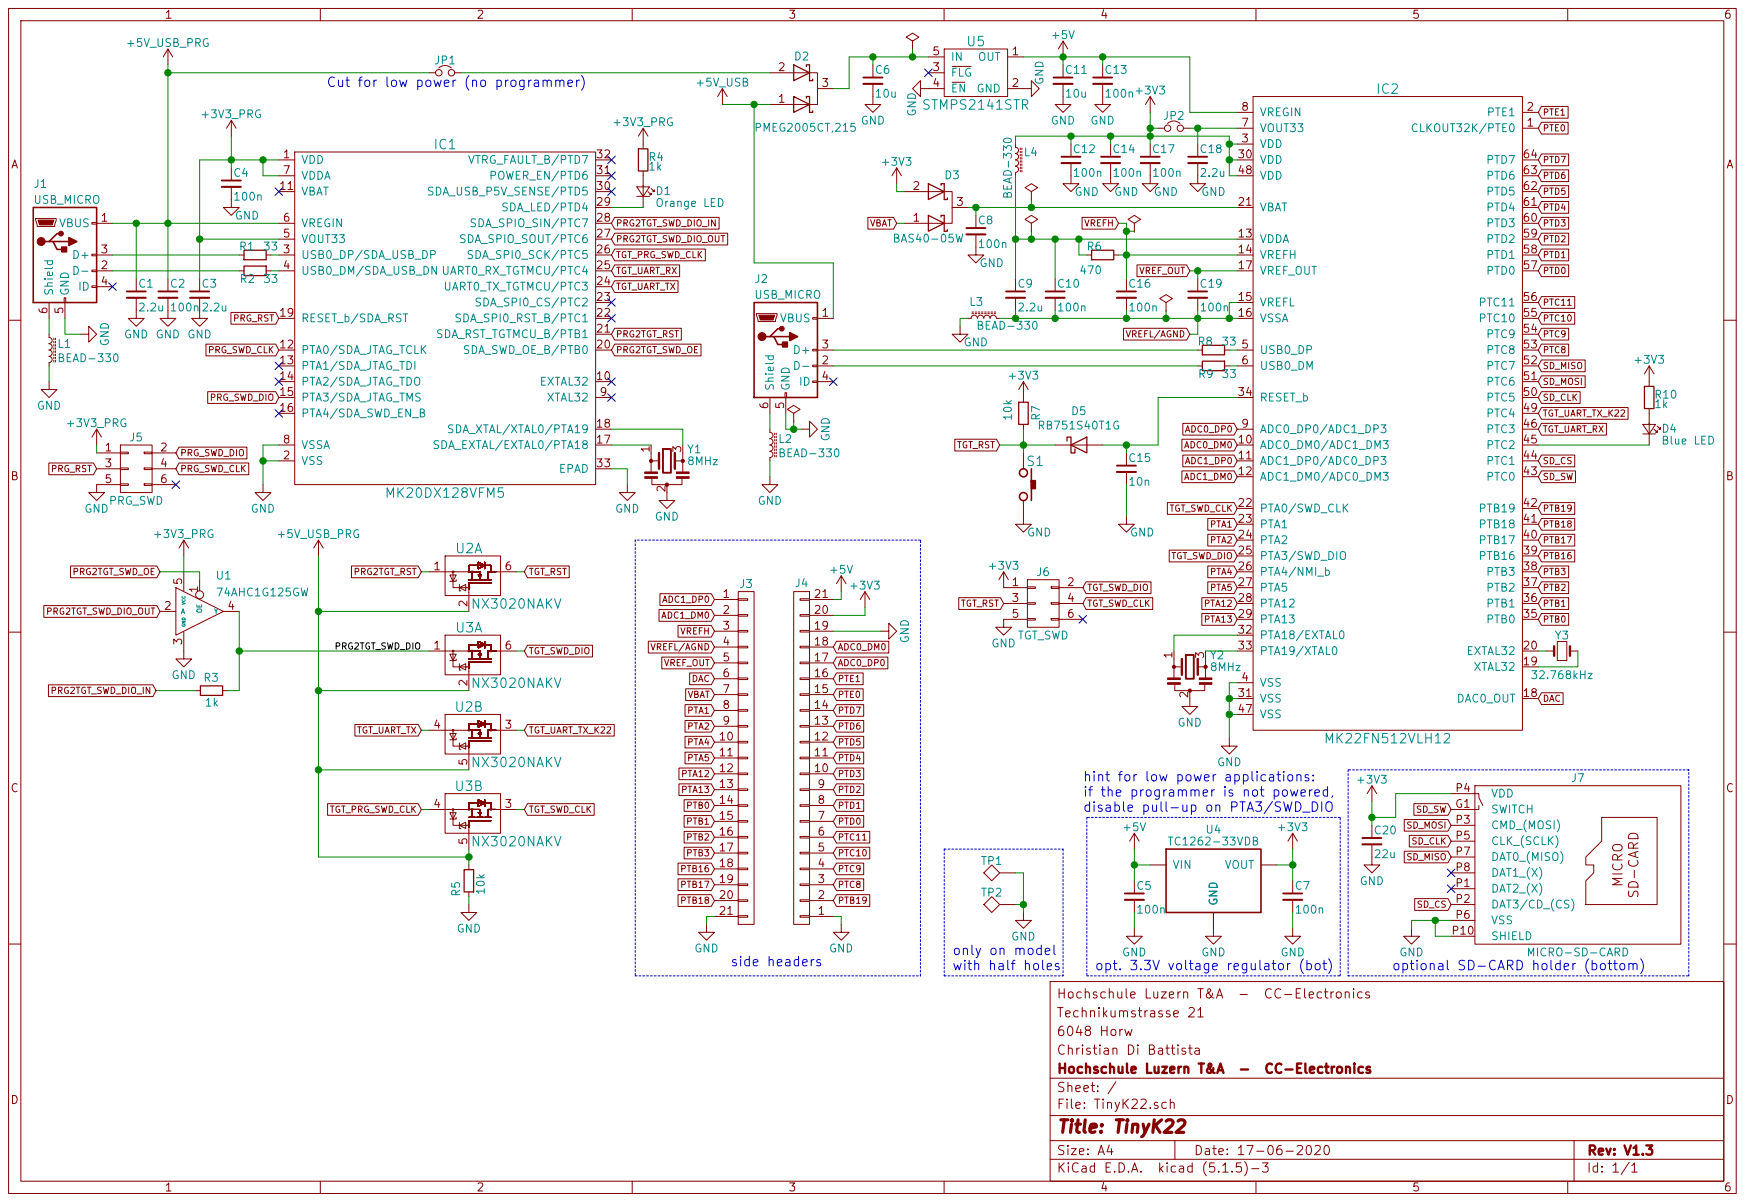
[picture p129: page 1]
