ErichStyger/mcuoneclipse/Eagle/INTRO-Robot K22/INTRO Robot V2 Base Board - Schematic.pdf

A

B

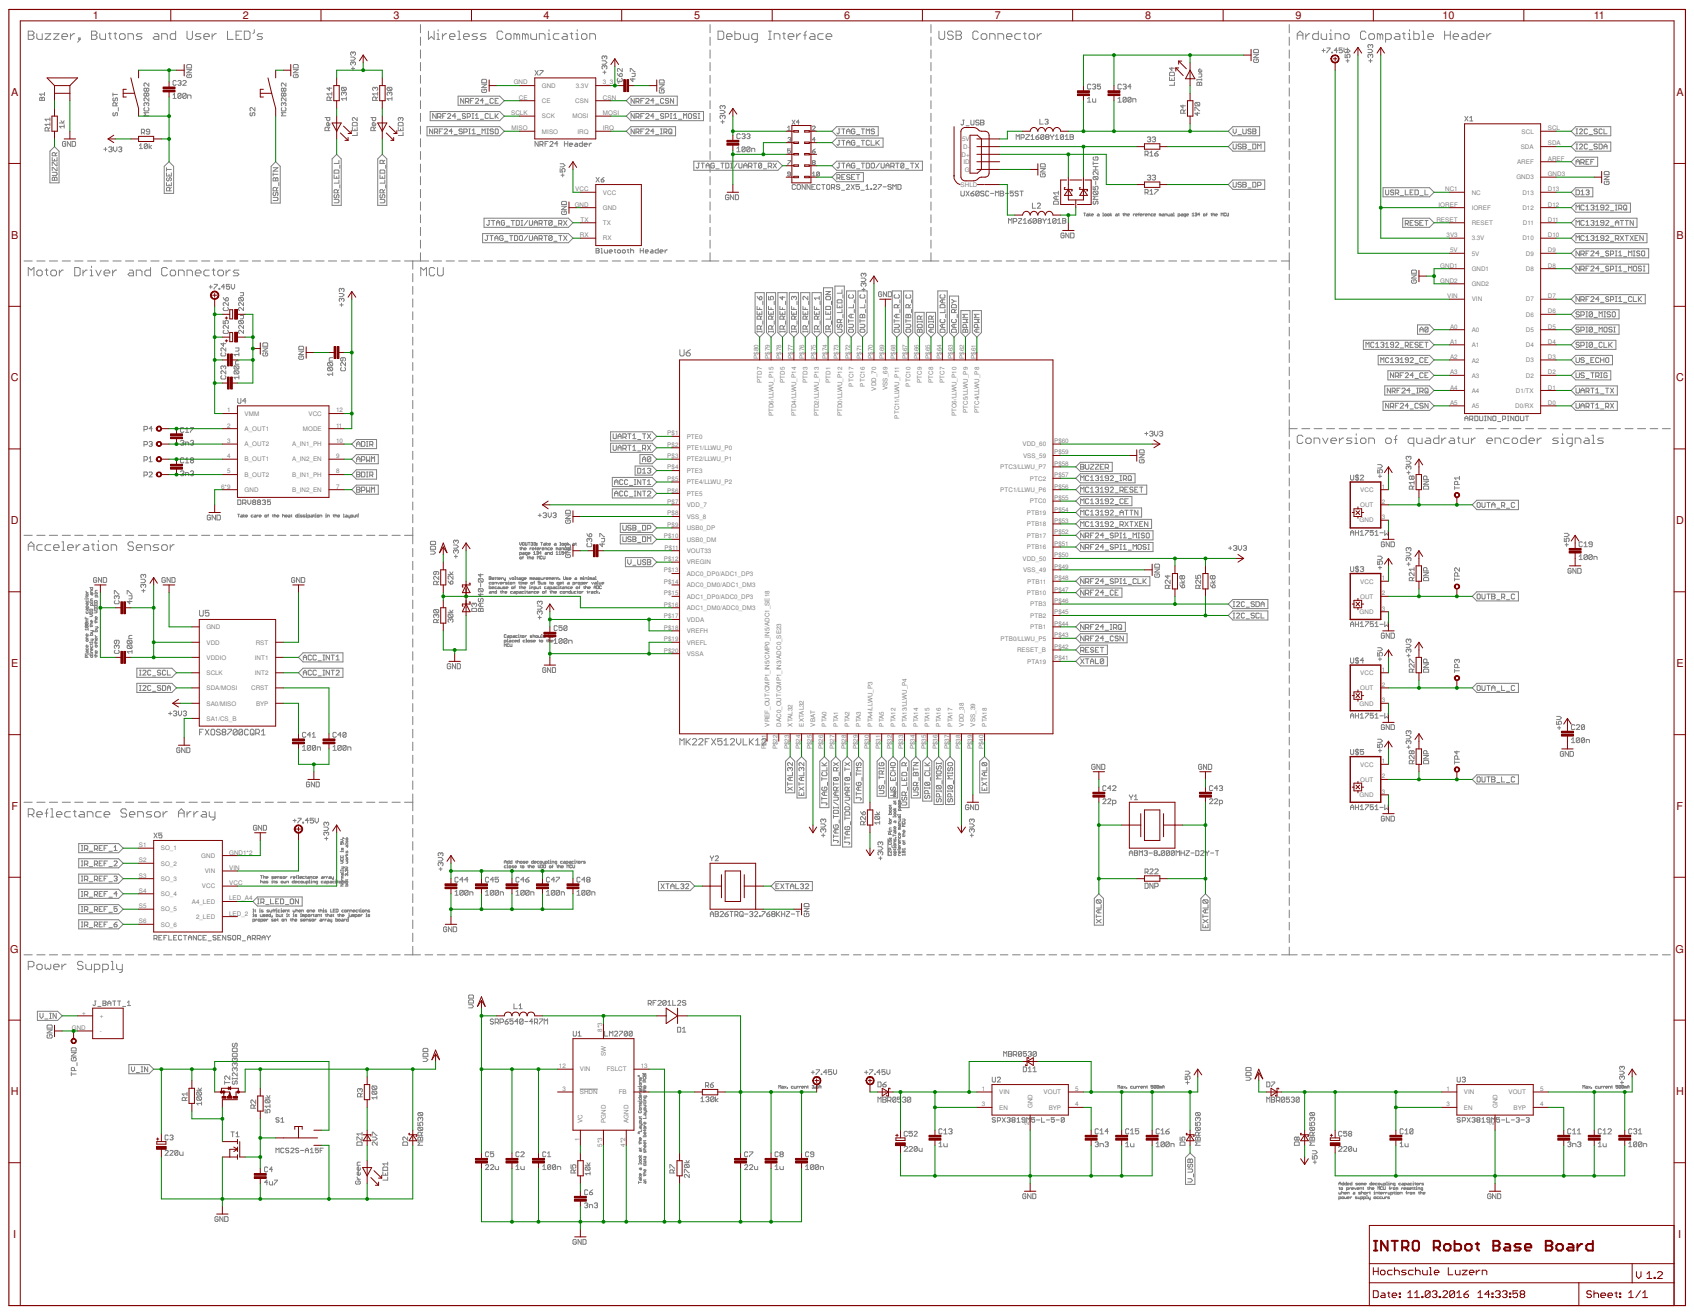
[picture p130: page 1]
