ErichStyger/mcuoneclipse/Eagle/INTRO-Robot K22/INTRO Robot Shield Schematic.pdf

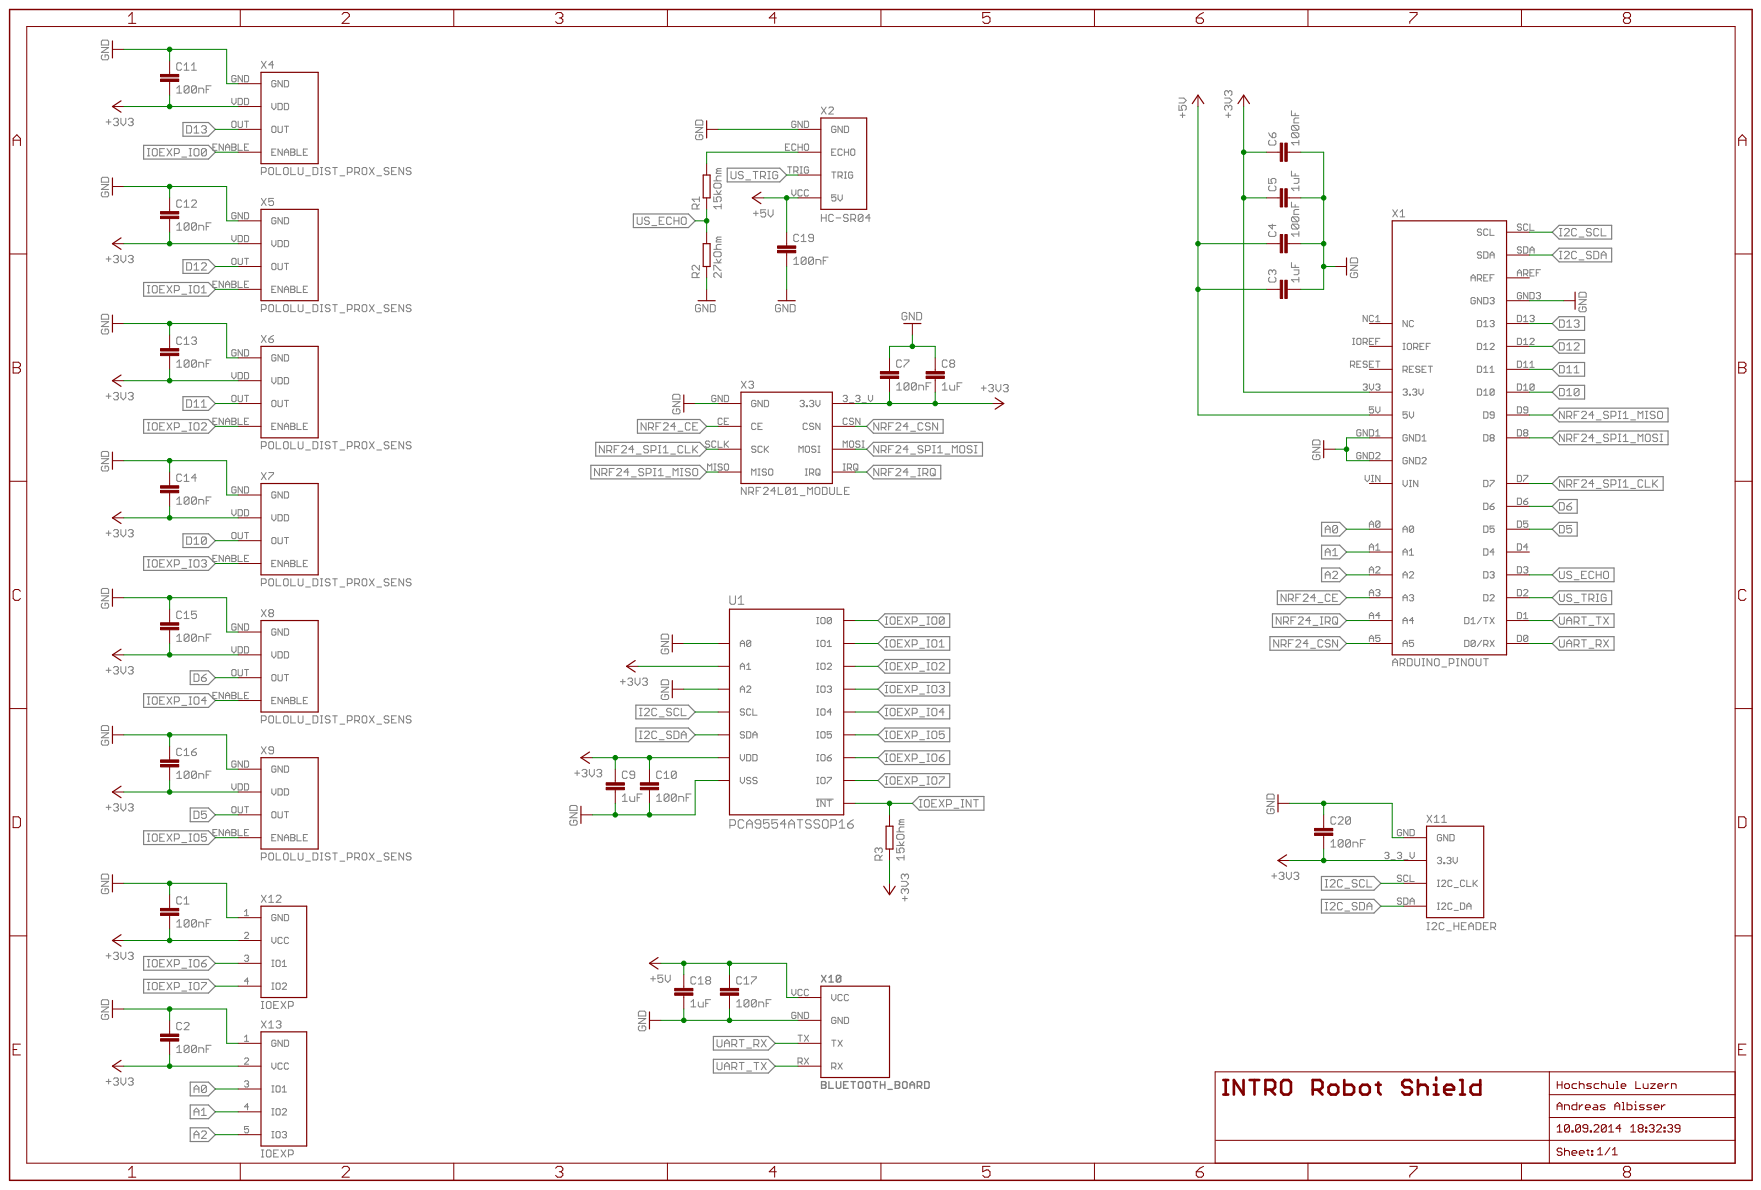
[picture p131: page 1]
