ErichStyger/mcuoneclipse/Examples/RaspberryPiPico/pico_card/HW/Schematics PicoCard_v1.1.pdf

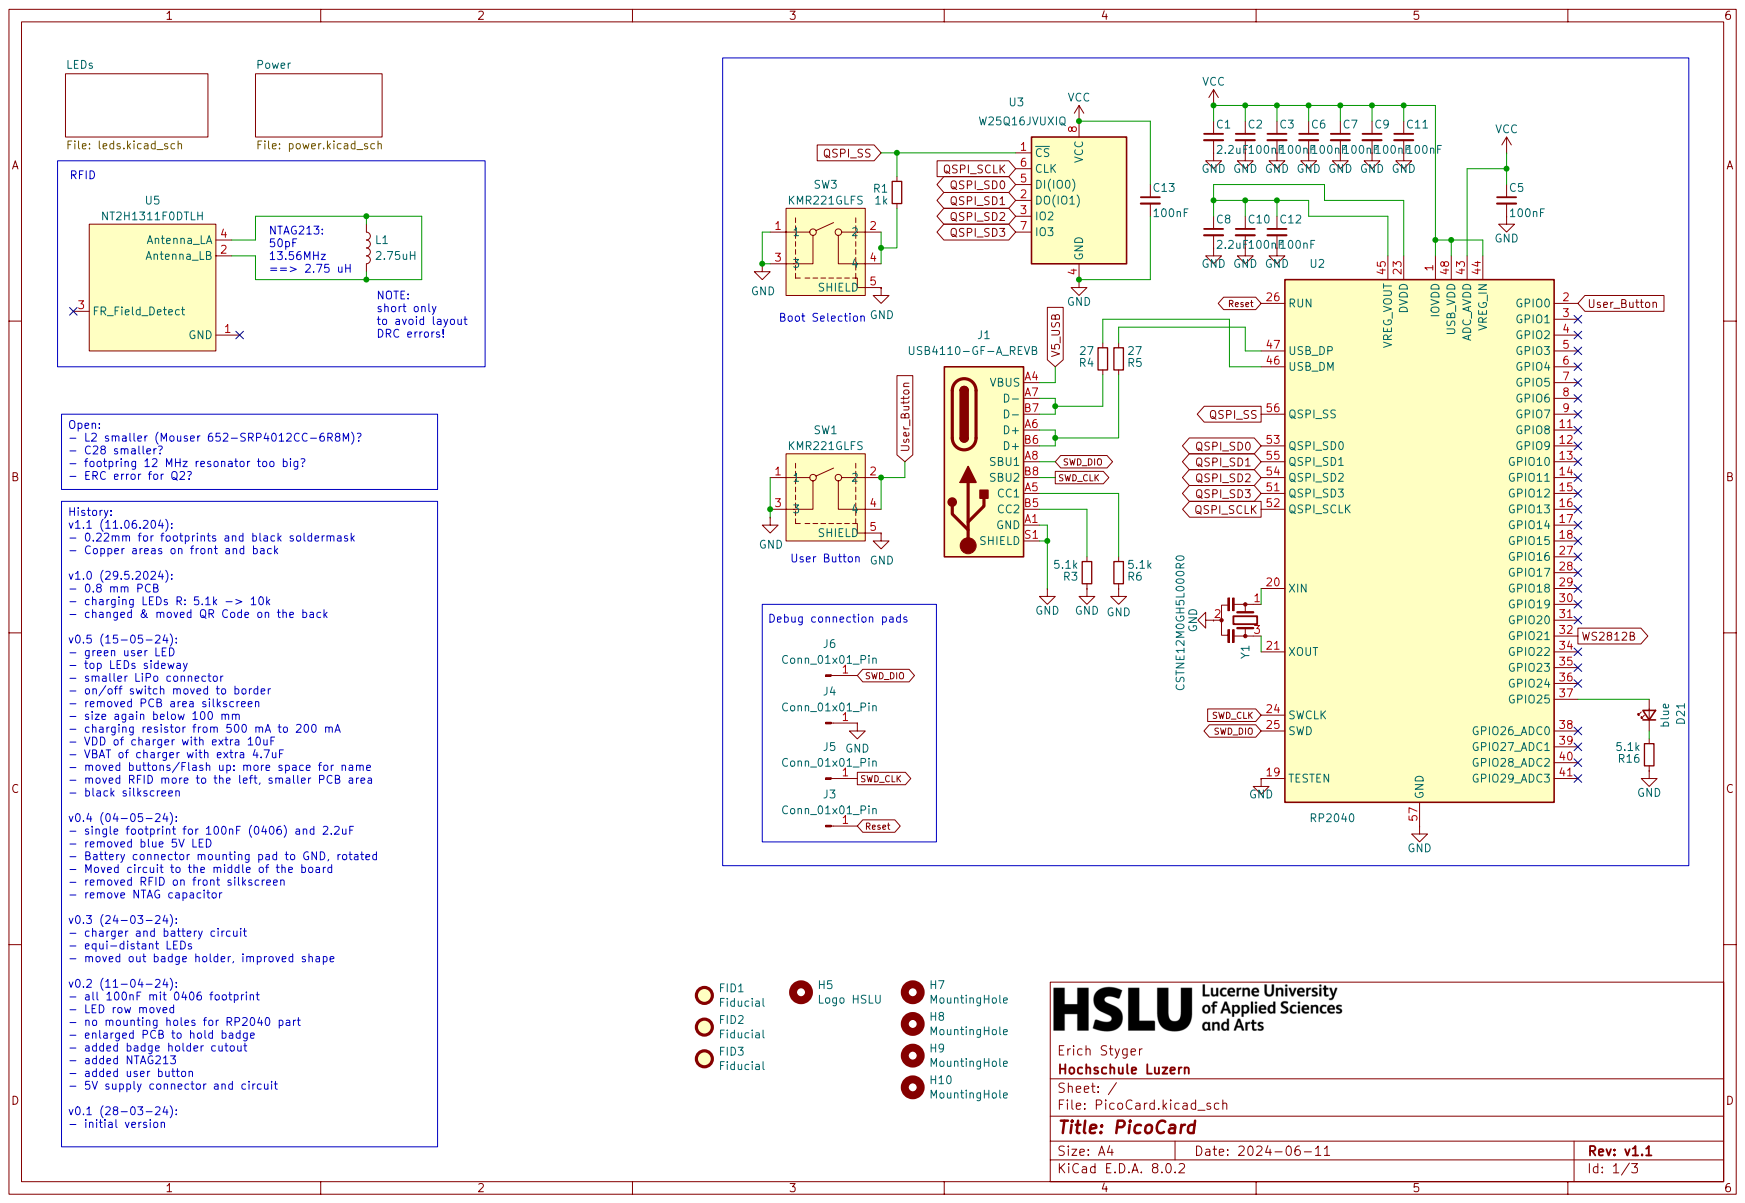
[picture p132: page 1]

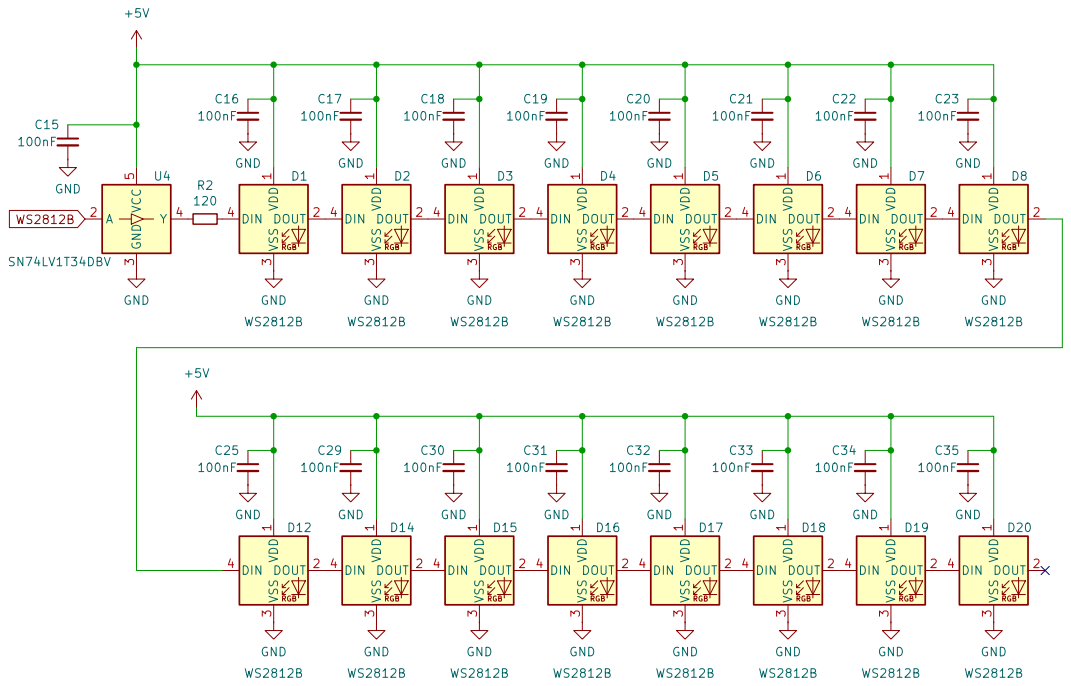
[picture p133: page 2]

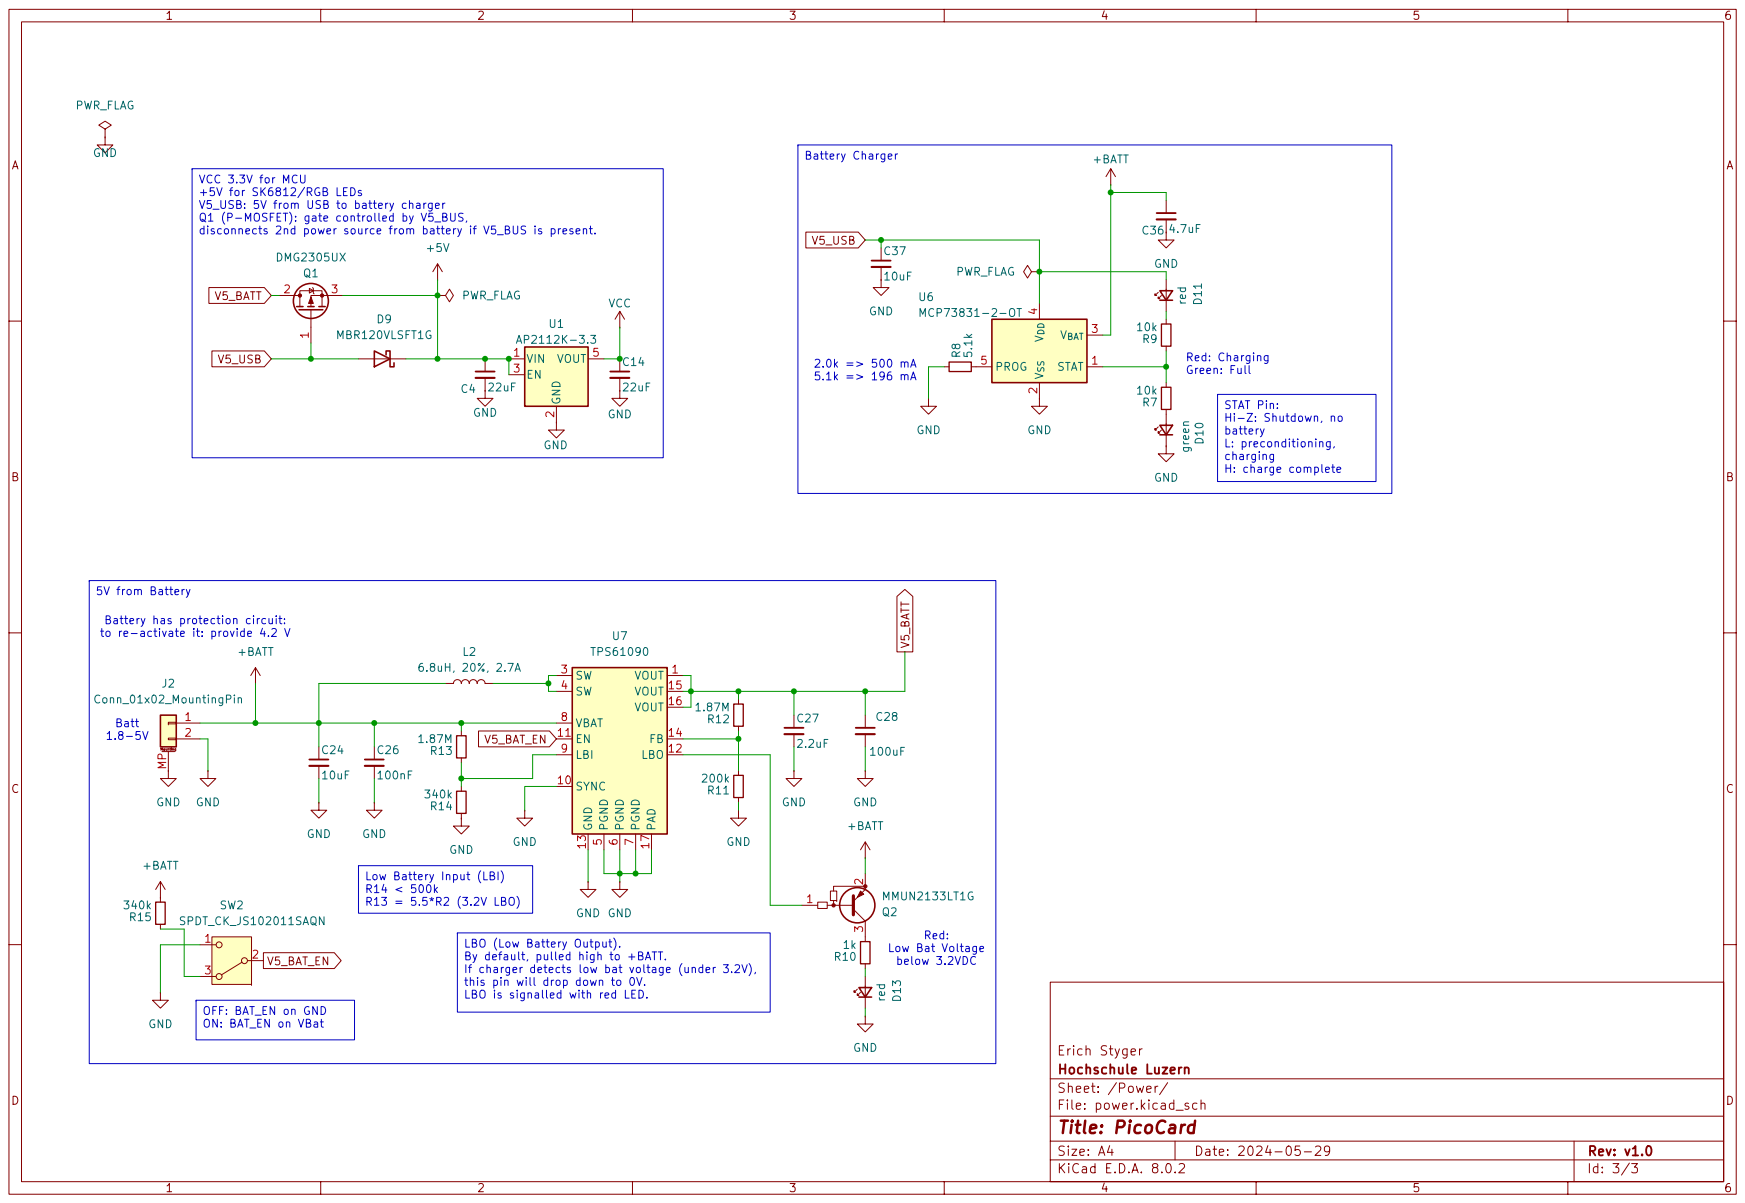
[picture p134: page 3]
