ErichStyger/mcuoneclipse/Examples/MCUXpresso/LPC845-BRK/LPC845-WorldClock/KiCad/WorldClock_V1.0/StepperClock V1.0 Schematic.pdf

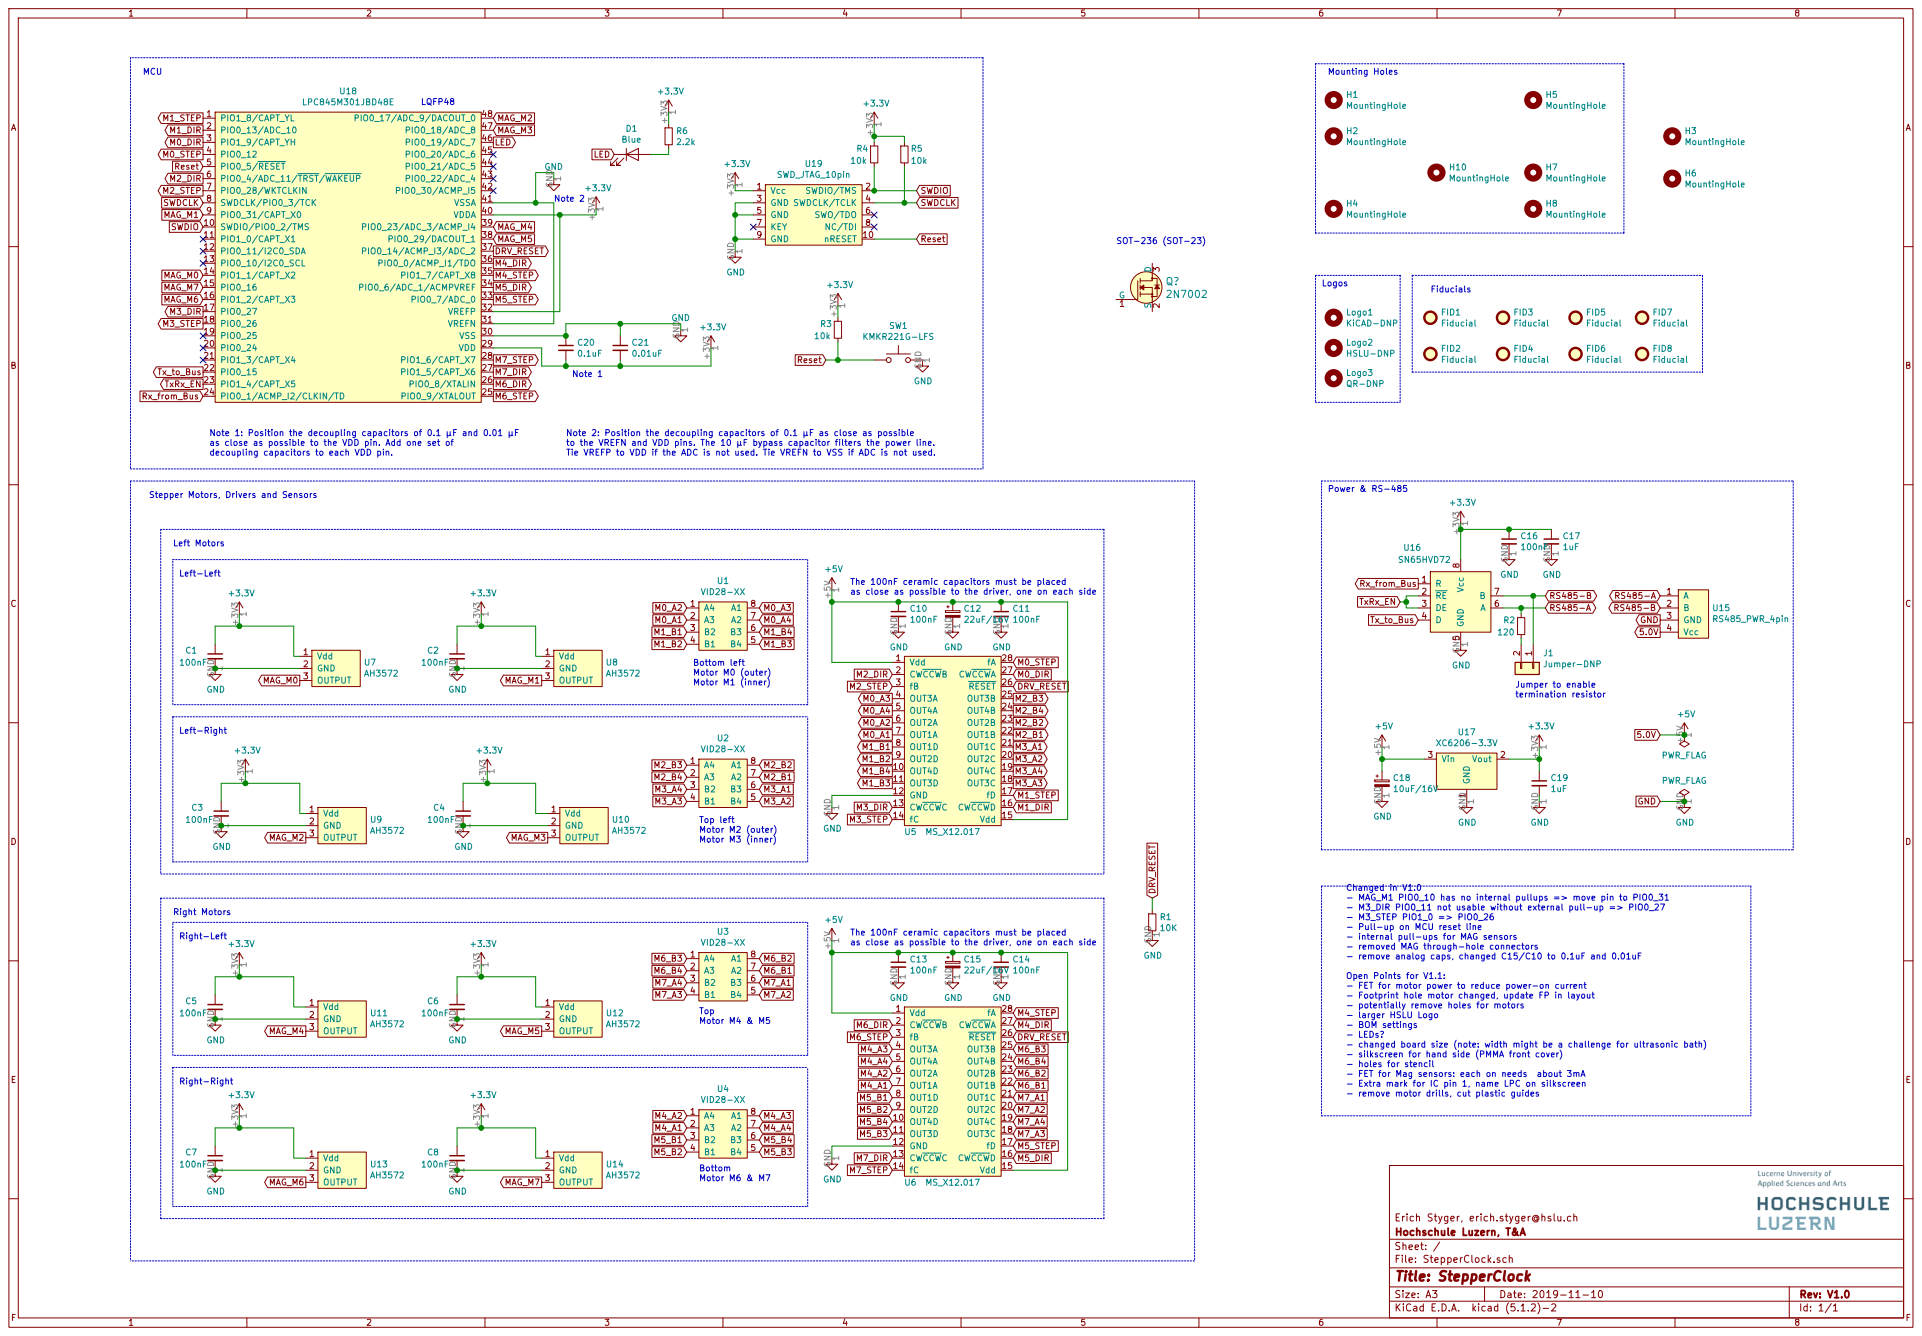
[picture p135: page 1]
