ErichStyger/mcuoneclipse/Eagle/INTRO-Robot K22/INTRO Robot Base Board Layout.pdf

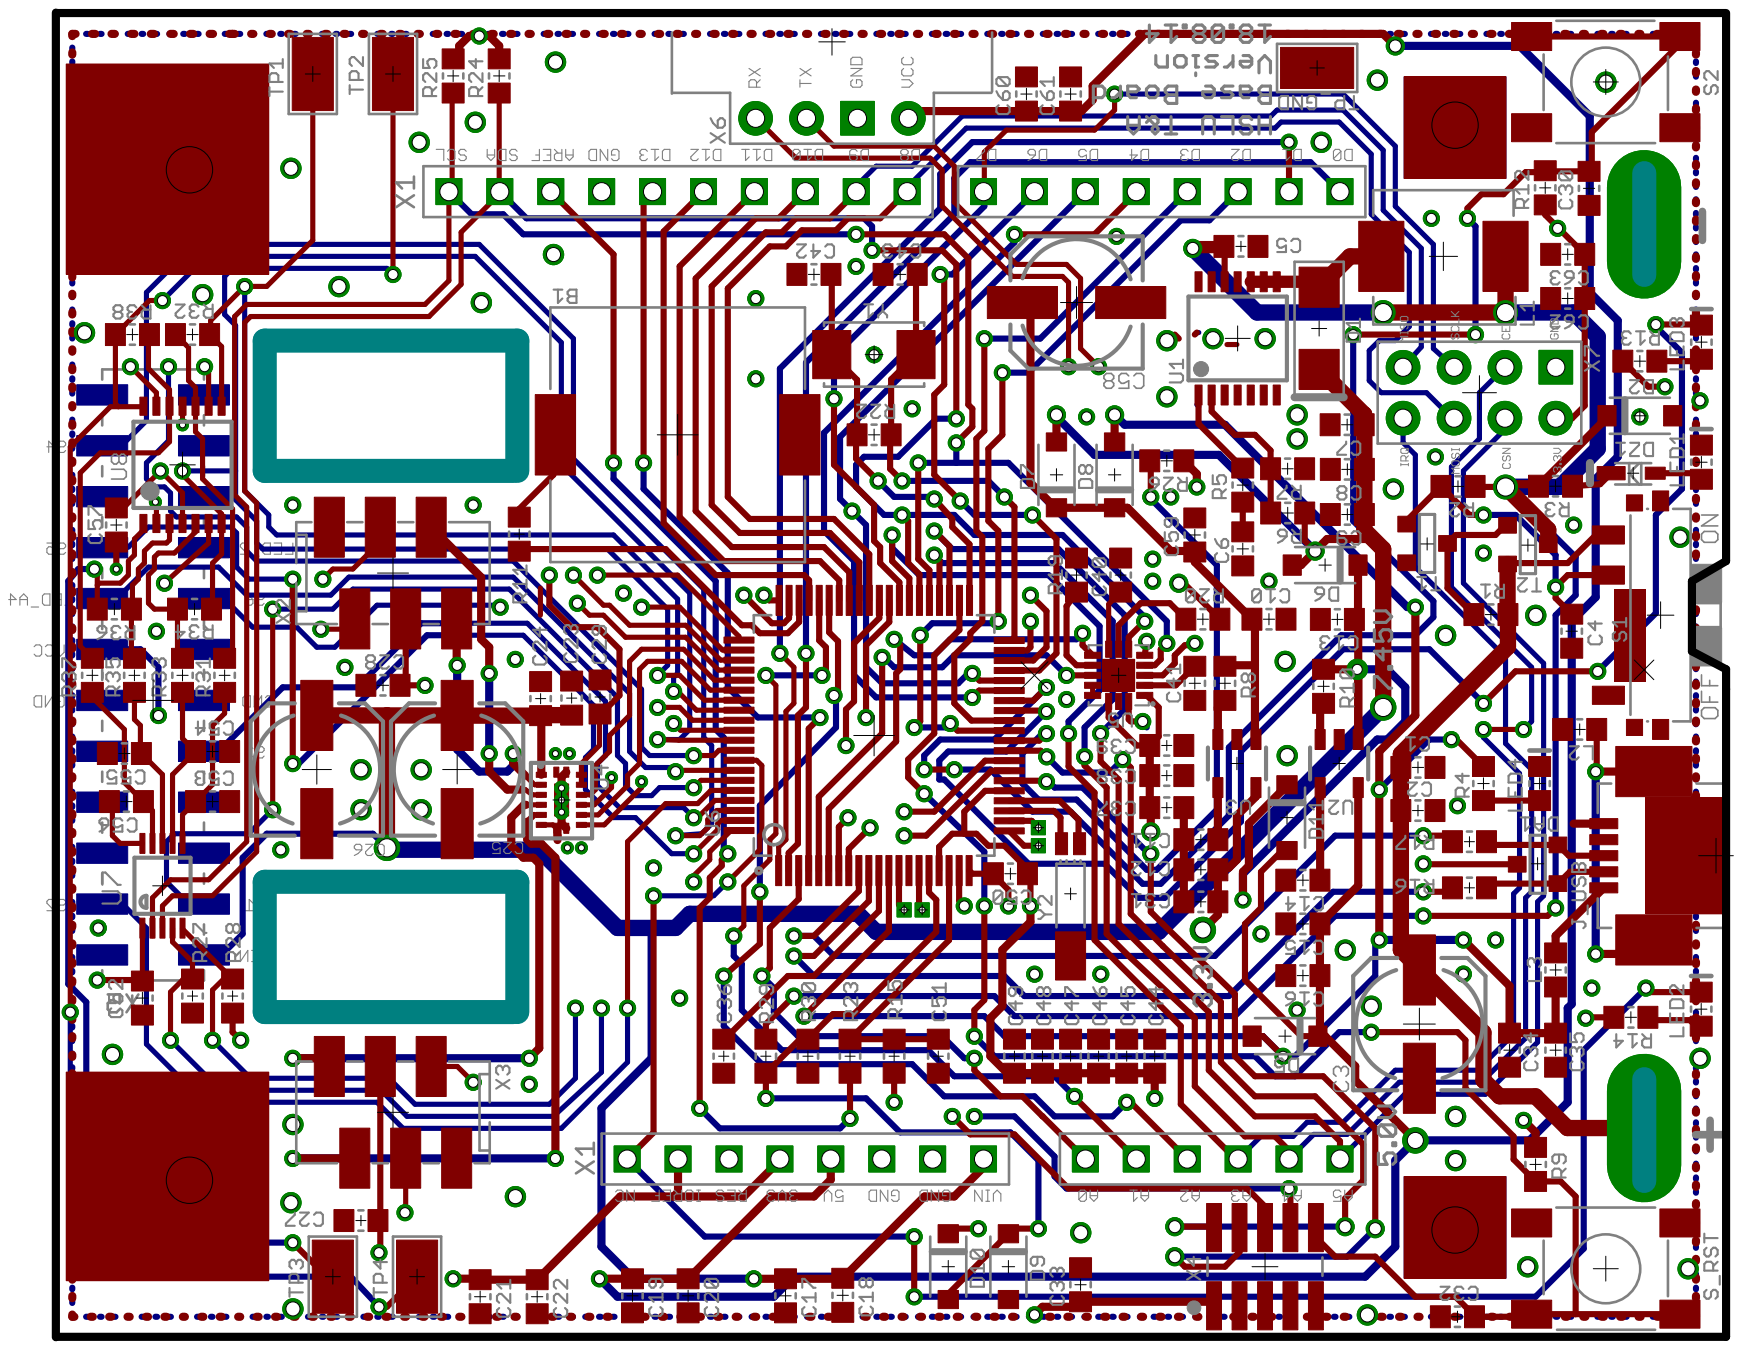
[picture p136: page 1]
