ErichStyger/mcuoneclipse/Eagle/INTRO-Robot K22/INTRO Robot Shield Layout.pdf

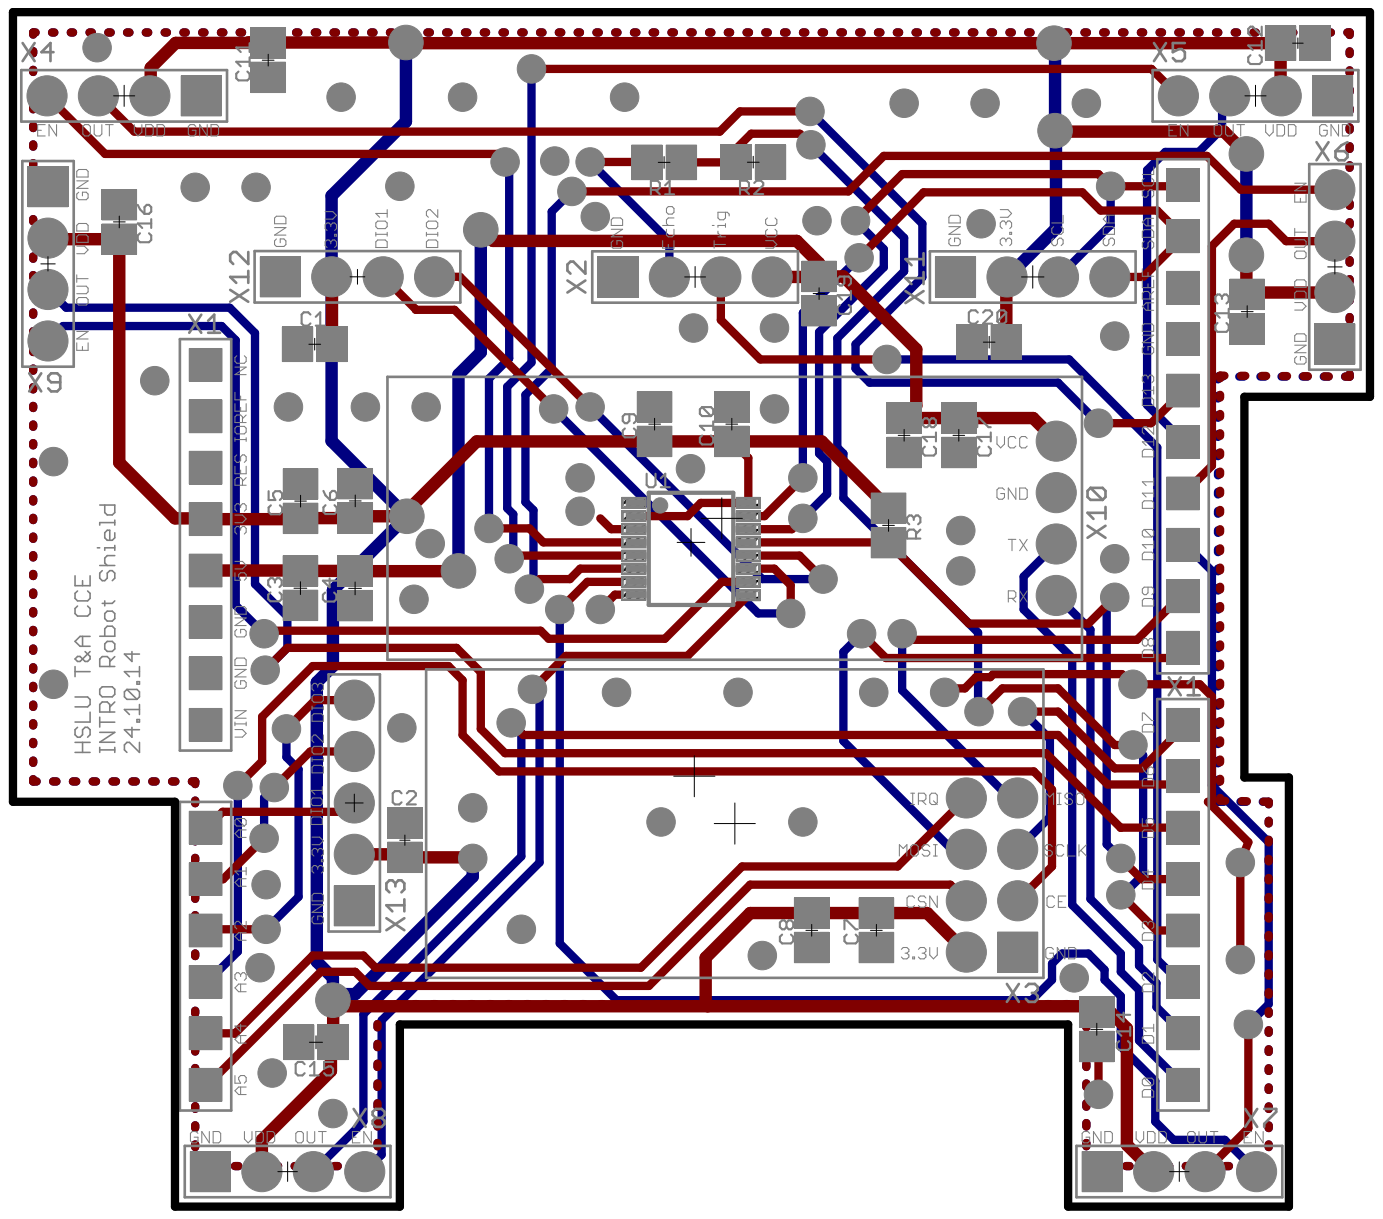
[picture p137: page 1]
