ErichStyger/mcuoneclipse/Eagle/INTRO-Robot/INTRO Zumo PCB.pdf

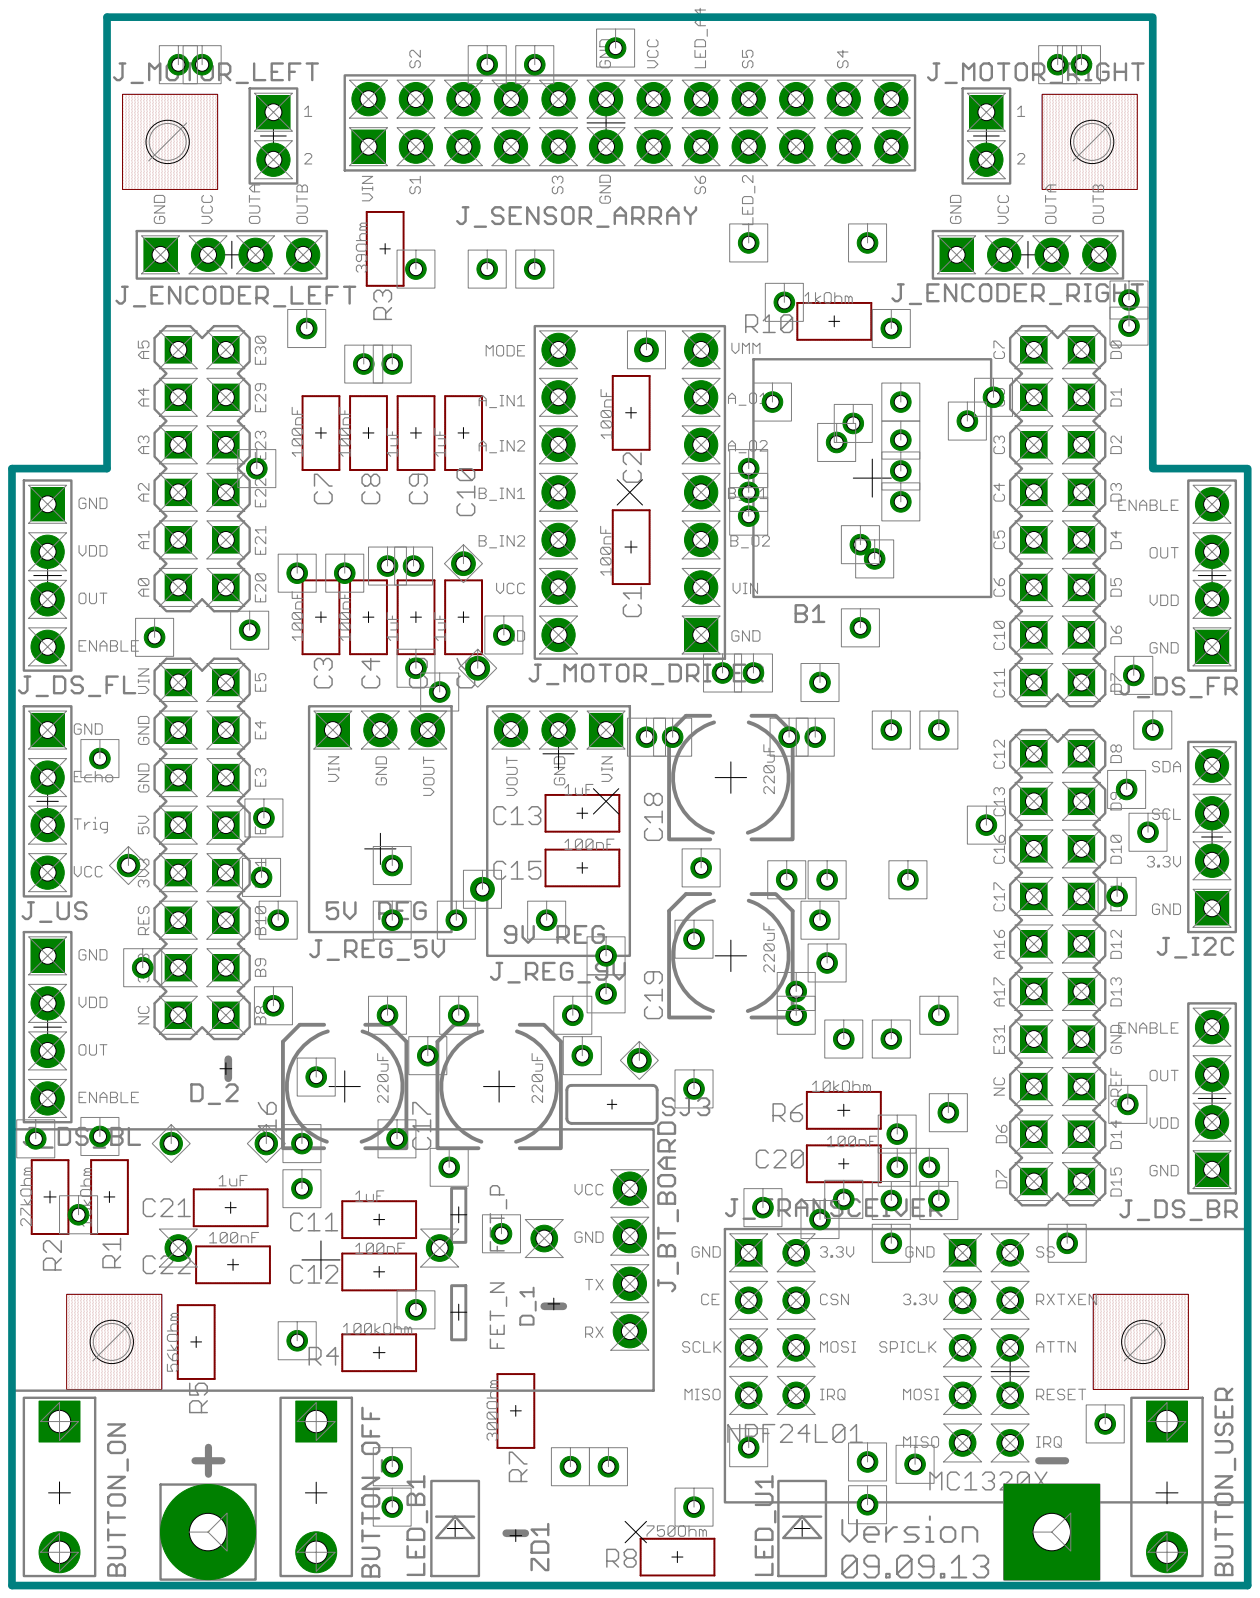
[picture p138: page 1]

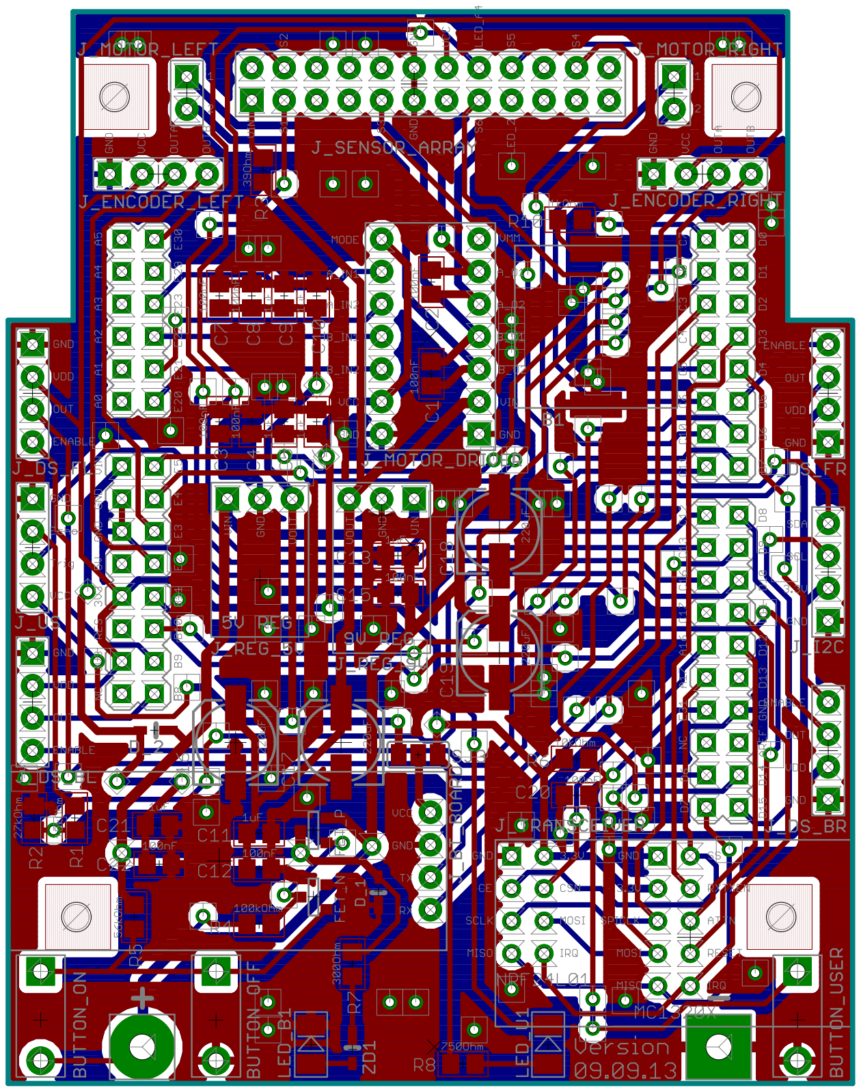
[picture p139: page 2]

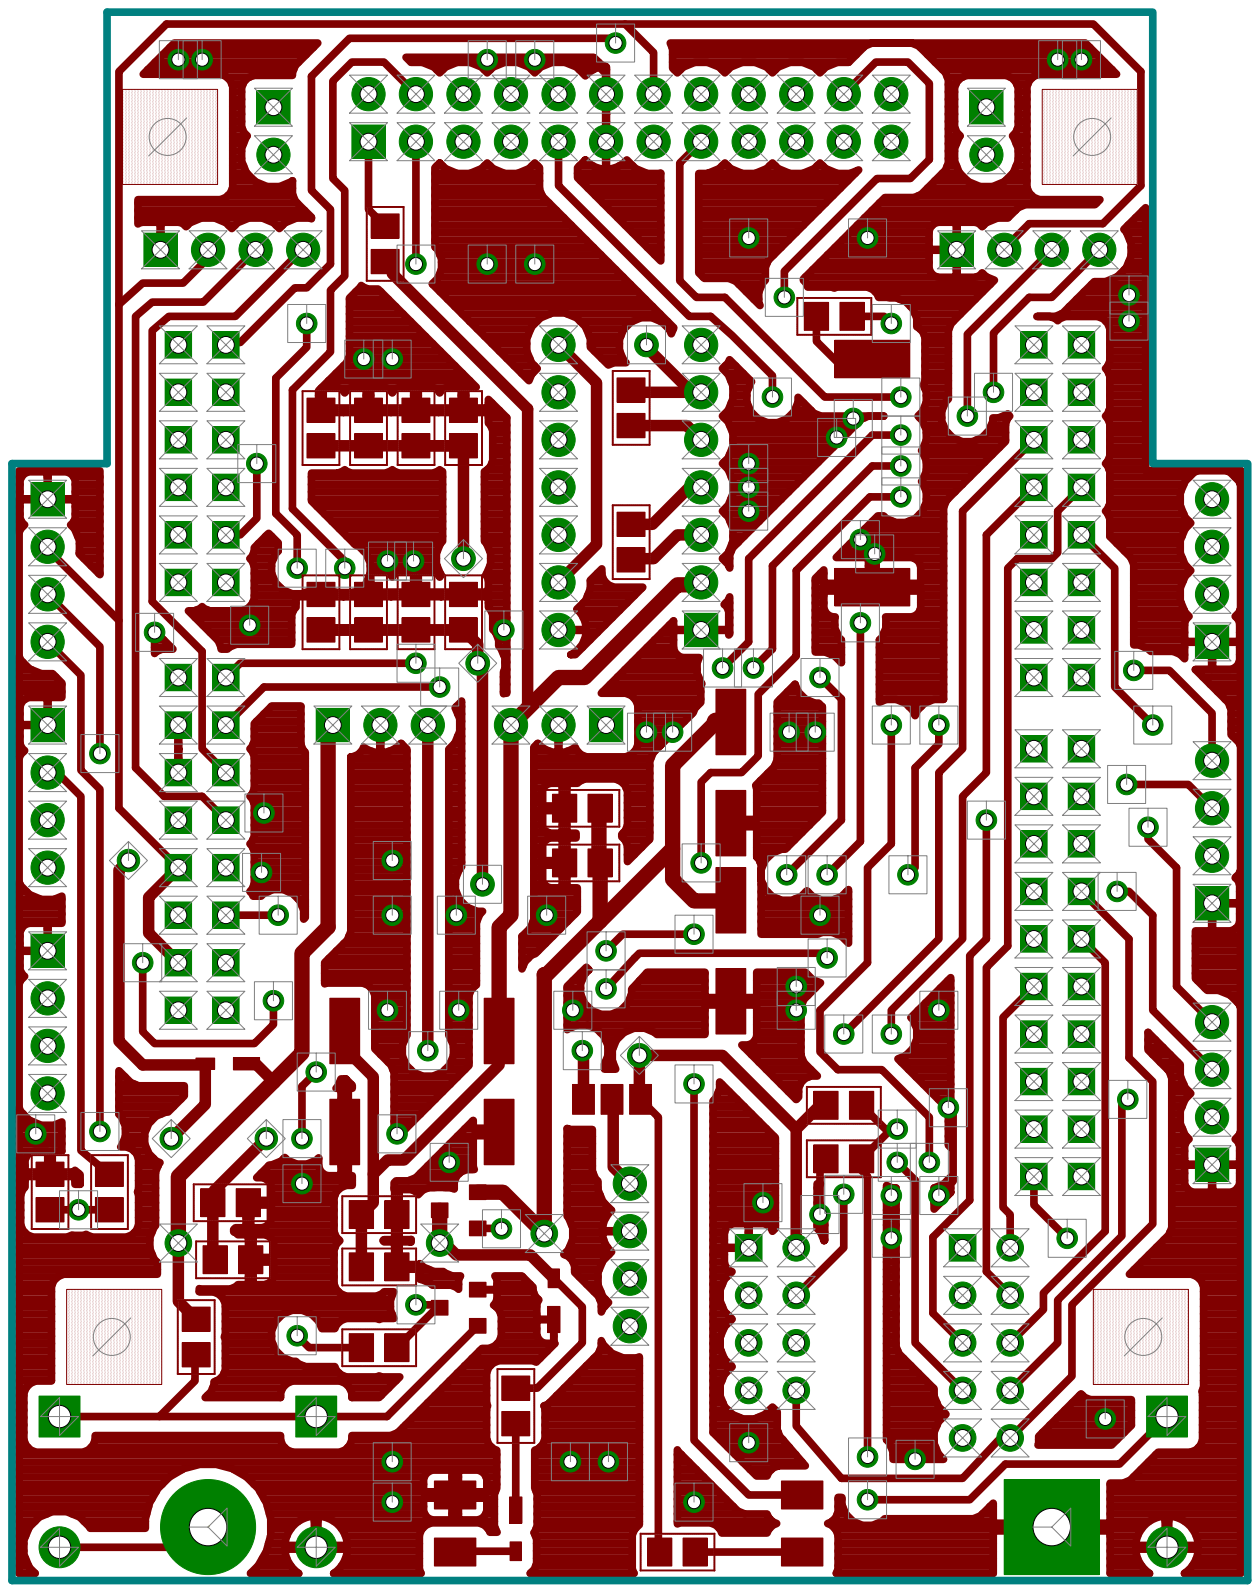
[picture p140: page 3]

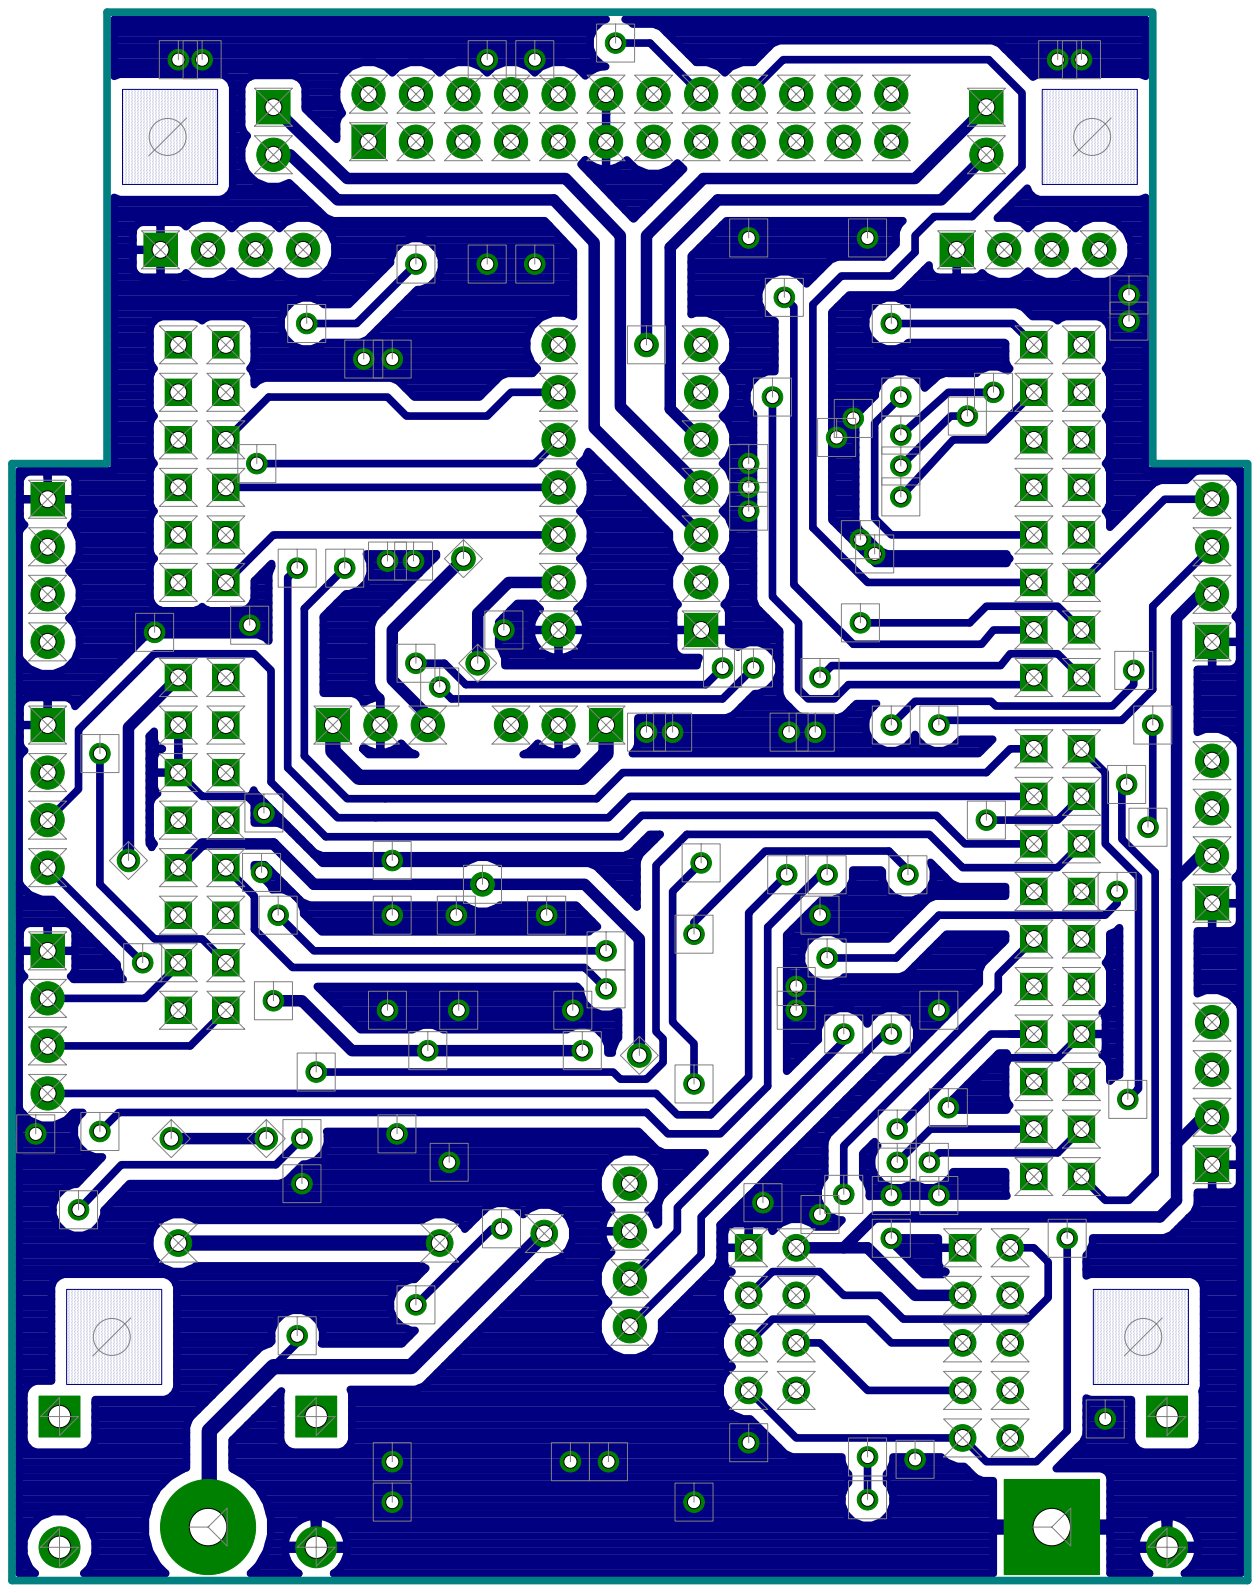
[picture p141: page 4]
