ErichStyger/mcuoneclipse/tinyK22/V1.3/Fab/TinyK22_ALL_LAYERS.pdf

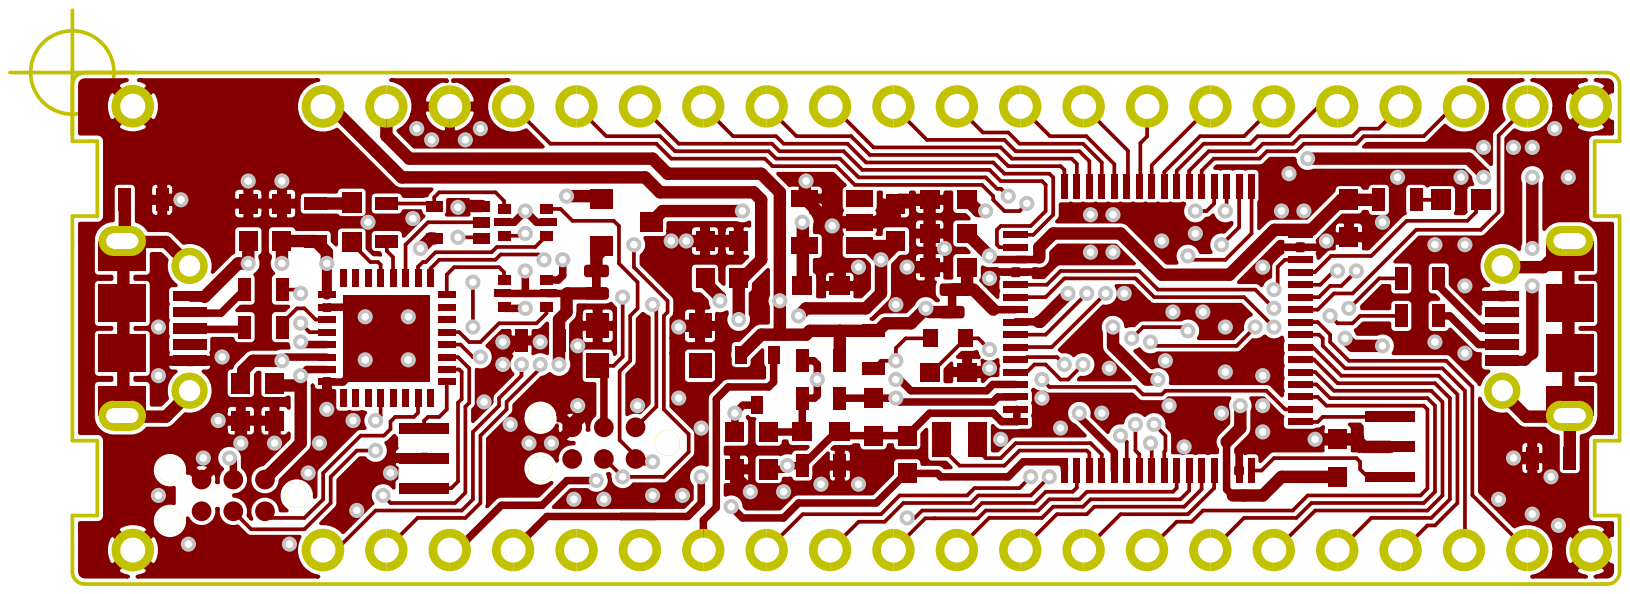
[picture p142: page 1]

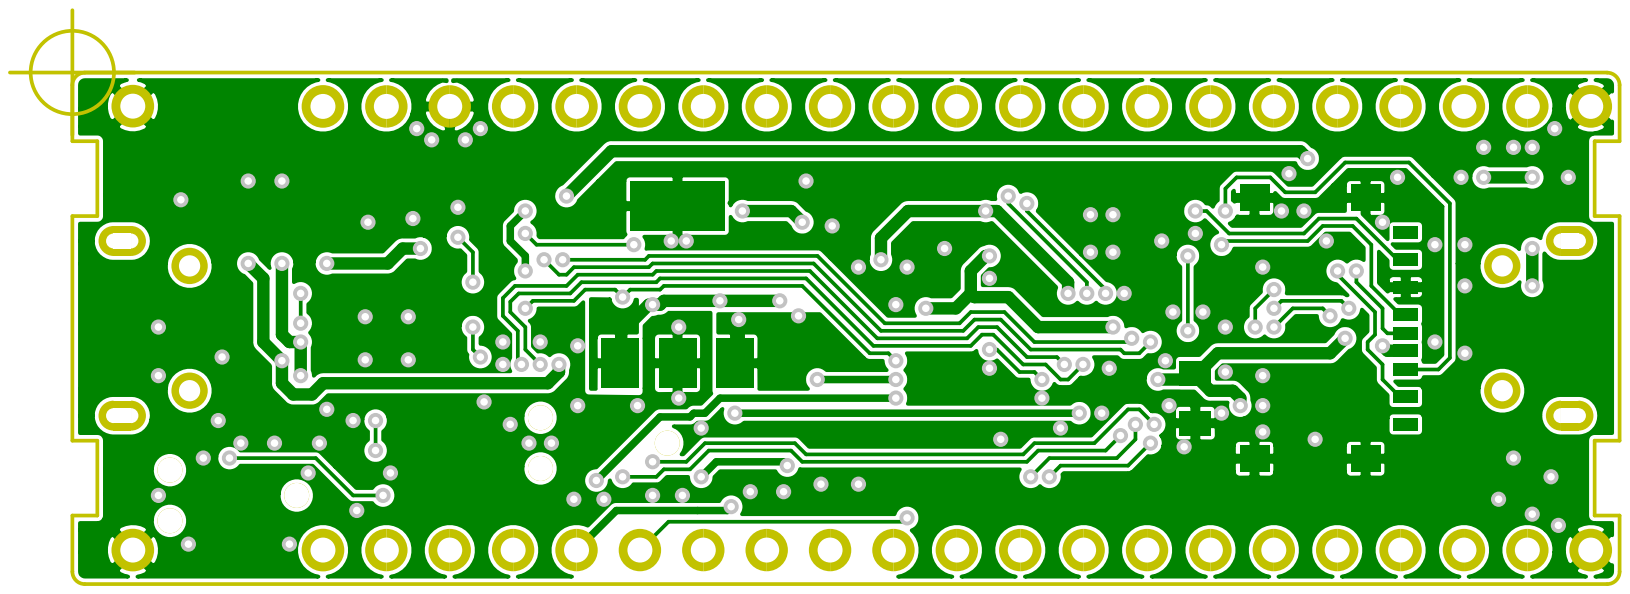
[picture p143: page 2]

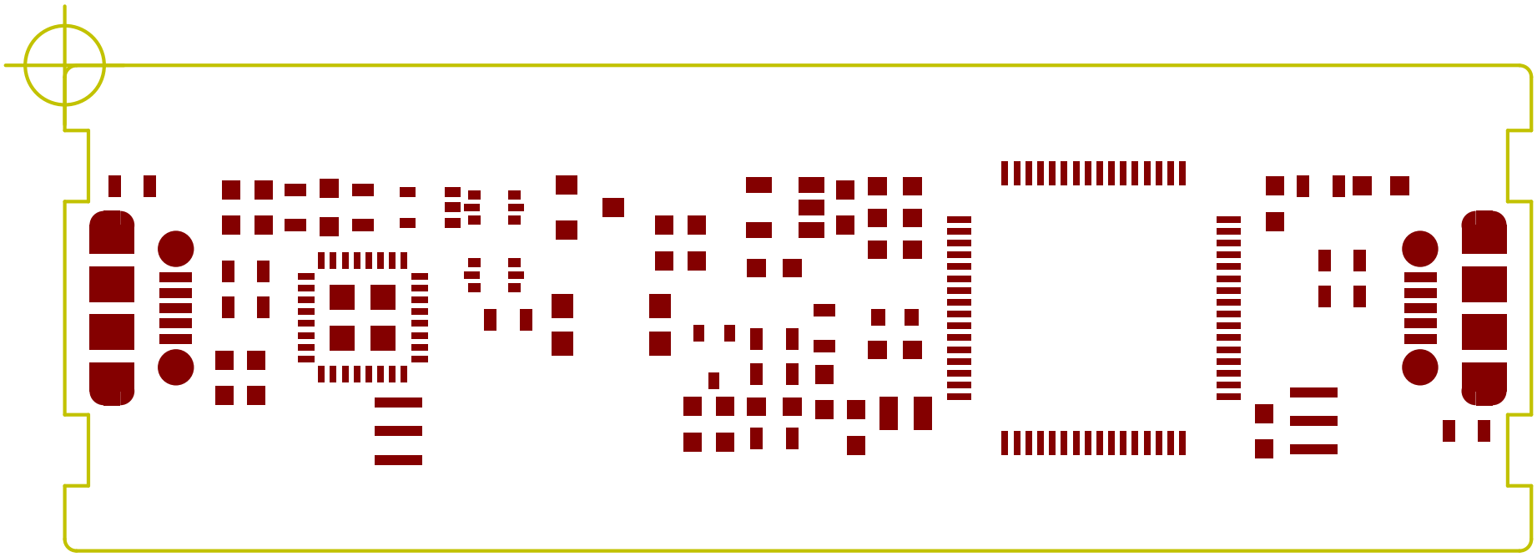
[picture p144: figure]

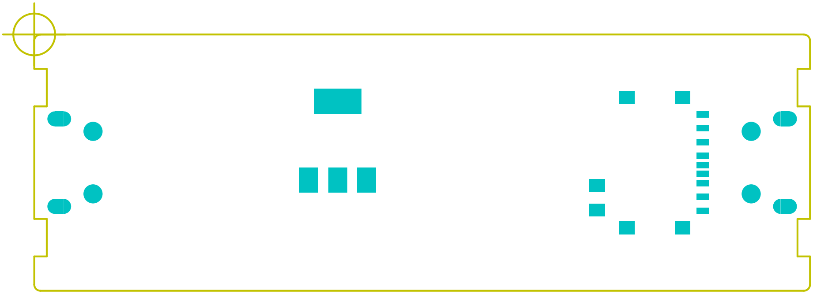
[picture p145: figure]
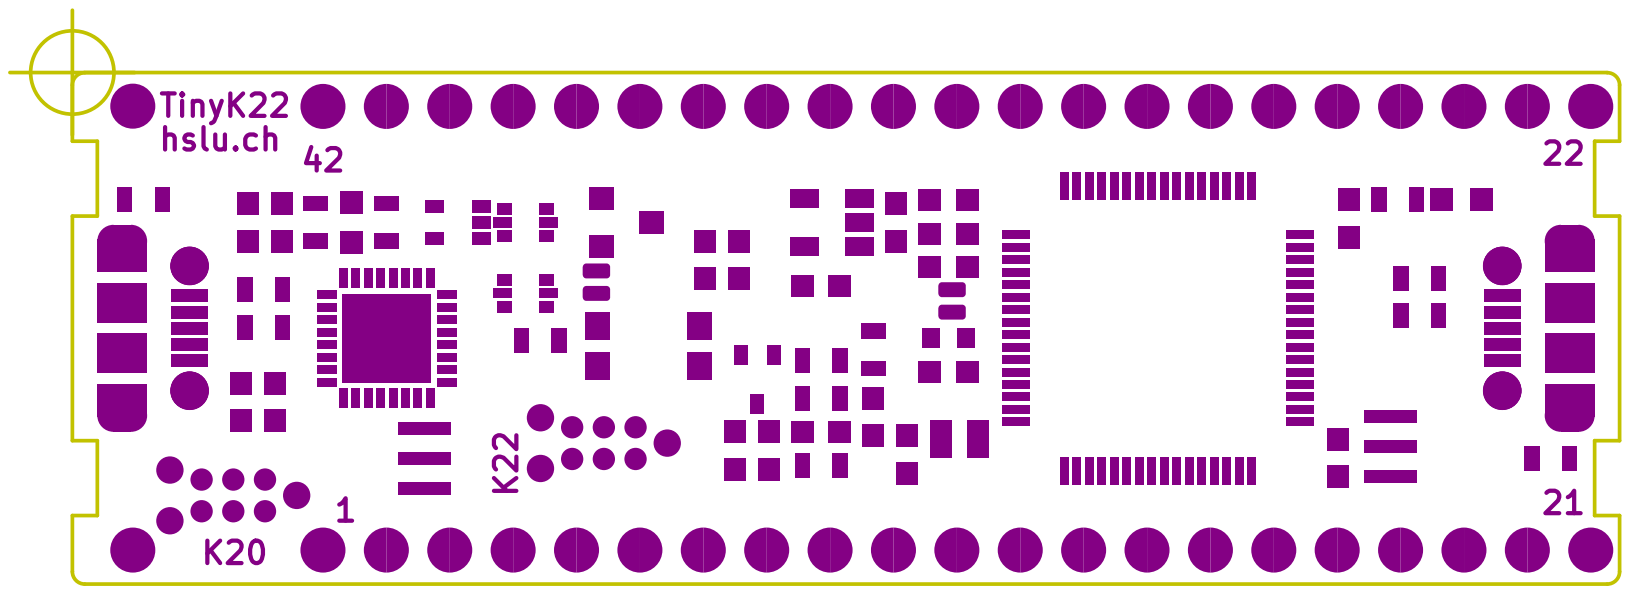
[picture p146: page 5]

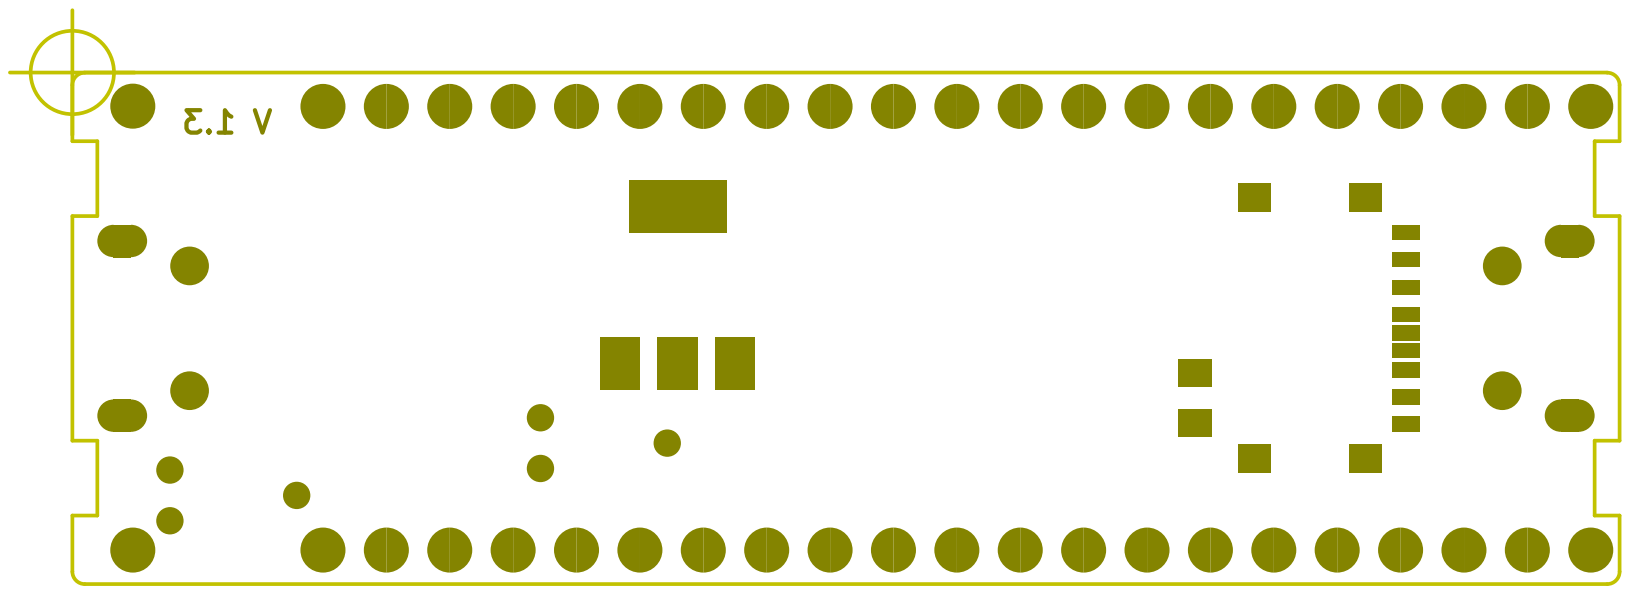
[picture p147: page 6]

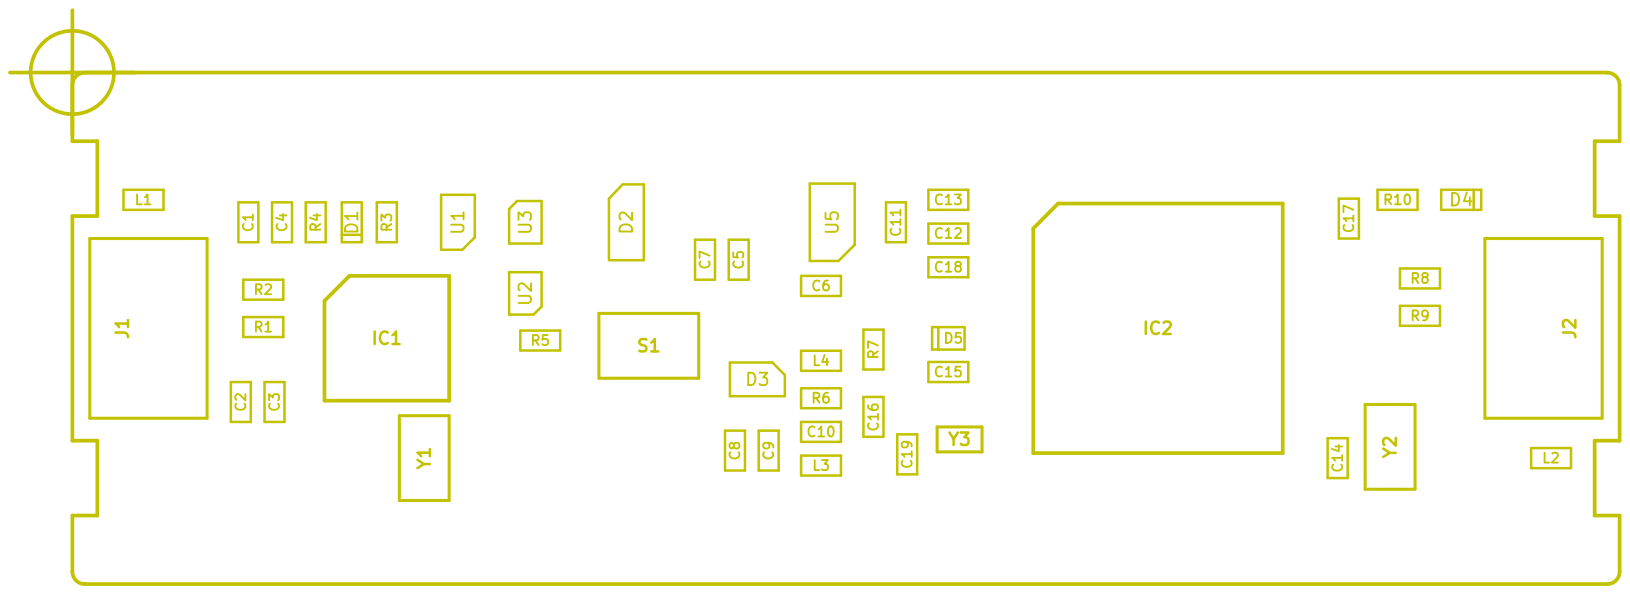
[picture p148: page 8]

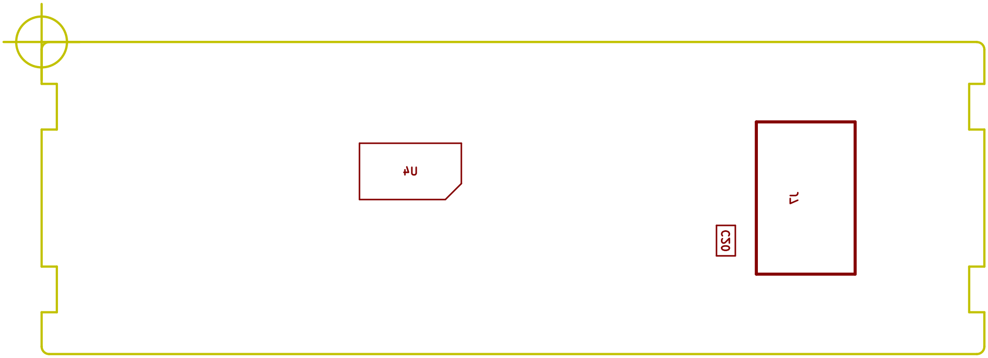
[picture p149: figure]
