ErichStyger/mcuoneclipse/tinyK22/V1.3/Fab/TinyK22_FAB_TOP.pdf

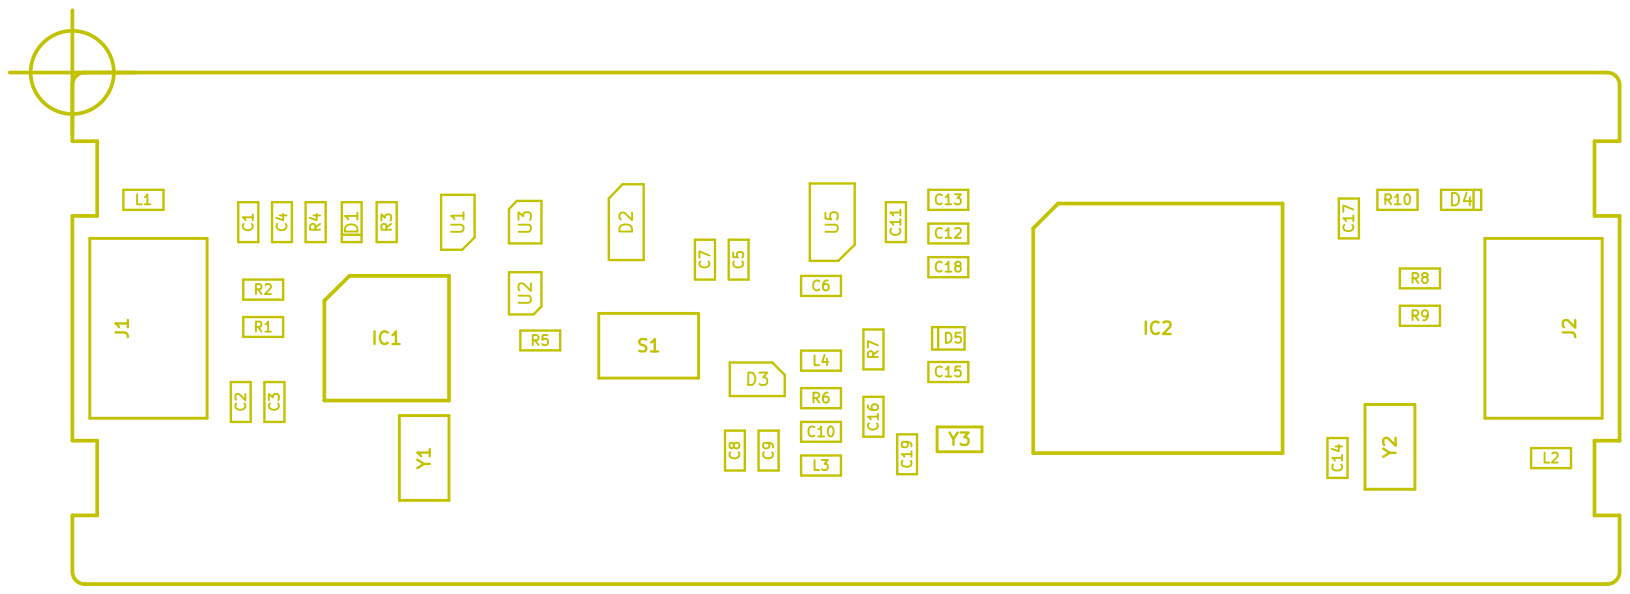
[picture p150: page 1]
