ErichStyger/mcuoneclipse/Examples/KDS/tinyK20/tinyK20_SandClock/3D/sandclock.pdf

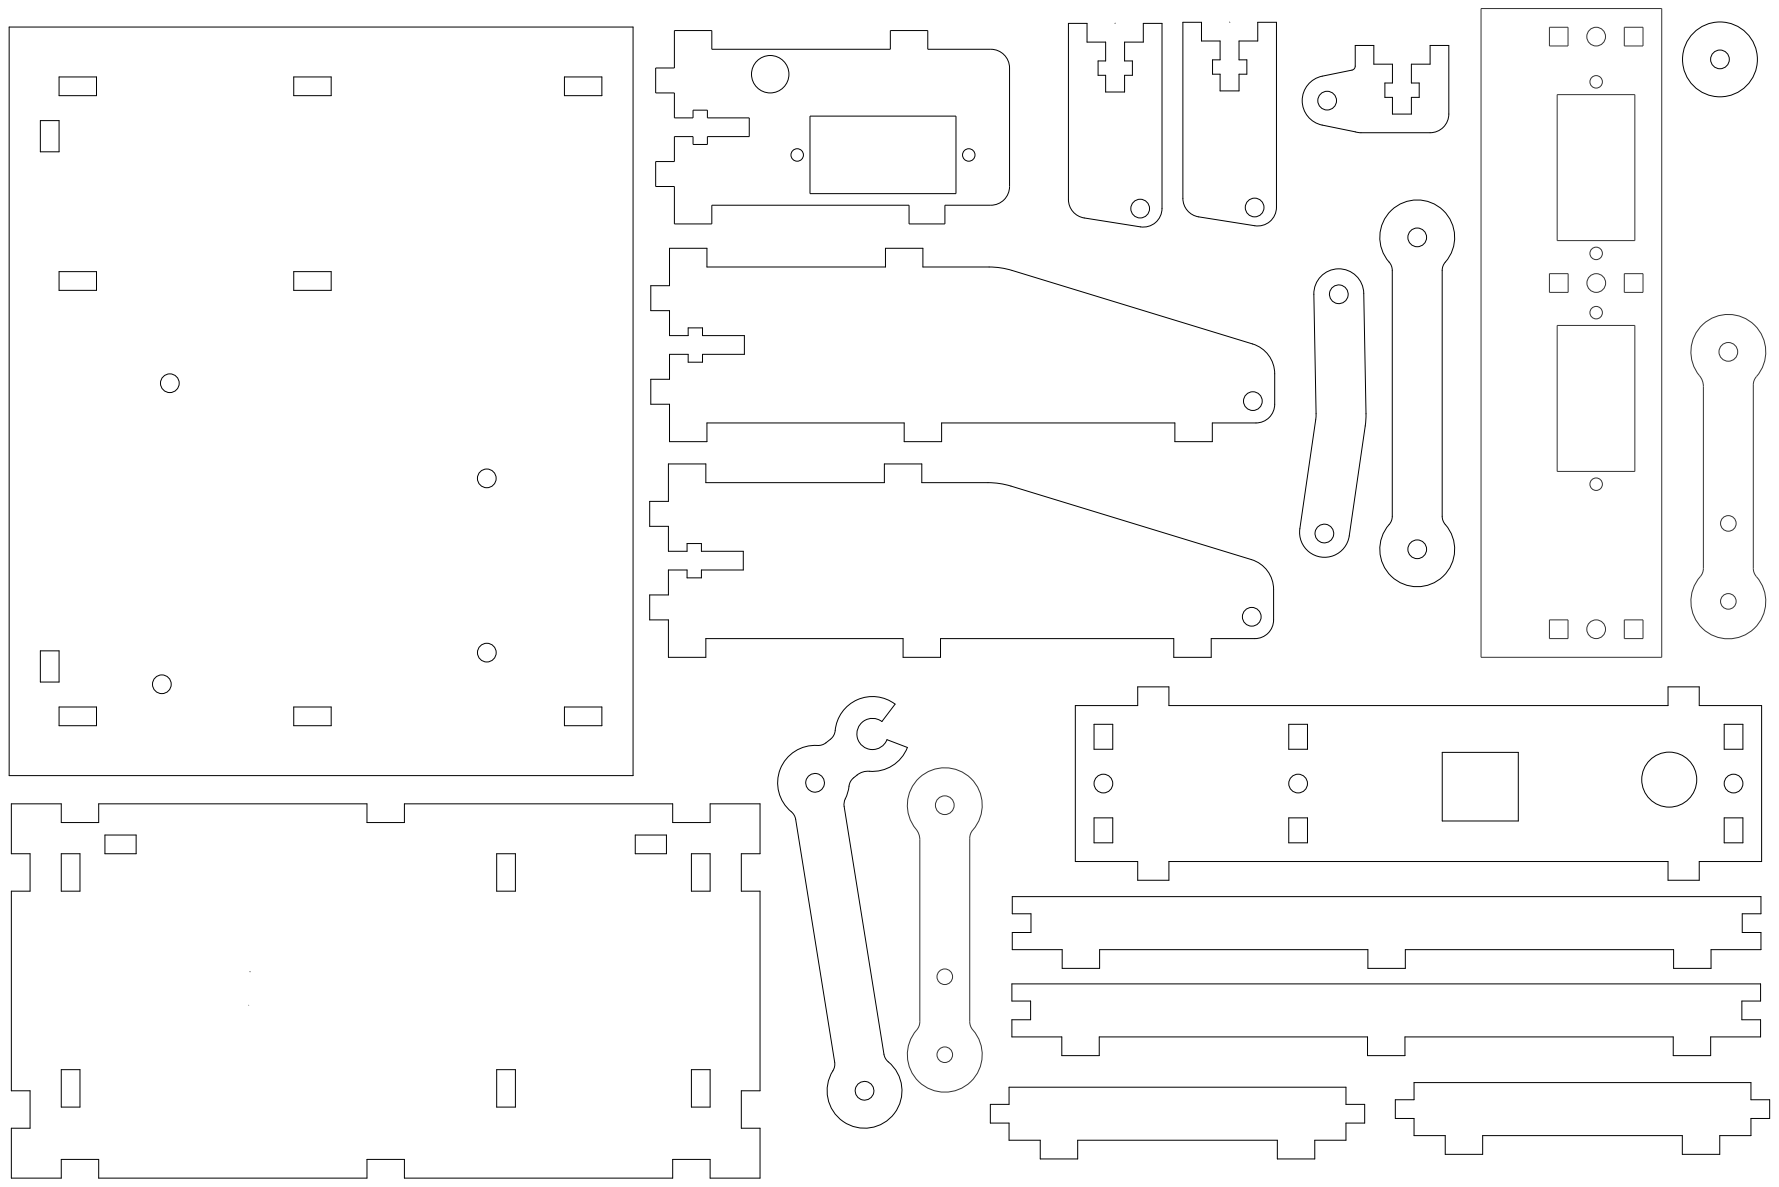
[picture p151: page 1]
