ErichStyger/mcuoneclipse/Examples/MCUXpresso/LPC845-BRK/LPC845-WorldClock/KiCad/WorldClock_V0.1/WorldClock Schematic_V0.1.pdf

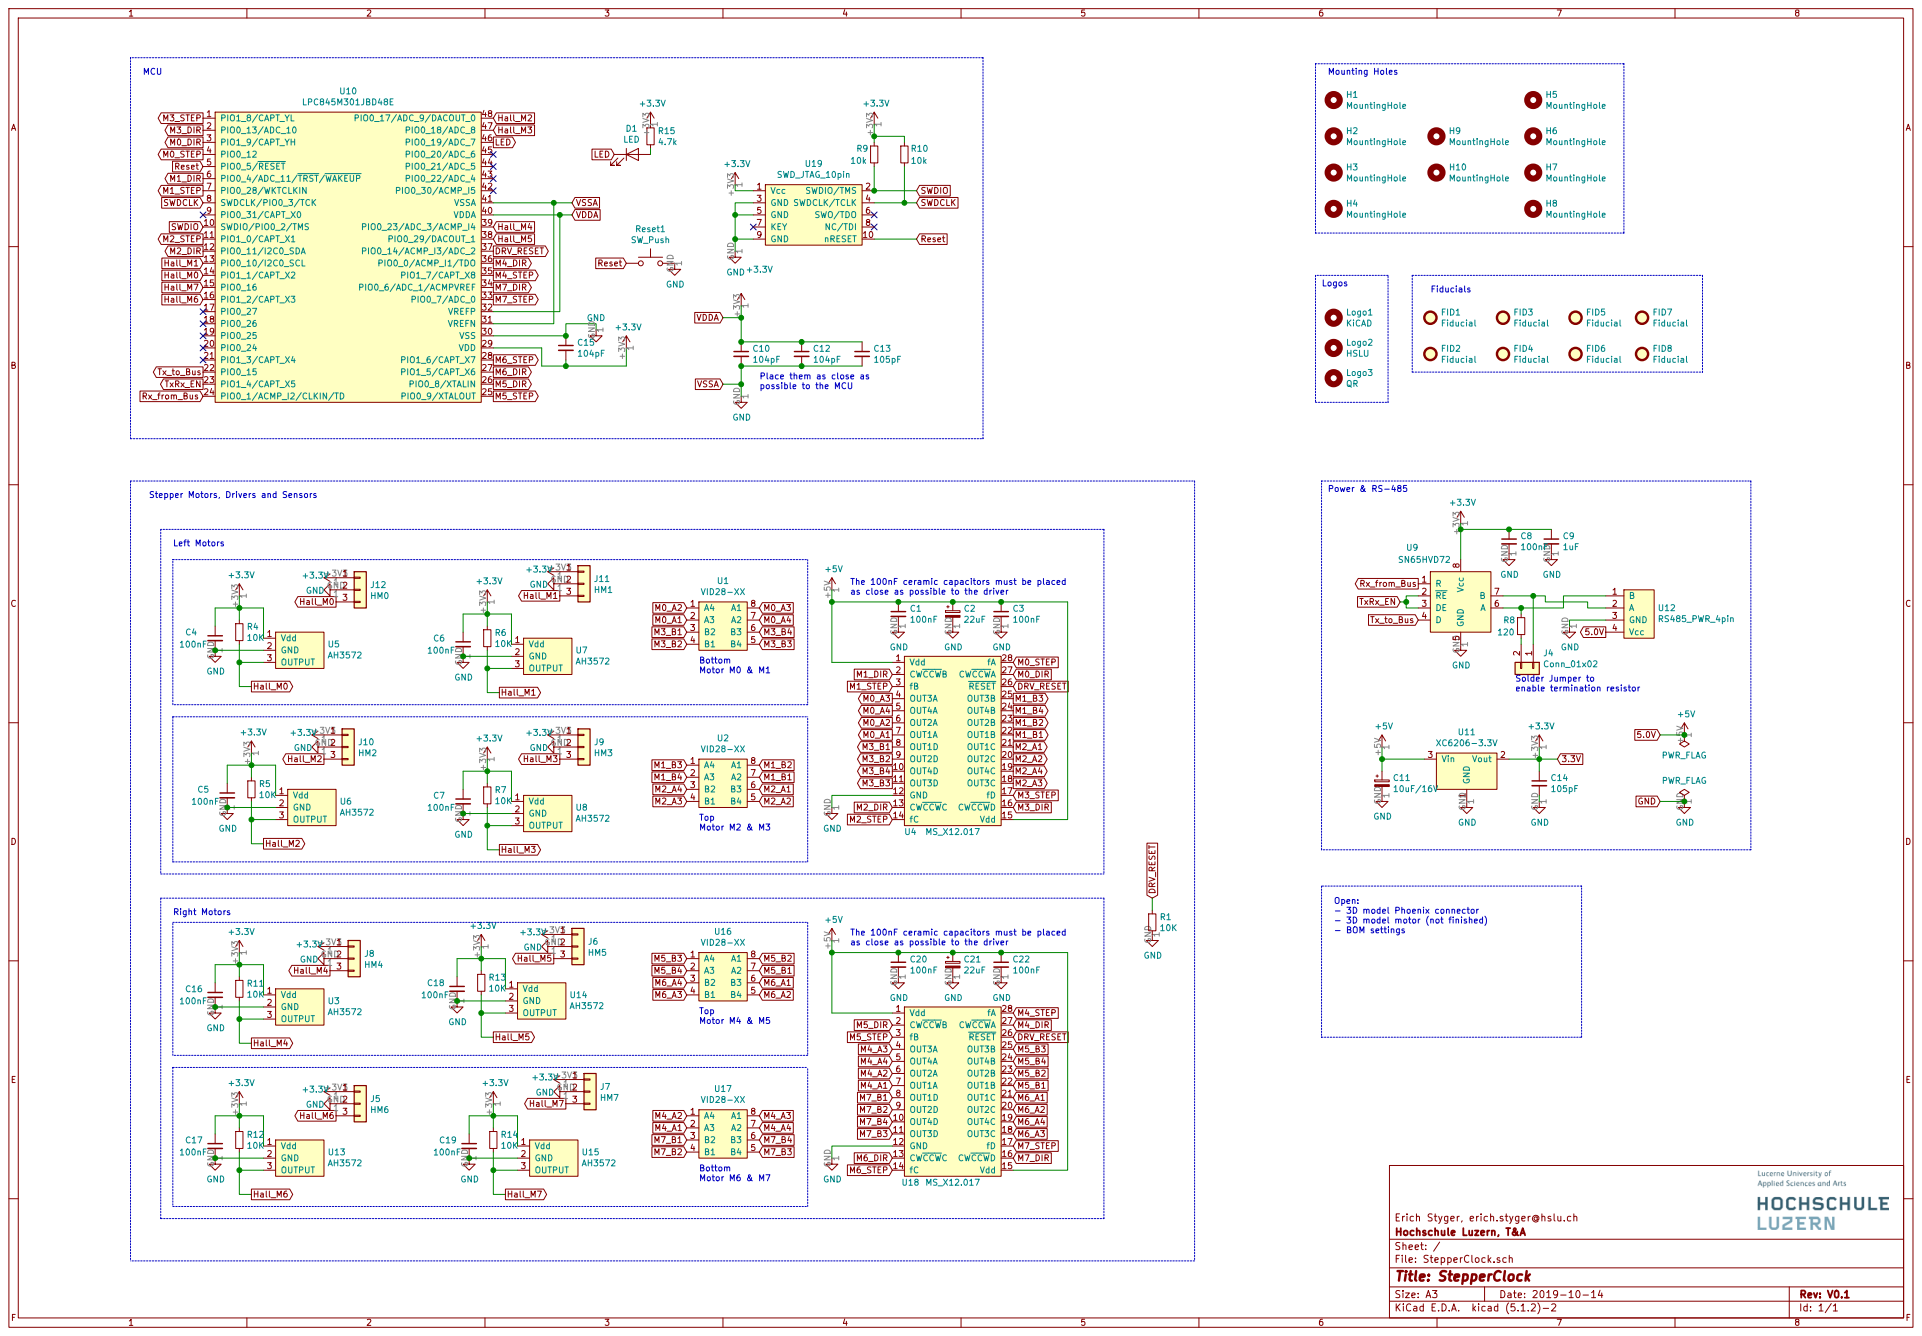
[picture p152: page 1]
