ErichStyger/mcuoneclipse/KiCAD/Projects/PicoLink/PicoLink.kicad_pcb

## KiCad design KiCAD/Projects/PicoLink/PicoLink.kicad_pcb (2023-04-06)

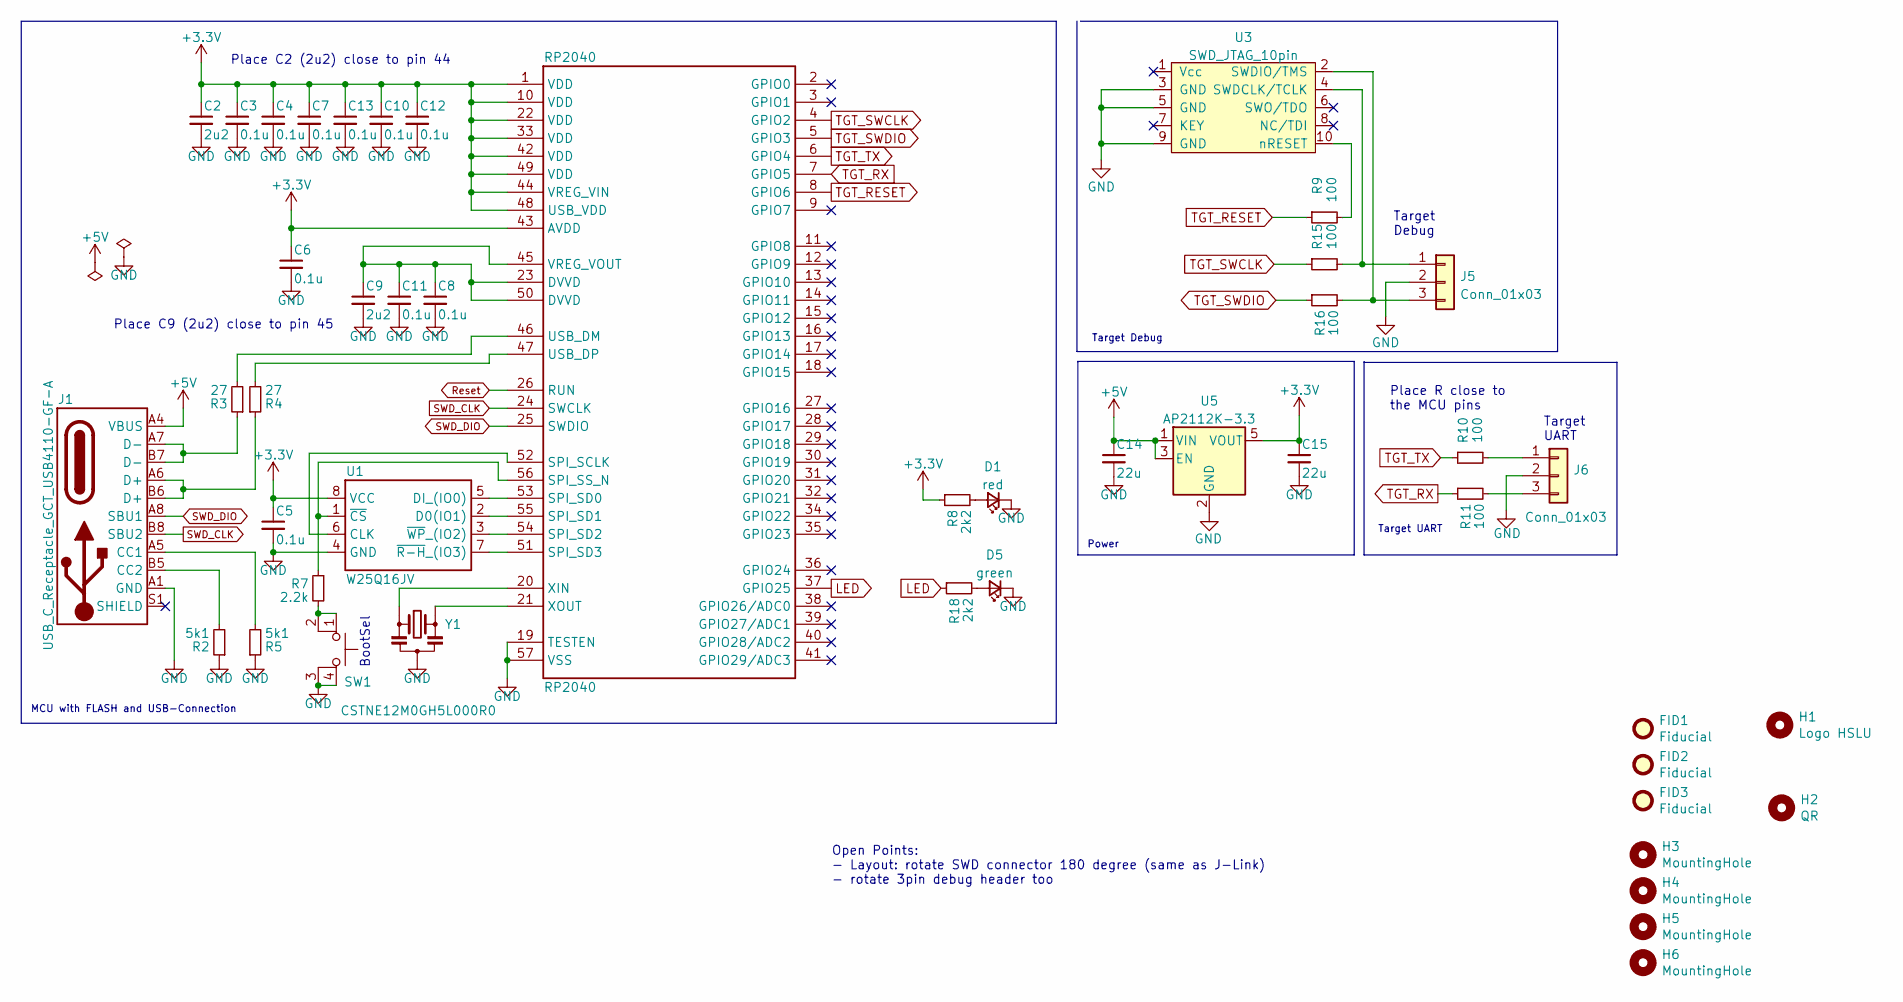
[picture p153: schematic PicoLink.kicad_sch]

Parts:
C2, C9: 2u2; C_0603_1608Metric; MFR# CC0402MRX5R6BB225; mouser# 603-CC402MRX5R6BB225
C3, C4, C6, C7, C8, C10, C11, C12, C13: 0.1u; C_0603_1608Metric; MFR# C0402C104K8RAC7867; mouser# 80-C0402C104K8R7867
C5: 0.1u; C_0603_1608Metric; MFR# CC0603KRX7R8BB104; mouser# 603-CC603KRX7R8BB104
C14, C15: 22u; C_0805; MFR# CL21A226MOQNNNE; mouser# 187-CL21A226MOQNNNE
D1: red; LED_0603
D5: green; LED_0603
FID1, FID2, FID3: Fiducial; Fiducial_1mm_Mask2mm
H1: Logo HSLU; Hochschule_Luzern_New
H2: QR; QR_McuOnEclipse_Silkscreen
H3, H4, H5, H6: MountingHole; MountingHole_2.7mm_M2.5
J1: USB_C_Receptacle_GCT_USB4110-GF-A; MFR# USB4110-GF-A; mouser# 640-USB4110-GF-A
J5, J6: Conn_01x03; PinHeader_1x03_P2.54mm_Vertical
R2, R5: 5k1; R_0603_1608Metric; MFR# RC0603JR-075K6L; mouser# 603-RC0603JR-075K6L
R3, R4: 27; R_0603_1608Metric; MFR# RC0603JR-0727RL; mouser# 603-RC0603JR-0727RL
R7: 2.2k; R_0603_1608Metric; MFR# RC0603JR-071KL; mouser# 603-RC0603JR-071KL
R8, R18: 2k2; R_0603_1608Metric; MFR# RC0603JR-071KL; mouser# 603-RC0603JR-071KL
R9, R10, R11, R15, R16: 100; R_0603_1608Metric; MFR# RC0603JR-071KL; mouser# 603-RC0603JR-071KL
RP2040: RP2040; QFN-56-1EP_7x7mm_P0.4mm_EP3.2x3.2mm; MFR# RPI Chip RP2040-7-500; mouser# 358-RP2040CHIP-7-500
SW1: 434123025826_BTN
U1: W25Q16JV; USON_2x3x0.6mm; MFR# W25Q16JVUXIQ TR; mouser# 454-W25Q16JVUXIQTR
U3: SWD_JTAG_10pin; SWD_Pin_Header_Straight_2x05_Pitch1.27mm_SMD
U5: AP2112K-3.3; IC-SOT25; mouser# 621-AP2112K-3.3TRG1
Y1: CSTNE12M0GH5L000R0; Resonator_SMD_Murata_CSTxExxV-3Pin_3.0x1.1mm; MFR# CSTNE12M0GH5L000R0; mouser# 81-CSTNE12M0GH5L000R

Connections:
+3.3V: C2.1, C3.1, C4.1, C5.1, C6.1, C7.1, C10.1, C12.1, C13.1, C15.1, R8.1, RP2040.1 (VDD), RP2040.10 (VDD), RP2040.22 (VDD), RP2040.33 (VDD), RP2040.42 (VDD), RP2040.43 (AVDD), RP2040.44 (VREG_VIN), RP2040.48 (USB_VDD), RP2040.49 (VDD), U1.8 (VCC), U5.5 (VOUT)
+5V: C14.1, J1.A4 (VBUS), J1.A9 (VBUS), J1.B4 (VBUS), J1.B9 (VBUS), U5.1 (VIN), U5.3 (EN)
GND: C2.2, C3.2, C4.2, C5.2, C6.2, C7.2, C8.2, C9.2, C10.2, C11.2, C12.2, C13.2, C14.2, C15.2, D1.1 (K), D5.1 (K), J1.A1 (GND), J1.A12 (GND), J1.B1 (GND), J1.B12 (GND), J5.2, J6.2, R2.1, R5.1, RP2040.19 (TESTEN), RP2040.57 (VSS), SW1.3 (K), SW1.4 (A), U1.4 (GND), U3.3 (GND), U3.5 (GND), U3.9 (GND), U5.2 (GND), Y1.2
LED: R18.1, RP2040.37 (GPIO25)
unnamed: C8.1, C9.1, C11.1, RP2040.23 (DVVD), RP2040.45 (VREG_VOUT), RP2040.50 (DVVD)
unnamed: D1.2 (A), R8.2
unnamed: D5.2 (A), R18.2
unnamed: J1.A5 (CC1), R5.2
unnamed: J1.A6 (D+), J1.B6 (D+), R4.1
unnamed: J1.A7 (D-), J1.B7 (D-), R3.1
unnamed: J1.B5 (CC2), R2.2
unnamed: J5.1, R15.2, U3.4 (SWDCLK/TCLK)
unnamed: J5.3, R16.2, U3.2 (SWDIO/TMS)
unnamed: J6.1, R10.2
unnamed: J6.3, R11.2
unnamed: R3.2, RP2040.46 (USB_DM)
unnamed: R4.2, RP2040.47 (USB_DP)
unnamed: R7.1, RP2040.56 (SPI_SS_N), U1.1 (~CS)
unnamed: R7.2, SW1.1, SW1.2
unnamed: R9.2, U3.10 (nRESET)
unnamed: RP2040.20 (XIN), Y1.1
unnamed: RP2040.21 (XOUT), Y1.3
unnamed: RP2040.51 (SPI_SD3), U1.7 (~R-H_(IO3))
unnamed: RP2040.52 (SPI_SCLK), U1.6 (CLK)
unnamed: RP2040.53 (SPI_SD0), U1.5 (DI_(IO0))
unnamed: RP2040.54 (SPI_SD2), U1.3 (~WP_(IO2))
unnamed: RP2040.55 (SPI_SD1), U1.2 (D0(IO1))
Reset: RP2040.26 (RUN)
SWD_CLK: J1.B8 (SBU2), RP2040.24 (SWCLK)
SWD_DIO: J1.A8 (SBU1), RP2040.25 (SWDIO)
TGT_RESET: R9.1, RP2040.8 (GPIO6)
TGT_RX: R11.1, RP2040.7 (GPIO5)
TGT_SWCLK: R15.1, RP2040.4 (GPIO2)
TGT_SWDIO: R16.1, RP2040.5 (GPIO3)
TGT_TX: R10.1, RP2040.6 (GPIO4)

Notes on the sheet:
Open Points: - Layout: rotate SWD connector 180 degree (same as J-Link) - rotate 3pin debug header too
Target Debug
MCU with FLASH and USB-Connection
Target Debug
Target UART
Place R close to the MCU pins
Target UART
Place C2 (2u2) close to pin 44
Place C9 (2u2) close to pin 45
Power
BootSel

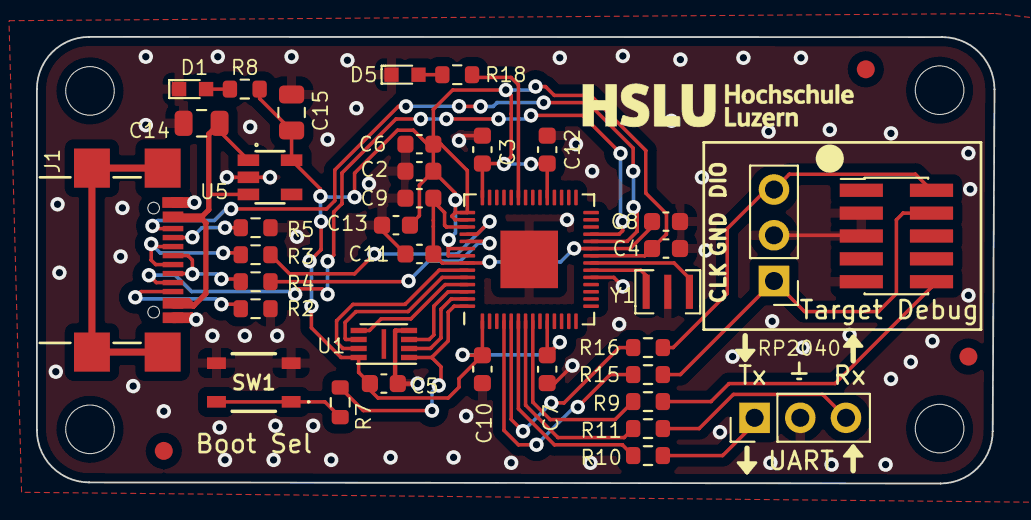
[picture p154: board PicoLink.kicad_pcb from above]

Board: 2 copper layers, 53.2 x 24.8 mm, 46 parts (1 on the bottom side), 34 nets.
