ErichStyger/mcuoneclipse/KiCAD/Projects/PicoWS2812B/PicoWS2812.kicad_pcb

## KiCad design KiCAD/Projects/PicoWS2812B/PicoWS2812.kicad_pcb (2023-04-02)

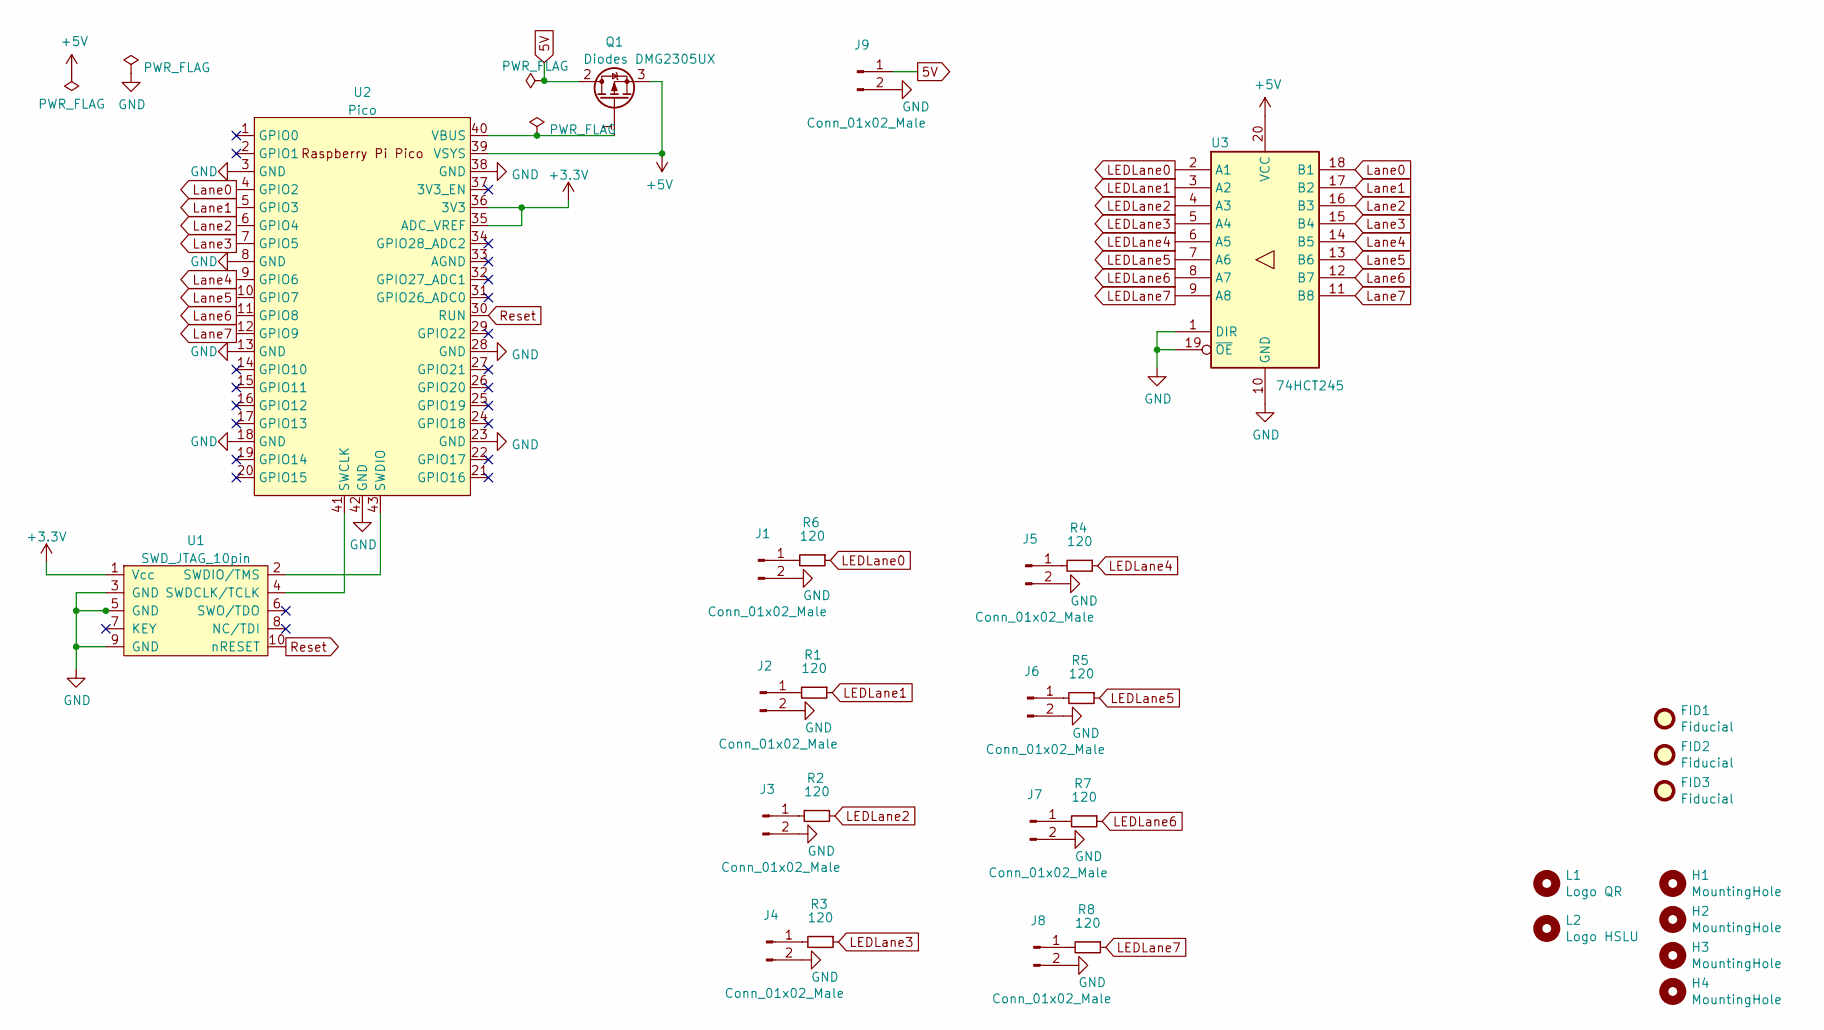
[picture p155: schematic PicoWS2812.kicad_sch]

Parts:
FID1, FID2, FID3: Fiducial; Fiducial_1mm_Mask2mm
H1, H2, H3, H4: MountingHole; MountingHole_2.7mm_M2.5
J1, J2, J3, J4, J5, J6, J7, J8, J9: Conn_01x02_Male; PinHeader_1x02_P2.54mm_Horizontal
L1: Logo QR; QR_McuOnEclipse_Silkscreen_9x9mm
L2: Logo HSLU; Hochschule_Luzern_Small
Q1: Diodes DMG2305UX; SOT-23_2T; mouser# 621-DMG2305UX-7
R1, R2, R3, R4, R5, R6, R7, R8: 120; R_0603_1608Metric
U1: SWD_JTAG_10pin; SWD_Pin_Header_Straight_2x05_Pitch1.27mm_SMD
U2: Pico; RPi_Pico_SMD_TH
U3: 74HCT245; SSOP-20_4.4x6.5mm_Pitch0.65mm

Connections:
5V: J9.1, Q1.2 (D)
+3.3V: U1.1 (Vcc), U2.35 (ADC_VREF), U2.36 (3V3)
+5V: Q1.3 (S), U2.39 (VSYS), U3.20 (VCC)
GND: J1.2, J2.2, J3.2, J4.2, J5.2, J6.2, J7.2, J8.2, J9.2, U1.3 (GND), U1.5 (GND), U1.9 (GND), U2.3 (GND), U2.8 (GND), U2.13 (GND), U2.18 (GND), U2.23 (GND), U2.28 (GND), U2.38 (GND), U2.42 (GND), U3.1 (DIR), U3.10 (GND), U3.19 (~OE)
LEDLane0: R6.1, U3.2 (A1)
LEDLane1: R1.1, U3.3 (A2)
LEDLane2: R2.1, U3.4 (A3)
LEDLane3: R3.1, U3.5 (A4)
LEDLane4: R4.1, U3.6 (A5)
LEDLane5: R5.1, U3.7 (A6)
LEDLane6: R7.1, U3.8 (A7)
LEDLane7: R8.1, U3.9 (A8)
Lane0: U2.4 (GPIO2), U3.18 (B1)
Lane1: U2.5 (GPIO3), U3.17 (B2)
Lane2: U2.6 (GPIO4), U3.16 (B3)
Lane3: U2.7 (GPIO5), U3.15 (B4)
Lane4: U2.9 (GPIO6), U3.14 (B5)
Lane5: U2.10 (GPIO7), U3.13 (B6)
Lane6: U2.11 (GPIO8), U3.12 (B7)
Lane7: U2.12 (GPIO9), U3.11 (B8)
unnamed: J1.1, R6.2
unnamed: J2.1, R1.2
unnamed: J3.1, R2.2
unnamed: J4.1, R3.2
unnamed: J5.1, R4.2
unnamed: J6.1, R5.2
unnamed: J7.1, R7.2
unnamed: J8.1, R8.2
unnamed: Q1.1 (G), U2.40 (VBUS)
unnamed: U1.2 (SWDIO/TMS), U2.43 (SWDIO)
unnamed: U1.4 (SWDCLK/TCLK), U2.41 (SWCLK)
Reset: U1.10 (nRESET), U2.30 (RUN)

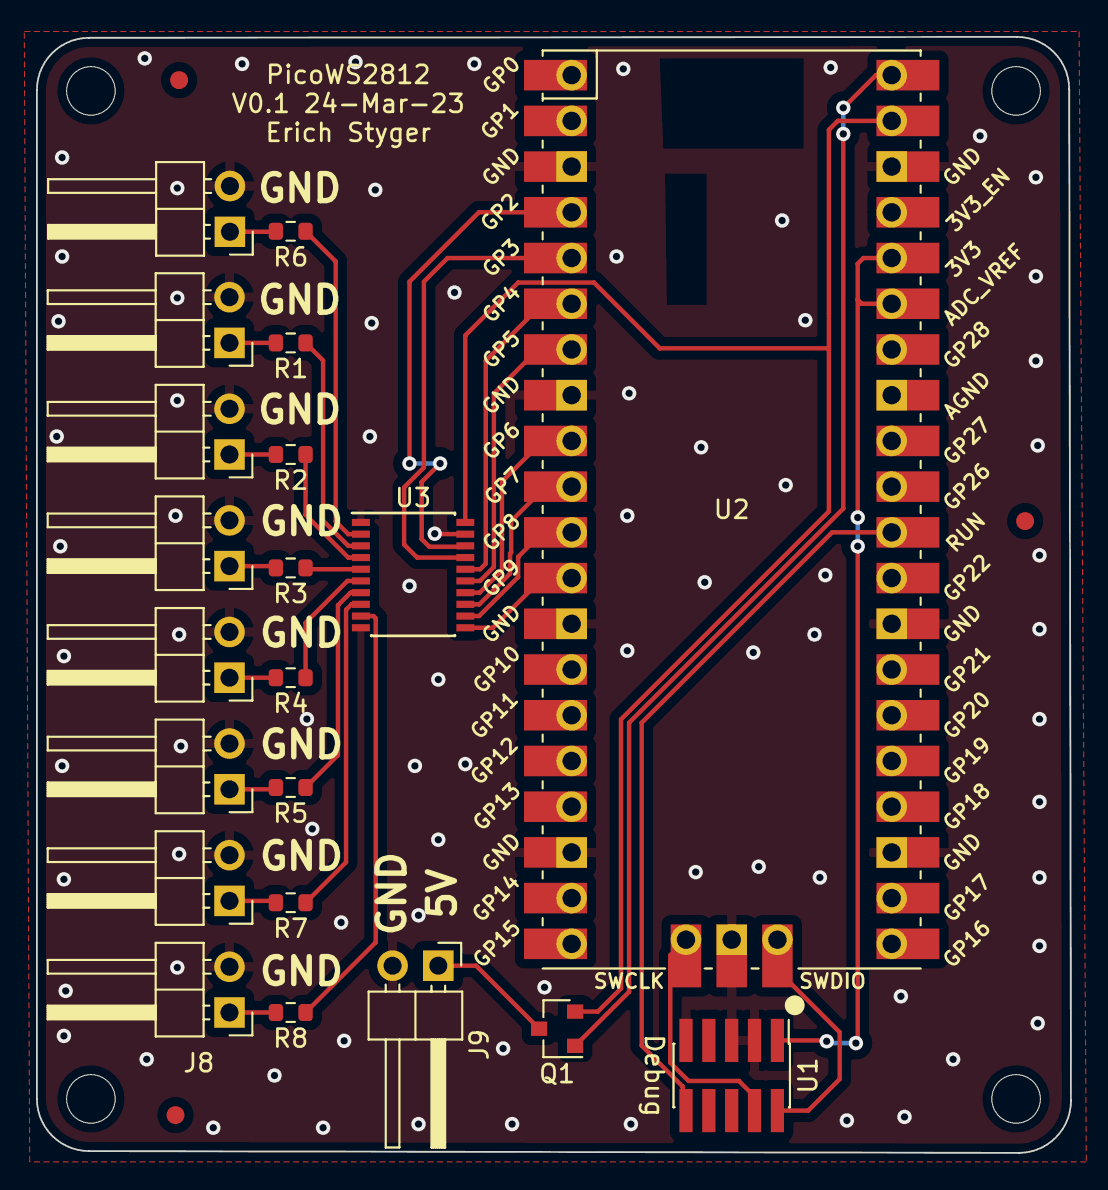
[picture p156: board PicoWS2812.kicad_pcb from above]

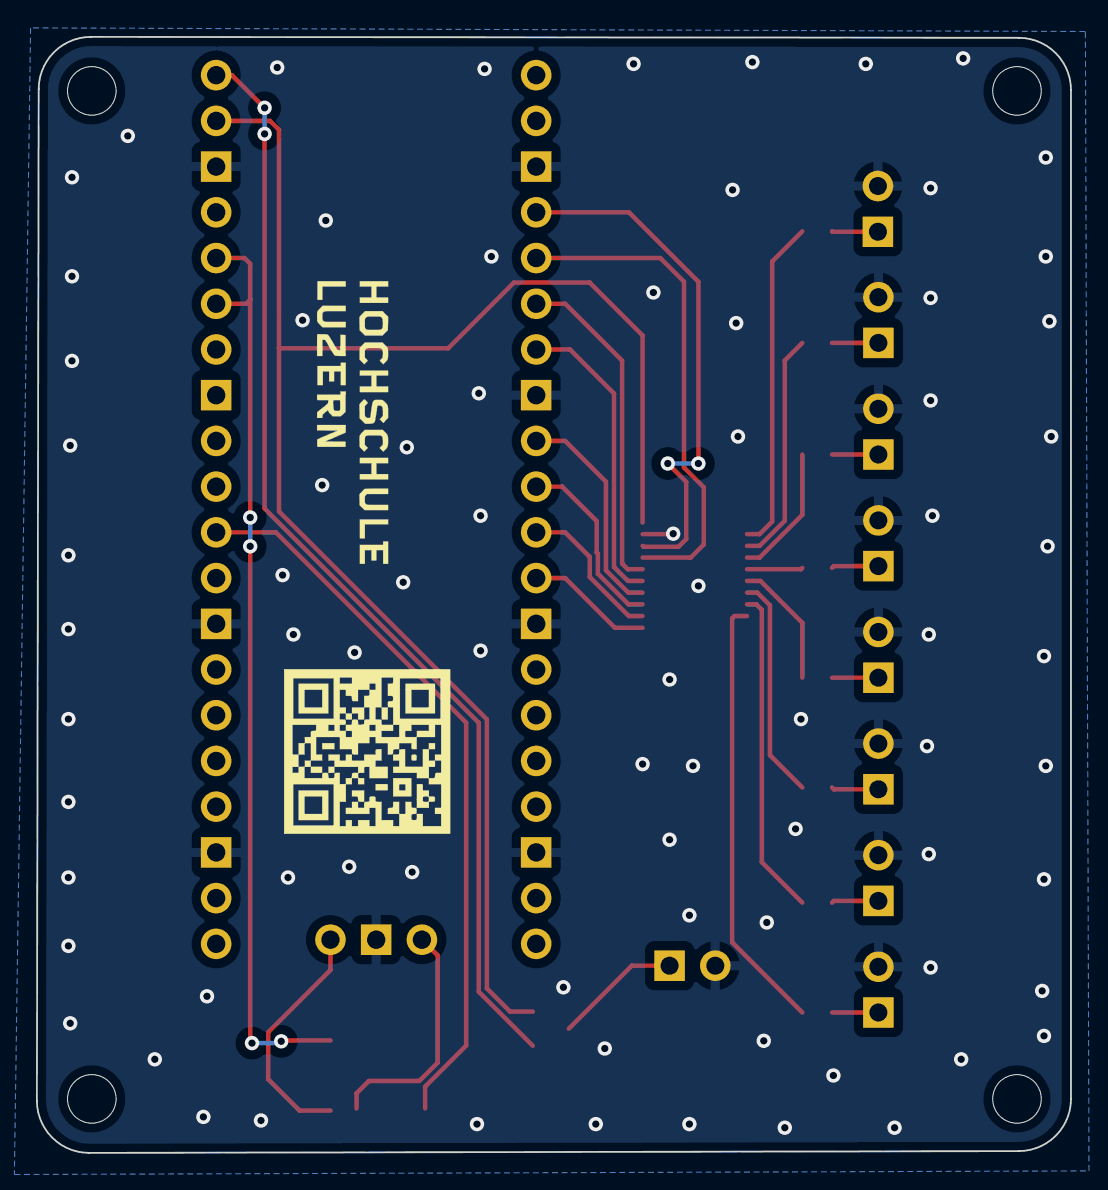
[picture p157: board PicoWS2812.kicad_pcb from below]

Board: 2 copper layers, 57.4 x 62.0 mm, 30 parts (2 on the bottom side), 32 nets.
