ErichStyger/mcuoneclipse/KiCAD/Projects/FT2232_ESP32_Debug/FT2232_ESP32_Debug.kicad_pcb

## KiCad design KiCAD/Projects/FT2232_ESP32_Debug/FT2232_ESP32_Debug.kicad_pcb (2019-10-27)

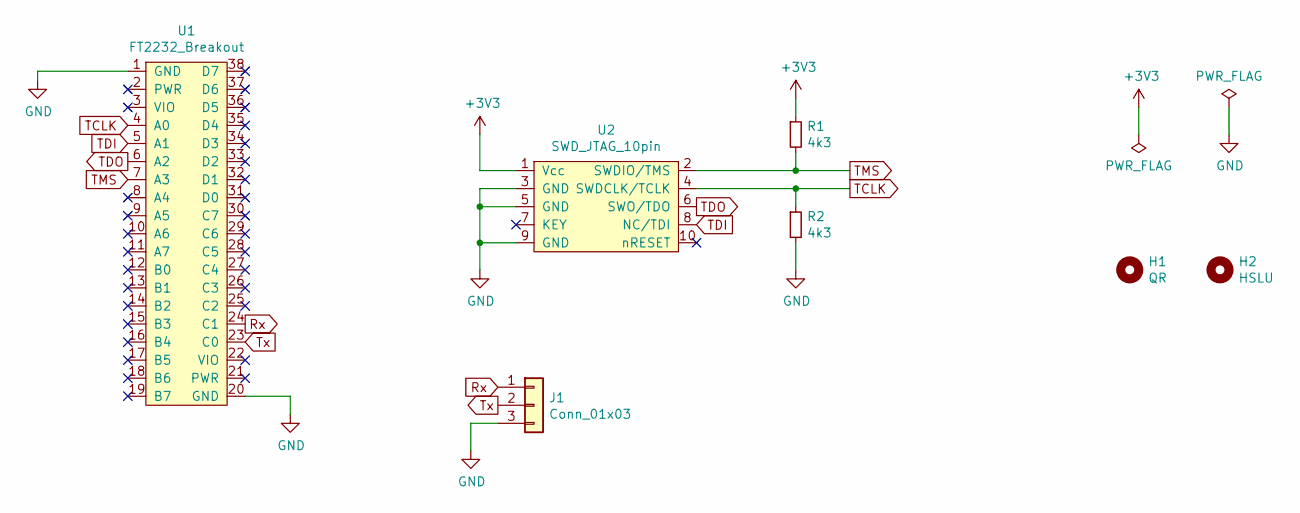
[picture p158: schematic FT2232_ESP32_Debug.sch, FT2232 Debug Shield for ESP32]

Parts:
H1: QR; QR_McuOnEclipse_Silkscreen_9x9mm
H2: HSLU; HSLU_Logo_Silkscreen
J1: Conn_01x03; Pin_Header_Straight_1x03_Pitch2.54mm
R1, R2: 4k3; R_0603
U1: FT2232_Breakout; FT2232_Breakout_Pin_Header_Straight_2x19_Pitch2.54mm
U2: SWD_JTAG_10pin; SWD_Pin_Header_Straight_2x05_Pitch1.27mm

Connections:
+3V3: R1.1, U2.1 (Vcc)
GND: J1.3, R2.2, U1.1 (GND), U1.20 (GND), U2.3 (GND), U2.5 (GND), U2.9 (GND)
Rx: J1.1, U1.24 (C1)
TCLK: R2.1, U1.4 (A0), U2.4 (SWDCLK/TCLK)
TDI: U1.5 (A1), U2.8 (NC/TDI)
TDO: U1.6 (A2), U2.6 (SWO/TDO)
TMS: R1.2, U1.7 (A3), U2.2 (SWDIO/TMS)
Tx: J1.2, U1.23 (C0)

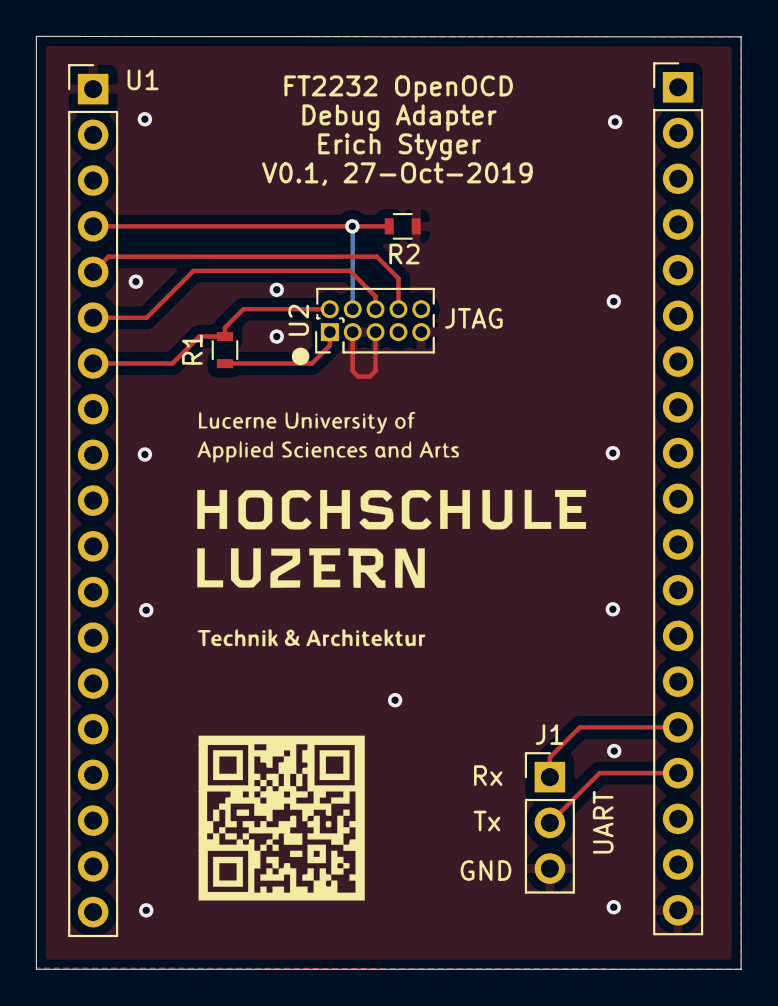
[picture p159: board FT2232_ESP32_Debug.kicad_pcb from above]

Board: 2 copper layers, 39.1 x 51.8 mm, 7 parts (0 on the bottom side), 8 nets.
