ErichStyger/mcuoneclipse/KiCAD/Projects/SumoRobot/SumoRobot.kicad_pcb

## KiCad design KiCAD/Projects/SumoRobot/SumoRobot.kicad_pcb (2018-07-19)

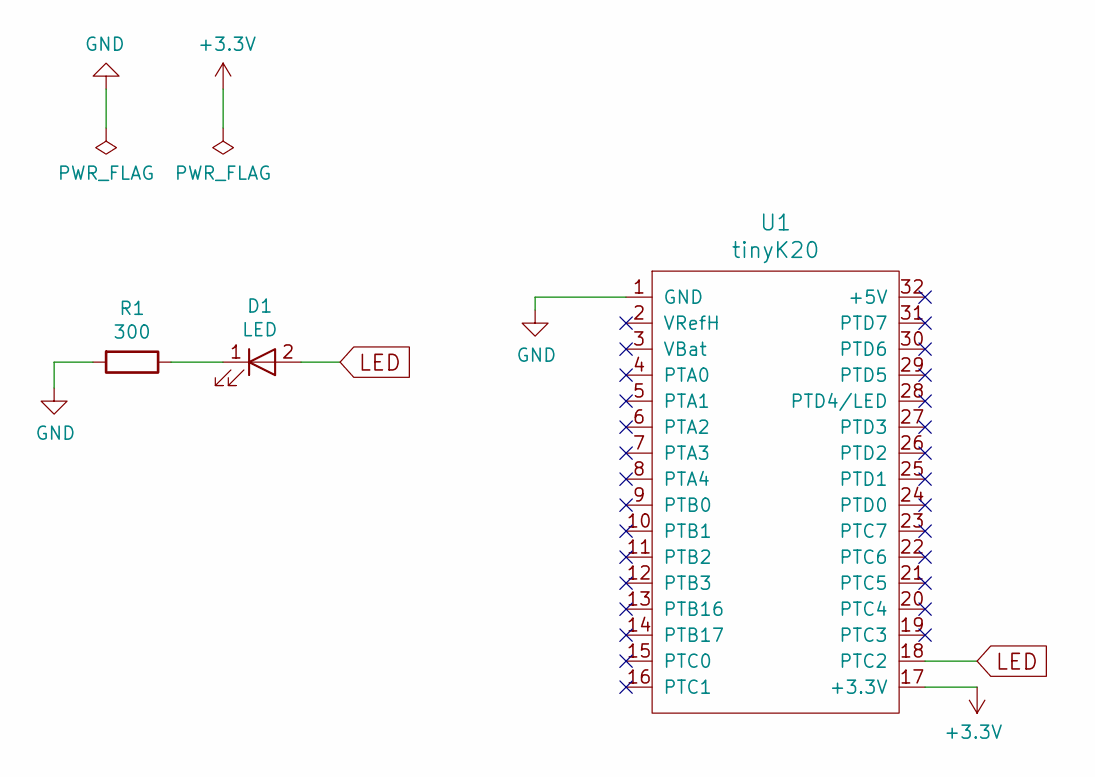
[picture p160: schematic SumoRobot.sch]

Parts:
D1: LED; LED_0805
R1: 300; R_0805
U1: tinyK20; DIP-32_W15.24mm

Connections:
+3V3: U1.17 (+3.3V)
GND: R1.2, U1.1 (GND)
LED: D1.2 (A), U1.18 (PTC2)
unnamed: D1.1 (K), R1.1

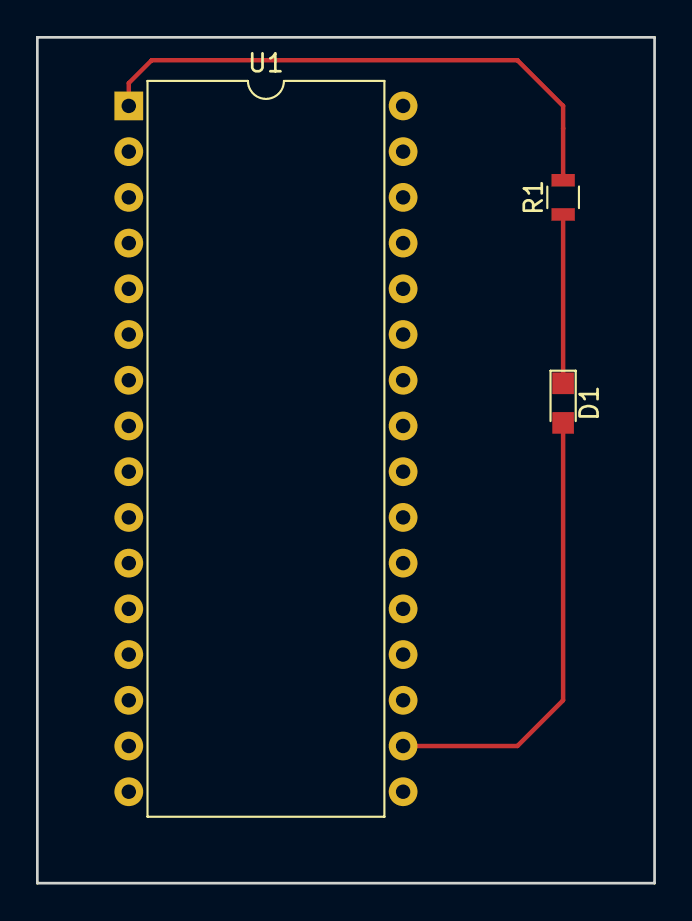
[picture p161: board SumoRobot.kicad_pcb from above]

Board: 2 copper layers, 34.3 x 47.0 mm, 3 parts (0 on the bottom side), 3 nets.
