ErichStyger/mcuoneclipse/tinyK20/Board/tinyK20.brd

## EAGLE design tinyK20/Board/tinyK20.brd (2015-06-26)

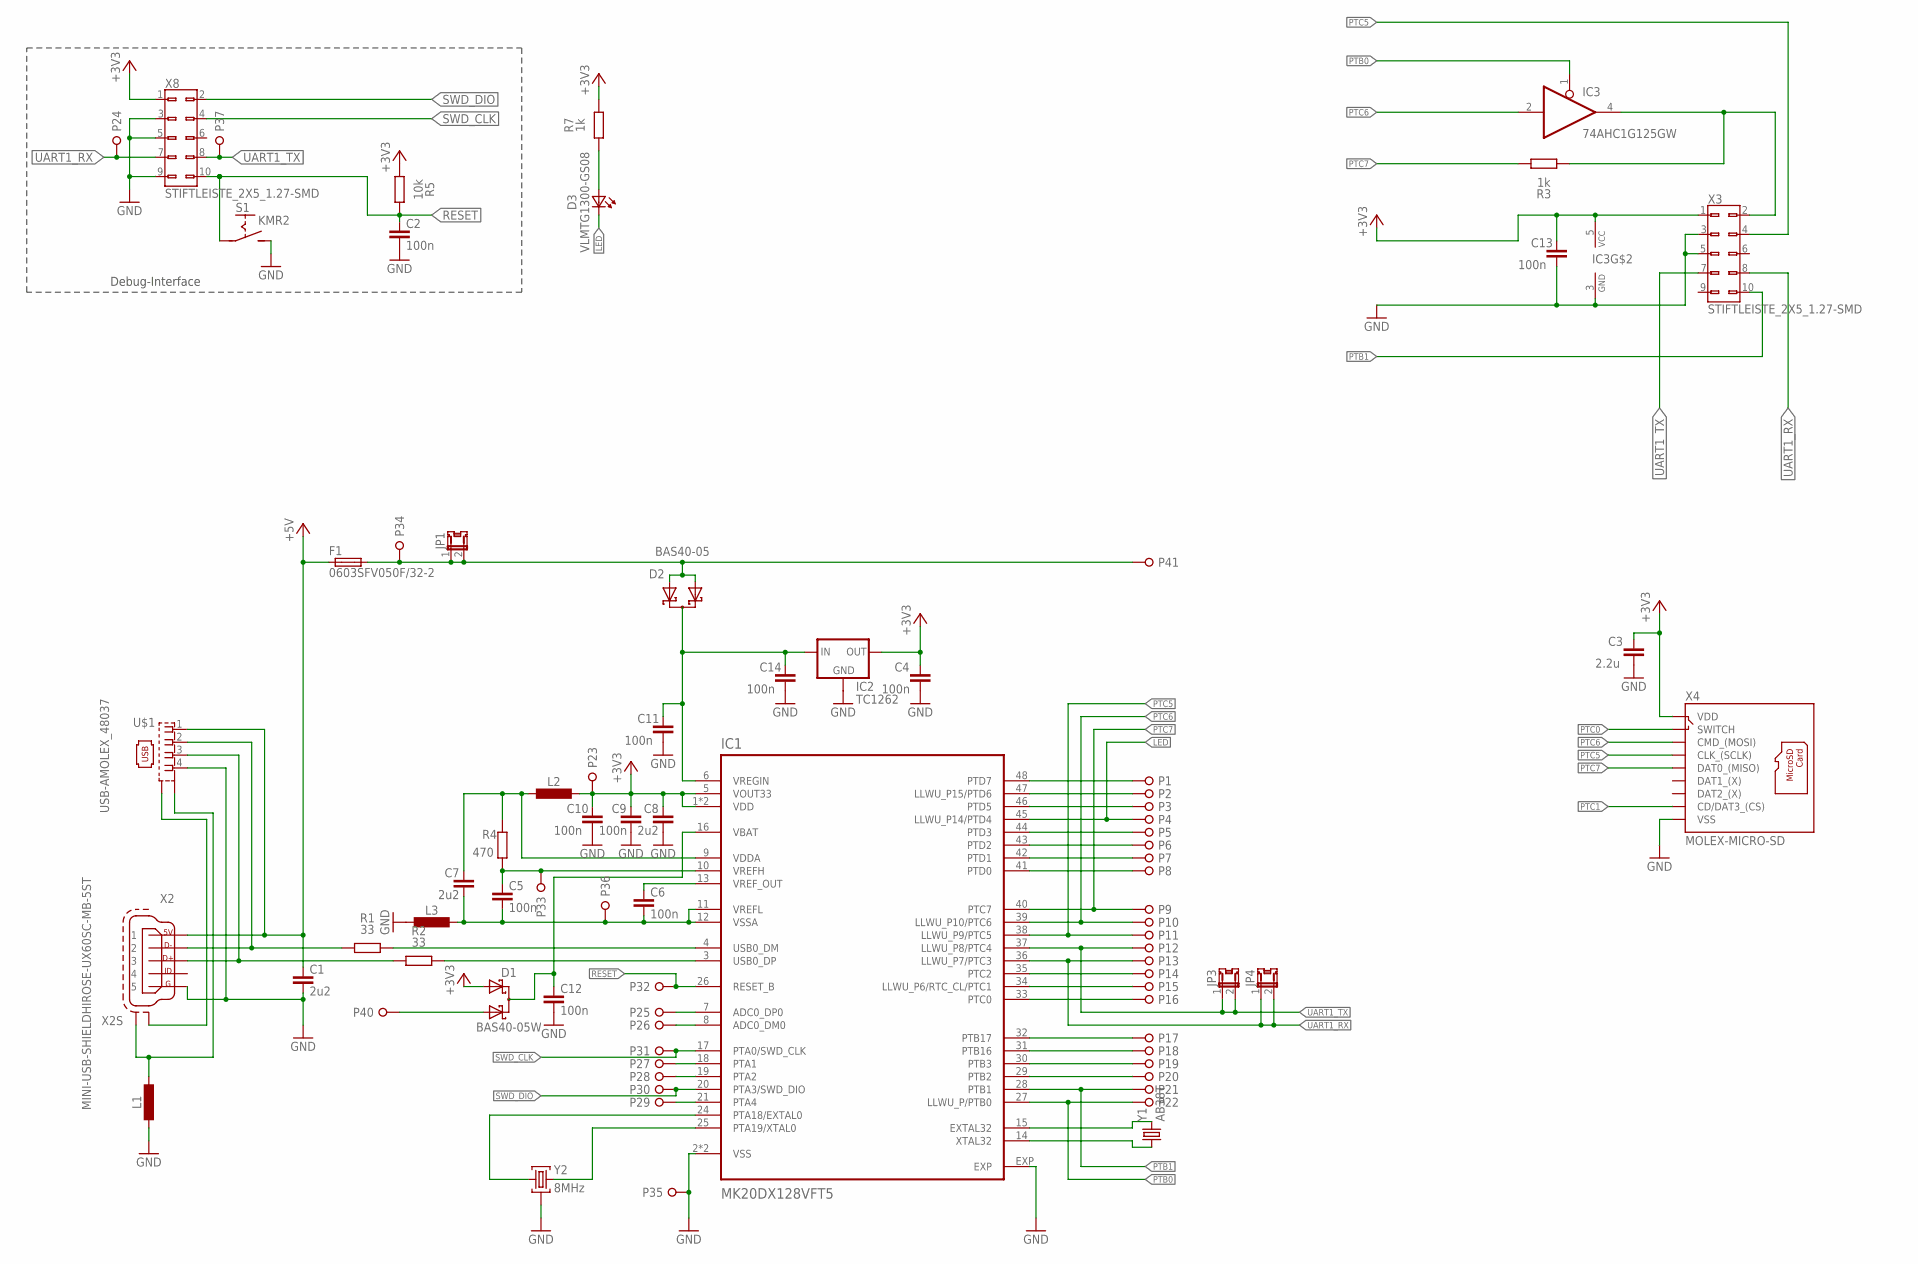
[picture p162: schematic tinyK20.sch]

Parts:
C1, C7, C8: 2u2; C0603-R
C2, C4, C5, C6, C9, C10, C11, C12, C13, C14: 100n; C0603-R
C3: 2.2u; C0603-R
D1: BAS40-05W; SOT-323
D2: BAS40-05; SOT-23
D3: VLMTG1300-GS08; D0603-R
F1: 0603SFV050F/32-2; 0603-R
IC1: MK20DX128VFT5; QFN48
IC2: TC1262; SOT-223
IC3: 74AHC1G125GW; SOT-353
JP1, JP3, JP4: JP1-SMD-1.2X1.8; JP-SMD-1.2X1.8
L1, L2, L3: L; L0603-R
P1, P2, P3, P4, P5, P6, P7, P8, P9, P10, P11, P12, P13, P14, P15, P16, P17, P18, P19, P20, P21, P22, P23, P24, P25, P26, P27, P28, P29, P30, P31, P32, P33, P34, P35, P36, P37, P40, P41: SOLDERPAD; SOLDERPAD_TH_0.9
R1, R2: 33; R0603-R
R3, R7: 1k; R0603-R
R4: 470; R0603-R
R5: 10k; R0603-R
S1: KMR2; SWITCH-KMR-SERIES
U$1: USB-AMOLEX_48037; USB-A-MOLEX_48037
X2: MINI-USB-SHIELDHIROSE-UX60SC-MB-5ST; USB-MINI-B-HORIZ_HIROSE-UX60SC-MB-5ST
X3, X8: STIFTLEISTE_2X5_1.27-SMD; STIFTLEISTE_2X5_1.27_SMD
X4: MOLEX-MICRO-SD; SD-105027-001
Y1: AB38T; CRYSTAL-AB38T
Y2: 8MHz; CSTCE

Connections:
+3V3: C3.1, C4.1, C8.1, C9.1, C10.1, C13.1, D1.1 (A), IC1.1 (VDD), IC1.5 (VOUT33), IC1.22 (VDD), IC2.3 (OUT), IC3.5 (VCC), L2.2, P23.1, R5.1, R7.2, X3.1, X4.P4 (VDD), X8.1
+5V: C1.1, F1.1, U$1.1, X2.1
GND: C1.2, C2.2, C3.2, C4.2, C8.2, C9.2, C10.2, C11.2, C12.2, C13.2, C14.2, IC1.2 (VSS), IC1.23 (VSS), IC1.EXP, IC2.2 (GND), IC2.4 (GND), IC3.3 (GND), L1.1, L3.1, P35.1, S1.3 (S), S1.4 (S), U$1.4, X2.5, X3.3, X3.5, X4.P6 (VSS), X8.3, X8.5, X8.9, Y2.2
LED: D3.2 (K), IC1.45 (LLWU_P14/PTD4), P4.1
unnamed: R1.1, U$1.2, X2.2
unnamed: D1.2 (A), P40.1
unnamed: C5.2, C6.2, C7.2, IC1.11 (VREFL), IC1.12 (VSSA), L3.2, P36.1
unnamed: R2.1, U$1.3, X2.3
unnamed: C6.1, IC1.13 (VREF_OUT)
unnamed: IC1.4 (USB0_DM), R1.2
unnamed: C5.1, IC1.10 (VREFH), P33.1, R4.1
unnamed: IC1.3 (USB0_DP), R2.2
unnamed: IC1.24 (PTA18/EXTAL0), Y2.1
unnamed: IC1.25 (PTA19/XTAL0), Y2.3
unnamed: C7.1, IC1.9 (VDDA), L2.1, R4.2
unnamed: IC1.48 (PTD7), P1.1
unnamed: IC1.47 (LLWU_P15/PTD6), P2.1
unnamed: IC1.46 (PTD5), P3.1
unnamed: U$1.S2A (S2), U$1.S2B (S2), X2.S1
unnamed: C11.1, C14.1, D2.3 (COMMON), IC1.6 (VREGIN), IC2.1 (IN)
unnamed: D3.1 (A), R7.1
unnamed: IC1.44 (PTD3), P5.1
unnamed: C12.1, D1.3 (COMMON), IC1.16 (VBAT)
unnamed: IC1.43 (PTD2), P6.1
unnamed: IC1.42 (PTD1), P7.1
unnamed: IC1.41 (PTD0), P8.1
unnamed: D2.1 (A), D2.2 (A), F1.2, JP1.1, JP1.2, P34.1, P41.1
unnamed: IC3.4 (O), R3.1, X3.2
unnamed: IC1.35 (PTC2), P14.1
unnamed: IC1.32 (PTB17), P17.1
unnamed: IC1.31 (PTB16), P18.1
unnamed: IC1.30 (PTB3), P19.1
unnamed: IC1.29 (PTB2), P20.1
unnamed: IC1.15 (EXTAL32), Y1.2 (3)
unnamed: IC1.14 (XTAL32), Y1.1
unnamed: IC1.21 (PTA4), P29.1
unnamed: IC1.19 (PTA2), P28.1
unnamed: IC1.18 (PTA1), P27.1
unnamed: IC1.8 (ADC0_DM0), P26.1
unnamed: IC1.7 (ADC0_DP0), P25.1
unnamed: L1.2, U$1.S1A (S1), U$1.S1B (S1), X2.S2
PTB0: IC1.27 (LLWU_P/PTB0), IC3.1 (OE), P22.1
PTB1: IC1.28 (PTB1), P21.1, X3.10
PTC0: IC1.33 (PTC0), P16.1, X4.G1 (SWITCH)
PTC1: IC1.34 (LLWU_P6/RTC_CL/PTC1), P15.1, X4.P2 (CD/DAT3_(CS))
PTC5: IC1.38 (LLWU_P9/PTC5), P11.1, X3.4, X4.P5 (CLK_(SCLK))
PTC6: IC1.39 (LLWU_P10/PTC6), IC3.2 (I), P10.1, X4.P3 (CMD_(MOSI))
PTC7: IC1.40 (PTC7), P9.1, R3.2, X4.P7 (DAT0_(MISO))
RESET: C2.1, IC1.26 (RESET_B), P32.1, R5.2, S1.1 (C), S1.2 (C), X8.10
SWD_CLK: IC1.17 (PTA0/SWD_CLK), P31.1, X8.4
SWD_DIO: IC1.20 (PTA3/SWD_DIO), P30.1, X8.2
UART1_RX: IC1.36 (LLWU_P7/PTC3), JP4.1, JP4.2, P13.1, P24.1, X3.8, X8.7
UART1_TX: IC1.37 (LLWU_P8/PTC4), JP3.1, JP3.2, P12.1, P37.1, X3.7, X8.8

Notes on the sheet:
Debug-Interface

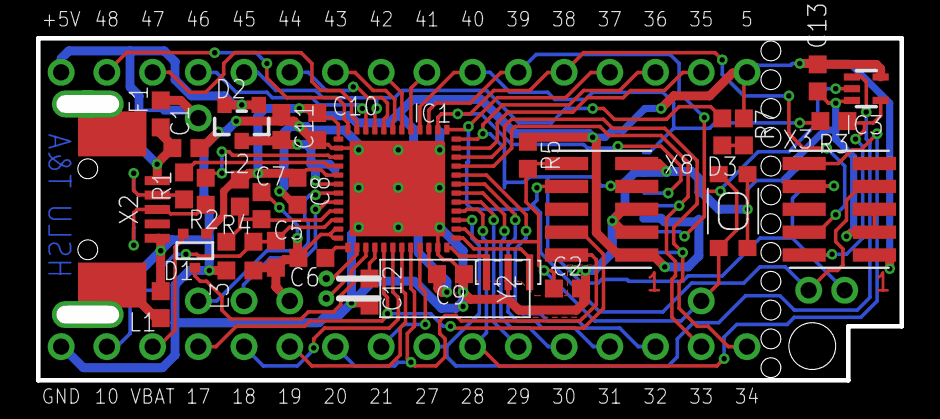
[picture p163: board tinyK20.brd from above]

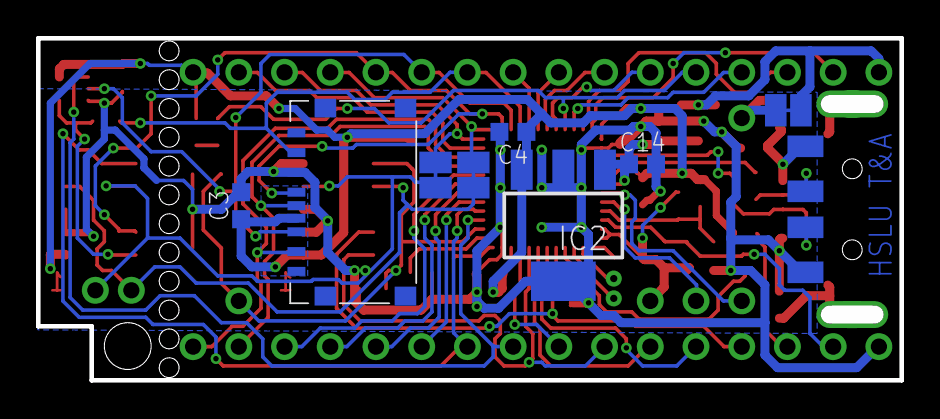
[picture p164: board tinyK20.brd from below]

Board: 2 copper layers, 48.0 x 19.0 mm, 80 parts (9 on the bottom side), 53 nets.
