ErichStyger/mcuoneclipse/Eagle/INTRO Robot Shield/INTRO Robot Shield.brd

## EAGLE design Eagle/INTRO Robot Shield/INTRO Robot Shield.brd (2014-10-24)

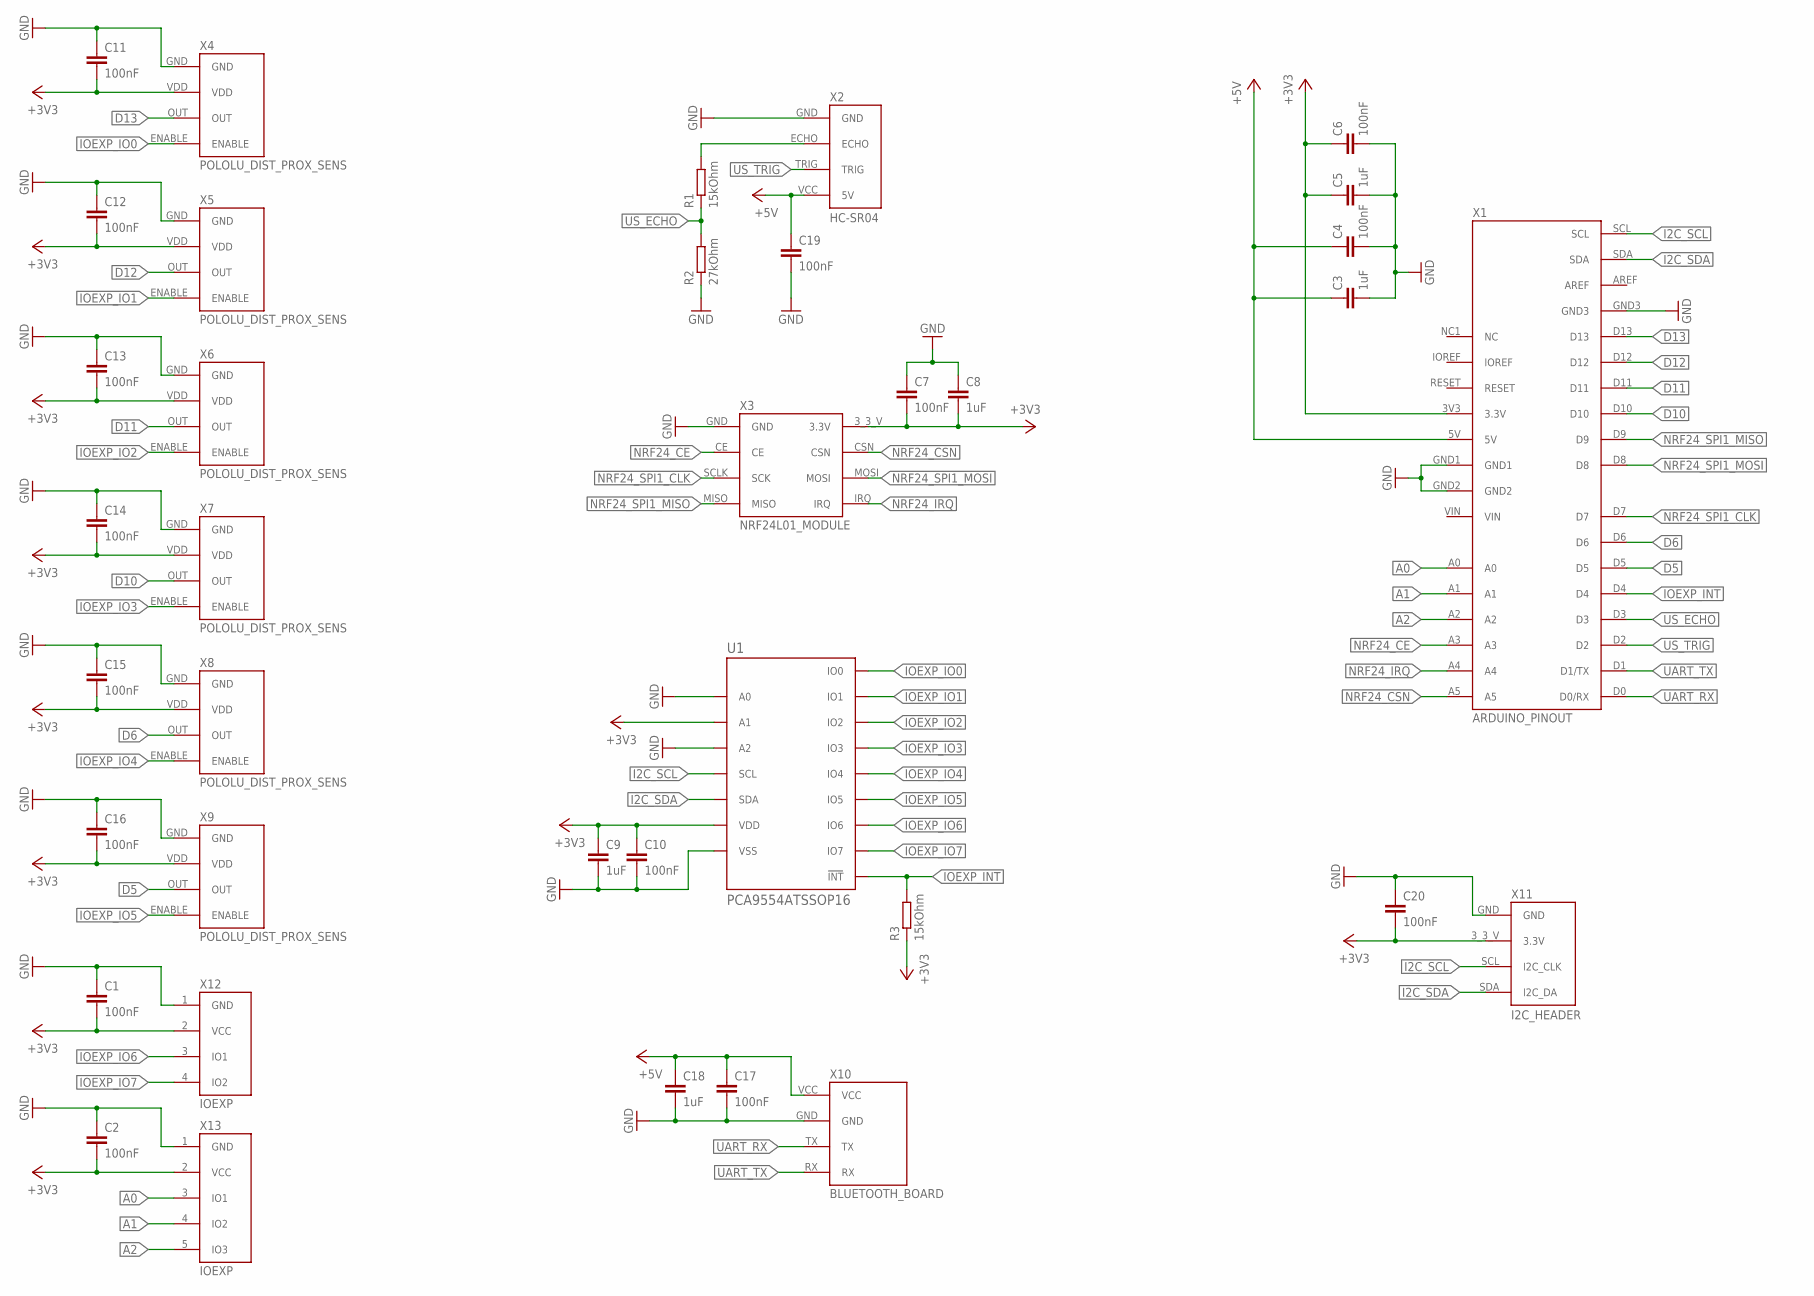
[picture p165: schematic INTRO Robot Shield.sch]

Parts:
C1, C2, C4, C6, C7, C10, C11, C12, C13, C14, C15, C16, C17, C19, C20: 100nF; 0805
C3, C5, C8, C9, C18: 1uF; 0805
R1, R3: 15kOhm; 0805
R2: 27kOhm; 0805
U1: PCA9554ATSSOP16; TSSOP16
X1: ARDUINO_PINOUT; ARDUINO_PINOUT_INNER_LABEL
X2: HC-SR04; HC-SR04_FOOTPRINT
X3: NRF24L01_MODULE; NRF24L01_MODULE_FOOTPRINT
X4, X5, X6, X7, X8, X9: POLOLU_DIST_PROX_SENS; POLOLU_DIST_PROX_SENS_FOOTPRINT
X10: BLUETOOTH_BOARD; BT_BOARD_FOOTPRINT
X11: I2C_HEADER; I2C_HEADER_FOOTPRINT
X12: IOEXP; CONNECTORS_STIFTLEISTE_1X4_2.54
X13: IOEXP; CONNECTORS_STIFTLEISTE_1X5_2.54

Connections:
+3V3: C1.2, C2.2, C5.1, C6.1, C7.2, C8.2, C9.1, C10.1, C11.2, C12.2, C13.2, C14.2, C15.2, C16.2, C20.2, R3.1, U1.2 (A1), U1.16 (VDD), X1.3V3 (3.3V), X3.3_3_V (3.3V), X4.VDD, X5.VDD, X6.VDD, X7.VDD, X8.VDD, X9.VDD, X11.3_3_V (3.3V), X12.2 (VCC), X13.2 (VCC)
+5V: C3.1, C4.1, C17.1, C18.1, C19.1, X1.5V, X2.VCC (5V), X10.VCC
A0: X1.A0, X13.3 (IO1)
A1: X1.A1, X13.4 (IO2)
A2: X1.A2, X13.5 (IO3)
D5: X1.D5, X9.OUT
D6: X1.D6, X8.OUT
D10: X1.D10, X7.OUT
D11: X1.D11, X6.OUT
D12: X1.D12, X5.OUT
D13: X1.D13, X4.OUT
GND: C1.1, C2.1, C3.2, C4.2, C5.2, C6.2, C7.1, C8.1, C9.2, C10.2, C11.1, C12.1, C13.1, C14.1, C15.1, C16.1, C17.2, C18.2, C19.2, C20.1, R2.1, U1.1 (A0), U1.3 (A2), U1.8 (VSS), X1.GND1, X1.GND2, X1.GND3, X2.GND, X3.GND, X4.GND, X5.GND, X6.GND, X7.GND, X8.GND, X9.GND, X10.GND, X11.GND, X12.1 (GND), X13.1 (GND)
I2C_SCL: U1.14 (SCL), X1.SCL, X11.SCL (I2C_CLK)
I2C_SDA: U1.15 (SDA), X1.SDA, X11.SDA (I2C_DA)
IOEXP_INT: R3.2, U1.13 (!INT), X1.D4
IOEXP_IO0: U1.4 (IO0), X4.ENABLE
IOEXP_IO1: U1.5 (IO1), X5.ENABLE
IOEXP_IO2: U1.6 (IO2), X6.ENABLE
IOEXP_IO3: U1.7 (IO3), X7.ENABLE
IOEXP_IO4: U1.9 (IO4), X8.ENABLE
IOEXP_IO5: U1.10 (IO5), X9.ENABLE
IOEXP_IO6: U1.11 (IO6), X12.3 (IO1)
IOEXP_IO7: U1.12 (IO7), X12.4 (IO2)
unnamed: R1.2, X2.ECHO
NRF24_CE: X1.A3, X3.CE
NRF24_CSN: X1.A5, X3.CSN
NRF24_IRQ: X1.A4, X3.IRQ
NRF24_SPI1_CLK: X1.D7, X3.SCLK (SCK)
NRF24_SPI1_MISO: X1.D9, X3.MISO
NRF24_SPI1_MOSI: X1.D8, X3.MOSI
UART_RX: X1.D0 (D0/RX), X10.TX
UART_TX: X1.D1 (D1/TX), X10.RX
US_ECHO: R1.1, R2.2, X1.D3
US_TRIG: X1.D2, X2.TRIG

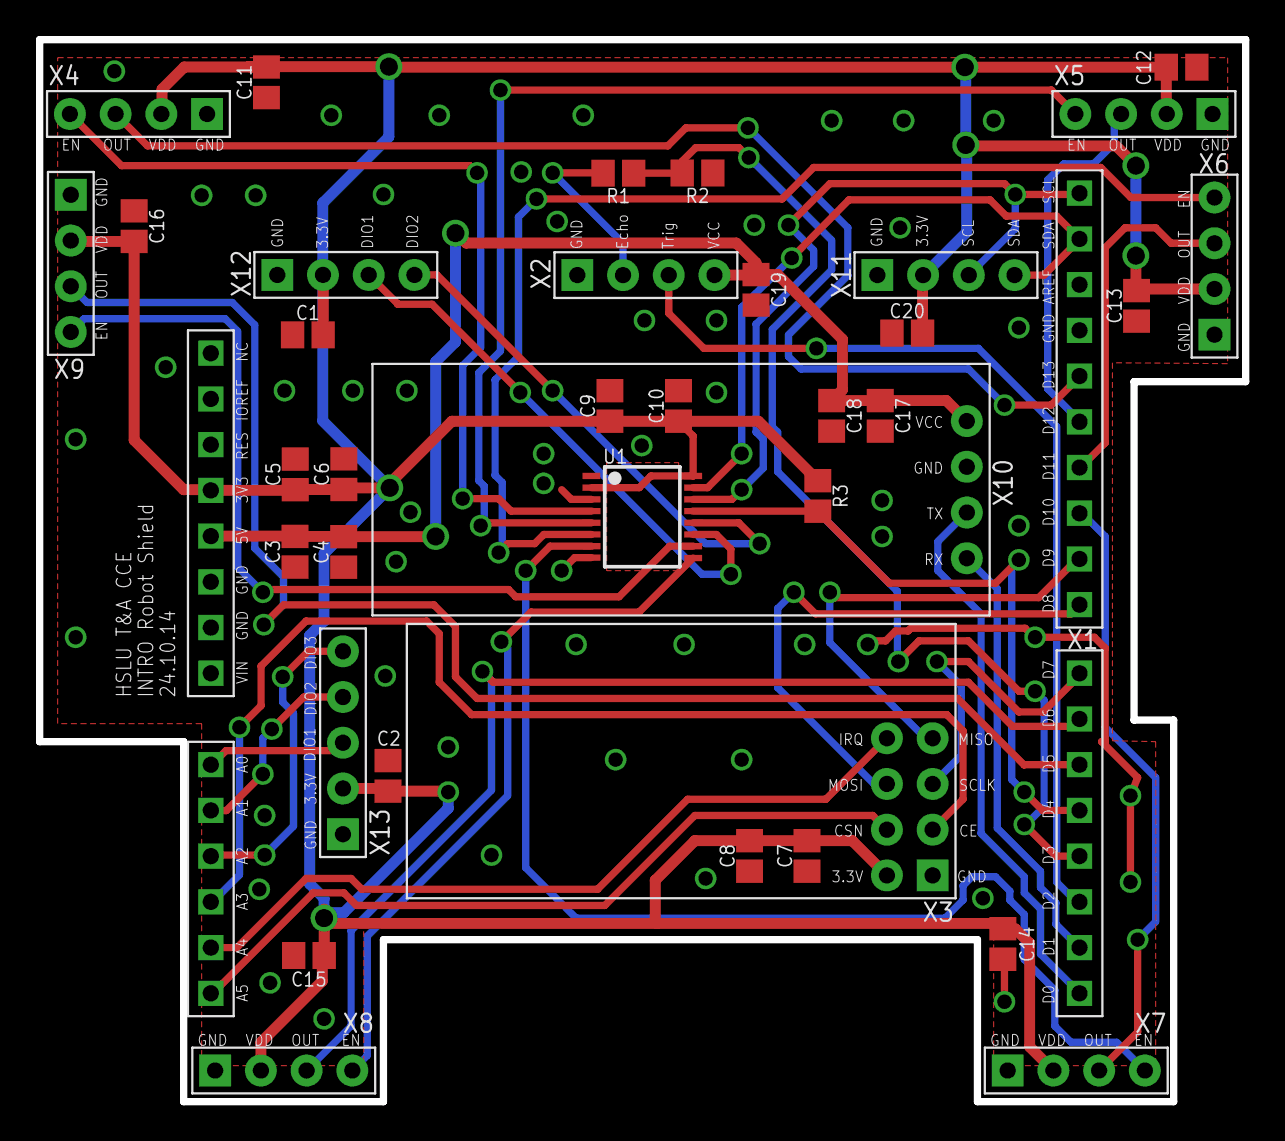
[picture p166: board INTRO Robot Shield.brd from above]

Board: 2 copper layers, 67.0 x 59.0 mm, 37 parts (0 on the bottom side), 34 nets.
