ErichStyger/mcuoneclipse/Eagle/INTRO Robot QuadEncoder/QuadEncoder.brd

## EAGLE design Eagle/INTRO Robot QuadEncoder/QuadEncoder.brd (2014-08-07)

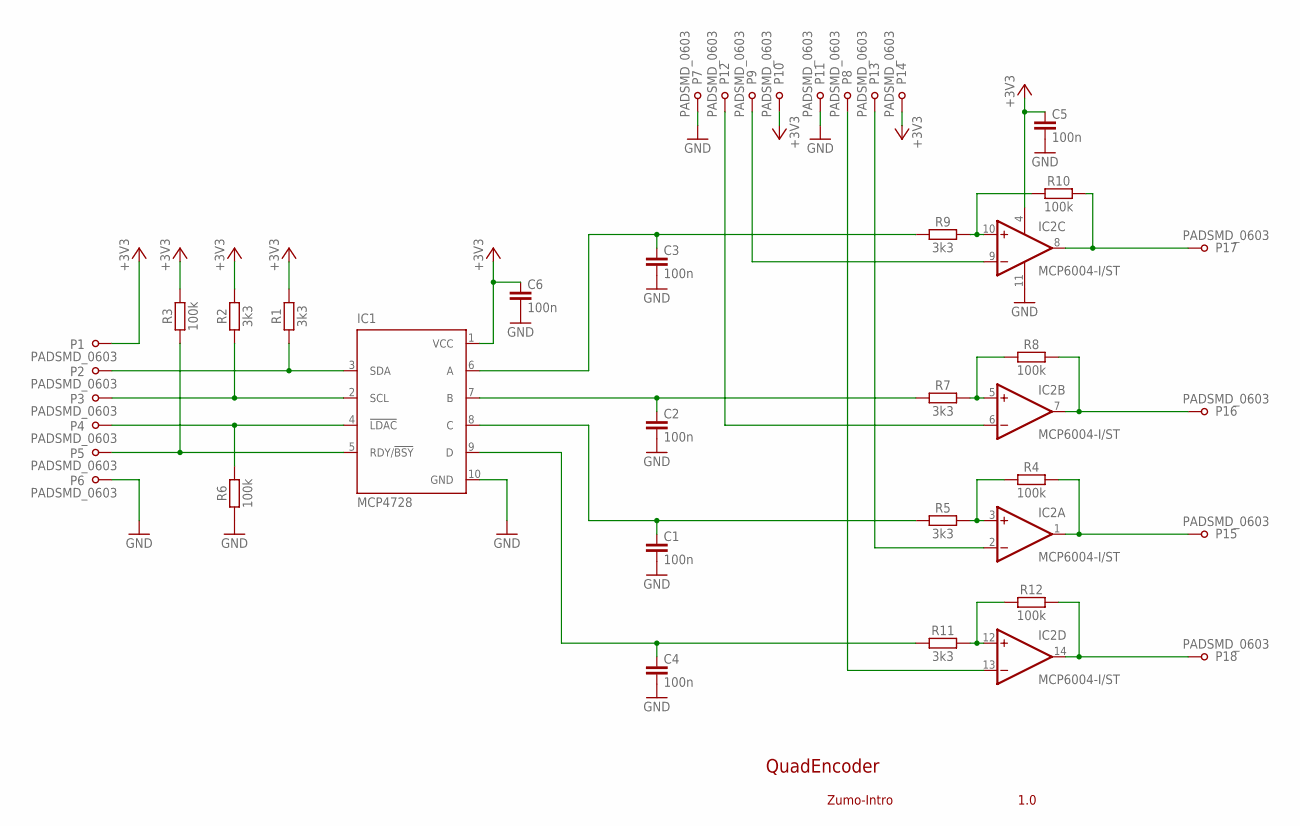
[picture p167: schematic QuadEncoder.sch]

Parts:
C1, C2, C3, C4, C5, C6: 100n; C0805-R
IC1: MCP4728; MSOP10
IC2: MCP6004-I/ST; TSSOP14
P1, P2, P3, P4, P5, P6, P7, P8, P9, P10, P11, P12, P13, P14, P15, P16, P17, P18: PADSMD_0603; PAD_SMD_0603
R1, R2, R5, R7, R9, R11: 3k3; R0805-R
R3, R4, R6, R8, R10, R12: 100k; R0805-R

Connections:
+3V3: C5.1, C6.1, IC1.1 (VCC), IC2.4 (V+), P1.1, P10.1, P14.1, R1.2, R2.2, R3.2
GND: C1.2, C2.2, C3.2, C4.2, C5.2, C6.2, IC1.10 (GND), IC2.11 (V-), P6.1, P7.1, P11.1, R6.1
unnamed: IC1.3 (SDA), P2.1, R1.1
unnamed: IC1.2 (SCL), P3.1, R2.1
unnamed: IC1.4 (!LDAC), P4.1, R6.2
unnamed: IC1.5 (RDY/!BSY), P5.1, R3.1
unnamed: C1.1, IC1.8 (C), R5.1
unnamed: IC2.2 (IN-), P13.1
unnamed: IC2.1 (OUT), P15.1, R4.2
unnamed: IC2.3 (IN+), R4.1, R5.2
unnamed: IC2.12 (IN+), R11.2, R12.1
unnamed: IC2.5 (IN+), R7.2, R8.1
unnamed: IC2.7 (OUT), P16.1, R8.2
unnamed: IC2.6 (IN-), P12.1
unnamed: C2.1, IC1.7 (B), R7.1
unnamed: IC2.10 (IN+), R9.2, R10.1
unnamed: IC2.8 (OUT), P17.1, R10.2
unnamed: IC2.9 (IN-), P9.1
unnamed: C3.1, IC1.6 (A), R9.1
unnamed: IC2.14 (OUT), P18.1, R12.2
unnamed: IC2.13 (IN-), P8.1
unnamed: C4.1, IC1.9 (D), R11.1

Notes on the sheet:
QuadEncoder
Zumo-Intro
1.0

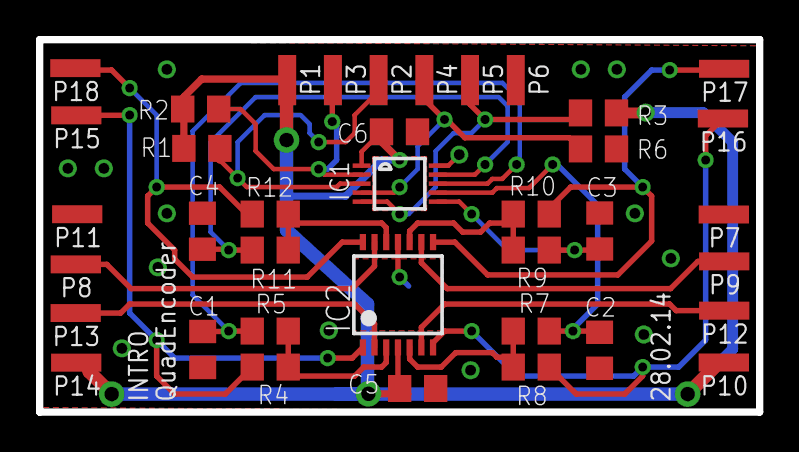
[picture p168: board QuadEncoder.brd from above]

Board: 2 copper layers, 40.0 x 20.7 mm, 38 parts (0 on the bottom side), 22 nets.
