ErichStyger/mcuoneclipse/Eagle/FRDM-Robot/FRDM-Shield-Rev2.0.brd

## EAGLE design Eagle/FRDM-Robot/FRDM-Shield-Rev2.0.brd (2013-05-30)

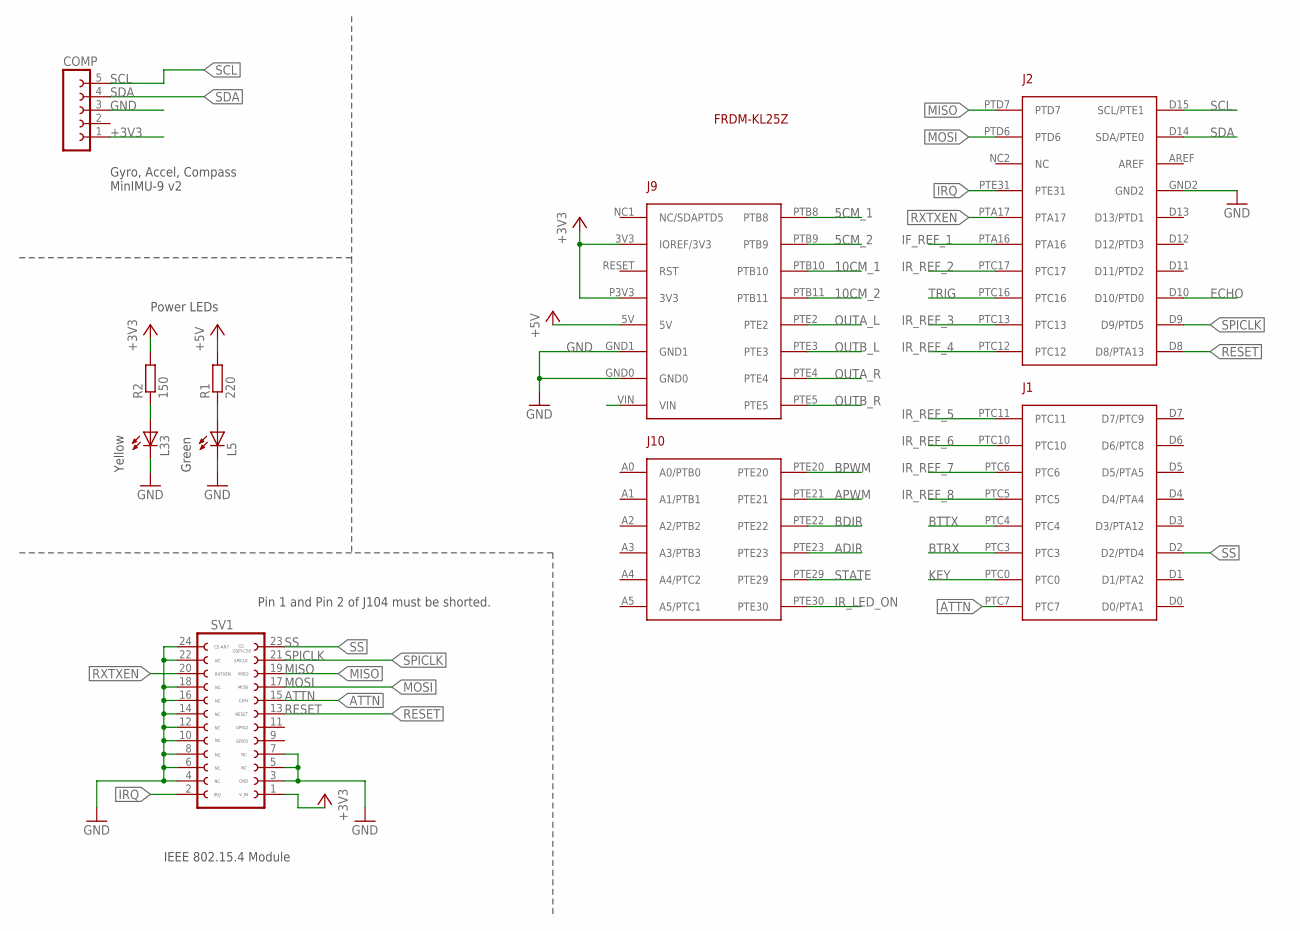
[picture p171: schematic FRDM-Shield-Rev2.0.sch]

Parts:
COMP: FE05-1
FRDM1: FRDM-KL25ZARDUINO; FRDM-KL25Z
L5, L33: LEDCHIP-LED0603; CHIP-LED0603
R1: 220; M0805
R2: 150; M0805
SV1: MC1320X; FE12-2

Connections:
5CM_1: FRDM1.PTB8
5CM_2: FRDM1.PTB9
10CM_1: FRDM1.PTB10
10CM_2: FRDM1.PTB11
+3V3: COMP.1, FRDM1.3V3 (IOREF/3V3), FRDM1.P3V3 (3V3), R2.2, SV1.1
+5V: FRDM1.5V, R1.2
ADIR: FRDM1.PTE23
APWM: FRDM1.PTE21
ATTN: FRDM1.PTC7, SV1.15
BDIR: FRDM1.PTE22
BPWM: FRDM1.PTE20
BTRX: FRDM1.PTC3
BTTX: FRDM1.PTC4
ECHO: FRDM1.D10 (D10/PTD0)
GND: COMP.3, FRDM1.GND0, FRDM1.GND1, FRDM1.GND2, L5.C, L33.C, SV1.3, SV1.4, SV1.5, SV1.6, SV1.7, SV1.8, SV1.10, SV1.12, SV1.14, SV1.16, SV1.18, SV1.22, SV1.24
IF_REF_1: FRDM1.PTA16
IRQ: FRDM1.PTE31, SV1.2
IR_LED_ON: FRDM1.PTE30
IR_REF_2: FRDM1.PTC17
IR_REF_3: FRDM1.PTC13
IR_REF_4: FRDM1.PTC12
IR_REF_5: FRDM1.PTC11
IR_REF_6: FRDM1.PTC10
IR_REF_7: FRDM1.PTC6
IR_REF_8: FRDM1.PTC5
KEY: FRDM1.PTC0
MISO: FRDM1.PTD7, SV1.19
MOSI: FRDM1.PTD6, SV1.17
unnamed: L5.A, R1.1
unnamed: L33.A, R2.1
OUTA_L: FRDM1.PTE2
OUTA_R: FRDM1.PTE4
OUTB_L: FRDM1.PTE3
OUTB_R: FRDM1.PTE5
RESET: FRDM1.D8 (D8/PTA13), SV1.13
RXTXEN: FRDM1.PTA17, SV1.20
SCL: COMP.5, FRDM1.D15 (SCL/PTE1)
SDA: COMP.4, FRDM1.D14 (SDA/PTE0)
SPICLK: FRDM1.D9 (D9/PTD5), SV1.21
SS: FRDM1.D2 (D2/PTD4), SV1.23
STATE: FRDM1.PTE29
TRIG: FRDM1.PTC16

Notes on the sheet:
IEEE 802.15.4 Module
Power LEDs
Pin 1 and Pin 2 of J104 must be shorted.
Yellow
Green
Gyro, Accel, Compass MinIMU-9 v2

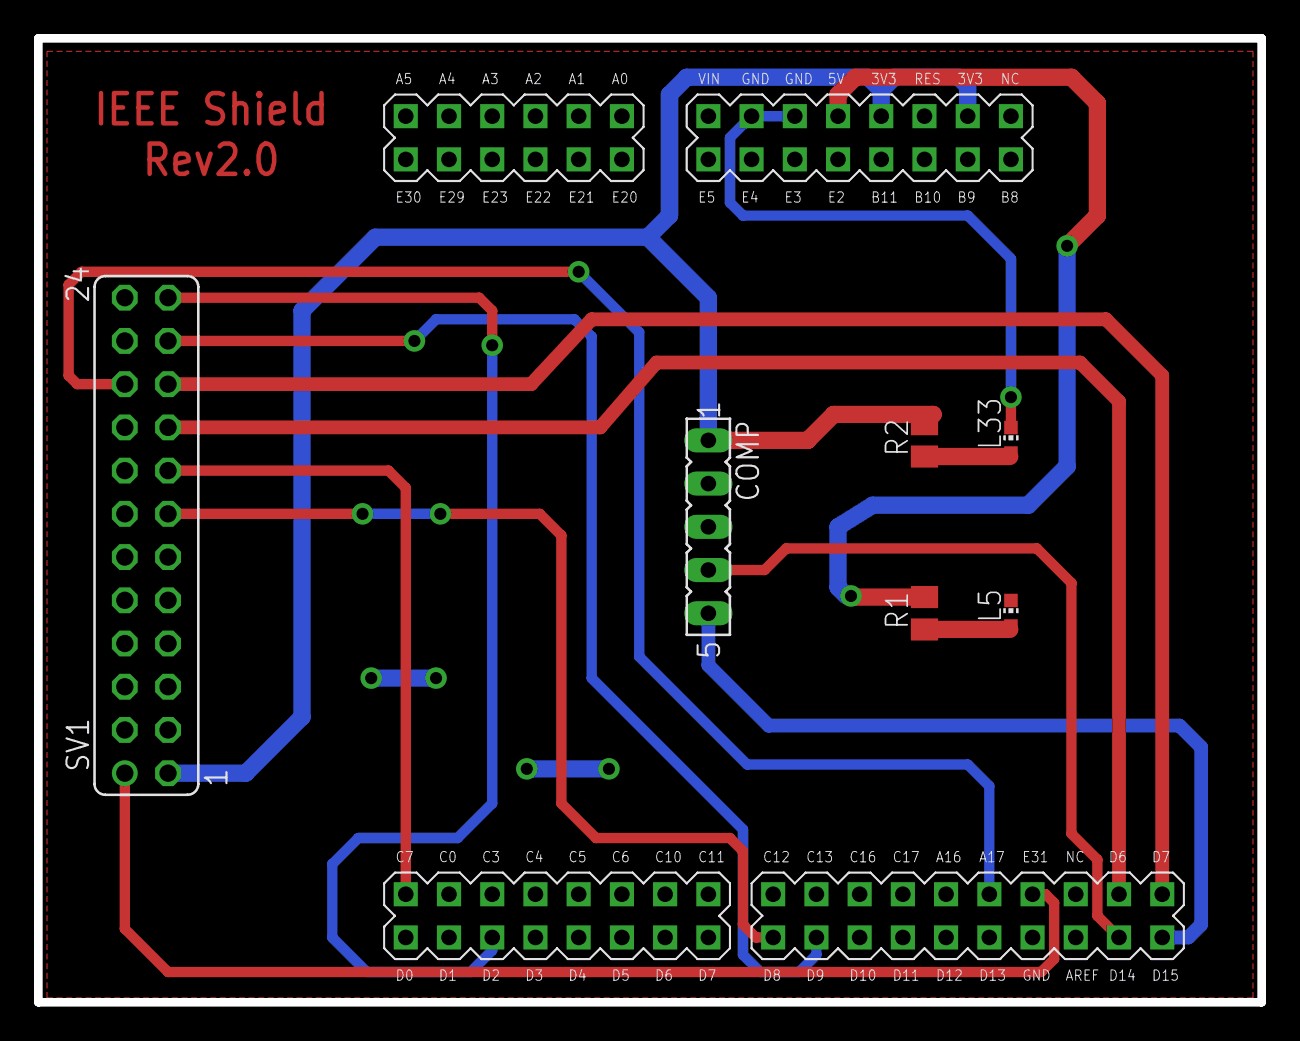
[picture p172: board FRDM-Shield-Rev2.0.brd from above]

Board: 2 copper layers, 72.1 x 56.6 mm, 7 parts (0 on the bottom side), 15 nets.
