ErichStyger/mcuoneclipse/Eagle/FRDM-Robot/FRDM-Robot-Rev2.1.brd

## EAGLE design Eagle/FRDM-Robot/FRDM-Robot-Rev2.1.brd (2013-05-30)

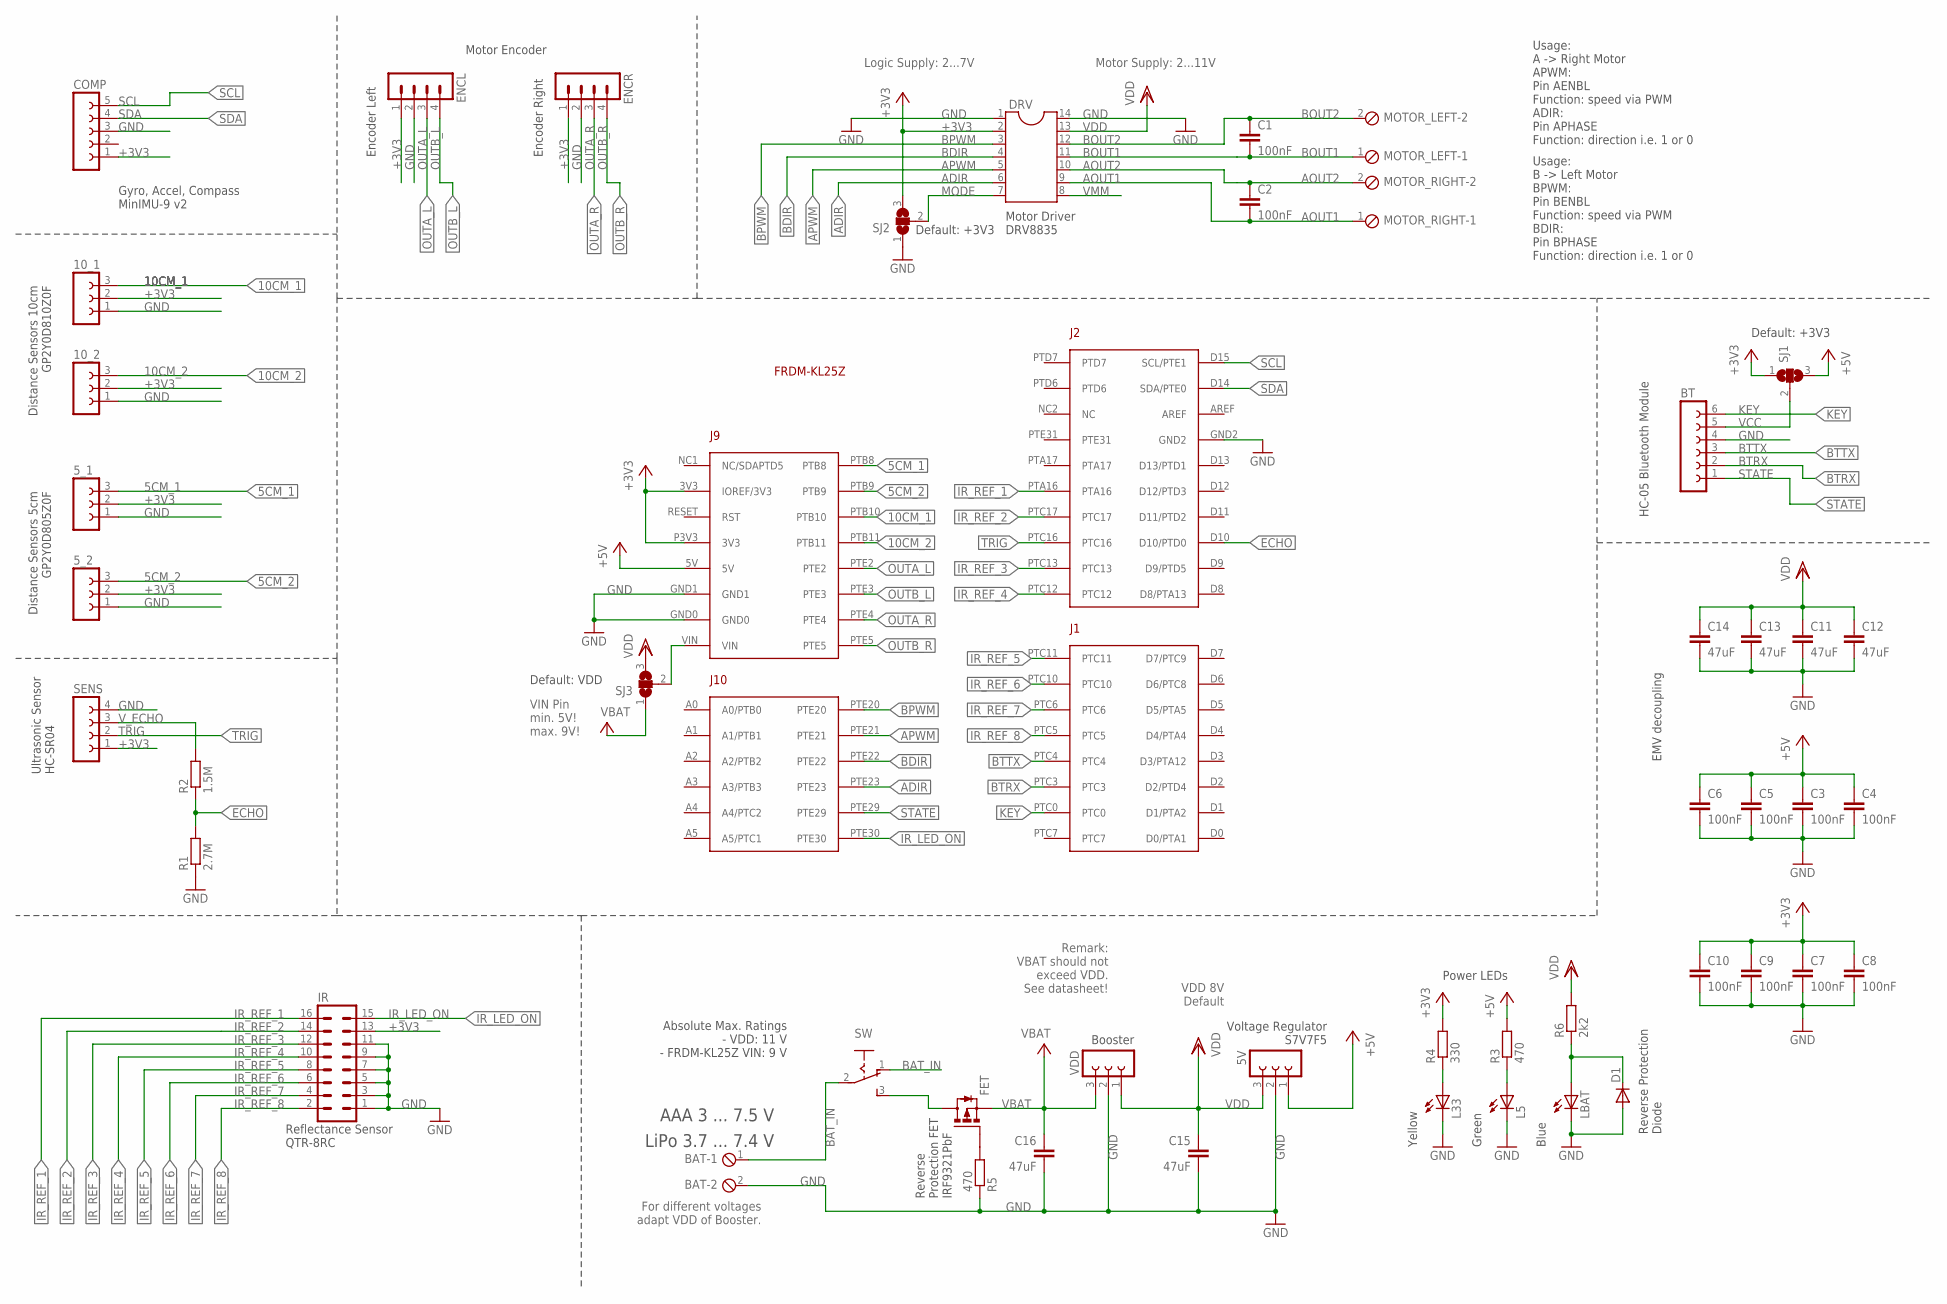
[picture p173: schematic FRDM-Robot-Rev2.1.sch, Freedom Robot Board]

Parts:
5V, 5_1, 5_2, 10_1, 10_2: FE03-1
BAT: MPT2; 2POL254
BT: FE06-1; FE06
C1, C2, C3, C4, C5, C6, C7, C8, C9, C10: 100nF; C0805
C11, C12, C13, C14, C15, C16: 47uF; C0805
COMP: FE05-1
D1: DIODE-SOD123; SOD123
DRV: DIL14
ENCL: MA04-1
ENCR: MA04-1
FET: P-MOSFET-SO8; SO-08
FRDM1: FRDM-KL25ZARDUINO; FRDM-KL25Z
IR: MA08-2
L5, L33: LEDCHIP-LED0603; CHIP-LED0603
LBAT: LEDCHIP-LED0603; CHIP-LED0603
MOTOR_LEFT: MPT2; 2POL254
MOTOR_RIGHT: MPT2; 2POL254
R1: 2.7M; M0805
R2: 1.5M; M0805
R3, R5: 470; M0805
R4: 330; M0805
R6: 2k2; M0805
SENS: FE04-1
SJ1, SJ2, SJ3: SJ2W; SJ_2
SW: KNITTER-MFP106D
VDD: FE03-1

Connections:
5CM_1: 5_1.3, FRDM1.PTB8
5CM_2: 5_2.3, FRDM1.PTB9
10CM_1: 10_1.3, FRDM1.PTB10
10CM_2: 10_2.3, FRDM1.PTB11
+3V3: 5_1.2, 5_2.2, 10_1.2, 10_2.2, C7.1, C8.1, C9.1, C10.1, COMP.1, DRV.2, ENCL.1, ENCR.1, FRDM1.3V3 (IOREF/3V3), FRDM1.P3V3 (3V3), IR.13, R4.2, SENS.1, SJ1.1, SJ2.3
+5V: 5V.1, C3.1, C4.1, C5.1, C6.1, FRDM1.5V, R3.2, SJ1.3
ADIR: DRV.6, FRDM1.PTE23
AOUT1: C2.2, DRV.9, MOTOR_RIGHT.1
AOUT2: C2.1, DRV.10, MOTOR_RIGHT.2
APWM: DRV.5, FRDM1.PTE21
BAT-FET: FET.5 (D), FET.6 (D), FET.7 (D), FET.8 (D), SW.3 (S)
BAT_IN: BAT.1, SW.1 (O), SW.2
BDIR: DRV.4, FRDM1.PTE22
BOUT1: C1.2, DRV.11, MOTOR_LEFT.1
BOUT2: C1.1, DRV.12, MOTOR_LEFT.2
BPWM: DRV.3, FRDM1.PTE20
BTRX: BT.2, FRDM1.PTC3
BTTX: BT.3, FRDM1.PTC4
ECHO: FRDM1.D10 (D10/PTD0), R1.2, R2.1
GND: 5V.2, 5_1.1, 5_2.1, 10_1.1, 10_2.1, BAT.2, BT.4, C3.2, C4.2, C5.2, C6.2, C7.2, C8.2, C9.2, C10.2, C11.2, C12.2, C13.2, C14.2, C15.2, C16.2, COMP.3, D1.A, DRV.1, DRV.14, ENCL.2, ENCR.2, FRDM1.GND0, FRDM1.GND1, FRDM1.GND2, IR.1, IR.3, IR.5, IR.7, IR.9, IR.11, L5.C, L33.C, LBAT.C, R1.1, R5.1, SENS.4, SJ2.1, VDD.2
IR_LED_ON: FRDM1.PTE30, IR.15
IR_REF_1: FRDM1.PTA16, IR.16
IR_REF_2: FRDM1.PTC17, IR.14
IR_REF_3: FRDM1.PTC13, IR.12
IR_REF_4: FRDM1.PTC12, IR.10
IR_REF_5: FRDM1.PTC11, IR.8
IR_REF_6: FRDM1.PTC10, IR.6
IR_REF_7: FRDM1.PTC6, IR.4
IR_REF_8: FRDM1.PTC5, IR.2
KEY: BT.6, FRDM1.PTC0
MODE: DRV.7, SJ2.2
unnamed: L5.A, R3.1
unnamed: L33.A, R4.1
unnamed: FET.4 (G), R5.2
unnamed: D1.C, LBAT.A, R6.1
OUTA_L: ENCL.3, FRDM1.PTE2
OUTA_R: ENCR.3, FRDM1.PTE4
OUTB_L: ENCL.4, FRDM1.PTE3
OUTB_R: ENCR.4, FRDM1.PTE5
SCL: COMP.5, FRDM1.D15 (SCL/PTE1)
SDA: COMP.4, FRDM1.D14 (SDA/PTE0)
STATE: BT.1, FRDM1.PTE29
TRIG: FRDM1.PTC16, SENS.2
VBAT: C16.1, FET.1 (S), FET.2 (S), FET.3 (S), SJ3.1, VDD.3
VCC: BT.5, SJ1.2
VDD: 5V.3, C11.1, C12.1, C13.1, C14.1, C15.1, DRV.13, R6.2, SJ3.3, VDD.1
VIN: FRDM1.VIN, SJ3.2
VMM: DRV.8
V_ECHO: R2.2, SENS.3

Notes on the sheet:
Distance Sensors 10cm GP2Y0D810Z0F
Ultrasonic Sensor HC-SR04
Motor Encoder
Motor Driver DRV8835
Reflectance Sensor QTR-8RC
Voltage Regulator S7V7F5
HC-05 Bluetooth Module
Reverse Protection FET IRF9321PbF
LiPo 3.7 ... 7.4 V
Usage: A -> Right Motor APWM: Pin AENBL Function: speed via PWM ADIR: Pin APHASE Function: direction i.e. 1 or 0
Distance Sensors 5cm GP2Y0D805Z0F
EMV decoupling
Power LEDs
Motor Supply: 2...11V
Logic Supply: 2...7V
Remark: VBAT should not exceed VDD. See datasheet!
For different voltages adapt VDD of Booster.
Usage: B -> Left Motor BPWM: Pin BENBL Function: speed via PWM BDIR: Pin BPHASE Function: direction i.e. 1 or 0
Reverse Protection Diode
VIN Pin min. 5V! max. 9V!
VDD 8V Default
Gyro, Accel, Compass MinIMU-9 v2
AAA 3 ... 7.5 V
Absolute Max. Ratings - VDD: 11 V - FRDM-KL25Z VIN: 9 V
Encoder Left
Encoder Right
Booster
Yellow
Green
Blue
Default: +3V3
Default: VDD

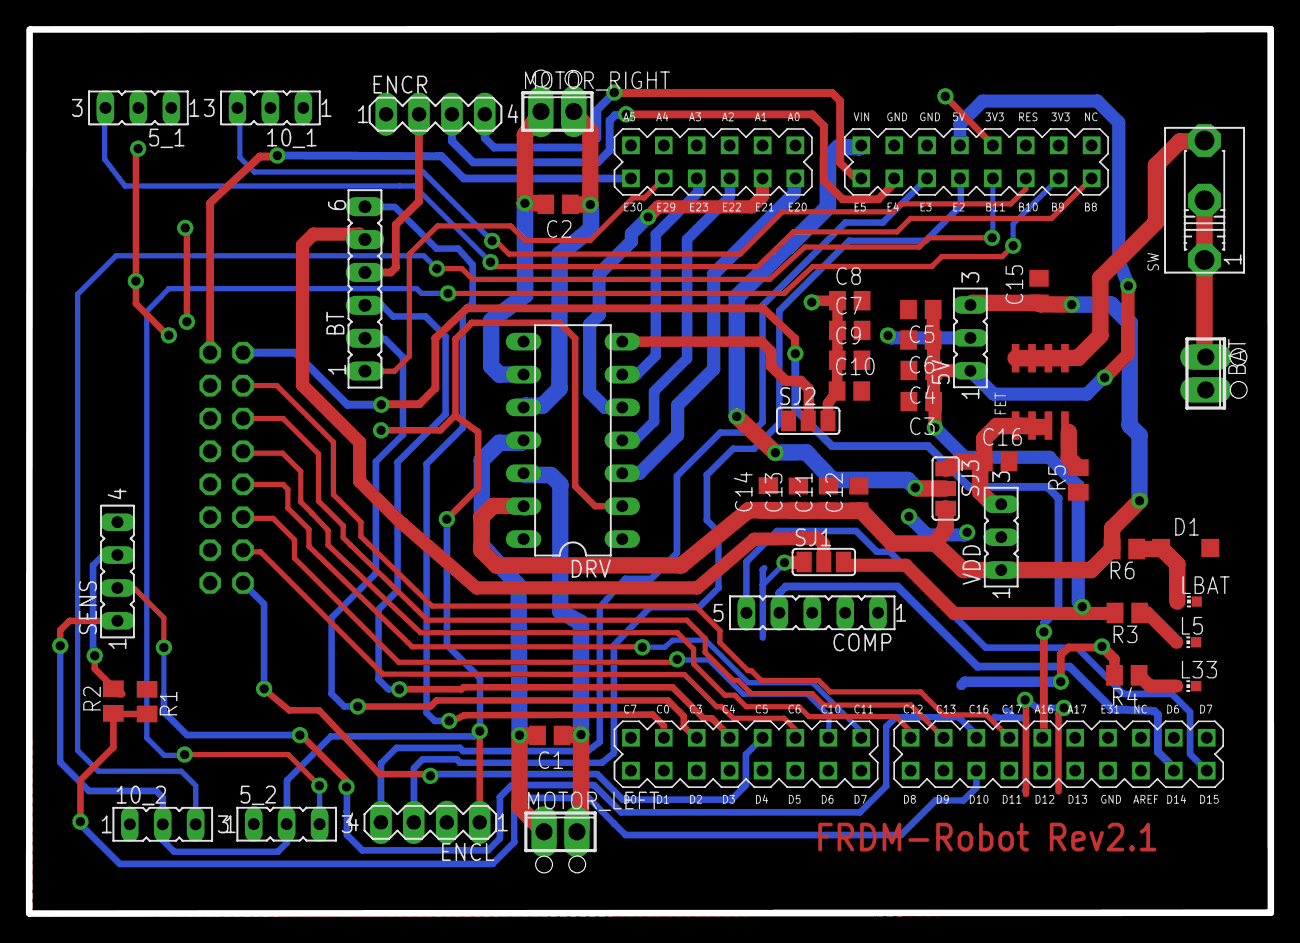
[picture p174: board FRDM-Robot-Rev2.1.brd from above]

Board: 2 copper layers, 95.8 x 68.3 mm, 48 parts (1 on the bottom side), 48 nets.
