ErichStyger/mcuoneclipse/Eagle/BT_HC05/BT_HC05_v1.brd

## EAGLE design Eagle/BT_HC05/BT_HC05_v1.brd (2013-03-07)

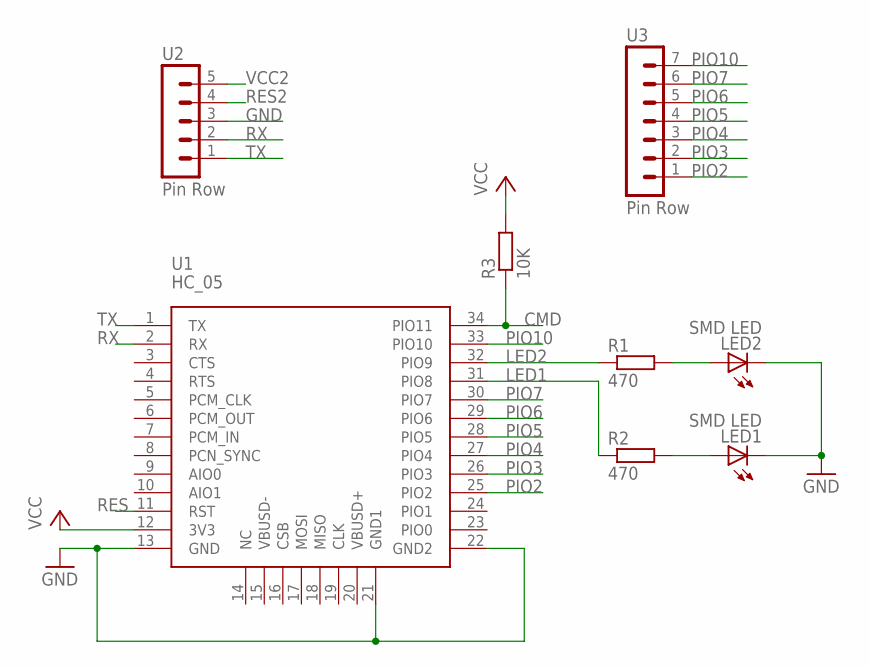
[picture p175: schematic BT_HC05_v1.sch]

Parts:
LED1, LED2: SMD LED; CHIP-LED0805
R1, R2: 470; R0805
R3: 10K; R0805
U1: HC_05; BLUETOOTH_SMD
U2: Pin Row; MAR05-1
U3: Pin Row; MA07-1

Connections:
CMD: R3.1, U1.34 (PIO11)
GND: LED1.C, LED2.C, U1.13 (GND), U1.21 (GND1), U1.22 (GND2), U2.3
LED1: R2.1, U1.31 (PIO8)
LED2: R1.1, U1.32 (PIO9)
unnamed: LED1.A, R2.2
unnamed: LED2.A, R1.2
PIO2: U1.25 (PIO2), U3.1
PIO3: U1.26 (PIO3), U3.2
PIO4: U1.27 (PIO4), U3.3
PIO5: U1.28 (PIO5), U3.4
PIO6: U1.29 (PIO6), U3.5
PIO7: U1.30 (PIO7), U3.6
PIO10: U1.33 (PIO10), U3.7
RES: U1.11 (RST)
RES2: U2.4
RX: U1.2 (RX), U2.2
TX: U1.1 (TX), U2.1
VCC: R3.2, U1.12 (3V3)
VCC2: U2.5

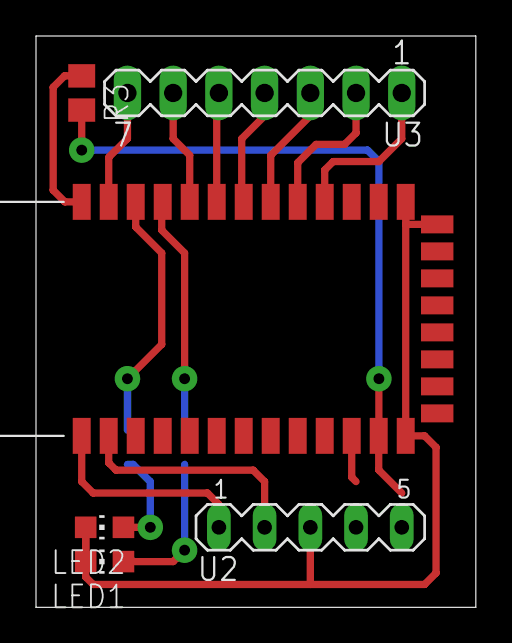
[picture p176: board BT_HC05_v1.brd from above]

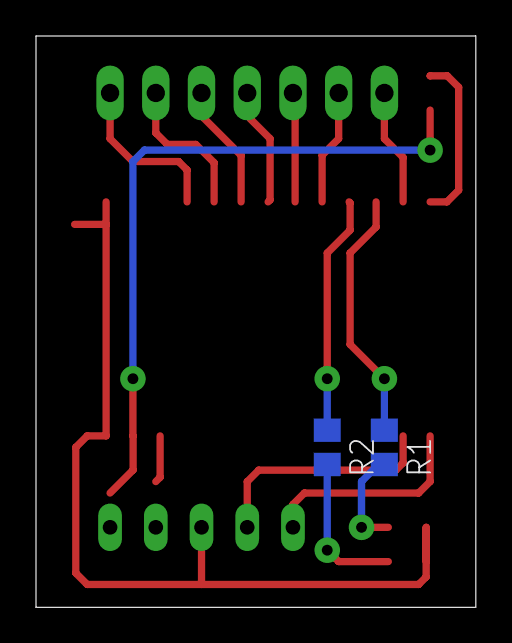
[picture p177: board BT_HC05_v1.brd from below]

Board: 2 copper layers, 24.4 x 31.7 mm, 8 parts (2 on the bottom side), 16 nets.
