ErichStyger/mcuoneclipse/MCU-Link/PowerExt_lpc55s69/src/shell.c

/*
 * Copyright (c) 2019-2025, Erich Styger
 *
 * SPDX-License-Identifier: BSD-3-Clause
 */

#include "platform.h"
#if PL_CONFIG_USE_SHELL
#include "shell.h"
#include "McuShell.h"
#include "McuRTOS.h"
#include "McuRTT.h"
#include "McuArmTools.h"
#include "McuLog.h"
#include "McuShellUart.h"
#include "McuTimeDate.h"
#include "McuFlash.h"
#include "McuMCP3561.h"
#include "calibration.h"
#include "measure.h"

typedef struct {
  McuShell_ConstStdIOType *stdio;
  unsigned char *buf;
  size_t bufSize;
} SHELL_IODesc;

static const SHELL_IODesc ios[] =
{
  {&McuShellUart_stdio,  McuShellUart_DefaultShellBuffer,  sizeof(McuShellUart_DefaultShellBuffer)},
#if PL_CONFIG_USE_RTT
  {&McuRTT_stdio,  McuRTT_DefaultShellBuffer,  sizeof(McuRTT_DefaultShellBuffer)},
#endif
};

static const McuShell_ParseCommandCallback CmdParserTable[] =
{
  McuShell_ParseCommand, /* McuShell component, is first in list */
  McuRTOS_ParseCommand, /* FreeRTOS shell parser */
  McuArmTools_ParseCommand,
  McuLog_ParseCommand,
#if McuFlash_CONFIG_IS_ENABLED
  McuFlash_ParseCommand,
#endif
  McuMCP3561_ParseCommand,
  Calibration_ParseCommand,
  Measure_ParseCommand,
  NULL /* Sentinel */
};

static void ShellTask(void *pvParameters) {
  int i;

  (void)pvParameters; /* not used */
  McuLog_trace("started shell task");
  /* initialize buffers */
  for(i=0;i<sizeof(ios)/sizeof(ios[0]);i++) {
    ios[i].buf[0] = '\0';
  }
  for(;;) {
    /* process all I/Os */
    for(i=0;i<sizeof(ios)/sizeof(ios[0]);i++) {
      (void)McuShell_ReadAndParseWithCommandTable(ios[i].buf, ios[i].bufSize, ios[i].stdio, CmdParserTable);
    }
    vTaskDelay(pdMS_TO_TICKS(10));
  } /* for */
}

void Shell_Init(void) {
  if (xTaskCreate(ShellTask, "Shell", 2048/sizeof(StackType_t), NULL, tskIDLE_PRIORITY+1, NULL) != pdPASS) {
    for(;;){} /* error */
  }
  McuShell_SetStdio(ios[0].stdio);
}

void Shell_Deinit(void) {
  McuShell_SetStdio(NULL);
}

#endif /* PL_CONFIG_USE_SHELL */
