ErichStyger/mcuoneclipse/Examples/MCUXpresso/i.MX RT1064_EVK/MIMXRT1064_SWO/source/main.c

/*
 * Copyright 2016-2018 NXP
 * All rights reserved.
 *
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
 * o Neither the name of NXP Semiconductor, Inc. nor the names of its
 *   contributors may be used to endorse or promote products derived from this
 *   software without specific prior written permission.
 *
 * THIS SOFTWARE IS PROVIDED BY THE COPYRIGHT HOLDERS AND CONTRIBUTORS "AS IS" AND
 * ANY EXPRESS OR IMPLIED WARRANTIES, INCLUDING, BUT NOT LIMITED TO, THE IMPLIED
 * WARRANTIES OF MERCHANTABILITY AND FITNESS FOR A PARTICULAR PURPOSE ARE
 * DISCLAIMED. IN NO EVENT SHALL THE COPYRIGHT HOLDER OR CONTRIBUTORS BE LIABLE FOR
 * ANY DIRECT, INDIRECT, INCIDENTAL, SPECIAL, EXEMPLARY, OR CONSEQUENTIAL DAMAGES
 * (INCLUDING, BUT NOT LIMITED TO, PROCUREMENT OF SUBSTITUTE GOODS OR SERVICES;
 * LOSS OF USE, DATA, OR PROFITS; OR BUSINESS INTERRUPTION) HOWEVER CAUSED AND ON
 * ANY THEORY OF LIABILITY, WHETHER IN CONTRACT, STRICT LIABILITY, OR TORT
 * (INCLUDING NEGLIGENCE OR OTHERWISE) ARISING IN ANY WAY OUT OF THE USE OF THIS
 * SOFTWARE, EVEN IF ADVISED OF THE POSSIBILITY OF SUCH DAMAGE.
 */
 
/**
 * @file    MIMXRT1064xxxxA_swo.c
 * @brief   Application entry point.
 */
#include <stdio.h>
#include "board.h"
#include "peripherals.h"
#include "pin_mux.h"
#include "clock_config.h"
#include "MIMXRT1064.h"
#include "fsl_debug_console.h"
/* TODO: insert other include files here. */

/* TODO: insert other definitions and declarations here. */
#define EXAMPLE_LED_GPIO BOARD_USER_LED_GPIO
#define EXAMPLE_LED_GPIO_PIN BOARD_USER_LED_GPIO_PIN

static volatile uint32_t g_systickCounter;
static volatile bool g_pinSet = false; /* The PIN status */

void SysTick_Handler(void) {
  if (g_systickCounter != 0U) {
      g_systickCounter--; /* count down the counter */
      for(int i=0;i<10000;i++) {
        __asm("nop");
      }
  }
}

static void SysTick_DelayTicks(uint32_t n) {
  g_systickCounter = n;
  while(g_systickCounter != 0U) {
    __asm("nop"); /* burn some cycles */
  }
}

static void blinkFLASH(void) {
  if (g_pinSet) {
    GPIO_PinWrite(EXAMPLE_LED_GPIO, EXAMPLE_LED_GPIO_PIN, 0U);
    g_pinSet = false;
  } else  {
    GPIO_PinWrite(EXAMPLE_LED_GPIO, EXAMPLE_LED_GPIO_PIN, 1U);
    g_pinSet = true;
  }
}

/*!
 * \brief Initialize the SWO trace port for debug message printing
 * \param portBits Port bit mask to be configured
 * \param cpuCoreFreqHz CPU core clock frequency in Hz
 */
void SWO_Init(uint32_t portBits, uint32_t cpuCoreFreqHz) {
  uint32_t SWOSpeed = 64000; /* default 64k baud rate */
  uint32_t SWOPrescaler = (cpuCoreFreqHz / SWOSpeed) - 1; /* SWOSpeed in Hz, note that cpuCoreFreqHz is expected to be match the CPU core clock */

  CoreDebug->DEMCR = CoreDebug_DEMCR_TRCENA_Msk; /* enable trace in core debug */
  *((volatile unsigned *)(ITM_BASE + 0x400F0)) = 0x00000002; /* "Selected PIN Protocol Register": Select which protocol to use for trace output (2: SWO NRZ, 1: SWO Manchester encoding) */
  *((volatile unsigned *)(ITM_BASE + 0x40010)) = SWOPrescaler; /* "Async Clock Prescaler Register". Scale the baud rate of the asynchronous output */
  *((volatile unsigned *)(ITM_BASE + 0x00FB0)) = 0xC5ACCE55; /* ITM Lock Access Register, C5ACCE55 enables more write access to Control Register 0xE00 :: 0xFFC */
  ITM->TCR = ITM_TCR_TraceBusID_Msk | ITM_TCR_SWOENA_Msk | ITM_TCR_SYNCENA_Msk | ITM_TCR_ITMENA_Msk; /* ITM Trace Control Register */
  ITM->TPR = ITM_TPR_PRIVMASK_Msk; /* ITM Trace Privilege Register */
  ITM->TER = portBits; /* ITM Trace Enable Register. Enabled tracing on stimulus ports. One bit per stimulus port. */
  *((volatile unsigned *)(ITM_BASE + 0x01000)) = 0x400003FE; /* DWT_CTRL */
  *((volatile unsigned *)(ITM_BASE + 0x40304)) = 0x00000100; /* Formatter and Flush Control Register */
}


/*!
 * \brief Sends a character over the SWO channel
 * \param c Character to be sent
 * \param portNo SWO channel number, value in the range of 0 to 31
 */
void SWO_PrintChar(char c, uint8_t portNo) {
  volatile int timeout;

  /* Check if Trace Control Register (ITM->TCR at 0xE0000E80) is set */
  if ((ITM->TCR&ITM_TCR_ITMENA_Msk) == 0) { /* check Trace Control Register if ITM trace is enabled*/
    return; /* not enabled? */
  }
  /* Check if the requested channel stimulus port (ITM->TER at 0xE0000E00) is enabled */
  if ((ITM->TER & (1ul<<portNo))==0) { /* check Trace Enable Register if requested port is enabled */
    return; /* requested port not enabled? */
  }
  timeout = 5000; /* arbitrary timeout value */
  while (ITM->PORT[0].u32 == 0) {
    /* Wait until STIMx is ready, then send data */
    timeout--;
    if (timeout==0) {
      return; /* not able to send */
    }
  }
  ITM->PORT[0].u8 = c;
}


/*!
 * \brief Sends a string over SWO to the host
 * \param s String to send
 * \param portNumber Port number, 0-31, use 0 for normal debug strings
 */
void SWO_PrintString(const char *s, uint8_t portNumber) {
  while (*s!='\0') {
    SWO_PrintChar(*s++, portNumber);
  }
}

/*
 * @brief   Application entry point.
 */
int main(void) {
  gpio_pin_config_t led_config = {kGPIO_DigitalOutput, 0, kGPIO_NoIntmode};

  /* Init board hardware. */
  BOARD_InitBootPins();
  BOARD_InitBootClocks();
  BOARD_InitBootPeripherals();
  /* Init FSL debug console. */
  BOARD_InitDebugConsole();

  SWO_Init(0, SystemCoreClock); /* if initialization is not done by the debugger, need to do it manually here */

  PRINTF("Hello World\n");
  SWO_PrintString("hello world using ITM console.\n", 0);

  /* Init output LED GPIO. */
  GPIO_PinInit(EXAMPLE_LED_GPIO, EXAMPLE_LED_GPIO_PIN, &led_config);

  /* Set SysTick reload value to generate 1ms interrupt */
  if(SysTick_Config(SystemCoreClock / 1000U)!=0) {
     while(1) { /* error case */
     }
  }
  for(;;) {
    /* Delay 1000 ms */
    SysTick_DelayTicks(1000U);
    SWO_PrintString("blinky\n", 0);
    blinkFLASH();
  }
  return 0 ;
}
