ErichStyger/mcuoneclipse/Examples/MCUXpresso/FRDM-MCXA153/MCXA153_Blinky/source/main.c

/*
 * Copyright (c) 2024, Erich Styger
 * SPDX-License-Identifier: BSD-3-Clause
 */

#include <stdio.h>
#include "board.h"
#include "peripherals.h"
#include "pin_mux.h"
#include "clock_config.h"
#include "fsl_debug_console.h"

#include "fsl_clock.h"
#include "platform.h"
#include "McuGPIO.h"
#include "McuLED.h"
#include "McuLog.h"
#include "McuWait.h"
#include "McuRTT.h"
#include "McuSemihost.h"

static void blink(void) {
  McuLog_info("setting up hardware.");
  CLOCK_EnableClock(kCLOCK_GateGPIO3);
  CLOCK_EnableClock(kCLOCK_GatePORT3);
  RESET_ReleasePeripheralReset(kGPIO3_RST_SHIFT_RSTn);
  RESET_ReleasePeripheralReset(kPORT3_RST_SHIFT_RSTn);

  McuLED_Config_t config;
  McuLED_Handle_t red, blue, green;

  /* red LED */
  config.hw.gpio = GPIO3;
  config.hw.port = PORT3;
  config.hw.pin = 12U;
  config.isLowActive = true;
  config.isOnInit = false;
  red = McuLED_InitLed(&config);
  if (red==NULL) {
    for(;;){}
  }

  /* green LED */
  config.hw.gpio = GPIO3;
  config.hw.port = PORT3;
  config.hw.pin = 13U;
  config.isLowActive = true;
  config.isOnInit = false;
  green = McuLED_InitLed(&config);
  if (green==NULL) {
    for(;;){}
  }

  /* blue LED */
  config.hw.gpio = GPIO3;
  config.hw.port = PORT3;
  config.hw.pin = 0U;
  config.isLowActive = true;
  config.isOnInit = false;
  blue = McuLED_InitLed(&config);
  if (blue==NULL) {
    for(;;){}
  }

  for(;;) {
    McuLED_On(red);
    McuWait_Waitms(500);
    McuLED_Off(red);
    McuWait_Waitms(500);
    McuLED_Toggle(red);
    McuWait_Waitms(500);
    McuLED_Toggle(red);
    McuWait_Waitms(500);

    McuLED_On(green);
    McuWait_Waitms(500);
    McuLED_Off(green);
    McuWait_Waitms(500);
    McuLED_Toggle(green);
    McuWait_Waitms(500);
    McuLED_Toggle(green);
    McuWait_Waitms(500);

    McuLED_On(blue);
    McuWait_Waitms(500);
    McuLED_Off(blue);
    McuWait_Waitms(500);
    McuLED_Toggle(blue);
    McuWait_Waitms(500);
    McuLED_Toggle(blue);
    McuWait_Waitms(500);
  #if PL_CONFIG_USE_RTT
    McuRTT_printf(0, "Hello from RTT\r\n");
  #endif
  #if PL_CONFIG_USE_SEMIHOSTING
    McuSemihost_printf("Hello world from semihosting\r\n");
  #endif
  }
}

int main(void) {
  /* Init board hardware. */
  BOARD_InitBootPins();
  BOARD_InitBootClocks();
  BOARD_InitBootPeripherals();
#ifndef BOARD_INIT_DEBUG_CONSOLE_PERIPHERAL
  /* Init FSL debug console. */
  BOARD_InitDebugConsole();
#endif

  PL_Init();

#if 0 /* testing only */
  for(;;) {
    unsigned char ch;
    int c;
    McuSemihost_WriteString((unsigned char*)"SYS_READC: Please type a character and press <ENTER>:\n"); /* writing zero terminated string */
    do {
      c = McuSemihost_SysReadC();
    } while(c<0);
    McuSemihost_WriteString((unsigned char*)"You typed: ");
    McuSemihost_WriteChar(c);
    McuSemihost_WriteChar('\n');

    do {
      McuSemihost_printf("please enter character\r\n");
      McuSemihost_StdIOReadChar(&ch);
      McuWait_Waitms(50);
    } while(ch==0);
  }
#endif
  blink();

  for(;;) {}
  return 0 ;
}
