ErichStyger/mcuoneclipse/Examples/MCUXpresso/i.MX RT1010/MIMXRT1011_Blinky/source/main.c

/*
 * Copyright (c) 2020, Erich Styger
 *
 * SPDX-License-Identifier: BSD-3-Clause
 */

#include "board.h"
#include "peripherals.h"
#include "pin_mux.h"
#include "clock_config.h"
#include "MIMXRT1011.h"
#include "application.h"

int main(void) {
  BOARD_ConfigMPU();
  BOARD_InitBootPins();
  BOARD_InitBootClocks();
  BOARD_InitBootPeripherals();
  APP_Run();
  while(1) {
    __asm volatile ("nop");
  }
  return 0 ;
}
