ErichStyger/mcuoneclipse/Examples/S32DS/S32K144_gcov/src/main.c

/*
 * main implementation: use this 'C' sample to create your own application
 *
 */
#include "S32K144.h"
#include "../gcov/gcov_support.h"
#include "test.h"

#if defined (__ghs__)
    #define __INTERRUPT_SVC  __interrupt
    #define __NO_RETURN _Pragma("ghs nowarning 111")
#elif defined (__ICCARM__)
    #define __INTERRUPT_SVC  __svc
    #define __NO_RETURN _Pragma("diag_suppress=Pe111")
#elif defined (__GNUC__)
    #define __INTERRUPT_SVC  __attribute__ ((interrupt ("SVC")))
    #define __NO_RETURN
#else
    #define __INTERRUPT_SVC
    #define __NO_RETURN
#endif

int counter, accumulator = 0, limit_value = 1000000;

int main(void) {
   gcov_init();  /* initialize library */
   gcov_check();

	  counter = 0;
	  test();

	  gcov_write(); /* write coverage files, might take a while depending how many files are covered */
	for(;;) {

	}
    for (;;) {
        counter++;

        if (counter >= limit_value) {
            __asm volatile ("svc 0");
            counter = 0;
        }
    }
    /* to avoid the warning message for GHS and IAR: statement is unreachable*/
    __NO_RETURN
    return 0;
}

__INTERRUPT_SVC void SVC_Handler() {
    accumulator += counter;
}
