ErichStyger/mcuoneclipse/Examples/CodeWarrior/FRDM-KL25Z/FRDM-KL25Z_printf/Sources/main.c

/*
 * main implementation: use this 'C' sample to create your own application
 *
 */

#include "derivative.h" /* include peripheral declarations */
#include <stdio.h>
#include "ConsoleIO.h"
#include "Application.h"

#define RED         (18)
#define RED_SHIFT   (1<<RED)

#define RED_OFF     (GPIOB_PSOR = RED_SHIFT)
#define RED_ON      (GPIOB_PCOR = RED_SHIFT)
#define RED_TOGGLE  (GPIOB_PTOR = RED_SHIFT)

static void InitLED(void) {
  /* Turn on clock to PortB module */
  SIM_SCGC5 |= SIM_SCGC5_PORTB_MASK;

  /* Set the PTB18 pin multiplexer to GPIO mode */
  PORTB_PCR18 = PORT_PCR_MUX(1);

  /* Set the initial output state to high */
  GPIOB_PSOR |= RED_SHIFT;

  /* Set the pins direction to output */
  GPIOB_PDDR |= RED_SHIFT;
}

static void NegLED(void) {
  RED_TOGGLE;
}

#define DEMO_GETS       0 /* 1 or 0 */
#define DEMO_USE_FLOAT  1 /* 1 or 0: in order to use floating point in printf/scanf, you need use a standard library with float enabled. See Librarian options. */

#if DEMO_GETS
static char buffer[64];
#endif

int main(void) {
	ConsoleIO_Init();
#if 1
	APP_Run();
#else
    int counter = 0;
    
	InitLED();
  printf("Hello world!\r\n");
	for(;;) {	   
	  counter++;
#if DEMO_GETS /* enable this to use gets() too */
	  printf("Enter a string:\r\n");
    if (gets(buffer)!=NULL) {
      printf("you entered: %s\r\n", buffer);
    }
    NegLED();
#else
	  printf("counter: %d\r\n", counter);
#if DEMO_USE_FLOAT
    printf("float value: %f\r\n", 3.75f);
#endif
    if ((counter%32)==0) { /* blink LED slowly so it is better visible */
      NegLED();
    }
#endif
	}
#endif
	return 0;
}
