ErichStyger/mcuoneclipse/(commit log)

2013-01-10 first working version with the Freedom Board (Kinetis L)
2013-01-13 New methods to cut a tail and compare a tail string.
2013-01-14 Initial version of Bluetooth module driver
2013-01-15 Documentation on PWM was missing
2013-01-22 fixed ARM gcc warnings and updated documentation
2013-01-22 fixed LED documentation
2013-01-26 adding comment in case build fails: how to resolve it
2013-01-26 updated driver and fixed warnings/errors with ColdFire compiler
2013-01-26 new shell interface for LED
2013-01-27 updated example for Bluetooth driver
2013-01-28 Initial commit of demo project for I2CSpy
2013-01-29 updated I2C example
2013-01-29 ignoring trace files
2013-01-29 ignoring trace config file
2013-01-29 added SMAC driver
2013-01-30 added new examples
    [MCF52259.cfg]
2013-02-01 fixed assembly external symbol for FSL ARM Compiler
2013-02-03 updated with trace settings
2013-02-03 initial version of config file
    [ols.profile-FRDM-KL25ZLogicLogger.cfg]
2013-02-03 updated logic configuration file for 15 KByte buffer
    [ols.profile-FRDM-KL25ZLogicLogger.cfg]
2013-02-03 initial version of logic config file
    [ols.profile-FRDM-KL25ZLogicLogger.cfg]
2013-02-03 moved logic file into correct folder
    [ols.profile-FRDM-KL25ZLogicLogger.cfg]
2013-02-03 added periodic sampling
    [ols.profile-FRDM-KL25ZLogicLogger.cfg]
2013-02-03 updated for latest LED component properties
2013-02-17 Extended LED component description for PWM usage
2013-02-17 updated Bluetooth example to use PWM for the red LED
2013-02-19 better configuration of the motor driver, better names for counter component
2013-02-21 initial version of FatFS example application using the TWR-52259
    [MCF52259.cfg]
2013-02-22 Added 'LEDbit' component as a clone of the LED component, as the LED component name might conflict with existing LED component for DSC installed by CodeWarrior.
2013-02-22 fix for how interrupt flags are set
2013-02-23 clarified that for AsynchroSerial the interrupts need to be enabled
2013-02-24 added triggers, frequency choise and test data
    [ols.profile-FRDM-KL25ZLogicLogger.cfg]
2013-02-26 ignoring SA/trace configuration files
2013-02-28 first version which is able to read from the device
2013-03-06 using cathode pin connection for LED component as default
2013-03-06 Disabled interrupt after reset for tick counter
2013-03-06 Initial version of FreeRTOS project for FRDM-KL05Z board
2013-03-06 changed button name from SW3 to SW1
2013-03-07 added FRDM board schemas and layouts
    [BT_HC05_v1.brd, BT_HC05_v1.sch, FRDM-Motor_v1.brd, FRDM-Motor_v1.sch]
2013-03-08 fixed handling of error case for multi-commands
2013-03-08 ignoring trace configuration files
2013-03-09 FatFsDResultMsg() only needed by PrintSector()
2013-03-19 removed GCC warning and add PIMAGE for Kinetis devices
2013-03-21 Extended tool tip about Cortex interrupts
2013-03-24 removed built-in sampling timer, added init/deinit methods.
2013-03-24 Updated project to support DMA based on the files from Reiner Geiger
    [ols.profile-FRDM-KL25ZLogicLogger.cfg]
2013-03-24 updated Pololu robot project with maze and turn PID
2013-03-24 Added FreeRTOS demo project for 52259
    [MCF52259.cfg]
2013-03-27 initial version of a timer based LED blink on the KL05Z
2013-03-29 initial project for 522259 and TWR-LCD over SPI
    [MCF52259.cfg]
2013-03-29 CDC project for the DEMOJM board
2013-03-29 CDC project for MCF52259
    [MCF52259.cfg]
2013-03-31 making sure that the tick timer is not running at startup time
2013-03-31 Additional RTOS Init() routine to make sure tick timer is not running.
2013-03-31 added property for I2C slave address
2013-03-31 fixed missing void in driver code
2013-03-31 Accelerometer example using GenericI2C component
2013-03-31 updated Accelerometer project to use the new MMA8451Q component
2013-04-05 updated CDC projects. Interrupts were disabled for JM60 project.
2013-04-05 added functions to enable/disable USB interrupts for JM16 and JM60
2013-04-06 updated demo projects for USB CDC with correct LED polarity
2013-04-06 in case of rx buffer overflow, do not block.
2013-04-07 need to remove code to set up external device for KL25Z Freedom board, otherwise it does not work.
2013-04-07 added trace configuration
2013-04-11 added footprint for MC13210x evaluation board connector.
2013-04-11 corrected pin settings (one pin is NC)
2013-04-11 added shell support for accelerometer
2013-04-14 using timer for MSD wait routine
2013-04-16 Added accelerometer
2013-04-16 added accelerometer trace
2013-04-17 Initial commit of printf() project for FRDM-KL25Z
2013-04-18 updated LCD projects to use memory mapped I2C operations
2013-04-18 added revisions of schemata
    [FRDM-Robot-Rev1.3.sch]
2013-04-18 fixed project (I2C hooks were missing)
2013-04-18 added blinking RED led
2013-04-18 added option to print code size and to generate S19 file
2013-04-22 moved to sub folders
    [BT_HC05_v1.brd, BT_HC05_v1.sch, FRDM-Motor_v1.brd, FRDM-Motor_v1.sch, FRDM-Robot-Rev1.8.brd, FRDM-Robot-Rev1.8.sch]
2013-04-23 added property for library syscall interrupt level for ColdFire
2013-04-24 updated I2C settings
2013-04-25 updated eagle files
    [FRDM-Robot-Rev1.9.brd, FRDM-Robot-Rev1.9.sch, FRDM-Shield-Rev1.1.brd, FRDM-Shield-Rev1.1.sch]
2013-04-27 Added LED and set clock to 48 MHz.
2013-04-27 removed trace settings as causing issues with OSBDM
2013-04-28 updated K60 CDC project to match latest LED components
2013-04-28 USB MSD host project extensions for K60. Still having a problem that the device does not enumerate properly.
2013-04-29 fixed interrupt range for V2
2013-05-04 Added WP (Write Protection) pin support
2013-05-04 fixed 'unknown macro' error message with CW for MCU10.4 and enabled pin sharing in TWR-MK60_FatFS_gcc project. Strange....
2013-05-04 added Card Write Protection pin support and updated to MCU10.4
2013-05-05 updated files to be able to compile. Still having a problem that the USB interrupt crashes the RTOS.
2013-05-12 initial version of track robot
2013-05-12 updated track robot project
2013-05-14 re-asserting reset in case of timeout
2013-05-14 added reset of transceiver in case of EMI
2013-05-15 added NULL in case it is not defined.
2013-05-16 missing enable interrupts in vPortStartFirstTask() for IAR port.
2013-05-16 turning off interrupts for ARM Cortex-M0+ during startup. Otherwise it can happen that interrupts get fired during startup code, enabled by the memory module. Happened with the SMAC stack and FRDM pr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
2013-05-16 added Ultrasonic module to robot
2013-05-18 added reflectance sensor
2013-05-20 additional attribute to configure if interrupts shall be disabled during startup.
2013-05-25 I2CSpy to prove device just with ACK response
2013-05-25 updated I2CSpy project
2013-05-27 extended Ultrasonic with shell
2013-05-27 moved ultrasonic files to common folder. Round robot project uses shared folder.
2013-05-28 updated servo to work with Kinetis
2013-05-28 added ultrasonic wandering around functionality
2013-05-28 initial project setup with servos supported
2013-05-28 completed demo with Servos
2013-05-30 new rev 2.1 of FRDM-Robot
    [FRDM-Robot-Rev2.1.brd, FRDM-Robot-Rev2.1.sch]
2013-05-30 updated FRDM-Shield 2.0 revision
    [FRDM-Shield-Rev2.0.brd, FRDM-Shield-Rev2.0.sch]
2013-05-30 updated servo project and components
2013-05-30 initial version of 74HC595 driver
2013-05-30 fixed wrong macro usage in driver
2013-06-03 Added Servo example project
2013-06-04 added relay support
2013-06-04 updated Servo project for timed moves.
2013-06-04 updated project for timed servo moves
2013-06-04 default to dynamic allocated bdt for legacy FSL ARM compiler
2013-06-04 Initial version of FSL-Bot project
    [MCF52259.cfg]
2013-06-04 updated motor application
2013-06-05 fixed warnings in servo driver
2013-06-06 aligned servo shell interface
2013-06-07 support for IAR assembly syntax in Wait component
2013-06-10 extended printf() example with gets()
2013-06-14 updated printf() demo
2013-06-16 updated bean settings for generic I2C
2013-06-16 Servo component has added clock configurations. Otherwise the inherited PWM components have it read-only.
2013-06-17 moved more drivers to common folder.
2013-06-19 updated Wait component to support Keil/ARM compiler
2013-06-20 using macro for counter position to allow pin swapping
2013-06-21 added 24AA256 device type to the driver
2013-06-23 Added IR distance sensor to robot projects, extended support with quadrature sensors (turn operations).
2013-06-24 added accelerometer and IEEE802.15.4 to INTRObot
2013-06-24 updated for USB HID Keyboard device.
2013-06-25 fixed page size for 256 EEPROM device
2013-06-26 FatFS shell driver updated to conform handler standard parsing.
2013-06-27 initial change to support Keil compiler/assembly syntax.
2013-06-28 added ARM Keil compiler
2013-06-28 support for Keil compiler/assembler
2013-06-29 added proper LED handling.
2013-06-30 released USB HID Keyboard drivers
2013-07-02 added support for FRDM-K20D50M and USB HID Keyboard device.
2013-07-03 added new eagle files from A. Tuor.
    [FRDM-Motor_v1.brd, FRDM-Motor_v1.sch, FRDM-Robot-Rev2.2.brd, FRDM-Robot-Rev2.2.sch, FRDM-Shield-Rev2.1.brd, FRDM-Shield-Rev2.1.sch]
2013-07-06 Using events instead of macros for low power entry and exit
2013-07-08 Updated to use tickless low power mode.
2013-07-10 Support in FreeRTOS to distinguish between disabling all interrupts or only the interrupts used by RTOS level.
2013-07-13 fixed bug with manual switch (was disabled if used manual mode once).
2013-07-16 including <stddef.h> in case size_t is used in header file.
2013-07-17 card detect pin disabled by default
2013-07-20 New layout and schematics for INTRO robot
2013-07-21 streamlined startup assembly file
2013-07-21 using *.S (uppercase) extension for assembly file.
2013-07-21 using *.S for assembly source files to be consistent with Eclipse file mapping
2013-08-01 first version of USB HID Mouse Device
2013-08-01 updated vendor and device description strings
2013-08-02 removing support for legacy FSL ARM compiler
2013-08-04 added shell and accelerometer
2013-08-04 added magnetometer support
2013-08-07 extended magnetometer support
2013-08-07 Added interrupt support
2013-08-08 extended nRF24L01 driver
2013-08-08 updated interrupt handling
2013-08-09 added 24AA/LC EEPROM example and updated driver
2013-08-09 fixed shell command handling (missed to cut off the module prefix)
2013-08-15 need to release semaphore in case of error
2013-08-17 added LEDs and switches
2013-08-18 Updated components with 24xx EEPROM drivers
2013-08-19 fixed nRF24 driver (was wrong subroutine call in GetStatus())
2013-08-21 added an attribute to configure the return value in case no card detection pin is available.
2013-08-22 moved device parameters to header file
2013-08-26 initializing tick timer inside startScheduler.
2013-08-26 attribute to use SysTick directly instead of using TimerUnit_LDD
2013-08-26 added more device support to USB stack
2013-08-26 initial project for USB CDC and TWR-K21D50M board
2013-08-27 initial version of USB HID Keyboard device on the FRDM-KL46Z48M board
2013-08-28 fix for SysTick mode with Percepio trace
2013-08-29 Fixed S08 port. Task switching was wrong in timer interrupt (introduced with tickless timer support changes).
2013-08-29 updated beans: fixed S08 timer interrupt in FreeRTOS, added KL47Z and K21 USB support, added Kinetis Watchdog support to Wait component.
2013-08-31 WaitLongCycles() for devices with >64 MHz clock (e.g. ARM Kinetis).
2013-09-01 fixed tickless idle mode: issue was with interrupt priorities and with re-load of register value right after start of processor.
2013-09-01 optimization of tickless mode: no global variable used for ARM SysTick mode
2013-09-02 updated projects for ARM SysTick and Tickless Idle Mode
2013-09-02 enabled CPU low power mode
2013-09-02 tickless idle mode for K family (cannot simply disable interrupts).
2013-09-05 added interface to check if sensor is enabled
2013-09-06 prevent interrupts being re-enabled during initialization
2013-09-06 make sure that the tick timer is not running until the RTOS starts.
2013-09-08 Fixed USB HID Keyboard driver for S08JM60
2013-09-08 fixed USB HID Mouse driver for S08JM60
2013-09-08 Example project for USB HID Mouse device for S08JM60 on DEMOJM board.
2013-09-10 Fixed GenericTimeDate to support different than 10ms tick timer, added shell support.
2013-09-14 updated with printf() for floating point.
2013-09-15 fix error message in case no event name defined
2013-09-27 Using more generic name vPortTickHandler() for RTOS tick interrupt.
2013-09-28 new Eagle files and schematics
2013-09-28 removed old versions
    [FRDM-Robot-Rev2.2.brd, FRDM-Robot-Rev2.2.sch, FRDM-Shield-Rev2.1.brd, FRDM-Shield-Rev2.1.sch]
2013-10-15 initial version of KL25Z Low Power Example
2013-10-17 added accelerometer to shell project
2013-10-17 project with FreeRTOS and DriverSuite for IAR.
2013-10-18 not loosing character if overrun error from device received
2013-10-18 updated low power project
2013-10-20 updated low power example to not use UART0
2013-10-20 updated low power project with tickless idle mode
2013-10-23 added support for Freescale legacy ARM compiler
2013-10-26 added USB stack, but interrupts do not fire yet?
2013-10-26 added USB CDC project for TWR-MCF52259
    [MCF52259.cfg]
2013-11-03 added PWM LEDs
2013-11-04 Somehow PEx had duplicated my PWM timer channels?
2013-11-06 fixed LED handling
2013-11-10 using systick instead of dedicated timer component
2013-11-16 removd the need for software interrupt for task switching
2013-11-17 footprint for Pololu push button
2013-11-18 additional footprints in Eagle
2013-11-18 updated components not to access SPI during interrupt.
2013-11-18 updated MC1320x driver with new interrupt model
2013-12-01 RNet application with the MC13213 board (SRB)
2013-12-02 added missing variable if trace is enabled with tickless idle mode.
2013-12-06 allow bit banging software I2C as interface. As this is nonLDD, need to be able to enable it for Kinetis (LDD device).
2013-12-07 Improved Software I2C (bit banging) driver, based on input and contributions from Marc Lindahl.
2013-12-17 power down interface and reporting channel in status
2013-12-17 in case of timeout flush tx pipe
2013-12-17 extended long keypress time (type for it) to support 1 kHz tick timer
2013-12-18 added E2 pin
2013-12-23 extended with shell and push button support
2013-12-24 added PWM/Buzzer with 60 Hz (experimental), removed generated files from repository
2013-12-26 updated magnetometer driver
2013-12-26 first version of FXOS8700 driver (accelerometer only)
2013-12-26 added I2CSpy and Accelerometer
2013-12-27 added light sensor handling in shell and fixed long key handling
2013-12-29 added magnetometer functionality
2013-12-30 updated driver (EN2 disabled by default).
2014-01-02 Initial starting point for the Arduino Ethernet Shield
2014-01-04 working SD card, added initial w5100 driver
2014-01-04 added Eagle files of Arduino Ethernet shield
    [Shield_Eth06-REV3.brd, Shield_Eth06-REV3.sch]
2014-01-05 lastest version with SD card driver
2014-01-05 switching automatically to fast mode at the end of initialization
2014-01-06 updated with new SD card driver.
2014-01-06 tested with new SD card driver.
2014-01-06 moved project to TWR-52259 folder
    [MCF52259.cfg]
2014-01-07 removed test prototype
2014-01-08 added W5100 socket interface
2014-01-12 better error handling (just in case), plus fix for adding seconds to the time information.
2014-01-14 added LEDs
2014-01-17 Timeout using RTOS tick counter, changed cpu package to BGA as on the TWR-K60N512 board.
2014-01-20 added ability to call Init() from the application in case interrupts are disabled.
2014-01-31 printing not-ack information
2014-02-02 implemented power-down for nRF24L01+
2014-02-02 added method to read channel from device.
2014-02-02 reading channel from device
2014-02-03 fixed problem in case of minimal negative value (both for 16bit and 32bit).
2014-02-03 fix for tickless idle mode in case remaining ticks are near zero.
2014-02-06 added low power tick support to RTOS
2014-02-08 Test project for the Microchip MPC4728 device
2014-02-08 added second board MAC address
2014-02-14 fixed include problem with DriverSuite 10.3 and Kepler
2014-02-18 using normal BitIO for SDHC pin
2014-02-21 updated low power demo to use STOP mode
2014-02-22 updated RNet component and drivers
2014-02-22 verified USB CDC with RevE FRDM-KL25Z board
2014-02-23 optimized SPI timing
2014-02-28 added wrapper for driver critical sections
2014-02-28 added LED's
2014-03-01 including timers.h
2014-03-01 buttons are now working
2014-03-01 SD card working in SPI mode
2014-03-02 changed I2C port
2014-03-05 making SPI interface (shared component) disabled by default, as workaround to Processor Expert bug while creating shared component.
2014-03-06 auto calibration added
2014-03-09 Initial starting point for Adafruit Thermal Mini Receipt Printer Project
2014-03-09 first printing works :-)
2014-03-16 initial LLS low power project
2014-03-19 improved low power: disabled external clock, disabled PLL in stop mode, disabled SCI
2014-03-20 added checks in case IRQ is not used.
2014-03-21 SPI sharing for nRF24L01+
2014-03-21 removed LDD from SD_Card driver
2014-03-21 Revert "removed LDD from SD_Card driver"
    This reverts commit 02b3c1ab8f290a1ec37596f5eeccca89d313171b.
2014-03-22 added software SPI to nRF24L01+
2014-03-23 sending button press data
2014-03-23 initial port of trace v2.6.0
2014-03-24 Updated trace for HCS08 compiler
2014-03-29 improved low power demo
2014-04-05 updated components for FreeRTOS trace
2014-04-06 using different interrupt handler for SDK
2014-04-08 added new properties for trace
2014-04-08 all buttons plus X/Y
2014-04-10 added KDS projects for FRDM-K64F board
2014-04-18 Initial blink LED project with Eclipse Kepler
2014-04-26 SD card driver property to enable/disable block transfer
2014-04-26 nRF24L01+ driver with polling support, and extened RNet stack to support it.
2014-05-10 added block mode for SW SPI and SynchroSerial
2014-05-11 extended nRF24L01+ driver
2014-05-17 non-block and block access support for HW SPI bus.
2014-05-17 updated track project for turn table
2014-05-21 in case of disabled device, do not access device registers any more (otherwise hard fault could happen later).
2014-05-24 for Keil using syscall interrupt priority
2014-05-25 changed to 100-pin variant
2014-05-31 updated project and added pull resistors for SD card
2014-06-01 updated data logger to get accelerometer values
2014-06-07 updated blink led project on Eclipse
2014-06-14 fixed low power decision handler (was not waiting the correct amount of time)
2014-06-14 updated KL25Z low power project
2014-06-14 support for Low Power Timer ticks for Cortex-M4 (tested with FRDM-K20)
2014-06-14 tested low power timer in FreeRTOS for Cortex-M4
2014-06-15 enabled USB interrupts for K64F
2014-06-18 refactoring of DMA implementation of logic analyzer with FRDM-KL25Z
2014-06-19 updated for ols-0.9.7
    [ols.profile-FRDM-KL25ZLogicLogger.cfg, ols.profile-frdm.cfg]
2014-06-22 extended local buffer, changed power down sequence
2014-06-22 added board configuration to SDK project
2014-06-22 updated project to properly switch between SD and RF configuration
2014-06-22 using device LDD macro and not component one
2014-07-06 fix for K22 interrupts
2014-07-12 support for multi-drivers/volumes in FatFS
2014-07-12 added printf() to physial serial port KDS example project
2014-07-12 added Eclipse Kepler printf project for FRDM-KL25Z and physical serial port.
2014-07-13 added printf() project for FRDM-K64F using UART
2014-07-18 updated printf project
2014-07-18 show I2C address in status
2014-08-02 fixed lockup problem with sending strings while device is not enumerated. Re-enabled again fix for %8 packets as failure happens again with K22.
2014-08-07 added Quadrature Encoder Eagle files
    [QuadEncoder.brd, QuadEncoder.sch]
2014-08-09 Blinky project for Teensy 3.1 board with Eclipse
2014-08-10 Changed module prefix to detect a bug (fixed)
    [main.c]
2014-08-15 CodeWarrior for MCU10.6 project for the FRDM-K64F board
2014-08-23 dynamic channel variable to support non-default channel on power-up
2014-08-23 fix for low-power timer usage in tickless idle mode
2014-08-23 updated project to test tickless idle mode with low power 1 kHz timer
2014-09-10 Corrected Accelerometer Calibration
    Updated calibration functions for accelerometer such that offsets now
    correctly calibrate zero-g when reset while accelerometer is level &
    stationary. Also corrected some typos.
2014-09-19 in error case, isTimout variable was not always initialized (fixed).
2014-09-19 better support for low power modes for the nRF24L01+
2014-09-19 handling case when RTC is still busy writing data.
2014-09-21 MMA8451Q Library Update
    Updated MMA8451Q accelerometer library: added register read/write,
    corrected zero-g calibration, minor typos etc
2014-09-22 Stopping the Kinetis LPTMR (Low Power Timer) in tickless idle mode will reset the timer counter register. Updated the implementation based on feedback by Tom Daugherty, see http://mcuoneclipse.com/20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
2014-09-22 updated project for low power
2014-09-24 updated to work with classic CodeWarrior (S12): assembler does not accept normal C comments.
2014-09-25 updated accelerometer interface
2014-09-26 Contribution by T. Daugherty: 1) ulReloadValue needs to be calculated differently based on COUNTS_UP. 2) if eTaskConfirmSleepModeStatus()==eAbortSleep, then the tick duration needs to be reconfigured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
2014-09-28 making sure variable is always initialized (even in error case), and updated comments.
2014-10-01 updates for low power timer support
2014-10-08 fix for interrupted low power timer. Still having issue with task time stretched if interrupts happening frequently. Need to compensate for the lost timer time.
2014-10-08 enhanced low power project
2014-10-09 merged changes from Tom D., and checking for tick counter underflow. Functions ok, except that for a 10ms tick period without idle time interruption there are two unnecessary tick interrupts happenin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
2014-10-10 updated and fixed interface to SPI (report in the blog that it does not work).
2014-10-14 updating for Keil assembler
2014-10-14 using compiler intrinsics for Keil to enable/disable interrupts, as otherwise the Keil compiler will optimize the assembly code in release mode with optimizations turned on
2014-10-20 added DMA
2014-10-20 updated low power application
2014-10-22 added project for TWR-K24F120M board
2014-10-22 updated printf() project
2014-10-23 Fixed App_Callback() to be interrupt safe for asynchronous TX/RX streams.
2014-10-24 Eagle Shield and Library Files
    [INTRO Robot Shield.brd, INTRO Robot Shield.sch]
2014-10-29 updated NeoPixel projects with DMA
2014-11-02 updated NeoPixel project with DMA
2014-11-02 Fixed one wire files
2014-11-02 fixed DMA, moved one values to FLASH
2014-11-03 removed need for interrupt
2014-11-05 updated one wire component
2014-11-07 fixed timer init, first LED looking goodl
2014-11-13 initial project for FRDM-KE06Z board
2014-11-13 added dimming LEDs
2014-11-15 FreeRTOS configuration setting for Percepio trace enabled or not
2014-11-17 working socket communication
2014-11-18 updated blink led project for MCU10.6
2014-11-19 added I/O pin defines
2014-12-27 updated project so it uses normal HW SPI
2014-12-27 working USB CDC for the FRDM-K22F board
2014-12-28 Initial USB MSD Host project for FRDM-K22F Board
2015-01-04 updated project settings and Percepio Trace settings
2015-01-04 added trace
2015-02-20 new USB CDC Example for TWR-K20D72M board
2015-02-23 Fixed wrong parsing of numbers like "123.056" where the leading zeros of the fractional part were not handled correctly.
    [main.c]
2015-03-16 Function Trace project
2015-03-25 updated project to support 24AA16 devices
2015-03-26 pcb file with now most of the text converted to strings, which should make the board faster to work with, about 10,000 less lines to make up the text.
2015-04-04 updated trace example
2015-04-06 updated driver
2015-04-11 project using UART with the FRDM-KL02Z
2015-04-12 updated printf example with floating point
2015-04-13 new Teensy 3.1 project for USB CDC
2015-04-18 updated UART example for FRDM-KL02Z
2015-04-18 extended project, added LEDs and UART
2015-04-26 Added example to generate CRC
    [crc_dump.txt]
2015-05-20 added tinyK20 material
2015-06-12 enabled bus powered device setting
2015-06-17 updated, board shown in http://mcuoneclipse.com/2015/06/17/tinyk20-new-board-with-micro-sd-card/
2015-06-18 added Bill Of Material
2015-06-19 updated for new board
    [tinyK20.brd, tinyK20.sch]
2015-06-25 added optional UART to SWD connections
2015-06-26 new version with UART to SWD connections
    [tinyK20.brd, tinyK20.sch]
2015-06-30 cleanup of schematics
2015-06-30 added new USB HID Mouse project for FRDM-K64F Board
2015-07-08 added I2C for testing, switched to the July 5th 2015 released components.
2015-07-15 added trace to project
2015-07-15 updated to be used with Percepio trace
2015-07-15 added trace config and PE wrapper
2015-07-19 updated and added more threads in stack (were covered by RTX)
2015-07-25 added Altium files for NeoPixel shield (see http://mcuoneclipse.com/2014/11/10/neoshield-ws2812-rgb-led-shield-with-dma-and-nrf24l01/)
2015-07-26 one PWM working
2015-07-26 working with two PWM
2015-07-27 added basic DMA
2015-07-28 working DMA to port
2015-07-28 splitted DMA init and transfer
2015-07-28 added PWM again
2015-07-30 first DMA transfers triggered by FTM0 :-)
2015-07-30 working with three TPM channels and DMA now.
2015-07-31 disabled DMA controller component
2015-07-31 fixed pin glitch at the startup, pin was set to 1 instead to zero
2015-07-31 fixed problem with DMA transfer still arbitrated.
2015-07-31 working with the LED's :-)
2015-08-10 initial version of profiling support. Without timer sampling.
2015-08-10 working profiler with timer sampling :-)
2015-08-17 Using Kinetis Design Studio with LPCXpresso Board
2015-09-23 added ESC code
2015-09-28 improved ESC support
2015-10-03 added push buttons and SD card.
2015-10-04 improved ESC handling
2015-10-14 moved CodeWarrior projects into CodeWarrior folder
    [MCF52259.cfg, ols.profile-FRDM-KL25ZLogicLogger.cfg, ols.profile-frdm.cfg]
2015-10-14 added sensor fusion library
2015-11-08 added Segger RTT with Trace
2015-11-24 updated to use Percepio Trace
2015-12-30 initial steps with Adafruit BLE SPI module
2016-01-04 working UART bridge over BLE
2016-01-04 improved UART mode
2016-01-23 updated project for RGB LED and PWM
2016-01-30 updated and extended for LED cube
2016-02-06 fixed multiple pixel lane handling
    [main.c]
2016-02-20 extended board tinyK20 board information
2016-02-28 added UART files
2016-02-28 initial version of Nordic Semiconductor nRF24L01+ project for tinyK20 board
2016-03-12 Blinky LED project for the FRDM-KL26Z
2016-03-27 initial project with FlexIO driving WS2812B LEDs
2016-04-12 updated project and disabled to receive all interrupts in fsl_enet_driver.h
2016-05-07 added percepio trace
2016-05-07 updated Percepio Trace
2016-05-07 updated for Percepio Trace
2016-05-07 changed to 10ms timer
2016-05-08 added push buttons
2016-06-14 added button handling
2016-06-15 fixed serial interface handling
    [main.c]
2016-06-16 cleanup and added interrupt code to test program
2016-07-09 updated for Adafruit breakout board
2016-07-15 initial nRF24L01+ project for SRB board
2016-07-16 using Percepio Trace
2016-07-18 added two additional buttons
2016-07-25 first version of Radiohead for tinyK20
    [project.cfg]
2016-07-25 cleanup of not used devices
2016-07-26 added RadioHead example for FRDM-KL25Z and nRF24L01+
    [project.cfg]
2016-07-31 SDK V2.0 project for the TWR-KV85F220M board
2016-08-04 added LED Frame
2016-08-11 added side buttons and tests
2016-08-22 updated project to use Arduino shield with SPIMaster_LDD
2016-09-04 added filter
2016-09-04 major rework of matrix handling
    [main.c]
2016-09-24 added LED and console interface
2016-09-27 initial project of accelerometer demo for FRDM-KE02Z40M
2016-10-03 updated projects and extended LED frame project
2016-10-08 added printf() support, NFC working now :-)
2016-10-12 added swo and trace functions
2016-10-12 initial low power version
2016-10-30 updated trace support
2016-11-21 initial project for FRDM-K22F using push button debouncing
2016-11-21 improved button handling
2016-11-22 improved sand vibration handling
    [main.c]
2016-11-24 added 3D CAD files
    [sandclock.stl]
2016-11-24 using LDD for SPI
2016-11-24 inititial ADC project with FreeRTOS
2016-11-28 updated LedFrame projectt with new RTC component
2016-11-28 updated init to match latest driver version
2016-12-13 updated for RevE of the FRDM-K64F board, added push button to send messages
2016-12-14 initial version with sotware SPI
2016-12-29 updated for latest components, and verified that loading works. I had to use the P&E USB CDC implemenation on the FRDM-K64F board (the Segger one failed).
    [main.c]
2017-01-05 added LedMatrix example
2017-01-09 Add a makefile, gamma correction and patterns
    Add a makefile for building the project without an IDE
    Add gamma correction table generator c file and a rule to build it using gcc in the makefile
    Add a gamma correction generated table in DMAPixel.c and use it in Colors.h to pack RGB colors into 24bit bitstream
    Add some LED pattern routines in DMAPixel.c
    [main.c]
2017-01-15 working (again) bootloader example. Somehow had to disable the timer in the example project? still under investigation.
2017-03-08 using track 7
2017-03-10 in case .pl files are not automatically associated with perl, call the perl executable directly.
2017-03-11 added accelerometer with I2C
2017-03-19 added nRF24L01+ with Software SPI (functionality not tested yet)
2017-03-20 updated example to work with TWR-KL25Z UART.
2017-04-03 using correct interrupt prios with FreeRTOS
    [main.c]
2017-04-15 added board flyer
2017-04-18 added shell with UART0
2017-04-23 switched to server certificate
2017-04-29 using UART Rx interrupts
2017-05-02 added 1-Wire example project
2017-05-04 updated 1-Wire project
2017-05-11 updated 1-wire example
2017-05-12 updated projects, updated for latest 1-wire components
2017-05-13 added LPC800-DIP board blinky project
2017-06-01 updated 1-wire examples
2017-06-10 Initial USB MSD device project (experimental)
2017-07-12 fixed bootloader project as it still had links to the KBOOT installation folder
    [main.c]
2017-09-20 added UART to CDC (still experimental)
2017-09-25 updated UART example, still finding issues in SDK library
2017-09-27 updated UART example
2017-10-10 added teensy 3.5 example project
2017-10-14 cleanup UART handling
2017-10-16 updated to the latest McuOnEclipse drivers
2017-11-26 added demo project for TSL2561 ambient light sensor
2017-12-22 added original FTF-DES-N1956 material
2018-01-12 fixed issue in case CRC sum is > 255
2018-02-24 added printout of ADC value written to AD device
2018-03-10 added V2 Sumo Robot Schematics
2018-04-25 added Cohesion3D files
    [config.txt]
2018-05-20 Added FreeRTOS timer example project
2018-05-20 added more files to timer project
2018-05-20 added LED code
2018-05-23 updated timer example
2018-06-07 added .svg (Inkscape) laser cutter files
2018-07-10 added SW2 push button
2018-07-14 added DMA code
2018-07-15 basic timer operation
2018-07-15 finally basic DMA is working :-)
2018-07-15 working DMA with pattern (not the exact timing yet)
2018-07-19 added LCD enclosure for i.MX RT1052 EVK
2018-07-19 added FreeRTOS
    [SumoRobot.kicad_pcb, SumoRobot.sch]
2018-07-20 double eye, need to swap upper and lower
    [main.c]
2018-07-21 added example for MMA8451Q accelerometer on FRDM-KL25Z
2018-08-06 added LED
2018-08-13 updated projec and first steps to add push button support
2018-08-15 added push button support (not fully functional yet)
2018-08-15 working push button handling (requires updated key component!)
2018-08-18 using HW SPI
2018-08-19 added 'hello world' for the Embedded Artists i.MX RT1052 OEM board
2018-08-19 disabled accel as not present on board
2018-08-26 added trace point
2018-08-28 added led pin
2018-08-28 added I2C pins
2018-09-04 added CW for S12 V5.1 project and TWR-S12G240 board
2018-09-23 updated for using SDHC instead of SPI
2018-09-23 added SDHC (not working yet, see notes) and SPI access.
    [main.c]
2018-09-30 updated project, fixed CPU package
    [main.c]
2018-10-02 added USB, changed device and added sensors
2018-10-03 workng Adafruit SGP30 sensor
2018-10-04 added push button and using HW SPI for LCD
2018-10-04 using FreeRTOS timer for periodic callbacks
2018-10-06 added VOC and CO2 sensor
2018-10-11 added SPI sharing
2018-10-13 working SD plus display driver on the same SPI bus
2018-10-14 dedicated sensor module
2018-10-17 turning on UART Rx pull-up resistors if having a tinyK20 with OpenSDA firmware on the other side: the OpenSDA will not pull up the line so the line will be floating. Thus might inject noise into the 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
2018-11-10 updated with adaptive led brightness
2018-11-25 option to change LED brightness
2018-11-28 Added project for Adafruit Si7021 temperature & humidity breakout board
2018-12-01 added navigation switch support
2018-12-04 updated to handle failed initialization
    [main.c]
2018-12-04 only using navigation switch
2018-12-15 added SWO printf() project
2018-12-30 removed tickless idle (WFI can brick the device!) and added blinky to task
2019-01-03 added vL53L0X ToF Sensor starting project
2019-01-04 moved to driver module
2019-01-05 added basic driver
2019-01-05 added capacity
2019-01-11 added non-blockking UART support
2019-01-12 using LED component
2019-01-17 disabled i2c
2019-01-23 added pin muxing. Problem with clocks and LPUART
2019-01-30 updated leds
2019-02-09 added UART project
2019-02-09 added interrupt mode with ring buffer
2019-02-10 added push button support
2019-02-13 added UART ISR example
2019-03-08 fixed pin usage
2019-03-12 added VEGA RISC-V board blinky project
    [rv32m1_ri5cy.cfg]
2019-03-16 working FreeRTOS Blinky with VEGA RISC-V board
2019-03-31 updated McuLib and added LED with GPIO driver
2019-04-21 symetric push button handling and enabled SystemView
2019-04-21 implemented sensor task and handling
2019-05-08 added software timer
2019-05-24 making SHT31 driver common
2019-05-24 extended Shell, added UART GUI
2019-05-25 added UART gateway configuration and UART UI
2019-05-25 extended gateway functionality, added navigation switch forwarding
2019-05-27 added temperature and humidity logging
2019-05-27 enabled interrupts for buttons
2019-05-29 updated buttons
2019-05-30 added dedicated button and debounce with interrupt support
2019-05-31 updated UART handling
2019-06-02 added Raspberry Pi enclosure
    [RaspyJoystick.stl]
2019-06-02 added i2c wrapper
2019-06-08 adding I2C driver support
2019-06-09 working I2C driver, but had to add a delay for the FXOS
2019-06-12 added Hw I2C and USB stack
2019-06-24 added black magic debug probe scripts
2019-06-29 added datasheets and spi
2019-06-29 adding SPI
2019-06-29 added SPI commands
2019-06-30 updated SPI communication
2019-07-04 working GUI, adding I2C (not functional yet)
2019-07-04 added SW I2C
2019-07-05 added part support, extended drivers
2019-07-07 added template for motor driver
2019-07-07 first driver pin
2019-07-07 adding stepper driver
2019-07-07 working stepper motor
2019-07-09 added Blinky (with ADC demo)
2019-07-09 added shell for stepper
2019-07-10 using timer for stepper
2019-07-20 added V5 board
2019-07-20 fixed display power-up issue
    [platform.c]
2019-07-20 adding support for V4 board version
2019-07-20 working USB CDC in combination with UART
2019-07-21 fixed shutdown pin handling (was input)
    [IncludeMcuLibConfig.h]
2019-07-21 shutdown for Rev5 of the board
2019-07-21 implemented power-on for V5
2019-07-21 pin already initialied with the McuLib
2019-07-21 added GUI for power-on
2019-07-23 added camera example, debug does not work yet
    [board.c]
2019-07-23 updated to correct CPU (was 1064 instead of 1052)
    [board.c]
2019-07-23 adding support for sharing SPI bus, needed for SPI touch controller
2019-07-24 touch SPI basically working
2019-07-24 working resistive touch with manual calibration values
2019-07-24 added touch calibration
2019-07-25 updated calibration, improved SPI bandwidth
2019-07-25 first working project for the Seeed Studio Arch Mix board
2019-07-27 updated device
2019-07-30 initial stepper clock project
2019-07-31 implemented shell and UART
2019-07-31 added stepper code
2019-07-31 various updates and merged shell for uart
2019-08-01 fixed de-init
2019-08-02 adding I2C
2019-08-03 working EEPROM and external I2C
2019-08-08 adding stepper functionality (work in progress)
2019-08-09 extended stepper features
2019-08-10 extended stepper handling
2019-08-11 making RTT and stepper condidtional
2019-08-11 implemented inverted motors
2019-08-11 added 3D models
    [28BYJ-48_Model.stl, Bearing_Model.stl, InnerShaft.stl, LPC845-Enclosure.stl, MotorGear6Teeth.stl, MotorGear7Teeth.stl, MotorGear8Teeth.stl, OuterShaft.stl]
2019-08-12 for power-up, need to communicate on the bus.
2019-08-20 updated BOM and drawings
    [RTCHolder.stl, StepperClock BOM.xlsx]
2019-08-20 added hall sensors for magnets
2019-08-21 added hall sensor handling
    [InnerShaft.stl, OuterShaft.stl]
2019-08-23 updated 3D models
    [BottomGearCounter.stl, LPC845-Enclosure.stl, Model_28BYJ-48.stl, Model_Bearing.stl, Model_ULN2003_Driver.stl, MotorGear6Teeth.stl, MotorGear7Teeth.stl, MotorGear8Teeth.stl]
2019-08-23 impelemted finding zero popsition with hall sensors
2019-08-25 updated 3D files
    [InnerShaft.stl, OuterShaft.stl, Spacer.stl, StepperClock BOM.xlsx, hands.stl]
2019-09-05 handling the no-LCD case
2019-09-07 updated X12 driver
2019-10-02 updated projects
    [StepperClock BOM.xlsx]
2019-10-25 re-enabled capacitive touch display
2019-10-26 working with capacitive touch
2019-10-26 updated pins to support all boards
2019-10-27 added KiCAD library files
    [FT2232_ESP32_Debug.kicad_pcb, FT2232_ESP32_Debug.sch]
2019-10-27 updated schematic
    [FT2232_ESP32_Debug.sch]
2019-10-27 finished V0.1 for production
    [FT2232_ESP32_Debug.kicad_pcb, FT2232_ESP32_Debug.sch]
2019-11-04 updated footprints
2019-11-09 published project
    [FT2232_ESP32_Debug.sch]
2019-11-11 added Phoenix contact connectors
2019-11-23 added solder pads
2019-11-24 added worldclock project
    [BOMStepperClock.csv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]
2019-11-24 added schematic
    [BOMWorldClock.csv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]
2019-11-24 added lasercutter and 3D printer files
    [Hands.stl]
2019-11-24 moved through hole for motor
2019-12-13 updated stepper clock
2019-12-29 updated with V1.0 files
    [BoardHolder.stl, Hands.stl]
2020-01-05 separated files for V0.1 and V1.0 version
    [BOM_WorldClock_V0.1.csv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]
2020-01-07 added file for manufacturing
    [BOM_PCBWay.xlsx]
2020-01-14 support for I2C on PTE0 and PTE1
2020-01-15 ability to use different I2C unit
2020-01-15 set board version
2020-02-02 changed LED position
2020-02-03 updated footprint
2020-02-12 added support for V6 board and test code for new boards
2020-02-15 doubled the number of LEDs
2020-02-24 added simple low power example
2020-02-26 switched back to maximum speed
2020-02-27 updated with I2C lib
2020-03-01 adding virtual stepper (work in progress)
2020-03-04 working flash programming (need to switch to RUN mode)
2020-03-08 `vallen` is verified to be less than `len`, therefore, it can never be the case that `vallen >= len + sizeof(rhostname)`.
    This PR fixes the check so the `rhostname` array does not overflow.
    Reported-by: Github Security Lab <securitylab@github.com>
2020-03-10 new footprints for library
2020-03-16 added LED transition
2020-03-17 updated LED handling
2020-03-17 fixed motor index
2020-03-17 abstraction of board added
2020-03-18 migrating clock handling from stepper to matrix
2020-03-18 more on LED ring and matrix integration
2020-03-19 merging from LED project
2020-03-19 refactoring hall sensor handling
2020-03-20 working with 5 boards
2020-04-05 updated world clock, merged with LED ring project
2020-04-14 added FreeRTOS project for TWR-K70 board
2020-04-18 updated led ring handling
2020-05-16 new footprints and symbols
2020-05-18 enabled pull-ups for UART
2020-05-18 added FatFS SPI files
2020-05-18 working FatFS with SPI
2020-05-20 implemented SPI gear shifting
2020-05-20 switching back to newlib, removed printf
2020-05-29 added latest revision
    [BOM_PCBWay.xlsx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]
2020-06-07 extended KiCad lib
2020-06-07 changed UART
2020-06-07 added automatic mount
2020-06-13 implemented direct task notification for mount and unmount
2020-06-18 added I2C support (PTB0 and PTB1) with external RTC.
2020-06-19 adding UART0 (to be tested)
2020-06-21 updates for UART0 (disabled for now)
2020-08-05 added 3D files
    [AluRodConnector.stl, AluRodEnclosureCover.stl, AluRodEndPiece.stl, CameraDome.stl, CameraFrontEnclosure.stl, Raendelschrauben.stl, USB-Hub-Enclosure.stl, clip.stl]
2020-08-05 completed button/LED handling
2020-10-15 fixed naming (Win, Linux)
    [platform.c]
2020-10-18 added CAD files, contributed by Gerhard Székely
    [Mobile Teacher Multitool - V3 - MDF 4mm .dxf, Mobile Teacher Multitool - V3 - MDF 6mm .dxf, Mobile Teacher Tool 3D Print Parts.stp]
2020-10-18 moved files
    [AluRodConnector.stl, AluRodEnclosureCover.stl, AluRodEndPiece.stl, CameraDome.stl, CameraFrontEnclosure.stl, EnclosureStand.stl, Mobile Teacher Multitool - V3 - MDF 4mm .dxf, Mobile Teacher Multitool - V3 - MDF 6mm .dxf]
2020-10-27 added V1.3 of tinyK22 board
    [Quote-TinyK22_BOM.xlsx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]
2020-11-15 added ThreadX example project
2020-11-18 added ThreadX Library
2020-11-21 ThreadX cleanup for TraceX
2020-11-28 using a default buffer name for trace
2020-11-29 added MCU-Link Enclosure files
    [McuLink.stl]
2020-11-30 added cover plate
    [McuLinkCover.stl]
2021-03-11 updated low power example
2021-03-11 more low power support added
2021-03-11 switched to PEE mode
2021-04-06 extended low power application
2021-04-28 added LEDs driver
2021-04-28 added button support
2021-04-30 added wake-up button
2021-04-30 implemented pull resistor settings
2021-05-04 tests for lower power
2021-05-04 low power tests
2021-05-05 implemented blinky with correct LEDs assigned
    [platform.c, platform.h]
2021-05-05 added Shell UART
2021-05-12 added SPI Muxing
2021-05-12 SPI working (more or less)
2021-05-13 improved card pin support
2021-05-19 tried to use SWO (does not work)
    [platform.h]
2021-05-19 added basic I2C
2021-05-21 solved cycle counter problem
    [IncludeMcuLibConfig.h, platform.h]
2021-05-23 fixed ProblemMatcher to work correctly with C/C++ and gcc
    [main.c]
2021-06-07 added STM32 F303K8 project
2021-06-07 added GPIO and LED support
2021-06-07 support for STM32 GPIO
2021-07-07 added SPI mode
2021-07-27 enabled magnet sensor
2021-07-27 added motors
2021-07-31 improved motor handling with multiple motors
2021-07-31 support for variable number of magnet sensor
2021-08-01 working 4-motor configuration
2021-08-01 switched to full step mode
2021-10-01 updated pin usage description
2021-10-03 added tinyK22 blue LED support
2021-10-12 using new probe
2021-10-14 adopting number of LEDs
2021-10-15 added extra led, extended realtime synchronization for Raspberry Pi 4, using SDK timeout counter
2021-10-22 removed ADC muxing
2021-11-03 added files for NXP MCU-Link Pro enclosure
    [NXP_Logo.dxf]
2021-12-23 test run with accelerometer
2022-01-19 added message in case device is not supported yet
2022-01-24 added all SDK drivers
2022-01-25 added support for Kinetis KE device
2022-01-25 using different default for KE pin name
2022-03-09 enabled I2C
2022-03-10 working bit-banging I2C
2022-03-10 updated OLED with I2C support
2022-03-15 working HW I2C with OLED
2022-03-15 I2C updates, not verified yet
2022-03-15 cleanup and some refactoring of I2C support
2022-03-16 Moved I2C library to McuLib
2022-03-22 added the driver for the RFM96boards with the SX1276 chip on it - join works - periodic uplink messages aren't sent --> have to check the interrupts of the DIO pins
2022-03-31 - added RTC, SSD1306, W25Q Driver to prohect - W25Q status works, LittleFS still in implementation
2022-04-01 W25Q bugfix of rx and tx buffer (buffsize +4)
    [main.c, platform.c, shell.c]
2022-04-05 - added littlFS support to W25Q Flash - format, mount, ls works - benchmark throws errors
    [platform.h, shell.c]
2022-04-06 -bug fix on W25Q driver reagding earase befor write
    [IncludeMcuLibConfig.h]
2022-04-07 fixed configuration for McuTimeDate getter
    [IncludeMcuLibConfig.h]
2022-04-07 initial SPI driver
2022-04-11 basic project working, able to access device and get ID
2022-04-15 working low level driver
2022-04-15 started timer by default
2022-04-21 updated I2C to work on FC1 for LPC55S69
2022-04-22 added SHT sensor
2022-04-22 added common SPI handling to library
2022-05-11 auto-mount littleFS
2022-05-11 refactored thread safe support, improved directory listing, added abiltiy to add data to files
2022-05-16 fixed HAT v7 support (no blue LED)
    [IncludeMcuLibConfig.h]
2022-05-19 merged with low power app
2022-05-21 dealing with interrupts and logs
2022-05-24 various updates and fixes
    [platform.h]
2022-05-24 added second uart with baudrate 9600 for LPC55S16 Shield from Corsin Obrist
2022-05-24 RFM96 is working now --> DIO interrupt have to be doublecheckt!!
2022-05-28 updated low power applications
2022-05-28 fixed low power timer code
2022-05-28 ARM files were missing?
2022-05-28 muxing for LPC55S16 UART is now done in McuShellUART
2022-05-28 cleanup, UART pin muxing now done in the driver
2022-05-28 UART pin muxing now done in McuLib
2022-05-28 fixed launch config: thread awareness was not enabled.
2022-05-28 project was using outdated SDK drivers, updated to latest SDK
2022-05-28 implemented UART in muxing for tinyK22
2022-05-29 implemented Kinetis Low Power Timer
2022-05-29 UART muxing done in McuLib
2022-05-29 updated SDK and using McuLib UART muxing
2022-05-30 dealing with different board configs
2022-05-31 added ESP32 UART Muxing
2022-05-31 merged McuLib with new UART functionality
2022-06-01 updates with Adafruit capacitve LCD
2022-06-01 added support for restricted duty cycle: wake-up timer is used for this
2022-06-01 guard devices
2022-06-01 fix for using the RFM module
    [board.c]
2022-06-01 turning on I2C, needed for external RTC
2022-06-01 writing device in status
2022-08-11 added Pico Library and migrated to V6
2022-08-18 updates for Pico
2022-08-19 updated 3D models for KiCAD
2022-08-29 fixed pin naming
2022-09-16 switched J-Link
2022-09-27 output messages to UART too (was RTT only)
2022-10-04 fixed case sensitive file name
2022-10-04 always initialize UART handel
2022-10-05 only question device ID if board has jumpers
2022-10-05 switched back to EMEA
2022-10-05 changed debug probe
2022-10-06 updated footprints and symbols.
2022-10-13 fixed warnings in case no FreeRTOS is used
2022-10-16 streamlining de-init function name
2022-10-19 improved footprints
2022-10-21 fixed device naming
2022-10-22 CS pin toggling is done with McuGPIO
2022-10-24 added board related comments
2022-11-01 ESP32 FreeRTOS uses different API
2022-11-01 another update for ESP32 FreeRTOS.
2022-11-11 cleanup of footprint
2022-12-04 SPI support for RP2040
2022-12-04 added LittleFS to RP2040 (Raspberry Pi Pico)
2022-12-13 step file for push button
2023-01-01 added charging state machine
2023-01-02 dynamically changing charger states
2023-01-03 optimized charging stages
2023-01-09 merged and improved button handling for GUI
2023-01-11 ability to change I2C port and pins
2023-01-11 updated footrpints and symbols for KiCAD 6
2023-01-11 added power module
2023-01-11 updated pins for new board
2023-01-12 working MQTT client with Pico W
2023-01-12 added upcoming PCB
2023-01-12 opened up interface to store values from PowerWall
2023-01-12 using NVMC values, fixed site power handling
2023-01-16 switched to newlib
2023-01-26 switched to linked McuLib
2023-01-29 guarding more of the I2C implementation if things are disabled
2023-02-03 more test cases, had to revert back to older J-Link software
    [main.c]
2023-02-04 changed probe configuration
2023-02-04 guarding I2C library
2023-02-06 enclosure starting point
2023-02-06 frst version of enclosure
2023-02-07 addd stick
    [Joystick.stl]
2023-02-07 doing lasercutting instead
    [Joystick.stl]
2023-02-07 refined enclosure
2023-02-07 changed probe
2023-02-08 added test case
2023-02-08 merged with pico house project
2023-02-28 added NXP RTC PCF85063A driver
2023-02-28 added timeout for I2C with RP2040
2023-03-18 running server (sensor)
2023-03-23 new KiCAD files
2023-03-25 new board support
2023-03-26 working single channel DMA
2023-03-28 printing size information at the end
2023-03-28 switched debug probe
2023-03-28 using pico-w without WiFi
2023-03-28 implemented DMA for both 8x and 1x lane
2023-03-28 switched back to the 4 LED configuration
2023-03-28 initial LED Cube project
2023-04-01 updated LED handling to full cube
2023-04-02 added WS2812B/SK6812 KiCAD project with Pico RP2040
    [PicoWS2812-B_Cu.gbr, PicoWS2812-B_Mask.gbr, PicoWS2812-B_Silkscreen.gbr, PicoWS2812-Edge_Cuts.gbr, PicoWS2812-F_Cu.gbr, PicoWS2812-F_Mask.gbr, PicoWS2812-F_Silkscreen.gbr, PicoWS2812-NPTH.drl]
2023-04-02 added link to KiCAD project
2023-04-03 added picoLink files
    [BOM PicoLink.xlsx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]
2023-04-04 added footprint cache file
2023-04-04 enlarged opening for USB cable
2023-04-06 added open points
    [PicoLink.kicad_pcb, PicoLink.kicad_sch]
2023-04-06 changed linkserver probe
2023-04-08 added and updated BOM
    [BOM PicoLink.xlsx, BOM.xlsx, PicoLink.kicad_sch]
2023-04-10 updated open points
    [PicoLink.kicad_sch]
2023-04-11 added laser-cut files
2023-04-14 updated debug probe settings
2023-04-14 switched to ninja
2023-04-14 disabled reset device
2023-04-17 updated for KiCAD 7
    [PicoLink.kicad_sch]
2023-04-18 new footprint
2023-04-19 finalized for first production files
    [PicoLink.kicad_sch]
2023-04-26 added enclosure
2023-05-21 added assembly only project
2023-05-21 added assembly code
2023-05-28 updated LinkServer probe
2023-05-31 updated probe
2023-06-02 added LInkServer device description for KL25Z
2023-06-05 added new footprint
2023-06-12 fix warning in case retargeting is not enabled for SWO
2023-06-20 fixed a few warnings
    [platform.c]
2023-06-25 more tweaks to shell status und GUI
2023-06-29 upated charger implementation
2023-07-02 added footprint for on-board mounting
2023-07-03 ESP32 footprint added
2023-07-03 added site base power value
2023-07-04 shared McuLib for Pico projects
2023-07-06 first ESP32 PCB for ADIS
2023-07-10 updates for ESP32
2023-07-10 pulled up nav switches
2023-07-13 improved ESP32 symbol
2023-07-14 merged with current ESP32 lib
2023-07-14 fixed ESP32 driver
2023-07-16 updated power settings for ESP32
2023-07-16 working SPI and nRF24L01+ for ESP32
2023-07-18 more nRF24 updates for ESP32
2023-07-20 working uart
2023-07-30 changed flash driver
2023-07-31 fixed float (timestamp) reading and calculation.
    [main.c]
2023-08-07 added base plate
    [basePlate.stl]
2023-08-07 needed include if pico-w
2023-08-08 updated display driver
2023-08-11 added new ST7735 display driver
2023-08-11 updated enclosure
    [spacer.stl]
2023-08-23 added LED blinking with FreeRTOS
2023-10-24 more cleanup, enabled printf() semihosting
2023-11-15 changed default charging mode
2023-11-21 configurable period for the charging station
2023-11-21 added coverage test to check assembly code
2023-11-21 increased site base power usage
2023-11-24 added RTT and UART for log output
2023-11-30 to lower case file name
2023-11-30 moved to 16x16 cube, using other Pico-W hardare (pin 21)
2023-12-12 added unity test framework
2023-12-29 improved charging
2024-01-06 added UART
2024-01-06 added UART0 for K64F
2024-01-07 added I2C
2024-03-07 added more spacer
    [spacer_more.stl]
2024-03-23 updated KiCad models and library
2024-04-06 enabled watchdog timer
2024-04-12 footprint changed for 6/6 mil
2024-04-17 merged fix for STM32
2024-04-23 added new footprint for TDK VLCF024
2024-05-16 new board with 16 LEDs, updated LED animation
2024-05-21 added LPC804 low power example
2024-05-31 added setting for LED
2024-06-13 updated footprints for 0.22mm gap between pads for black soldermask
2024-06-26 less power for ESA demo
2024-06-30 added hardware part
    [PicoCard-B_Cu.gbr, PicoCard-B_Mask.gbr, PicoCard-B_Silkscreen.gbr, PicoCard-Edge_Cuts.gbr, PicoCard-F_Cu.gbr, PicoCard-F_Mask.gbr, PicoCard-F_Silkscreen.gbr, PicoCard-NPTH.drl]
2024-06-30 added 3D printing files
2024-07-01 updated RTC driver
2024-07-03 improved RTC driver
2024-07-24 GPIO and LED support for MCX (N947)
2024-08-26 merged with PEx driver
2024-08-27 switching back ot anonymous union
2024-09-30 updated probe firmware
2024-10-03 updated SDK and probe settings
2024-10-04 added board and LED support
2024-10-04 working CDC on device side
2024-10-04 working host mode HID with device CDC
2024-10-23 working with standard pico board and USB host breakout
2024-10-24 added footprint
2024-11-12 updated launch settings for new McuLink probe
2024-11-24 udpated debug probe
2024-12-14 merged project with sensor project, VS Code only
2025-01-22 extended implementation with RNet, RTC and LEDs
2025-01-31 added sensor code
2025-03-19 disabled normal LED support
2025-05-16 added test code for UART2
2025-05-16 muxing extra GPIO pin
2025-06-18 added setting for SonarQube
2025-08-28 added LED blinky
2025-10-13 updated SDK and changed debug probe
2025-10-15 updated new debug probe settings
2025-10-28 updated symbols for KiCad 9.0
2025-10-28 added project using different external power/voltage/current measurement ICs
2025-11-20 adding new driver for GPé8403
2025-11-20 integrated DAC module driver
2025-11-26 working I2C communication
2025-11-27 added more functionality, but reading always 0x1111 back from device
2025-12-04 extended sensors, work in progress
2025-12-08 improved DAC handling, prepared for multiple devices
2025-12-08 added support for 2 DAC devices
2025-12-08 configured device pins
2025-12-08 configured SPI
2025-12-08 extended driver
2025-12-11 moved power measurement project from internal repo
    [MCP3561_SCAN_ModeSamplerate_Calculator.xlsx]
2025-12-25 added design files
    [MCU-Link-RuggedBox.fcstd, MCU-Link-RuggedBox.stl, MCU-Link-RuggedLatch.stl, MCU-Link-RuggedLid.stl, MCU-Link-RuggedPlate.stl, MCU-Link-RuggedStackingInsert.stl, MCU-Link_Bottom.stl, MCU-Link_Top.stl]
2025-12-31 improved name plate
    [MCU-Link-RuggedBox.fcstd]
2025-12-31 better fit for more recent PCBs
2025-12-31 updated STL files
    [MCU-Link-RuggedPlate.stl, MCU-Link_Bottom.stl, MCU-Link_Top.stl]
2026-01-20 added MCU-Link Pro rugged enclosure
    [MCU-Link-Pro-RuggedBox.fcstd, MCU-Link-Pro-RuggedBox.stl, MCU-Link-Pro-RuggedLatch.stl, MCU-Link-Pro-RuggedLid.stl, MCU-Link-Pro-RuggedNamePlate.stl, MCU-Link-Pro-RuggedStackingInsert.stl, cableInsert.stl]
2026-02-08 updated design files
    [MCU-Link-Pro-RuggedBox.fcstd, MCU-Link-Pro-RuggedLid.stl, MCU-Link-Pro-RuggedNamePlate.stl, cableInsert.stl]
2026-03-03 added rugged box project
    [MCU-Link-RuggedBox.3mf]
2026-04-23 updated KiCad symbols
2026-04-23 updated footprint with PCB drills for standoffs
2026-04-23 enabled tracealyzer
2026-05-05 trying out Tracealyzer
2026-08-14 updated charger application to latest WiFi and McuLib implementation
